alphaonex86/FPGA-CPU/timeline.jpg

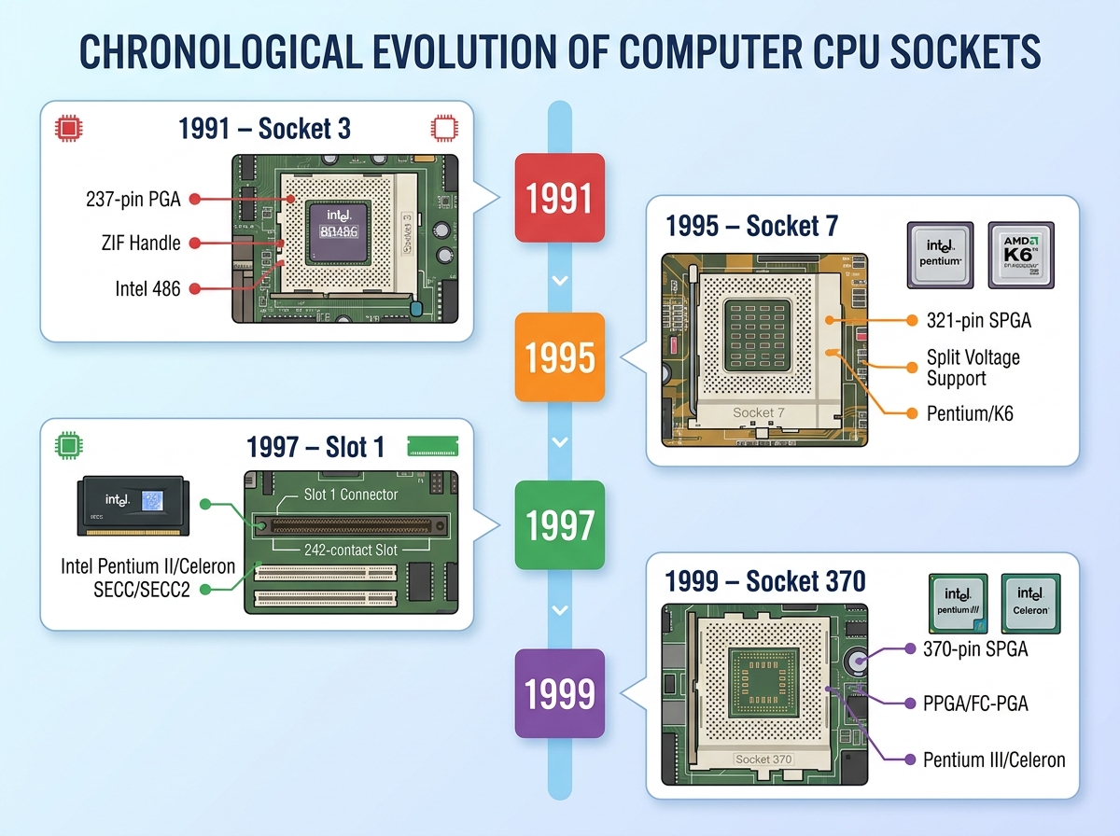
timeline.jpg
