alphaonex86/FPGA-CPU/sockets/socket370/board/board_photo.jpg

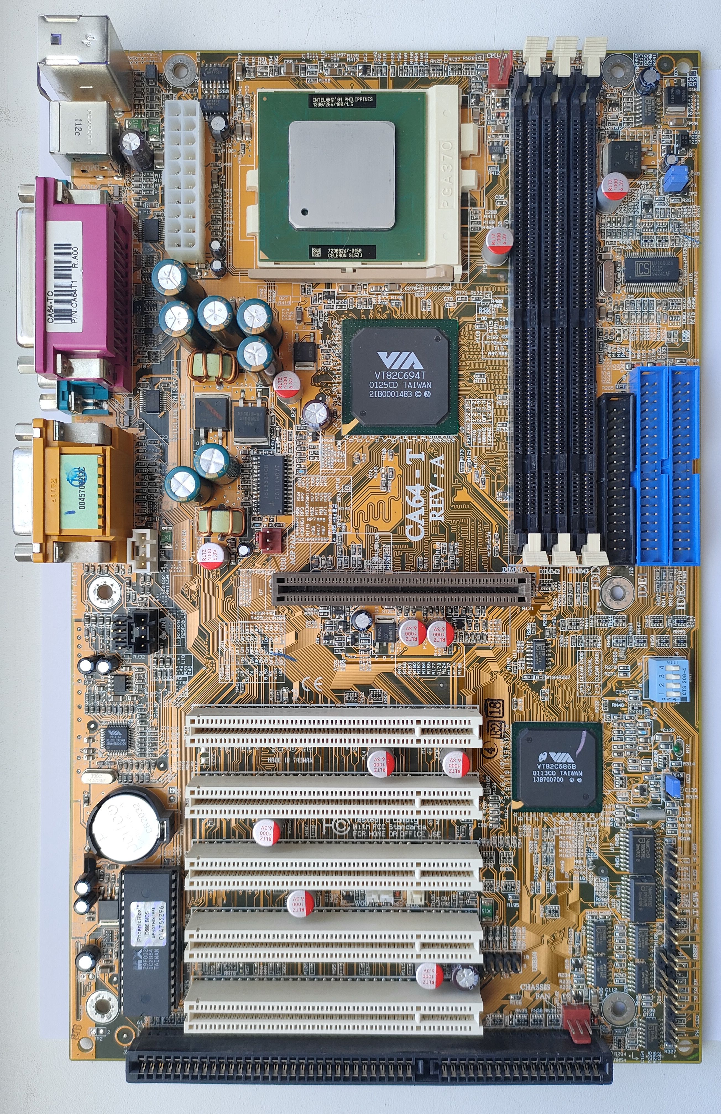
sockets/socket370/board/board_photo.jpg
