alphaonex86/FPGA-CPU/plan/cpu_core.md

# CPU core: base project evaluation (2026-10-31)

Idea (operator, 2026-10-31): do not write an x86 core from scratch; take an
open RISC-V core as the back end and make x86 (and RISC-V) "just a front
end" that cracks opcodes into the back end's micro-ops.

Requirements it must meet (`AGENTS.md`): >= 2 instructions per cycle,
i686 + x87 + MMX + SSE + SSE2, extensible to x86-64 then x86-64-v2, L2
>= 128 KB, per-socket bus behaviour, vendor-neutral RTL (ASIC option),
many configurations from one tree, fits Cyclone V E A9 (301k LE) (the
Ti180 is out: Efinix prohibited, `plan/interposers.md` D10) (`FPGAlist/README.md`).

## Candidates

All figures are the projects' own claims, not measured here.

| core | ISA / width | execution | perf claim | FPGA size claim | HDL, licence | fit |
|---|---|---|---|---|---|---|
| VexiiRiscv | RV32/64 IMAFDCSUB, MMU Sv32/Sv39 | in-order, single or dual issue (asymmetric lanes), BTB/GShare/RAS | 5.24 CoreMark/MHz, 2.50 DMIPS/MHz [vexii] | none published | SpinalHDL (Scala) -> Verilog, MIT [vexii] | best base, see below |
| NaxRiscv | RV32/64 IMAFDCSU, MMU | out-of-order, register renaming, e.g. 2 decode / 3 EU / 2 retire | 2.93 DMIPS/MHz, 5.02 CoreMark/MHz @ 155 MHz | 13.3 kLUT, Artix-7 -3 [nax] | SpinalHDL; licence not stated on the page | OoO upgrade path, same author and framework |
| SoomRV | RV32IMAC | 4-wide OoO | 5.42 CoreMark/MHz [soom] | none published | SystemVerilog, MIT | no RV64 datapath: blocks x86-64 |
| biRISC-V | RV32IM | in-order dual issue | 4.1 CoreMark/MHz, 1.9 DMIPS/MHz [biri] | "fits Artix-7, > 50 MHz" | Verilog | no FPU, no 64-bit: too small |
| ao486 | x86 486SX (no x87) | scalar, microcoded | Win95/Linux boot; fmax 39 MHz on Cyclone IV [ao486] | CPU 36,517 LE, SoC 91,256 LE (EP4CE115, `FPGAlist/README.md`) | Verilog | reference model for x86 semantics, not a base for 2 IPC |
| z386 | 80386 | rebuilt around Intel's recovered microcode | ~ao486 class [z386] | - | SystemVerilog | uses Intel's microcode: unusable for an ASIC / redistributed design |
| z486 (z386 successor, 2026-08) | 80486 + x87 (experimental, "sufficient to run DOS Quake"); no MMX/SSE | scalar pipelined: D1/D2 decode, hardwired common instructions, microsequencer for complex ones | Dhrystone CPI 2.8 -> 2.0 (IPC 0.36 -> 0.5); "roughly 486DX2-66-class"; Doom timedemo 29.1 FPS vs 21.0 ao486; 85 MHz on MiSTer [z486] | 16,329 ALMs, 21,906 with x87 (DE10-Nano Cyclone V) [z486] | SystemVerilog, Apache-2.0, except the "recovered microcode image" [z486 LICENSE-SCOPE.md] | best x86 reference; same microcode problem as z386 |
| BOOM, CVA6, XiangShan | RV64 | OoO / in-order | - | ASIC-oriented, no FPGA area claim found | Chisel / SV | too large or unmeasured for these parts |

Sources: [vexii] https://github.com/SpinalHDL/VexiiRiscv and
https://spinalhdl.github.io/VexiiRiscv-RTD/ ; [nax]
https://github.com/SpinalHDL/NaxRiscv ; [soom]
https://github.com/git-mathis/SoomRV ; [biri]
https://github.com/ultraembedded/biriscv ; [ao486]
https://github.com/alfikpl/ao486 , https://opencores.org/project/ao486 ;
[z486] https://github.com/nand2mario/z486 , https://github.com/nand2mario/z486_MiSTer
(read 2026-11-01) ;
[z386] https://linuxiac.com/open-source-z386-brings-intel-80386-microcode-back-to-life/ ,
https://misterfpga.org/viewtopic.php?p=107765 .
No published design does hardware x86 -> RISC-V micro-op cracking; the
nearest is an FPGA binary-translation research poster (HABITAT, St Andrews,
SICSA 2026), which is software-assisted translation, not a decoder.

## z486 vs the VexiiRiscv back end (operator question, 2026-11-01)

Other cores looked at and dropped: S80186 (80186, GPL-3.0, ~1,800 ALMs,
60 MHz on Cyclone V: 16-bit only) [https://github.com/jamieiles/80x86];
a 2-way out-of-order x86 soft processor at ~200 MHz (Stanford EE380 talk,
2019) [https://web.stanford.edu/class/ee380/Abstracts/190605-slides.pdf],
no public RTL found.

| | z486 | VexiiRiscv + own x86 front end (C1-C3) |
|---|---|---|
| runs x86 today | yes: DOS, Doom, Quake; real/protected mode, paging, segments | no: front end, flags, segments, x86 MMU, x87, system all to write |
| measured here, default recipe | 17,955 ALMs, 50.17 MHz; with x87 24,051 ALMs, 49.89 MHz | rv64imac dual: 12,932 ALMs, 60.7 MHz |
| measured here, perf recipe | 18,548 ALMs, 51.06 MHz | rv64imac dual: 14,976 ALMs, 61.19 MHz |
| work per second (fmax x IPC, perf) | 51 x 0.5 = ~26 M instr/s (x86) | 61 x 1.24 = ~76 M instr/s (RISC-V; x86 lower) |
| IPC | 0.5 (Dhrystone CPI 2.0) | 1.24 RISC-V; x86 IPC unknown until the cracker exists |
| >= 2 instructions/cycle | no: scalar, needs a U/V-pipe redesign of an x86-native pipeline | dual issue already there |
| x86-64 / SSE2 | none; 32-bit datapath | 64-bit datapath; SIMD lane still to add |
| licence / ASIC | RTL Apache-2.0 covers only *.sv/*.svh/*.py/*.md, so `ucode.hex` and the .hex/.mif decode ROMs are not covered [z486 LICENSE-SCOPE.md]; even the "hardwired" common instructions are Intel microcode recipes issued from ROM port B (`hardwired_control.sv`, after US5293592): blocks an ASIC and any redistributed board | MIT, all own code |
| x87 | experimental, incomplete | to write (80-bit unit) |

Reading: z486 is far ahead on x86 semantics and could boot the Socket 3
board soonest; it falls short on the hard requirements (>= 2 IPC, SSE2,
x86-64, an ASIC-clean licence) and its microcode would have to be
rewritten anyway, including the hardwired paths. Its test sets
(test386.py, single-step real/protected-mode datasets) and its .sv as a
behaviour reference are usable in either plan.

Measured 2026-11-01 on 5CEFA9F23C8 (C8, slowest grade), core alone, ports
virtual, slow 1100 mV 85 C model; `rtl/tools/synth_z486.sh <x87> <out>
[default|perf]`, `synth_cv.sh` for Vexii, z486 at 62ae68e. The z486_MiSTer
production recipe (`rtl/tools/quartus_perf.qsf`) adds only +1-2 % fmax on
both cores. The author's 85 MHz is on the DE10-Nano's 5CSEBA6U23I7
(grade 7); on our C8 part it gives 51 MHz, the speed grade being the likely
main cause (grade 7 not compiled here).

## Recommendation: VexiiRiscv as the back end (chosen, C0)

- Its pipeline is a set of plugins (fetch, decode, lanes, LSU, MMU, FPU),
  so an x86 decoder is "one more decode plugin" feeding the same lanes; a
  RISC-V decoder can stay as a second front end for bring-up (run the
  existing RISC-V tests and Linux first, then switch the front end).
- Dual issue in-order is the Pentium P5 model (U/V pipes), the simplest
  way to the operator's >= 2 instructions per cycle. NaxRiscv, same
  framework, is the OoO step if the FSB-bound workloads need it later.
- RV64 datapath already there: x86-64 long mode later is a decoder/MMU
  change, not a datapath rewrite.
- Generates plain Verilog: vendor-neutral, same tree for Cyclone V
  and an ASIC; every option is a Scala parameter, which matches "many
  configurations from one RTL tree".
- Cost: SpinalHDL/Scala knowledge and a JVM build (sbt or mill); the
  generated Verilog is not meant to be hand-edited.

## What the RISC-V back end does NOT give (x86 work list)

The "simple front end" is the decoder only for reg-reg ALU ops. The rest
is back-end work in Vexii plugins:

1. Decoder: 1-15 byte instructions with prefixes; 2 x86 instructions per
   cycle needs a predecoded length-marked I-cache line or a uop cache.
2. EFLAGS: RISC-V has no flags. Every ALU uop must produce CF/ZF/SF/OF/
   PF/AF (a flag lane or flags renamed with the result).
3. Partial registers and sizes: AL/AH/AX/EAX writes, 8/16/32(/64)-bit
   operand and address sizes, segment base added in the AGU, limits and
   checks in protected mode, real mode, V86, A20.
4. Load-op-store instructions cracked into 2-3 uops that commit or fault
   as one x86 instruction (precise exceptions at instruction boundaries),
   REP string ops, PUSH/POP/CALL/RET with ESP updates.
5. x87: 80-bit extended precision, register stack, tag word, exceptions.
   The RISC-V D unit is 64-bit: x87 needs its own unit (or a microcoded
   extended-precision path). MMX aliases the x87 registers.
6. SSE/SSE2: 128-bit XMM registers and 8x16/4x32/2x64 SIMD + scalar
   double; Vexii has no SIMD unit: new lane.
7. MMU: x86 two-level 32-bit paging (later PAE / 4-level), TLB with x86
   permission bits, accessed/dirty updates by the walker; Sv32/Sv39 walker
   is a template only.
8. Memory model: x86 TSO vs RISC-V RVWMO; self-modifying code needs a
   coherent I-cache (snoop on stores), no fence.i.
9. System: IDT, exceptions, task gates, SMM, I/O ports, CPUID, MSRs, TSC,
   reset signature, cache-control pins; micro-code sequencer for the
   complex instructions.
10. Bus: Vexii talks AXI4/TileLink/Wishbone; each socket needs its own
    bus unit (486, P5, P6 AGTL+) behind the L2.

ao486 (Bochs-modelled) is the reference for items 3, 4, 9 and for the
test approach (lock-step against an emulator, the way Vexii already
lock-steps against Spike).

## FPGAmotherboard compatibility (operator, 2026-11-01)

The core must run on the original boards and on the FPGAmotherboard boards
(FPGA chipset, other session; its rule 9: any fast mode is negotiated, off
by default). Contract received for Socket 3 (FPGAmotherboard
socket3/docs/notes/design-decisions.md):
- the board targets the Am5x86-P75 only [am5x86 19751C]: B13 = WB/WT#,
  CLKMUL (R17) tied low; the CPUID/reset-signature profile must offer it;
- bus CLK 8-33 MHz, changed only during Stop Grant (STPCLK#) for DVFS:
  the bus PLL must relock inside Stop Grant and the core must not assume
  a fixed bus clock;
- direct LVCMOS33, VIH 2.0 V / VOH 2.4 V min;
- VCORE starts at 0 V and comes up after the interposer FPGA: the bus
  interface ignores every socket pin and keeps the CPU parked until the
  board input VCORE_OK is high, and parks again when it falls
  (plan/interposers.md FPGAmotherboard compatibility).

## Selection criterion (operator, 2026-11-01, permanent)

Maximum performance inside the selected Cyclone V E A9 (113,560 ALMs); code
volume, rewrites and licences do not count (`AGENTS.md` Rules). Decisions
taken partly on the dropped criteria, to re-check on performance alone:
- C0: z486 was rejected also for its licence; its performance gaps (scalar,
  IPC 0.5, 51 MHz on C8, 32-bit, no SSE) still stand.
- C1 amendment (hybrid uop): chosen to reuse Vexii plugins, i.e. less code.
- Vexii itself: in-order dual issue, ~60 MHz on C8 is its pipeline depth
  (step 1 sweep); a core designed for Cyclone V timing may go higher.
- C5: the DE25-Nano's Agilex 5 has 46,800 ALMs, under the A9's 113,560:
  it hosts development of what fits, the full core is sized for the A9.

## Decisions (core)

- **C7** (decided 2026-11-01 by the operator) The x86 core is written in
  SystemVerilog (Quartus Lite/Pro and Verilator read it directly, no JVM,
  ASIC-neutral; configurations as parameters / generate).
- **C8** (decided 2026-11-01 by the operator) Microarchitecture class:
  out-of-order, 2-3 uops per cycle (P6/K7 style: x86 decoders to uops,
  uop cache, renaming including EFLAGS, ROB, load/store queues). Spec in
  `plan/x86_core.md`.
- **C6** (decided 2026-11-01 by the operator, under the performance
  criterion) The x86 core is a new x86-native superscalar design built for
  Cyclone V timing (more stages, uop cache, out-of-order as the design
  decides), from scratch. VexiiRiscv stays only as the separate RISC-V core
  (C4). Supersedes for x86: C0's base, the C1 hybrid uop and the
  Vexii-specific parts of C2 (EFLAGS stays in hardware) and X1. Kept from
  X1: Unicorn lock-step (`x86_trace_check`, `x86_test.sh`, tests).
- **C0** (decided 2026-11-01 by the operator, after the measured z486
  comparison above) Base: VexiiRiscv back end + own x86 front end (C1-C3).
  z486 is used only as a behaviour reference and test source (test386,
  single-step datasets), never as RTL in the tree.
- **C1** (decided 2026-11-01 by the operator) x86 instructions crack into
  an own micro-op format, not into RISC-V instruction words: the x86 front
  end bypasses the Vexii RISC-V decoder (wide uops, 32/64-bit immediates)
  and feeds the execute lanes directly.
  **Amended 2026-11-01 by the operator (hybrid):** Vexii's execute
  plugins decode their controls by mask-matching the UOP bits
  (`ExecuteLanePlugin.scala` 267-290, `DecoderPlugin.scala` 274-278), so
  the uop keeps a 32-bit RISC-V-shaped operation key (every Vexii execute
  plugin reused unchanged; the RISC-V front end of C4 comes for free) and
  the x86 fields ride beside it through `DispatchPlugin.addDispatchCtx`:
  64-bit immediate, operand size 8/16/32/64, flag-write mask, segment.
- **C2** (decided 2026-11-01 by the operator) EFLAGS in hardware: every
  flag-setting uop writes a flags register beside its result (new execute
  plugin, bypass between the two lanes); Jcc / ADC / SETcc read it in one
  cycle.
  **Confirmed 2026-11-01 by the operator (directly, no interim x31 uop):**
  Vexii uops have one RD and the dispatcher tracks hazards only on
  RS1-3/RD, so the unit brings its own FLAGS register, forwarding from
  every in-flight stage, and a dispatcher patch so a flag consumer never
  issues in the same cycle as an older flag producer.
- **C3** (decided 2026-11-01 by the operator) Lock-step reference: Unicorn
  (QEMU CPU core as a C library, one hook per instruction), testbench only
  (GPLv2, never in the RTL).
- **C4** (decided 2026-11-01 by the operator) x86 first, but the RISC-V
  front end stays selectable at generation time (a config option, its code
  never deleted) for later experiments: e.g. RISC-V Linux with own firmware
  in the interposer (board BIOS never run; Debian riscv64 is RV64GC; device
  tree + i8259, 8250, i8042, IDE, CF8/CFC PCI drivers, x86 option ROMs via
  an emulator like U-Boot bios_emulator). Not a milestone now.

- **C5** (decided 2026-11-01 by the operator) x86 front-end development
  runs on the DE25-Nano first (Agilex 5, 163 MHz vs 61 MHz, no PCB
  needed); the RTL stays vendor-neutral so it still builds for the
  Cyclone V interposers.

## Exploration E1: x86 on a real ARM64 core, FPGA as the socket bridge (operator, 2026-11-01)

Idea (operator): a multiplexer <-> FPGA converting x86 <-> real ARM64 on a
Terasic DE25-Nano, for good x86 performance: the x86 side runs single
threaded, natively on one ARM core. Not a decision, to explore.

Board facts (Terasic / distributors): Agilex 5 SoC A5EB013BB23BE4SCS
(DE25-Nano revB `Demonstration/FPGA/Golden_top/golden_top.qsf`), 138K LE; HPS 2x Cortex-A76 + 2x Cortex-A55; 1 GB
LPDDR4 for the FPGA + 1 GB LPDDR4 for the HPS (shared with the FPGA),
128 MB SDRAM; BSP on Quartus 25.1.1 Pro; the kit includes a free Quartus
Pro licence tied to the kit [terasic.com.tw DE25-Nano page; DE25-Nano
user manual 2025-09-05, mm.digikey.com/.../P0804.pdf;
linuxgizmos.com DE25-Nano article].

Shape: the FPGA fabric is the socket bus unit (486 / P5 / P6 cycles, as in
the soft-core plan); one A76 runs the x86 machine. A hard ARM core has no
port to inject instructions, so x86 -> ARM64 has to be software dynamic
binary translation on the A76 (full system: BIOS, real/protected mode,
paging, interrupts, I/O), the FPGA at most assisting (e.g. bus cycles,
predecode). Box64 / FEX translate Linux user space only; a full-system
translator is QEMU-TCG class.

Questions before any work:
1. Toolchain rule: Agilex 5 needs Quartus Prime Pro.
   **Answered 2026-11-01:** Quartus Prime Pro 26.1.1 Build 130 installed at
   `~/altera_pro/26.1.1` (installers, Agilex 3/5/7 device .qdz, DE25-Nano
   revA/revB resource packages, user manual and SD card image in
   `/mnt/data/perso/FPGA/DE25-Nano/`). A counter on A5EB013BB23BE4SCS with
   the golden_top pins (clk BF23, LEDs) ran synthesis, fit, timing and
   assembler and wrote the .sof (without pin assignments the assembler
   skips it, Critical Warning 25196/25207). Licence: `LICENSE_FREE_MODE = on`
   (`~/.altera.quartus/quartus2.ini`); Quartus fetches a free node-locked
   licence online into `~/.altera.quartus/quartus2_lic.dat` (issued
   2026-10-31): `quartus_agilex5e` 2027.10 and `quartus_agilex3` 2027.11,
   both "permanent uncounted". The Agilex 3 feature was added during an
   A3CW135BM16AE6S test compile (2026-11-01), so the fetch works from
   Bolivia; once fetched it is permanent, the version date only caps the
   Quartus release. The kit licence is not needed. This weakens the Agilex 3
   rejection in `FPGAlist/README.md` ("licence fetched online").
2. Speed: x86 full-system DBT on one A76 (clock to check) vs the 50-60 MHz
   soft cores measured above; measure QEMU-TCG i386 on an A76 first.
3. Memory: guest RAM in the HPS LPDDR4 (fast) with the board RAM only for
   DMA-visible ranges, or all accesses over HPS -> FPGA -> socket (bridge
   latency per access); board DMA (IDE busmaster, ISA DMA) coherence.
4. Form factor and power: DE25-Nano by a cable/adapter to the socket
   (bus timing at 33-66 MHz over a cable) or the Agilex 5 chip on our own
   interposer; power vs the socket budgets in `AGENTS.md`.

Fabric speed (2026-11-01): the rv64imac_dual netlist of step 1, same
virtual-pin setup, Quartus Pro 26.1.1 on A5EB013BB23BE4SCS, 5 ns target
(`DEVICE=A5EB013BB23BE4SCS rtl/tools/synth_cv.sh <v> <out> 5.0`):
13,568 / 46,800 ALMs (29 %), 94 / 358 M20K, 8 DSP, fmax 162.87 MHz (worst
multicorner, slow fix4 0C model), vs 61 MHz / 11 % on 5CEFA9F23C8: 2.7x
the clock, but 2.6x less room for x86 + x87 + SSE + L2 (7.3 Mbit RAM: a
128 KB L2 still fits).

### E1 connection: DE25-Nano + multiplexer adapter (operator, 2026-11-01)

The DE25-Nano exposes 72 user I/O at 3.3 V on two 2x20 headers (36 + 5 V,
3.3 V, 2 GND each; 3.3 V max 1.5 A) [DE25-Nano user manual 2025-09-05
p.22 sec. 3.7.2, Tables 3-11/3-12]; the sockets need 114 (S3), 166 (S7),
167 (S370) FPGA signals (`hw/*/pins.csv`). Pin count, not speed, is the
limit, so the adapter multiplexes. Line rate = mux ratio x bus clock:

| socket | bus | wide signals per clock | ratio on ~24-40 lines | rate per line | verdict |
|---|---|---|---|---|---|
| S3 | 33 MHz | A30 + BE4 + D32 + DP4 = 70 | 3:1 | 100 MHz | feasible |
| S7 | 66 MHz | ~110 | 3:1 | 200 MHz | doubtful on 0.1" headers with 2 GND / 40 pins |
| S370 | 133 MHz | ~110 | >= 2:1 (8:1 = 1064 MHz) | >= 266 MHz | no; AGTL+ also needs GTL parts |

Shape (S3): wide outputs go through two register stages: the FPGA fills
stage 1 group by group during cycle N-1, stage 2 is clocked by the board
CLK, so outputs switch with one flop delay, inside t6 3-14 ns at 33 MHz
[intel486dx2_datasheet_1992.pdf Table 14.4.2]. Wide inputs are captured
by registers on the board CLK (meets the t22 5 ns setup / t23 3 ns hold
like the CPU does) and read out over the next cycle. Cost: inputs reach
the core one clock late, so signals that need a next-clock reaction
(AHOLD/BOFF#/HOLD float, RDY/BRDY, KEN#, EADS#) stay direct; slow ones
(straps, A20M#, FLUSH#, IGNNE#, INTR, NMI, SMI#, STPCLK#) go through the
mux. Budget: ~24 direct + 24 mux lines + ~8 group strobes + ~16 slow
control = ~72: tight, a 4:1 ratio (133 MHz) frees pins. Parts: 5 V
tolerant 74LVC 16-bit registers / buffers, no FPGA, 3.3 V from the
header; the 3.3 V output level matches the S3 interposer's (CB3T) level.

DE25-Standard (operator question, 2026-11-01; user manual 2025-10-07,
mm.digikey.com/Volume0/opasdata/d220001/medias/docus/7704/P0781.pdf):
same class FPGA (A5ED013BB32AE4SR1, 130K LE [p.7]), $586, 12 V input.
I/O: HSMC with 80 user I/O (HSMC_D[0..74], 2 x B5B_D, 3 CLKIN) at
1.8/2.5/3.3 V by jumper JP3, default 3.3 V [p.19 Table 3-5, Table 3-18],
on a connector built for high-speed signals, plus one 2x20 GPIO header,
36 I/O at 3.3 V behind two diodes + a resistor each [p.30]: 116 in all.
- S3 (114): nearly direct, no mux; DE25-Nano + mux (D11) is enough.
- S7 (166): only the 64+8 data/parity lines 2:1 on 36 HSMC lines
  (133 MHz per line, on HSMC), the rest direct or slow-muxed: plausible,
  tight; the one socket the Standard makes possible.
- S370 (167, AGTL+ 133 MHz): even 2:1 is 266 MHz per single-ended line;
  only the 17 LVDS pairs per direction could carry it, which needs a
  SERDES (an FPGA) on the adapter: no DE25 for S370, the interposer only.

## Next steps (each answers a concrete question)

1. Generate VexiiRiscv dual-issue RV64 (no FPU, then with D) and run
   Quartus Lite 25.1 (installed, `~/altera_lite/25.1std`) on 5CEFA9F23C8:
   ALMs, fmax. Does the back end leave room for x86 decode + x87 + SSE +
   L2 >= 128 KB inside 301k LE, and at what clock?
   **Done 2026-11-01** (`rtl/tools/setup.sh`, `gen_vexii.sh <config>`,
   `synth_cv.sh`; VexiiRiscv 9f70315, core alone, ports virtual, 10 ns
   target, slow 1100 mV 85 C model):

   | config | ALMs | registers | M10K | DSP | fmax |
   |---|---|---|---|---|---|
   | rv64imac_dual (S/U + MMU, max-ipc, 16 KB L1 I/D) | 12,932 (11 %) | 16,360 | 105 | 17 | 60.7 MHz |
   | rv64imafdc_dual (same + F/D) | 16,879 (15 %) | 19,848 | 115 | 17 | 52.0 MHz |

   Room: yes, ~85 % of the ALMs and > 90 % of the M10K are left; a 128 KB
   L2 is 1 Mbit of the 12.5 Mbit. Clock: 50-60 MHz as generated, already
   above every Socket 3 bus clock (<= 40 MHz) but below Socket 7/370.
   Critical paths: the max-ipc lane1 -> lane0 early-ALU bypass (rv64imac)
   and the execute -> fetch TLB write (rv64imafdc), both inside the back
   end.

   fmax vs IPC sweep (2026-11-01, `rtl/tools/vexii_configs.sh`,
   `bench_vexii.sh`: prebuilt NaxSoftware Dhrystone / CoreMark in the
   VexiiRiscv Verilator testbench, default testbench memory; both fit the
   16 KB L1, so this is core IPC, not system IPC). CoreMark = CoreMark/MHz
   x fmax:

   | config | ALMs | fmax | DMIPS/MHz | CoreMark/MHz | IPC (CoreMark) | CoreMark |
   |---|---|---|---|---|---|---|
   | rv64imac_dual (max-ipc) | 12,932 | 60.7 | 2.61 | 4.84 | 1.24 | 294 |
   | rv64imac_dual_rbra (+ relaxed branch) | 12,839 | 60.6 | 2.59 | 4.72 | 1.21 | 286 |
   | rv64imac_dual_nolate (- late ALU) | 11,249 | 59.4 | 2.35 | 4.41 | 1.13 | 262 |
   | rv64imafdc_dual (+ F/D) | 16,879 | 52.0 | 2.60 | 4.84 | 1.24 | 252 |
   | rv64imac_single (max-ipc, 1 lane) | 9,524 | 65.0 | 1.78 | 3.33 | 0.85 | 216 |
   | rv64imac_dual_nolate_bp1 (- late ALU, bypass from 1) | 11,035 | 59.1 | 1.49 | 2.81 | 0.72 | 166 |

   Answer: the full max-ipc dual-issue core is the best; the lighter
   bypass, no late ALU and the relaxed branch cost IPC and buy no fmax.
   Each removal only moves the worst path (execute branch -> fetch L1 /
   TLB RAM address, then late-ALU 64-bit bypass, register file, dispatch):
   about 60 MHz is the depth of this pipeline at 64 bits on C8, not one
   path. More clock needs more stages (decoder/dispatcher/fetch fork
   placement), a later question. The F/D unit costs 14 % clock: keep the
   FPU off the integer critical loop when x87/SSE are added.
2. ~~Same netlist in Efinity for the Ti180~~: dropped, Efinix is
   prohibited (`plan/interposers.md` D10).
3. Only then: an x86 decode plugin for the integer reg-reg / load-op
   subset, lock-stepped against an emulator, on the RISC-V back end.
   Increment X1 (superseded by C6, kept for the record; C0, C1 hybrid, C2, C3, C5): does the hybrid
   uop run x86 code on the Vexii lanes, and at what IPC? 32-bit flat
   mode only (segment bases 0, no paging, no faults), in Verilator:
   - `X86AlignerPlugin` (replaces AlignerPlugin): byte-granular length
     decode over the fetch window, 1 x86 instruction per cycle first.
   - `X86DecoderPlugin`: cracks into hybrid uops; EAX..EDI on x1..x8,
     temporaries above; side payloads X86_IMM, X86_SIZE, X86_FLAGS.
   - `X86FlagsPlugin` (C2): CF/PF/AF/ZF/SF/OF beside each ALU result,
     read by Jcc.
   - Subset: MOV (r/r, r/imm, r/[base+index*scale+disp] both ways), ADD,
     SUB, AND, OR, XOR, CMP, TEST (r/r, r/imm8/imm32), INC, DEC, LEA,
     Jcc / JMP rel8/rel32, NOP, HLT (ends the test).
   - Testbench: Unicorn 2.1.4 (`rtl/tools/setup.sh`) steps the same
     image; GPRs, EFLAGS and EIP compared at every retired x86
     instruction; first mismatch stops the run.
   Answers: correctness on the subset, IPC on a Dhrystone-like loop, and
   the ALM / fmax cost on A5EB013BB23BE4SCS vs rv64imac_dual.
