alphaonex86/FPGA-CPU/hw/socket7-cyclonev/power.md

# Socket 7 + Cyclone V E A9 (5CEBA9/5CEFA9F23C8N) interposer power (plan/interposers.md task T3)

Source per D1 (decided 2026-10-21 for socket 7, `plan/interposers.md`):
the interposer takes its power from the socket's own rails through the
Mill-Max header - VCC2 (core, 2.8 V on this board [spec p.5]) and VCC3
(I/O, 3.4 V on this board [spec p.5]). No external supply, no barrel jack.
No module RAM (D4). Page numbers are the printed pages of the cited PDFs.

Socket-side envelope ([notes] R2): VCC2 2.7/2.8/2.9 V +/-3.57 % on 25 pins,
VCC3 3.135-3.6 V on 28 pins, ICC2 max 6.5 A, ICC3 max 750 mA, active max
17.0 W [mmx p.31-32 Tables 10/12/13]. No VCC2/VCC3 sequencing: "no specific
power sequence required", both ON or both OFF within one second
recommended [mmx p.28 sec. 3.1.1.1]. Our loads are attached to rails the
board VRM raises together, so this holds by construction. All converter
outputs are strictly monotonic ramps (see Sequencing).

Sources:

| tag | file |
|---|---|
| cvds | FPGAlist/CycloneV_A9/docs/cv_51002_device_datasheet.pdf |
| cvhb | FPGAlist/CycloneV_A9/docs/cv_5v2_device_handbook_vol1.pdf |
| mmx | sockets/socket7/pentium_mmx_datasheet_243185-004.pdf |
| fmb | sockets/socket7/intel_430hx_pcsiset_design_guide_297467-002.pdf |
| spec | sockets/socket7/board/biostar_mb-8500ttd_spec.pdf |
| jumpers | sockets/socket7/board/biostar_mb-8500ttd_undocumented_jumpers.pdf |
| mmpins | sockets/parts/mill-max_catalog_metric.pdf |
| notes | hw/common/socket7_notes.md |
| tlv62585 | sockets/parts/ti_tlv62585.pdf |
| tps22918 | sockets/parts/ti_tps22918.pdf |
| tlv757p | sockets/parts/ti_tlv757p.pdf |
| plan | plan/interposers.md |
| agents | AGENTS.md |

## Rails (Cyclone V E A9, 5CEBA9/5CEFA9F23C8N)

| rail | where | required band | source |
|---|---|---|---|
| VCC | FPGA core, periphery | 1.07-1.13 V (typ 1.1 V) | cvds p.8 Table 4 |
| VCC_AUX (VCCAUX) | auxiliary supply | 2.375-2.625 V (typ 2.5 V) | cvds p.8 Table 4 |
| VCCPD | I/O pre-driver | 3.3 V: every used bank is a 3.3 V VCCIO bank ([notes] R1, no 2.5 V net on this socket) | cvds p.8 Table 4 note 4 |
| VCCIO | per bank | 3.3 V (3.135-3.465 V), all banks: host bus and straps are 3.3 V TTL [notes R1] | cvds p.8-9 Table 4 |
| VCCPGM | configuration pins | 3.3 V class | cvds p.9 Table 4 |
| VCCA_FPLL | PLL analog regulator supply | 2.375-2.625 V | cvds p.9 Table 4 |
| VCCBAT | battery back-up (volatile security key) | 1.2-3.0 V | cvds p.9 Table 4 |
| tRAMP | all supplies strictly monotonic, no plateaus | 200 us-100 ms (standard POR) | cvds p.9 Table 4 / p.69 Table 55 |

## Topology

```
VCC2 2.8 V (25 header pins) --[bulk+bulk]--> SYNC BUCK --> VCC 1.1 V
VCC3 3.4 V board (28 header pins) --+--> LOAD SWITCH (EN = core PGOOD)
                                    |      --> VCCIO33: VCCIO / VCCPD / VCCPGM
                                    +--> 2.5 V aux (VCCAUX; ferrite
                                             branch to VCCA_FPLL;
                                             VCCBAT tied here)
```

Rail plan (drawn by `hw/tools/socket7_pdn.py`, values printed and checked
there; all JLCPCB/LCSC stocked 2026-11-05):
- VCC2 -> PS1 TLV62585PDRL (C485118) core buck, 1.1 V 3 A: VIN 2.5-5.5 V
  covers the 2.70-2.90 V window [tlv62585 p.1] (a 3 V-min part such as
  the TPS62130 does not qualify); R1 82.5k / R2 100k -> 1.095 V (1.084-
  1.106 V over the FB tolerance, p.6); 1 uH XFL4020-102MEC (C5355380) +
  22 uF; the whole VCC_1V1 rail stays <= 47 uF nominal [p.10 Table 4].
  EN tied to S_VCC2.
- VCC3 -> PS2 TLV75725PDBVR (C2872563) 2.5 V aux LDO, 1 A: dropout 0.6 V
  max at 1 A [tlv757p p.6] < 3.135 - 2.5 V; EN = PG_1V1.
- VCC3 -> U3 TPS22918DBVR (C131941) load switch -> VCCIO33 (VCCIO/VCCPD/
  VCCPGM): 53 mOhm at 3.3 V, 2 A [tps22918 p.1]; the board's 3.4 V is
  inside the 3.465 V band max [cvds p.8-9 Table 4]. CT 1 nF -> rise
  1.68 ms [p.6], inside 200 us-100 ms [cvds p.9 Table 4]; QOD tied to
  VOUT (discharge when off); ON = PG_1V1.
- PG_1V1 (TLV62585 PG, open drain) pulled up to VCC_1V1, not S_VCC3: the
  board raises VCC3 before VCC2 and PG is undriven below 1.4 V VIN
  [tlv62585 p.8 Table 1]; it releases at 95 % (1.045 V) above the 1 V
  VIH of the switch ON and the LDO EN [tps22918 p.4, tlv757p p.6].
- VCCBAT: tied to the 2.5 V aux rail (1.2-3.0 V band) [cvds p.9 Table 4].

## Sequencing

- All supplies strictly monotonic 200 us-100 ms [cvds p.9 Table 4].
  Recommended order [cvhb p.10-4 Fig 10-3]: group 1 (VCC 1.1 V) to
  >= 80 % before group 2 (VCCPGM, VCCIO, VCCPD, VCCA_FPLL, VCC_AUX),
  VCCIO together with VCCPD. The core buck's PG enables the 2.5 V
  aux LDO (VCC_AUX, VCCA_FPLL) and the VCCIO33 switch together.
- The board's VCC3 rises together with VCC2 [mmx p.28], i.e. before the
  core buck fed from VCC2 is up; a direct VCCIO/VCCPD/VCCPGM feed would
  break the order and cost a VCCPD current transient up to 1000 mA, ~50 us
  typical [cvhb p.10-4/10-5 Table 10-1 note 33] on a VCC3 rated ICC3
  750 mA [mmx p.31 Table 12]. Hence the load switch (operator,
  2026-11-01): the same core PGOOD enables it and the aux LDO, so all of
  group 2 starts together; VCCIO and VCCPD share VCCIO33, so they ramp
  together [cvhb Table 10-1 note 35].
- Until the switch closes, the board drives the 3.3 V bus into unpowered
  banks (direct bus, no translators): allowed, the I/O, dedicated input
  and clock pins take signals before or during power up without damage or
  back-powering [cvhb p.10-2], at most 300 uA DC / 8 mA AC per pin
  [cvds p.17 Table 13]. CONF_DONE and nSTATUS have no hot-socket circuit
  and may drive during power up [cvhb p.10-3]: they only reach our
  pull-ups and the config header.
- POR after all supplies are valid: 100-300 ms (standard POR) before
  configuration is accepted [cvds p.69 Table 55]; nSTATUS/CONF_DONE and
  the board-reset stretch handle the handshake with CPURST ([notes] R6).

## Budget check (D1: total within the socket budget)

Numbers below are an **estimate** until the vendor power estimator runs on
real RTL (replaces this section then); this design uses no DDR PHY, no
transceivers and no HSIO/MIPI, so the class is "fabric + light I/O".

- Total interposer draw (estimate): core rail 2.5 W + I/O and aux
  2.0 W + converters at ~90 % efficiency => <= 6 W against the
  17.0 W the board VRM was built for [mmx p.32 Table 13; agents]. PASS.
- VCC2 branch (feeds only the 1.1 core buck): 1.0 A at
  2.8 V against ICC2 6.5 A [mmx p.31 Table 12]; 0.04 A average per
  VCC2 pin against the 1 A Mill-Max 550 rating [mmpins p.188-189]. PASS.
- VCC3 branch: VCCIO/VCCPD/VCCPGM through the load switch + the aux LDO:
  0.6 A estimate against ICC3 750 mA [mmx p.31 Table 12] - the
  binding limit of the three. PASS if the estimator confirms; if it comes
  back over, the VCCIO dynamic estimate must be refined per-bank before
  any rail re-planning.
- Board VCC3 sits at 3.4 V [spec p.5]: inside the 3.3 V band max 3.465 V
  of both FPGAs (cvds p.8-9 Table 4) and inside VCC3 max 3.6 V [mmx p.31
  Table 10]. PASS.
- FMB rule "HCLK begins toggling within 150 ms after VCC reaches its
  operating level" [fmb p.2-2] is about the CPU seeing the clock: the
  board clock runs from power-on independent of our rails, and our
  converters start as soon as VCC2/VCC3 come up, so the FPGA is powered
  long before the board releases CPURST; the config-vs-reset timing is
  closed in [notes] R6.
