alphaonex86/FPGA-CPU/sockets/socket7/board/cpuinfo_pentium_mmx_233.txt

p1mmx ~ # cat /proc/cpuinfo 
processor       : 0
vendor_id       : GenuineIntel
cpu family      : 5
model           : 4
model name      : Pentium MMX
stepping        : 3
cpu MHz         : 233.034
fdiv_bug        : no
f00f_bug        : yes
coma_bug        : no
fpu             : yes
fpu_exception   : yes
cpuid level     : 1
wp              : yes
flags           : fpu vme de pse tsc msr mce cx8 mmx cpuid
bugs            : f00f itlb_multihit
bogomips        : 466.06
clflush size    : 32
cache_alignment : 32
address sizes   : 32 bits physical, 32 bits virtual
power management:
