alphaonex86/FPGA-CPU/sockets/socket3/board/mb-8433uud-a_rev3.1_front.jpg

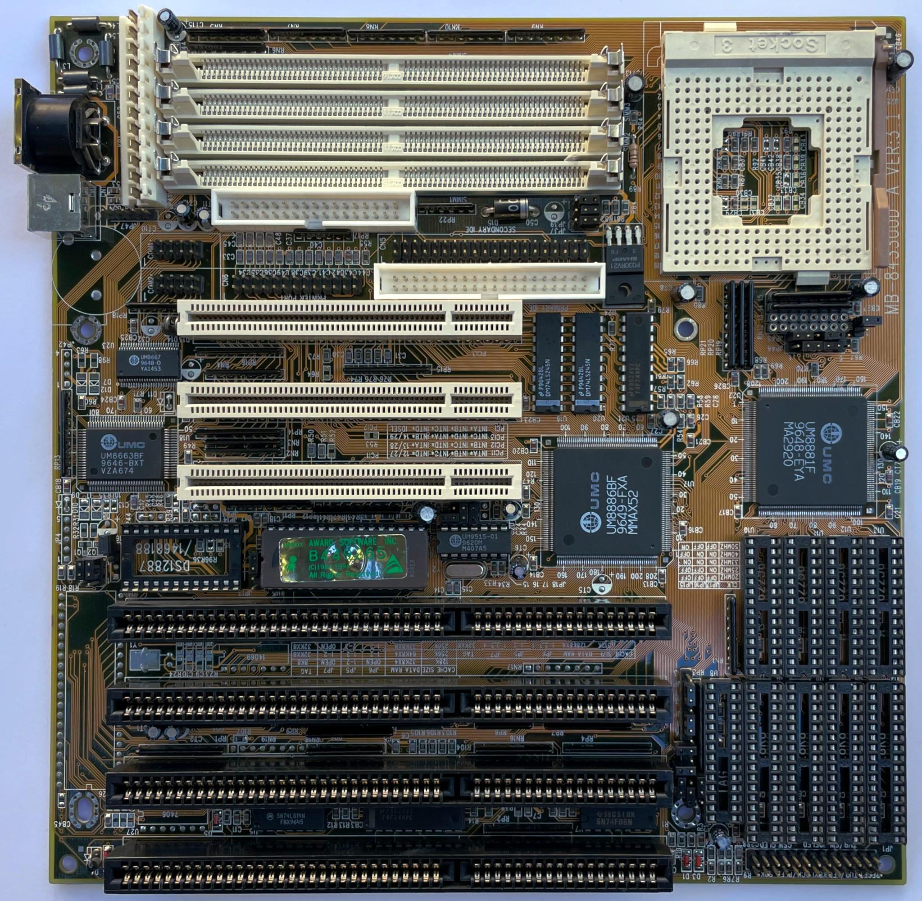
sockets/socket3/board/mb-8433uud-a_rev3.1_front.jpg
