alphaonex86/FPGA-CPU/sockets/socket3/socket3_pinout_bottom.jpg

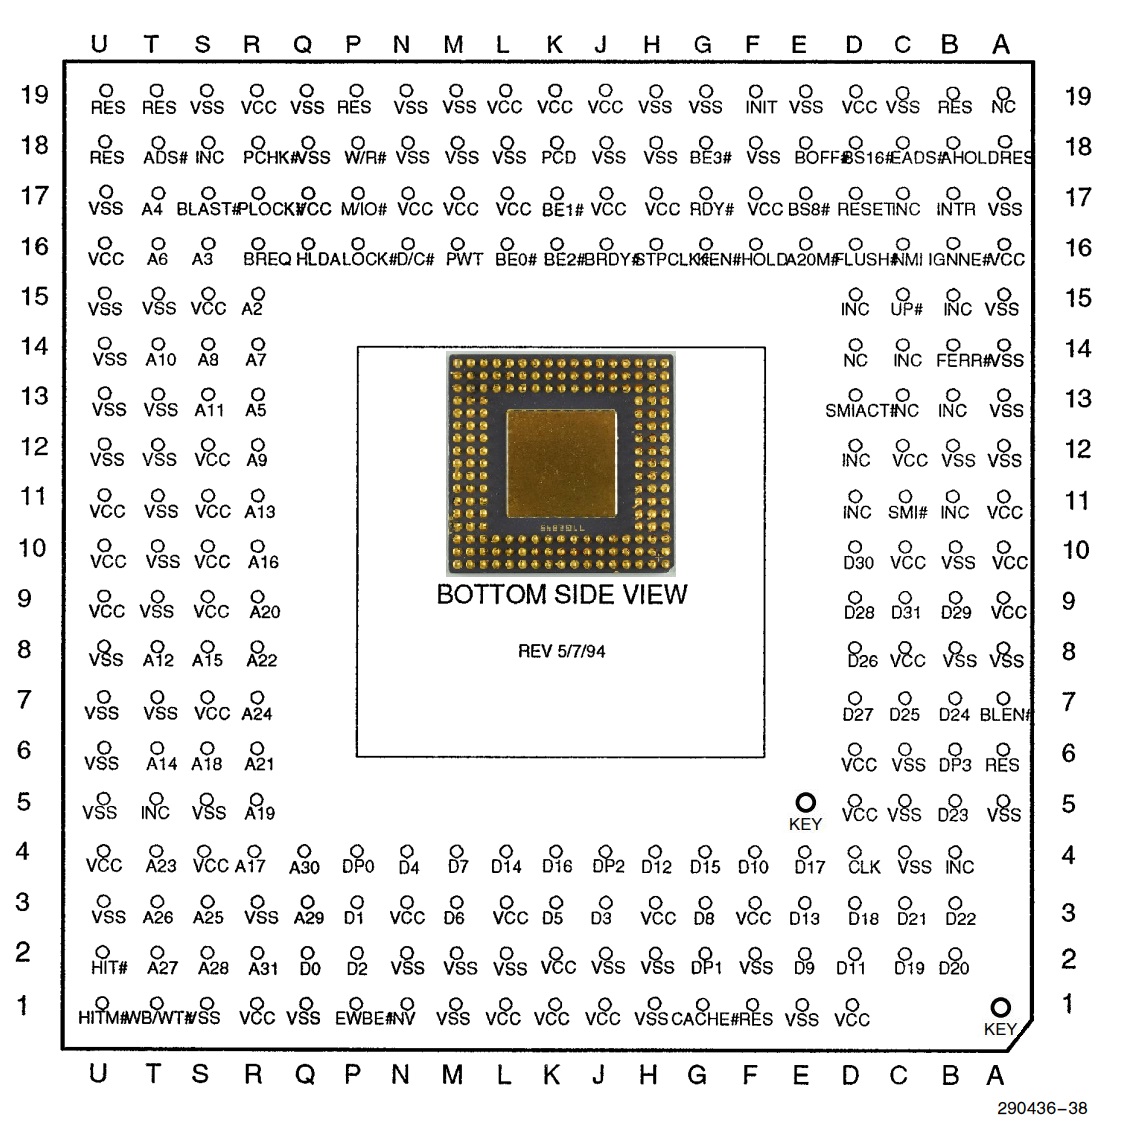
sockets/socket3/socket3_pinout_bottom.jpg
