alphaonex86/FPGA-CPU/sockets/socket7/board/mb-8500ttd_photo.jpg

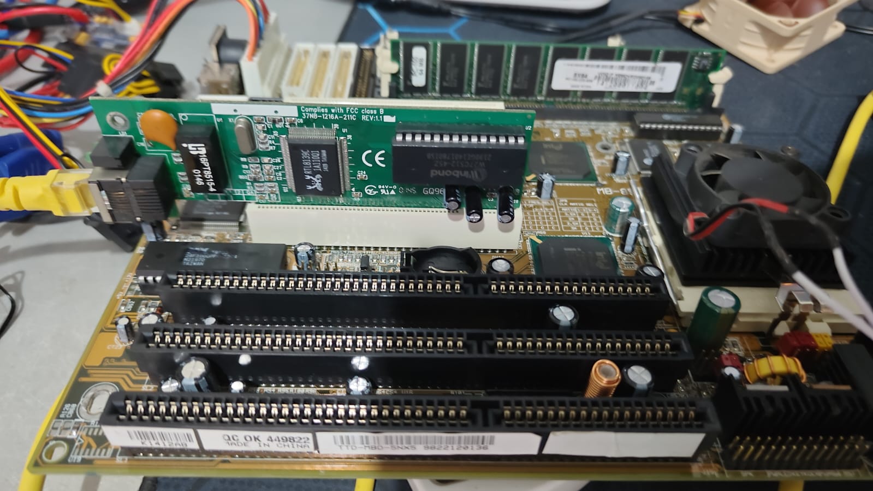
sockets/socket7/board/mb-8500ttd_photo.jpg
