alphaonex86/FPGA-CPU/hw/slot1-cyclonev/slot1-cyclonev.bom.csv

Refs | Value | Footprint | Qty | DNP
C1 | 10uF/25V | Capacitor_SMD:C_1210_3225Metric | 1
C2 | 4.7uF/25V | Capacitor_SMD:C_0805_2012Metric | 1
C3 | 22uF/10V | Capacitor_SMD:C_1206_3216Metric | 1
C4 | 22uF/10V | Capacitor_SMD:C_1206_3216Metric | 1
C5 | 100nF | Capacitor_SMD:C_0402_1005Metric | 1
C6 | 10nF | Capacitor_SMD:C_0402_1005Metric | 1
C7 | 27nF | Capacitor_SMD:C_0402_1005Metric | 1
C8 | 10uF/25V | Capacitor_SMD:C_1210_3225Metric | 1
C9 | 4.7uF/25V | Capacitor_SMD:C_0805_2012Metric | 1
C10 | 47uF/6.3V | Capacitor_SMD:C_1206_3216Metric | 1
C11 | 47uF/6.3V | Capacitor_SMD:C_1206_3216Metric | 1
C12 | 47uF/6.3V | Capacitor_SMD:C_1206_3216Metric | 1
C13 | 47uF/6.3V | Capacitor_SMD:C_1206_3216Metric | 1
C14 | 100nF | Capacitor_SMD:C_0402_1005Metric | 1
C15 | 10nF | Capacitor_SMD:C_0402_1005Metric | 1
C16 | 22nF | Capacitor_SMD:C_0402_1005Metric | 1
C17 | 10uF/25V | Capacitor_SMD:C_1210_3225Metric | 1
C18 | 22uF/6.3V | Capacitor_SMD:C_0805_2012Metric | 1
C19 | 100nF | Capacitor_SMD:C_0402_1005Metric | 1
C20 | 3.3nF | Capacitor_SMD:C_0402_1005Metric | 1
C21 | 10uF/25V | Capacitor_SMD:C_1210_3225Metric | 1
C22 | 22uF/6.3V | Capacitor_SMD:C_0805_2012Metric | 1
C23 | 100nF | Capacitor_SMD:C_0402_1005Metric | 1
C24 | 3.3nF | Capacitor_SMD:C_0402_1005Metric | 1
C25 | 10uF/25V | Capacitor_SMD:C_1210_3225Metric | 1
C26 | 22uF/6.3V | Capacitor_SMD:C_0805_2012Metric | 1
C27 | 100nF | Capacitor_SMD:C_0402_1005Metric | 1
C28 | 3.3nF | Capacitor_SMD:C_0402_1005Metric | 1
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
TR18 | Translator_8ch |  | 1
TR19 | Translator_8ch |  | 1
TR20 | Translator_8ch |  | 1
U1 | FPGA_CycloneV_5CEFA9_F484 |  | 1
U2 | Intel_SC242_CardEdge |  | 1
U3 | DDR3L_x16_die |  | 1
U4 | DDR3L_x16_die |  | 1
U5 | DDR3L_x16_die |  | 1
U6 | DDR3L_x16_die |  | 1
U7 | DDR_VTT_tracker |  | 1
