alphaonex86/FPGA-CPU/hw/socket7-cyclonev/pins.csv

signal | ball | bank | vccio | io_standard | translator | distance_mm | socket_pin | source
D41 | AA20 | 4A | 3.3 V | 3.3-V LVTTL |  | 16.3 | A05 | sockets/socket7/pentium_mmx_datasheet_243185-004.pdf Table 6 p.26 (I/O)
D22 | AB10 | 3B | 3.3 V | 3.3-V LVTTL |  | 18.5 | A31 | sockets/socket7/pentium_mmx_datasheet_243185-004.pdf Table 6 p.26 (I/O)
D18 | T15 | 5A | 3.3 V | 3.3-V LVTTL |  | 28.1 | A33 | sockets/socket7/pentium_mmx_datasheet_243185-004.pdf Table 6 p.26 (I/O)
D15 | AB7 | 3B | 3.3 V | 3.3-V LVTTL |  | 20.1 | A35 | sockets/socket7/pentium_mmx_datasheet_243185-004.pdf Table 6 p.26 (I/O)
D43 | Y20 | 4A | 3.3 V | 3.3-V LVTTL |  | 16.8 | B04 | sockets/socket7/pentium_mmx_datasheet_243185-004.pdf Table 6 p.26 (I/O)
D20 | AA10 | 3B | 3.3 V | 3.3-V LVTTL |  | 17.4 | B30 | sockets/socket7/pentium_mmx_datasheet_243185-004.pdf Table 6 p.26 (I/O)
D16 | AB8 | 3B | 3.3 V | 3.3-V LVTTL |  | 17.1 | B32 | sockets/socket7/pentium_mmx_datasheet_243185-004.pdf Table 6 p.26 (I/O)
D13 | AA8 | 3B | 3.3 V | 3.3-V LVTTL |  | 19.7 | B34 | sockets/socket7/pentium_mmx_datasheet_243185-004.pdf Table 6 p.26 (I/O)
D11 | AB6 | 3B | 3.3 V | 3.3-V LVTTL |  | 19.5 | B36 | sockets/socket7/pentium_mmx_datasheet_243185-004.pdf Table 6 p.26 (I/O)
D47 | AA22 | 4A | 3.3 V | 3.3-V LVTTL |  | 14.6 | C03 | sockets/socket7/pentium_mmx_datasheet_243185-004.pdf Table 6 p.26 (I/O)
D45 | W19 | 4A | 3.3 V | 3.3-V LVTTL |  | 16.4 | C05 | sockets/socket7/pentium_mmx_datasheet_243185-004.pdf Table 6 p.26 (I/O)
DP4 | Y19 | 4A | 3.3 V | 3.3-V LVTTL |  | 14.1 | C07 | sockets/socket7/pentium_mmx_datasheet_243185-004.pdf Table 6 p.26 (I/O)
D38 | AA19 | 4A | 3.3 V | 3.3-V LVTTL |  | 12.0 | C09 | sockets/socket7/pentium_mmx_datasheet_243185-004.pdf Table 6 p.26 (I/O)
D36 | AB18 | 4A | 3.3 V | 3.3-V LVTTL |  | 10.5 | C11 | sockets/socket7/pentium_mmx_datasheet_243185-004.pdf Table 6 p.26 (I/O)
D34 | AA17 | 4A | 3.3 V | 3.3-V LVTTL |  | 11.0 | C13 | sockets/socket7/pentium_mmx_datasheet_243185-004.pdf Table 6 p.26 (I/O)
D32 | Y16 | 4A | 3.3 V | 3.3-V LVTTL |  | 11.8 | C15 | sockets/socket7/pentium_mmx_datasheet_243185-004.pdf Table 6 p.26 (I/O)
D31 | AB15 | 4A | 3.3 V | 3.3-V LVTTL |  | 9.9 | C17 | sockets/socket7/pentium_mmx_datasheet_243185-004.pdf Table 6 p.26 (I/O)
D29 | Y15 | 4A | 3.3 V | 3.3-V LVTTL |  | 12.3 | C19 | sockets/socket7/pentium_mmx_datasheet_243185-004.pdf Table 6 p.26 (I/O)
D27 | AB13 | 4A | 3.3 V | 3.3-V LVTTL |  | 10.6 | C21 | sockets/socket7/pentium_mmx_datasheet_243185-004.pdf Table 6 p.26 (I/O)
D25 | AA13 | 4A | 3.3 V | 3.3-V LVTTL |  | 12.7 | C23 | sockets/socket7/pentium_mmx_datasheet_243185-004.pdf Table 6 p.26 (I/O)
DP2 | AA12 | 3B | 3.3 V | 3.3-V LVTTL |  | 13.5 | C25 | sockets/socket7/pentium_mmx_datasheet_243185-004.pdf Table 6 p.26 (I/O)
D24 | U15 | 4A | 3.3 V | 3.3-V LVTTL |  | 20.2 | C27 | sockets/socket7/pentium_mmx_datasheet_243185-004.pdf Table 6 p.26 (I/O)
D21 | Y11 | 3B | 3.3 V | 3.3-V LVTTL |  | 17.0 | C29 | sockets/socket7/pentium_mmx_datasheet_243185-004.pdf Table 6 p.26 (I/O)
D17 | AA9 | 3B | 3.3 V | 3.3-V LVTTL |  | 16.7 | C31 | sockets/socket7/pentium_mmx_datasheet_243185-004.pdf Table 6 p.26 (I/O)
D14 | U13 | 4A | 3.3 V | 3.3-V LVTTL |  | 24.3 | C33 | sockets/socket7/pentium_mmx_datasheet_243185-004.pdf Table 6 p.26 (I/O)
D10 | AA7 | 3B | 3.3 V | 3.3-V LVTTL |  | 19.2 | C35 | sockets/socket7/pentium_mmx_datasheet_243185-004.pdf Table 6 p.26 (I/O)
D9 | U12 | 3B | 3.3 V | 3.3-V LVTTL |  | 27.7 | C37 | sockets/socket7/pentium_mmx_datasheet_243185-004.pdf Table 6 p.26 (I/O)
D50 | R16 | 5A | 3.3 V | 3.3-V LVTTL |  | 23.1 | D02 | sockets/socket7/pentium_mmx_datasheet_243185-004.pdf Table 6 p.26 (I/O)
D48 | Y21 | 4A | 3.3 V | 3.3-V LVTTL |  | 14.2 | D04 | sockets/socket7/pentium_mmx_datasheet_243185-004.pdf Table 6 p.26 (I/O)
D44 | V18 | 4A | 3.3 V | 3.3-V LVTTL |  | 16.1 | D06 | sockets/socket7/pentium_mmx_datasheet_243185-004.pdf Table 6 p.26 (I/O)
D40 | U17 | 4A | 3.3 V | 3.3-V LVTTL |  | 16.0 | D08 | sockets/socket7/pentium_mmx_datasheet_243185-004.pdf Table 6 p.26 (I/O)
D39 | AA18 | 4A | 3.3 V | 3.3-V LVTTL |  | 10.7 | D10 | sockets/socket7/pentium_mmx_datasheet_243185-004.pdf Table 6 p.26 (I/O)
D37 | Y17 | 4A | 3.3 V | 3.3-V LVTTL |  | 11.1 | D12 | sockets/socket7/pentium_mmx_datasheet_243185-004.pdf Table 6 p.26 (I/O)
D35 | AB17 | 4A | 3.3 V | 3.3-V LVTTL |  | 8.6 | D14 | sockets/socket7/pentium_mmx_datasheet_243185-004.pdf Table 6 p.26 (I/O)
D33 | U16 | 4A | 3.3 V | 3.3-V LVTTL |  | 13.6 | D16 | sockets/socket7/pentium_mmx_datasheet_243185-004.pdf Table 6 p.26 (I/O)
DP3 | AA15 | 4A | 3.3 V | 3.3-V LVTTL |  | 9.8 | D18 | sockets/socket7/pentium_mmx_datasheet_243185-004.pdf Table 6 p.26 (I/O)
D30 | AA14 | 4A | 3.3 V | 3.3-V LVTTL |  | 10.3 | D20 | sockets/socket7/pentium_mmx_datasheet_243185-004.pdf Table 6 p.26 (I/O)
D28 | Y14 | 4A | 3.3 V | 3.3-V LVTTL |  | 12.3 | D22 | sockets/socket7/pentium_mmx_datasheet_243185-004.pdf Table 6 p.26 (I/O)
D26 | AB12 | 4A | 3.3 V | 3.3-V LVTTL |  | 11.0 | D24 | sockets/socket7/pentium_mmx_datasheet_243185-004.pdf Table 6 p.26 (I/O)
D23 | AB11 | 3B | 3.3 V | 3.3-V LVTTL |  | 12.0 | D26 | sockets/socket7/pentium_mmx_datasheet_243185-004.pdf Table 6 p.26 (I/O)
D19 | V13 | 4A | 3.3 V | 3.3-V LVTTL |  | 18.0 | D28 | sockets/socket7/pentium_mmx_datasheet_243185-004.pdf Table 6 p.26 (I/O)
DP1 | Y10 | 3B | 3.3 V | 3.3-V LVTTL |  | 16.3 | D30 | sockets/socket7/pentium_mmx_datasheet_243185-004.pdf Table 6 p.26 (I/O)
D12 | Y9 | 3B | 3.3 V | 3.3-V LVTTL |  | 17.5 | D32 | sockets/socket7/pentium_mmx_datasheet_243185-004.pdf Table 6 p.26 (I/O)
D8 | AB5 | 3B | 3.3 V | 3.3-V LVTTL |  | 15.2 | D34 | sockets/socket7/pentium_mmx_datasheet_243185-004.pdf Table 6 p.26 (I/O)
DP0 | V10 | 3B | 3.3 V | 3.3-V LVTTL |  | 23.7 | D36 | sockets/socket7/pentium_mmx_datasheet_243185-004.pdf Table 6 p.26 (I/O)
D54 | R17 | 5A | 3.3 V | 3.3-V LVTTL |  | 22.5 | E01 | sockets/socket7/pentium_mmx_datasheet_243185-004.pdf Table 6 p.26 (I/O)
D52 | Y22 | 4A | 3.3 V | 3.3-V LVTTL |  | 13.5 | E03 | sockets/socket7/pentium_mmx_datasheet_243185-004.pdf Table 6 p.26 (I/O)
D49 | V19 | 4A | 3.3 V | 3.3-V LVTTL |  | 15.3 | E05 | sockets/socket7/pentium_mmx_datasheet_243185-004.pdf Table 6 p.26 (I/O)
D46 | AB21 | 4A | 3.3 V | 3.3-V LVTTL |  | 9.3 | E07 | sockets/socket7/pentium_mmx_datasheet_243185-004.pdf Table 6 p.26 (I/O)
D42 | AB20 | 4A | 3.3 V | 3.3-V LVTTL |  | 8.4 | E09 | sockets/socket7/pentium_mmx_datasheet_243185-004.pdf Table 6 p.26 (I/O)
D7 | T14 | 4A | 3.3 V | 3.3-V LVTTL |  | 24.2 | E33 | sockets/socket7/pentium_mmx_datasheet_243185-004.pdf Table 6 p.26 (I/O)
D6 | T13 | 4A | 3.3 V | 3.3-V LVTTL |  | 25.5 | E35 | sockets/socket7/pentium_mmx_datasheet_243185-004.pdf Table 6 p.26 (I/O)
DP6 | W22 | 4A | 3.3 V | 3.3-V LVTTL |  | 14.3 | F02 | sockets/socket7/pentium_mmx_datasheet_243185-004.pdf Table 6 p.26 (I/O)
D51 | W21 | 4A | 3.3 V | 3.3-V LVTTL |  | 13.1 | F04 | sockets/socket7/pentium_mmx_datasheet_243185-004.pdf Table 6 p.26 (I/O)
DP5 | AB22 | 4A | 3.3 V | 3.3-V LVTTL |  | 8.5 | F06 | sockets/socket7/pentium_mmx_datasheet_243185-004.pdf Table 6 p.26 (I/O)
D5 | U11 | 3B | 3.3 V | 3.3-V LVTTL |  | 21.6 | F34 | sockets/socket7/pentium_mmx_datasheet_243185-004.pdf Table 6 p.26 (I/O)
D4 | T12 | 4A | 3.3 V | 3.3-V LVTTL |  | 25.1 | F36 | sockets/socket7/pentium_mmx_datasheet_243185-004.pdf Table 6 p.26 (I/O)
D55 | V21 | 4A | 3.3 V | 3.3-V LVTTL |  | 13.9 | G03 | sockets/socket7/pentium_mmx_datasheet_243185-004.pdf Table 6 p.26 (I/O)
D53 | V20 | 4A | 3.3 V | 3.3-V LVTTL |  | 12.7 | G05 | sockets/socket7/pentium_mmx_datasheet_243185-004.pdf Table 6 p.26 (I/O)
D3 | V9 | 3B | 3.3 V | 3.3-V LVTTL |  | 17.6 | G33 | sockets/socket7/pentium_mmx_datasheet_243185-004.pdf Table 6 p.26 (I/O)
D1 | U10 | 3B | 3.3 V | 3.3-V LVTTL |  | 21.2 | G35 | sockets/socket7/pentium_mmx_datasheet_243185-004.pdf Table 6 p.26 (I/O)
D56 | U20 | 4A | 3.3 V | 3.3-V LVTTL |  | 13.5 | H04 | sockets/socket7/pentium_mmx_datasheet_243185-004.pdf Table 6 p.26 (I/O)
D57 | U21 | 4A | 3.3 V | 3.3-V LVTTL |  | 13.0 | J03 | sockets/socket7/pentium_mmx_datasheet_243185-004.pdf Table 6 p.26 (I/O)
D58 | T19 | 5A | 3.3 V | 3.3-V LVTTL |  | 13.1 | J05 | sockets/socket7/pentium_mmx_datasheet_243185-004.pdf Table 6 p.26 (I/O)
D2 | T10 | 3B | 3.3 V | 3.3-V LVTTL |  | 20.5 | J35 | sockets/socket7/pentium_mmx_datasheet_243185-004.pdf Table 6 p.26 (I/O)
D59 | P17 | 5A | 3.3 V | 3.3-V LVTTL |  | 16.2 | K04 | sockets/socket7/pentium_mmx_datasheet_243185-004.pdf Table 6 p.26 (I/O)
D0 | T9 | 3B | 3.3 V | 3.3-V LVTTL |  | 17.9 | K34 | sockets/socket7/pentium_mmx_datasheet_243185-004.pdf Table 6 p.26 (I/O)
D61 | P18 | 5A | 3.3 V | 3.3-V LVTTL |  | 15.8 | L03 | sockets/socket7/pentium_mmx_datasheet_243185-004.pdf Table 6 p.26 (I/O)
D60 | U22 | 4A | 3.3 V | 3.3-V LVTTL |  | 8.6 | L05 | sockets/socket7/pentium_mmx_datasheet_243185-004.pdf Table 6 p.26 (I/O)
D62 | P19 | 5A | 3.3 V | 3.3-V LVTTL |  | 13.2 | M04 | sockets/socket7/pentium_mmx_datasheet_243185-004.pdf Table 6 p.26 (I/O)
TCK | R9 | 3B | 3.3 V | 3.3-V LVTTL |  | 17.4 | M34 | sockets/socket7/pentium_mmx_datasheet_243185-004.pdf Table 5 pp.24-25 (inputs)
D63 | N20 | 5B | 3.3 V | 3.3-V LVTTL |  | 13.3 | N03 | sockets/socket7/pentium_mmx_datasheet_243185-004.pdf Table 6 p.26 (I/O)
DP7 | N19 | 5B | 3.3 V | 3.3-V LVTTL |  | 12.0 | N05 | sockets/socket7/pentium_mmx_datasheet_243185-004.pdf Table 6 p.26 (I/O)
TDO | P8 | 3B | 3.3 V | 3.3-V LVTTL |  | 15.2 | N33 | sockets/socket7/pentium_mmx_datasheet_243185-004.pdf Table 4 p.24 (outputs)
TDI | P7 | 3A | 3.3 V | 3.3-V LVTTL |  | 16.6 | N35 | sockets/socket7/pentium_mmx_datasheet_243185-004.pdf Table 5 pp.24-25 (inputs)
IERR# | M18 | 5B | 3.3 V | 3.3-V LVTTL |  | 13.8 | P04 | sockets/socket7/pentium_mmx_datasheet_243185-004.pdf Table 4 p.24 (outputs)
TMS | N8 | 3B | 3.3 V | 3.3-V LVTTL |  | 16.3 | P34 | sockets/socket7/pentium_mmx_datasheet_243185-004.pdf Table 5 pp.24-25 (inputs)
PM0/BP0 | L17 | 5B | 3.3 V | 3.3-V LVTTL |  | 15.8 | Q03 | sockets/socket7/pentium_mmx_datasheet_243185-004.pdf Table 4 p.24 (outputs)
FERR# | N21 | 5B | 3.3 V | 3.3-V LVTTL |  | 9.0 | Q05 | sockets/socket7/pentium_mmx_datasheet_243185-004.pdf Table 4 p.24 (outputs)
TRST# | L8 | 7A | 3.3 V | 3.3-V LVTTL |  | 15.3 | Q33 | sockets/socket7/pentium_mmx_datasheet_243185-004.pdf Table 5 pp.24-25 (inputs)
CPUTYP | L7 | 8A | 3.3 V | 3.3-V LVTTL |  | 16.8 | Q35 | sockets/socket7/pentium_mmx_datasheet_243185-004.pdf Table 5 pp.24-25 (inputs)
PM1/BP1 | M20 | 5B | 3.3 V | 3.3-V LVTTL |  | 11.1 | R04 | sockets/socket7/pentium_mmx_datasheet_243185-004.pdf Table 4 p.24 (outputs)
BP2 | M22 | 5B | 3.3 V | 3.3-V LVTTL |  | 10.0 | S03 | sockets/socket7/pentium_mmx_datasheet_243185-004.pdf Table 4 p.24 (outputs)
BP3 | M21 | 5B | 3.3 V | 3.3-V LVTTL |  | 8.5 | S05 | sockets/socket7/pentium_mmx_datasheet_243185-004.pdf Table 4 p.24 (outputs)
M/IO# | L18 | 5B | 3.3 V | 3.3-V LVTTL |  | 12.7 | T04 | sockets/socket7/pentium_mmx_datasheet_243185-004.pdf Table 4 p.24 (outputs)
CACHE# | L22 | 5B | 3.3 V | 3.3-V LVTTL |  | 9.8 | U03 | sockets/socket7/pentium_mmx_datasheet_243185-004.pdf Table 4 p.24 (outputs)
INV | L19 | 5B | 3.3 V | 3.3-V LVTTL |  | 10.3 | U05 | sockets/socket7/pentium_mmx_datasheet_243185-004.pdf Table 5 pp.24-25 (inputs)
AHOLD | K22 | 5B | 3.3 V | 3.3-V LVTTL |  | 8.6 | V04 | sockets/socket7/pentium_mmx_datasheet_243185-004.pdf Table 5 pp.24-25 (inputs)
STPCLK# | K7 | 8A | 3.3 V | 3.3-V LVTTL |  | 14.6 | V34 | sockets/socket7/pentium_mmx_datasheet_243185-004.pdf Table 5 pp.24-25 (inputs)
EWBE# | K21 | 5B | 3.3 V | 3.3-V LVTTL |  | 10.9 | W03 | sockets/socket7/pentium_mmx_datasheet_243185-004.pdf Table 5 pp.24-25 (inputs)
KEN# | K20 | 7A | 3.3 V | 3.3-V LVTTL |  | 9.3 | W05 | sockets/socket7/pentium_mmx_datasheet_243185-004.pdf Table 5 pp.24-25 (inputs)
BRDY# | K19 | 7A | 3.3 V | 3.3-V LVTTL |  | 11.8 | X04 | sockets/socket7/pentium_mmx_datasheet_243185-004.pdf Table 5 pp.24-25 (inputs)
[BF1] | J7 | 8A | 3.3 V | 3.3-V LVTTL |  | 14.6 | X34 | sockets/socket7/pentium_mmx_datasheet_243185-004.pdf Table 5 pp.24-25 (inputs)
BRDYC# | J22 | 7A | 3.3 V | 3.3-V LVTTL |  | 10.2 | Y03 | sockets/socket7/pentium_mmx_datasheet_243185-004.pdf Table 5 pp.24-25 (inputs)
NA# | J21 | 7A | 3.3 V | 3.3-V LVTTL |  | 8.7 | Y05 | sockets/socket7/pentium_mmx_datasheet_243185-004.pdf Table 5 pp.24-25 (inputs)
[BF0] | H6 | 8A | 3.3 V | 3.3-V LVTTL |  | 12.4 | Y33 | sockets/socket7/pentium_mmx_datasheet_243185-004.pdf Table 5 pp.24-25 (inputs)
BOFF# | J19 | 7A | 3.3 V | 3.3-V LVTTL |  | 12.2 | Z04 | sockets/socket7/pentium_mmx_datasheet_243185-004.pdf Table 5 pp.24-25 (inputs)
PEN# | G6 | 8A | 3.3 V | 3.3-V LVTTL |  | 13.7 | Z34 | sockets/socket7/pentium_mmx_datasheet_243185-004.pdf Table 5 pp.24-25 (inputs)
WB/WT# | H21 | 7A | 3.3 V | 3.3-V LVTTL |  | 9.2 | AA05 | sockets/socket7/pentium_mmx_datasheet_243185-004.pdf Table 5 pp.24-25 (inputs)
INIT | G11 | 7A | 3.3 V | 3.3-V LVTTL |  | 17.6 | AA33 | sockets/socket7/pentium_mmx_datasheet_243185-004.pdf Table 5 pp.24-25 (inputs)
IGNNE# | G8 | 8A | 3.3 V | 3.3-V LVTTL |  | 17.1 | AA35 | sockets/socket7/pentium_mmx_datasheet_243185-004.pdf Table 5 pp.24-25 (inputs)
HOLD | G22 | 7A | 3.3 V | 3.3-V LVTTL |  | 9.6 | AB04 | sockets/socket7/pentium_mmx_datasheet_243185-004.pdf Table 5 pp.24-25 (inputs)
SMI# | F7 | 8A | 3.3 V | 3.3-V LVTTL |  | 14.9 | AB34 | sockets/socket7/pentium_mmx_datasheet_243185-004.pdf Table 5 pp.24-25 (inputs)
PRDY | G21 | 7A | 3.3 V | 3.3-V LVTTL |  | 10.0 | AC05 | sockets/socket7/pentium_mmx_datasheet_243185-004.pdf Table 4 p.24 (outputs)
NMI/LINT1 | G12 | 7A | 3.3 V | 3.3-V LVTTL |  | 19.1 | AC33 | sockets/socket7/pentium_mmx_datasheet_243185-004.pdf Table 5 pp.24-25 (inputs)
INTR/LINT0 | E7 | 8A | 3.3 V | 3.3-V LVTTL |  | 15.4 | AD34 | sockets/socket7/pentium_mmx_datasheet_243185-004.pdf Table 5 pp.24-25 (inputs)
APCHK# | F22 | 7A | 3.3 V | 3.3-V LVTTL |  | 10.2 | AE05 | sockets/socket7/pentium_mmx_datasheet_243185-004.pdf Table 4 p.24 (outputs)
A23 | D6 | 8A | 3.3 V | 3.3-V LVTTL |  | 13.3 | AE33 | sockets/socket7/pentium_mmx_datasheet_243185-004.pdf Table 6 p.26 (I/O)
PCHK# | K17 | 5B | 3.3 V | 3.3-V LVTTL |  | 18.4 | AF04 | sockets/socket7/pentium_mmx_datasheet_243185-004.pdf Table 4 p.24 (outputs)
A21 | E9 | 8A | 3.3 V | 3.3-V LVTTL |  | 18.2 | AF34 | sockets/socket7/pentium_mmx_datasheet_243185-004.pdf Table 6 p.26 (I/O)
SMIACT# | J18 | 7A | 3.3 V | 3.3-V LVTTL |  | 18.8 | AG03 | sockets/socket7/pentium_mmx_datasheet_243185-004.pdf Table 4 p.24 (outputs)
PCD | H18 | 7A | 3.3 V | 3.3-V LVTTL |  | 16.3 | AG05 | sockets/socket7/pentium_mmx_datasheet_243185-004.pdf Table 4 p.24 (outputs)
A27 | F12 | 7A | 3.3 V | 3.3-V LVTTL |  | 20.7 | AG33 | sockets/socket7/pentium_mmx_datasheet_243185-004.pdf Table 6 p.26 (I/O)
A24 | D7 | 8A | 3.3 V | 3.3-V LVTTL |  | 17.6 | AG35 | sockets/socket7/pentium_mmx_datasheet_243185-004.pdf Table 6 p.26 (I/O)
LOCK# | G18 | 7A | 3.3 V | 3.3-V LVTTL |  | 17.4 | AH04 | sockets/socket7/pentium_mmx_datasheet_243185-004.pdf Table 4 p.24 (outputs)
A26 | B5 | 8A | 3.3 V | 3.3-V LVTTL |  | 14.4 | AH34 | sockets/socket7/pentium_mmx_datasheet_243185-004.pdf Table 6 p.26 (I/O)
A22 | C6 | 8A | 3.3 V | 3.3-V LVTTL |  | 18.0 | AH36 | sockets/socket7/pentium_mmx_datasheet_243185-004.pdf Table 6 p.26 (I/O)
BREQ | J17 | 7A | 3.3 V | 3.3-V LVTTL |  | 23.1 | AJ01 | sockets/socket7/pentium_mmx_datasheet_243185-004.pdf Table 4 p.24 (outputs)
HLDA | E21 | 7A | 3.3 V | 3.3-V LVTTL |  | 15.6 | AJ03 | sockets/socket7/pentium_mmx_datasheet_243185-004.pdf Table 4 p.24 (outputs)
ADS# | C20 | 7A | 3.3 V | 3.3-V LVTTL |  | 13.1 | AJ05 | sockets/socket7/pentium_mmx_datasheet_243185-004.pdf Table 4 p.24 (outputs)
A31 | C8 | 8A | 3.3 V | 3.3-V LVTTL |  | 17.0 | AJ33 | sockets/socket7/pentium_mmx_datasheet_243185-004.pdf Table 6 p.26 (I/O)
A25 | D9 | 8A | 3.3 V | 3.3-V LVTTL |  | 20.6 | AJ35 | sockets/socket7/pentium_mmx_datasheet_243185-004.pdf Table 6 p.26 (I/O)
AP | D21 | 7A | 3.3 V | 3.3-V LVTTL |  | 16.7 | AK02 | sockets/socket7/pentium_mmx_datasheet_243185-004.pdf Table 6 p.26 (I/O)
D/C# | B21 | 7A | 3.3 V | 3.3-V LVTTL |  | 13.5 | AK04 | sockets/socket7/pentium_mmx_datasheet_243185-004.pdf Table 4 p.24 (outputs)
HIT# | B20 | 7A | 3.3 V | 3.3-V LVTTL |  | 12.5 | AK06 | sockets/socket7/pentium_mmx_datasheet_243185-004.pdf Table 4 p.24 (outputs)
A20M# | E16 | 7A | 3.3 V | 3.3-V LVTTL |  | 15.7 | AK08 | sockets/socket7/pentium_mmx_datasheet_243185-004.pdf Table 5 pp.24-25 (inputs)
BE1# | B17 | 7A | 3.3 V | 3.3-V LVTTL |  | 11.2 | AK10 | sockets/socket7/pentium_mmx_datasheet_243185-004.pdf Table 6 p.26 (I/O)
BE3# | E15 | 7A | 3.3 V | 3.3-V LVTTL |  | 13.7 | AK12 | sockets/socket7/pentium_mmx_datasheet_243185-004.pdf Table 6 p.26 (I/O)
BE5# | C15 | 7A | 3.3 V | 3.3-V LVTTL |  | 10.9 | AK14 | sockets/socket7/pentium_mmx_datasheet_243185-004.pdf Table 4 p.24 (outputs)
BE7# | A15 | 7A | 3.3 V | 3.3-V LVTTL |  | 8.6 | AK16 | sockets/socket7/pentium_mmx_datasheet_243185-004.pdf Table 4 p.24 (outputs)
CLK | W16 | 4A | 3.3 V | 3.3-V LVTTL |  | 26.7 | AK18 | sockets/socket7/pentium_mmx_datasheet_243185-004.pdf Table 5 pp.24-25 (inputs)
RESET | A13 | 7A | 3.3 V | 3.3-V LVTTL |  | 9.0 | AK20 | sockets/socket7/pentium_mmx_datasheet_243185-004.pdf Table 5 pp.24-25 (inputs)
A19 | A12 | 7A | 3.3 V | 3.3-V LVTTL |  | 9.6 | AK22 | sockets/socket7/pentium_mmx_datasheet_243185-004.pdf Table 6 p.26 (I/O)
A17 | B12 | 7A | 3.3 V | 3.3-V LVTTL |  | 11.8 | AK24 | sockets/socket7/pentium_mmx_datasheet_243185-004.pdf Table 6 p.26 (I/O)
A15 | D13 | 7A | 3.3 V | 3.3-V LVTTL |  | 15.5 | AK26 | sockets/socket7/pentium_mmx_datasheet_243185-004.pdf Table 6 p.26 (I/O)
A13 | B10 | 8A | 3.3 V | 3.3-V LVTTL |  | 13.8 | AK28 | sockets/socket7/pentium_mmx_datasheet_243185-004.pdf Table 6 p.26 (I/O)
A9 | F14 | 7A | 3.3 V | 3.3-V LVTTL |  | 21.3 | AK30 | sockets/socket7/pentium_mmx_datasheet_243185-004.pdf Table 6 p.26 (I/O)
A5 | C9 | 8A | 3.3 V | 3.3-V LVTTL |  | 17.5 | AK32 | sockets/socket7/pentium_mmx_datasheet_243185-004.pdf Table 6 p.26 (I/O)
A29 | A5 | 8A | 3.3 V | 3.3-V LVTTL |  | 15.2 | AK34 | sockets/socket7/pentium_mmx_datasheet_243185-004.pdf Table 6 p.26 (I/O)
A28 | B6 | 8A | 3.3 V | 3.3-V LVTTL |  | 18.7 | AK36 | sockets/socket7/pentium_mmx_datasheet_243185-004.pdf Table 6 p.26 (I/O)
VCC2DET# | G17 | 7A | 3.3 V | 3.3-V LVTTL |  | 23.5 | AL01 | sockets/socket7/pentium_mmx_datasheet_243185-004.pdf Table 4 p.24 (outputs)
PWT | E19 | 7A | 3.3 V | 3.3-V LVTTL |  | 18.9 | AL03 | sockets/socket7/pentium_mmx_datasheet_243185-004.pdf Table 4 p.24 (outputs)
HITM# | G16 | 7A | 3.3 V | 3.3-V LVTTL |  | 20.7 | AL05 | sockets/socket7/pentium_mmx_datasheet_243185-004.pdf Table 4 p.24 (outputs)
BUSCHK# | D17 | 7A | 3.3 V | 3.3-V LVTTL |  | 16.1 | AL07 | sockets/socket7/pentium_mmx_datasheet_243185-004.pdf Table 5 pp.24-25 (inputs)
BE0# | F15 | 7A | 3.3 V | 3.3-V LVTTL |  | 17.4 | AL09 | sockets/socket7/pentium_mmx_datasheet_243185-004.pdf Table 6 p.26 (I/O)
BE2# | C16 | 7A | 3.3 V | 3.3-V LVTTL |  | 13.1 | AL11 | sockets/socket7/pentium_mmx_datasheet_243185-004.pdf Table 6 p.26 (I/O)
BE4# | B16 | 7A | 3.3 V | 3.3-V LVTTL |  | 11.3 | AL13 | sockets/socket7/pentium_mmx_datasheet_243185-004.pdf Table 4 p.24 (outputs)
BE6# | B15 | 7A | 3.3 V | 3.3-V LVTTL |  | 10.9 | AL15 | sockets/socket7/pentium_mmx_datasheet_243185-004.pdf Table 4 p.24 (outputs)
SCYC | A14 | 7A | 3.3 V | 3.3-V LVTTL |  | 9.8 | AL17 | sockets/socket7/pentium_mmx_datasheet_243185-004.pdf Table 4 p.24 (outputs)
A20 | B13 | 7A | 3.3 V | 3.3-V LVTTL |  | 11.5 | AL21 | sockets/socket7/pentium_mmx_datasheet_243185-004.pdf Table 6 p.26 (I/O)
A18 | C13 | 7A | 3.3 V | 3.3-V LVTTL |  | 13.5 | AL23 | sockets/socket7/pentium_mmx_datasheet_243185-004.pdf Table 6 p.26 (I/O)
A16 | E14 | 7A | 3.3 V | 3.3-V LVTTL |  | 17.1 | AL25 | sockets/socket7/pentium_mmx_datasheet_243185-004.pdf Table 6 p.26 (I/O)
A14 | B11 | 7A | 3.3 V | 3.3-V LVTTL |  | 14.5 | AL27 | sockets/socket7/pentium_mmx_datasheet_243185-004.pdf Table 6 p.26 (I/O)
A12 | A9 | 8A | 3.3 V | 3.3-V LVTTL |  | 14.2 | AL29 | sockets/socket7/pentium_mmx_datasheet_243185-004.pdf Table 6 p.26 (I/O)
A11 | A8 | 8A | 3.3 V | 3.3-V LVTTL |  | 15.3 | AL31 | sockets/socket7/pentium_mmx_datasheet_243185-004.pdf Table 6 p.26 (I/O)
A7 | E12 | 7A | 3.3 V | 3.3-V LVTTL |  | 22.9 | AL33 | sockets/socket7/pentium_mmx_datasheet_243185-004.pdf Table 6 p.26 (I/O)
A3 | B7 | 8A | 3.3 V | 3.3-V LVTTL |  | 19.2 | AL35 | sockets/socket7/pentium_mmx_datasheet_243185-004.pdf Table 6 p.26 (I/O)
ADSC# | C21 | 7A | 3.3 V | 3.3-V LVTTL |  | 17.8 | AM02 | sockets/socket7/pentium_mmx_datasheet_243185-004.pdf Table 4 p.24 (outputs)
EADS# | D19 | 7A | 3.3 V | 3.3-V LVTTL |  | 18.2 | AM04 | sockets/socket7/pentium_mmx_datasheet_243185-004.pdf Table 5 pp.24-25 (inputs)
W/R# | G15 | 7A | 3.3 V | 3.3-V LVTTL |  | 21.5 | AM06 | sockets/socket7/pentium_mmx_datasheet_243185-004.pdf Table 4 p.24 (outputs)
A8 | D12 | 7A | 3.3 V | 3.3-V LVTTL |  | 22.1 | AM32 | sockets/socket7/pentium_mmx_datasheet_243185-004.pdf Table 6 p.26 (I/O)
A4 | A7 | 8A | 3.3 V | 3.3-V LVTTL |  | 18.3 | AM34 | sockets/socket7/pentium_mmx_datasheet_243185-004.pdf Table 6 p.26 (I/O)
A30 | F13 | 7A | 3.3 V | 3.3-V LVTTL |  | 28.1 | AM36 | sockets/socket7/pentium_mmx_datasheet_243185-004.pdf Table 6 p.26 (I/O)
FLUSH# | B18 | 7A | 3.3 V | 3.3-V LVTTL |  | 16.0 | AN07 | sockets/socket7/pentium_mmx_datasheet_243185-004.pdf Table 5 pp.24-25 (inputs)
A10 | A10 | 8A | 3.3 V | 3.3-V LVTTL |  | 18.5 | AN31 | sockets/socket7/pentium_mmx_datasheet_243185-004.pdf Table 6 p.26 (I/O)
A6 | C11 | 7A | 3.3 V | 3.3-V LVTTL |  | 22.5 | AN33 | sockets/socket7/pentium_mmx_datasheet_243185-004.pdf Table 6 p.26 (I/O)
