alphaonex86/FPGA-CPU/hw/slot1-c2cart/pdn.csv

ref | sym | value | footprint | nets | side | kind | a | b
F1 | Device:Fuse | 2A | Fuse:Fuse_1206_3216Metric | V12_IN|V12 | F | stage | F1
PS1 | Slot1Parts:TPS54620 | TPS54620RHL | Pwr:TI_RHL0014A | PS1_RT|GND|GND|V12|V12|V12|PS1_FB|PS1_COMP|PS1_SS|NC_PS1_10|PS1_SW|PS1_SW|PS1_BOOT|PG_5V|GND | F | stage | PS1
L1 | Device:L | 6.8uH MSS1048-682 | Inductor_SMD:L_Coilcraft_MSS1048-XXX | PS1_SW|V5 | F | stage | PS1
C1 | Device:C | 10uF/25V | Capacitor_SMD:C_1210_3225Metric | V12|GND | F | stage | PS1
C2 | Device:C | 4.7uF/25V | Capacitor_SMD:C_0805_2012Metric | V12|GND | F | stage | PS1
C3 | Device:C | 22uF/10V | Capacitor_SMD:C_1206_3216Metric | V5|GND | F | stage | PS1
C4 | Device:C | 22uF/10V | Capacitor_SMD:C_1206_3216Metric | V5|GND | F | stage | PS1
C5 | Device:C | 100nF | Capacitor_SMD:C_0402_1005Metric | PS1_BOOT|PS1_SW | F | stage | PS1
C6 | Device:C | 10nF | Capacitor_SMD:C_0402_1005Metric | PS1_SS|GND | F | stage | PS1
C7 | Device:C | 27nF | Capacitor_SMD:C_0402_1005Metric | PS1_CZ|GND | F | stage | PS1
R1 | Device:R | 1.33k | Resistor_SMD:R_0402_1005Metric | PS1_COMP|PS1_CZ | F | stage | PS1
R2 | Device:R | 100k | Resistor_SMD:R_0402_1005Metric | PS1_RT|GND | F | stage | PS1
R3 | Device:R | 52.3k | Resistor_SMD:R_0402_1005Metric | V5|PS1_FB | F | stage | PS1
R4 | Device:R | 10k | Resistor_SMD:R_0402_1005Metric | PS1_FB|GND | F | stage | PS1
R5 | Device:R | 100k | Resistor_SMD:R_0402_1005Metric | PG_5V|V5 | F | stage | PS1
PS2 | Slot1Parts:TPS54620 | TPS54620RHL | Pwr:TI_RHL0014A | PS2_RT|GND|GND|V5|V5|V5|PS2_FB|PS2_COMP|PS2_SS|PG_5V|PS2_SW|PS2_SW|PS2_BOOT|PG_1V1|GND | F | stage | PS2
L2 | Device:L | 1.5uH MSS1048-152 | Inductor_SMD:L_Coilcraft_MSS1048-XXX | PS2_SW|VCC_1V1 | F | stage | PS2
C8 | Device:C | 10uF/25V | Capacitor_SMD:C_1210_3225Metric | V5|GND | F | stage | PS2
C9 | Device:C | 4.7uF/25V | Capacitor_SMD:C_0805_2012Metric | V5|GND | F | stage | PS2
C10 | Device:C | 47uF/6.3V | Capacitor_SMD:C_1206_3216Metric | VCC_1V1|GND | F | stage | PS2
C11 | Device:C | 47uF/6.3V | Capacitor_SMD:C_1206_3216Metric | VCC_1V1|GND | F | stage | PS2
C12 | Device:C | 47uF/6.3V | Capacitor_SMD:C_1206_3216Metric | VCC_1V1|GND | F | stage | PS2
C13 | Device:C | 47uF/6.3V | Capacitor_SMD:C_1206_3216Metric | VCC_1V1|GND | F | stage | PS2
C14 | Device:C | 100nF | Capacitor_SMD:C_0402_1005Metric | PS2_BOOT|PS2_SW | F | stage | PS2
C15 | Device:C | 10nF | Capacitor_SMD:C_0402_1005Metric | PS2_SS|GND | F | stage | PS2
C16 | Device:C | 22nF | Capacitor_SMD:C_0402_1005Metric | PS2_CZ|GND | F | stage | PS2
R6 | Device:R | 1.91k | Resistor_SMD:R_0402_1005Metric | PS2_COMP|PS2_CZ | F | stage | PS2
R7 | Device:R | 100k | Resistor_SMD:R_0402_1005Metric | PS2_RT|GND | F | stage | PS2
R8 | Device:R | 3.74k | Resistor_SMD:R_0402_1005Metric | VCC_1V1|PS2_FB | F | stage | PS2
R9 | Device:R | 10k | Resistor_SMD:R_0402_1005Metric | PS2_FB|GND | F | stage | PS2
R10 | Device:R | 100k | Resistor_SMD:R_0402_1005Metric | PG_1V1|V5 | F | stage | PS2
PS3 | Slot1Parts:TPS62130 | TPS62130RGT | Package_DFN_QFN:VQFN-16-1EP_3x3mm_P0.5mm_EP1.68x1.68mm | PS3_SW|PS3_SW|PS3_SW|NC_PS3_4|PS3_FB|GND|GND|GND|PS3_SS|V5|V5|V5|PG_1V1|VCC_AUX25|GND|GND|GND | F | stage | PS3
L3 | Device:L | 2.2uH XFL4020-222 | Inductor_SMD:L_Coilcraft_XxL4020 | PS3_SW|VCC_AUX25 | F | stage | PS3
C17 | Device:C | 10uF/25V | Capacitor_SMD:C_1210_3225Metric | V5|GND | F | stage | PS3
C18 | Device:C | 22uF/6.3V | Capacitor_SMD:C_0805_2012Metric | VCC_AUX25|GND | F | stage | PS3
C19 | Device:C | 100nF | Capacitor_SMD:C_0402_1005Metric | V5|GND | F | stage | PS3
C20 | Device:C | 3.3nF | Capacitor_SMD:C_0402_1005Metric | PS3_SS|GND | F | stage | PS3
R11 | Device:R | 215k | Resistor_SMD:R_0402_1005Metric | VCC_AUX25|PS3_FB | F | stage | PS3
R12 | Device:R | 100k | Resistor_SMD:R_0402_1005Metric | PS3_FB|GND | F | stage | PS3
FB1 | Device:FerriteBead | BLM18AG601SN1D | Inductor_SMD:L_0603_1608Metric | VCC_AUX25|VCCA_FPLL25 | F | stage | PS3
PS4 | Slot1Parts:TPS62130 | TPS62130RGT | Package_DFN_QFN:VQFN-16-1EP_3x3mm_P0.5mm_EP1.68x1.68mm | PS4_SW|PS4_SW|PS4_SW|NC_PS4_4|PS4_FB|GND|GND|GND|PS4_SS|V5|V5|V5|PG_1V1|VCCIO33|GND|GND|GND | F | stage | PS4
L4 | Device:L | 2.2uH XFL4020-222 | Inductor_SMD:L_Coilcraft_XxL4020 | PS4_SW|VCCIO33 | F | stage | PS4
C21 | Device:C | 10uF/25V | Capacitor_SMD:C_1210_3225Metric | V5|GND | F | stage | PS4
C22 | Device:C | 22uF/6.3V | Capacitor_SMD:C_0805_2012Metric | VCCIO33|GND | F | stage | PS4
C23 | Device:C | 100nF | Capacitor_SMD:C_0402_1005Metric | V5|GND | F | stage | PS4
C24 | Device:C | 3.3nF | Capacitor_SMD:C_0402_1005Metric | PS4_SS|GND | F | stage | PS4
R13 | Device:R | 316k | Resistor_SMD:R_0402_1005Metric | VCCIO33|PS4_FB | F | stage | PS4
R14 | Device:R | 100k | Resistor_SMD:R_0402_1005Metric | PS4_FB|GND | F | stage | PS4
PS5 | Slot1Parts:TPS62130 | TPS62130RGT | Package_DFN_QFN:VQFN-16-1EP_3x3mm_P0.5mm_EP1.68x1.68mm | PS5_SW|PS5_SW|PS5_SW|NC_PS5_4|PS5_FB|GND|GND|GND|PS5_SS|V5|V5|V5|PG_1V1|VCCIO18|GND|GND|GND | F | stage | PS5
L5 | Device:L | 2.2uH XFL4020-222 | Inductor_SMD:L_Coilcraft_XxL4020 | PS5_SW|VCCIO18 | F | stage | PS5
C25 | Device:C | 10uF/25V | Capacitor_SMD:C_1210_3225Metric | V5|GND | F | stage | PS5
C26 | Device:C | 22uF/6.3V | Capacitor_SMD:C_0805_2012Metric | VCCIO18|GND | F | stage | PS5
C27 | Device:C | 100nF | Capacitor_SMD:C_0402_1005Metric | V5|GND | F | stage | PS5
C28 | Device:C | 3.3nF | Capacitor_SMD:C_0402_1005Metric | PS5_SS|GND | F | stage | PS5
R15 | Device:R | 124k | Resistor_SMD:R_0402_1005Metric | VCCIO18|PS5_FB | F | stage | PS5
R16 | Device:R | 100k | Resistor_SMD:R_0402_1005Metric | PS5_FB|GND | F | stage | PS5
C29 | Device:C | 4.7nF | Pwr:C_0402_P1.00 | VCC_1V1|GND | B | u1pair | J10 | K10
C30 | Device:C | 4.7nF | Pwr:C_0402_P1.00 | VCC_1V1|GND | B | u1pair | J12 | H12
C31 | Device:C | 4.7nF | Pwr:C_0402_P1.00 | VCC_1V1|GND | B | u1pair | J14 | K14
C32 | Device:C | 4.7nF | Pwr:C_0402_P1.00 | VCC_1V1|GND | B | u1pair | J16 | J15
C33 | Device:C | 4.7nF | Pwr:C_0402_P1.00 | VCC_1V1|GND | B | u1pair | J4 | K4
C34 | Device:C | 4.7nF | Pwr:C_0402_P1.00 | VCC_1V1|GND | B | u1pair | K11 | L11
C35 | Device:C | 4.7nF | Pwr:C_0402_P1.00 | VCC_1V1|GND | B | u1pair | K13 | L13
C36 | Device:C | 4.7nF | Pwr:C_0402_P1.00 | VCC_1V1|GND | B | u1pair | K15 | L15
C37 | Device:C | 4.7nF | Pwr:C_0402_P1.00 | VCC_1V1|GND | B | u1pair | K3 | L3
C38 | Device:C | 4.7nF | Pwr:C_0402_P1.00 | VCC_1V1|GND | B | u1pair | K5 | L5
C39 | Device:C | 4.7nF | Pwr:C_0402_P1.00 | VCC_1V1|GND | B | u1pair | L10 | M10
C40 | Device:C | 4.7nF | Pwr:C_0402_P1.00 | VCC_1V1|GND | B | u1pair | L12 | K12
C41 | Device:C | 4.7nF | Pwr:C_0402_P1.00 | VCC_1V1|GND | B | u1pair | L14 | M14
C42 | Device:C | 10nF | Pwr:C_0402_P1.00 | VCC_1V1|GND | B | u1pair | L4 | M4
C43 | Device:C | 10nF | Pwr:C_0402_P1.00 | VCC_1V1|GND | B | u1pair | M11 | N11
C44 | Device:C | 10nF | Pwr:C_0402_P1.00 | VCC_1V1|GND | B | u1pair | M13 | N13
C45 | Device:C | 10nF | Pwr:C_0402_P1.00 | VCC_1V1|GND | B | u1pair | M15 | N15
C46 | Device:C | 10nF | Pwr:C_0402_P1.00 | VCC_1V1|GND | B | u1pair | N10 | P10
C47 | Device:C | 10nF | Pwr:C_0402_P1.00 | VCC_1V1|GND | B | u1pair | N12 | M12
C48 | Device:C | 10nF | Pwr:C_0402_P1.00 | VCC_1V1|GND | B | u1pair | N4 | P4
C49 | Device:C | 10nF | Pwr:C_0402_P1.00 | VCC_1V1|GND | B | u1pair | P13 | R13
C50 | Device:C | 10nF | Pwr:C_0402_P1.00 | VCC_1V1|GND | B | u1pair | P3 | R3
C51 | Device:C | 10nF | Capacitor_SMD:C_0402_1005Metric | VCC_1V1|GND | F | u1bulk
C52 | Device:C | 10nF | Capacitor_SMD:C_0402_1005Metric | VCC_1V1|GND | F | u1bulk
C53 | Device:C | 10nF | Capacitor_SMD:C_0402_1005Metric | VCC_1V1|GND | F | u1bulk
C54 | Device:C | 10nF | Capacitor_SMD:C_0402_1005Metric | VCC_1V1|GND | F | u1bulk
C55 | Device:C | 10nF | Capacitor_SMD:C_0402_1005Metric | VCC_1V1|GND | F | u1bulk
C56 | Device:C | 10nF | Capacitor_SMD:C_0402_1005Metric | VCC_1V1|GND | F | u1bulk
C57 | Device:C | 10nF | Capacitor_SMD:C_0402_1005Metric | VCC_1V1|GND | F | u1bulk
C58 | Device:C | 10nF | Capacitor_SMD:C_0402_1005Metric | VCC_1V1|GND | F | u1bulk
C59 | Device:C | 22nF | Capacitor_SMD:C_0402_1005Metric | VCC_1V1|GND | F | u1bulk
C60 | Device:C | 22nF | Capacitor_SMD:C_0402_1005Metric | VCC_1V1|GND | F | u1bulk
C61 | Device:C | 22nF | Capacitor_SMD:C_0402_1005Metric | VCC_1V1|GND | F | u1bulk
C62 | Device:C | 22nF | Capacitor_SMD:C_0402_1005Metric | VCC_1V1|GND | F | u1bulk
C63 | Device:C | 22nF | Capacitor_SMD:C_0402_1005Metric | VCC_1V1|GND | F | u1bulk
C64 | Device:C | 22nF | Capacitor_SMD:C_0402_1005Metric | VCC_1V1|GND | F | u1bulk
C65 | Device:C | 22nF | Capacitor_SMD:C_0402_1005Metric | VCC_1V1|GND | F | u1bulk
C66 | Device:C | 22nF | Capacitor_SMD:C_0402_1005Metric | VCC_1V1|GND | F | u1bulk
C67 | Device:C | 22nF | Capacitor_SMD:C_0402_1005Metric | VCC_1V1|GND | F | u1bulk
C68 | Device:C | 22nF | Capacitor_SMD:C_0402_1005Metric | VCC_1V1|GND | F | u1bulk
C69 | Device:C | 22nF | Capacitor_SMD:C_0402_1005Metric | VCC_1V1|GND | F | u1bulk
C70 | Device:C | 22nF | Capacitor_SMD:C_0402_1005Metric | VCC_1V1|GND | F | u1bulk
C71 | Device:C | 47nF | Capacitor_SMD:C_0402_1005Metric | VCC_1V1|GND | F | u1bulk
C72 | Device:C | 47nF | Capacitor_SMD:C_0402_1005Metric | VCC_1V1|GND | F | u1bulk
C73 | Device:C | 47nF | Capacitor_SMD:C_0402_1005Metric | VCC_1V1|GND | F | u1bulk
C74 | Device:C | 47nF | Capacitor_SMD:C_0402_1005Metric | VCC_1V1|GND | F | u1bulk
C75 | Device:C | 100nF | Capacitor_SMD:C_0402_1005Metric | VCC_1V1|GND | F | u1bulk
C76 | Device:C | 100nF | Capacitor_SMD:C_0402_1005Metric | VCC_1V1|GND | F | u1bulk
C77 | Device:C | 100nF | Capacitor_SMD:C_0402_1005Metric | VCC_1V1|GND | F | u1bulk
C78 | Device:C | 220nF | Capacitor_SMD:C_0402_1005Metric | VCC_1V1|GND | F | u1bulk
C79 | Device:C | 220nF | Capacitor_SMD:C_0402_1005Metric | VCC_1V1|GND | F | u1bulk
C80 | Device:C | 470nF | Capacitor_SMD:C_0402_1005Metric | VCC_1V1|GND | F | u1bulk
C81 | Device:C | 1uF | Capacitor_SMD:C_0402_1005Metric | VCC_1V1|GND | F | u1bulk
C82 | Device:C | 2.2nF | Pwr:C_0402_P1.00 | VCCIO33|GND | B | u1pair | AA16 | AB16
C83 | Device:C | 2.2nF | Pwr:C_0402_P1.00 | VCCIO33|GND | B | u1pair | C10 | D10
C84 | Device:C | 4.7nF | Pwr:C_0402_P1.00 | VCCIO33|GND | B | u1pair | D14 | C14
C85 | Device:C | 4.7nF | Pwr:C_0402_P1.00 | VCCIO33|GND | B | u1pair | D4 | E4
C86 | Device:C | 10nF | Pwr:C_0402_P1.00 | VCCIO33|GND | B | u1pair | E1 | F1
C87 | Device:C | 10nF | Pwr:C_0402_P1.00 | VCCIO33|GND | B | u1pair | F3 | G3
C88 | Device:C | 22nF | Pwr:C_0402_P1.00 | VCCIO33|GND | B | u1pair | G7 | H7
C89 | Device:C | 47nF | Pwr:C_0402_P1.00 | VCCIO33|GND | B | u1pair | J1 | K1
C90 | Device:C | 100nF | Pwr:C_0402_P1.00 | VCCIO33|GND | B | u1pair | J2 | K2
C91 | Device:C | 1uF | Pwr:C_0402_P1.00 | VCCIO33|GND | B | u1pair | J6 | J5
C92 | Device:C | 10nF | Capacitor_SMD:C_0402_1005Metric | VCCIO18|GND | F | u1bulk
C93 | Device:C | 100nF | Capacitor_SMD:C_0402_1005Metric | VCCIO18|GND | F | u1bulk
C94 | Device:C | 1uF | Capacitor_SMD:C_0402_1005Metric | VCCIO18|GND | F | u1bulk
C95 | Device:C | 10nF | Pwr:C_0402_P1.00 | VCC_AUX25|GND | B | u1pair | A3 | A2
C96 | Device:C | 100nF | Pwr:C_0402_P1.00 | VCC_AUX25|GND | B | u1pair | E6 | F6
C97 | Device:C | 1uF | Pwr:C_0402_P1.00 | VCC_AUX25|GND | B | u1pair | W18 | Y18
C98 | Device:C | 100nF | Pwr:C_0402_P1.00 | VCCA_FPLL25|GND | B | u1pair | F4 | G4
C99 | Device:C | 100uF/6.3V | Capacitor_SMD:C_1210_3225Metric | VCC_1V1|GND | F | u1bulk
C100 | Device:C | 100uF/6.3V | Capacitor_SMD:C_1210_3225Metric | VCC_1V1|GND | F | u1bulk
C101 | Device:C | 100uF/6.3V | Capacitor_SMD:C_1210_3225Metric | VCC_1V1|GND | F | u1bulk
C102 | Device:C | 4.7uF | Capacitor_SMD:C_0603_1608Metric | VCC_1V1|GND | F | u1bulk
C103 | Device:C | 10uF | Capacitor_SMD:C_0805_2012Metric | VCCIO33|GND | F | u1bulk
C104 | Device:C | 10uF | Capacitor_SMD:C_0805_2012Metric | VCCIO18|GND | F | u1bulk
C105 | Device:C | 100nF | Capacitor_SMD:C_0402_1005Metric | VCCIO33|GND | F | pin | U3 | 7
C106 | Device:C | 100nF | Capacitor_SMD:C_0402_1005Metric | VCCIO33|GND | F | pin | U3 | 22
C107 | Device:C | 100nF | Capacitor_SMD:C_0402_1005Metric | V5|GND | F | pin | U3 | 50
C108 | Device:C | 100nF | Capacitor_SMD:C_0402_1005Metric | VREF_GTL|GND | F | pin | U3 | 35
C109 | Device:C | 100nF | Capacitor_SMD:C_0402_1005Metric | VCCIO33|GND | F | pin | U4 | 7
C110 | Device:C | 100nF | Capacitor_SMD:C_0402_1005Metric | VCCIO33|GND | F | pin | U4 | 22
C111 | Device:C | 100nF | Capacitor_SMD:C_0402_1005Metric | V5|GND | F | pin | U4 | 50
C112 | Device:C | 100nF | Capacitor_SMD:C_0402_1005Metric | VREF_GTL|GND | F | pin | U4 | 35
C113 | Device:C | 100nF | Capacitor_SMD:C_0402_1005Metric | VCCIO33|GND | F | pin | U5 | 7
C114 | Device:C | 100nF | Capacitor_SMD:C_0402_1005Metric | VCCIO33|GND | F | pin | U5 | 22
C115 | Device:C | 100nF | Capacitor_SMD:C_0402_1005Metric | V5|GND | F | pin | U5 | 50
C116 | Device:C | 100nF | Capacitor_SMD:C_0402_1005Metric | VREF_GTL|GND | F | pin | U5 | 35
C117 | Device:C | 100nF | Capacitor_SMD:C_0402_1005Metric | VCCIO33|GND | F | pin | U6 | 7
C118 | Device:C | 100nF | Capacitor_SMD:C_0402_1005Metric | VCCIO33|GND | F | pin | U6 | 22
C119 | Device:C | 100nF | Capacitor_SMD:C_0402_1005Metric | V5|GND | F | pin | U6 | 50
C120 | Device:C | 100nF | Capacitor_SMD:C_0402_1005Metric | VREF_GTL|GND | F | pin | U6 | 35
C121 | Device:C | 100nF | Capacitor_SMD:C_0402_1005Metric | VCCIO33|GND | F | pin | U7 | 7
C122 | Device:C | 100nF | Capacitor_SMD:C_0402_1005Metric | VCCIO33|GND | F | pin | U7 | 22
C123 | Device:C | 100nF | Capacitor_SMD:C_0402_1005Metric | V5|GND | F | pin | U7 | 50
C124 | Device:C | 100nF | Capacitor_SMD:C_0402_1005Metric | VREF_GTL|GND | F | pin | U7 | 35
C125 | Device:C | 100nF | Capacitor_SMD:C_0402_1005Metric | VCCIO33|GND | F | pin | U8 | 7
C126 | Device:C | 100nF | Capacitor_SMD:C_0402_1005Metric | VCCIO33|GND | F | pin | U8 | 22
C127 | Device:C | 100nF | Capacitor_SMD:C_0402_1005Metric | V5|GND | F | pin | U8 | 50
C128 | Device:C | 100nF | Capacitor_SMD:C_0402_1005Metric | VREF_GTL|GND | F | pin | U8 | 35
C129 | Device:C | 100nF | Capacitor_SMD:C_0402_1005Metric | VCCIO33|GND | F | pin | U9 | 7
C130 | Device:C | 100nF | Capacitor_SMD:C_0402_1005Metric | VCCIO33|GND | F | pin | U9 | 22
C131 | Device:C | 100nF | Capacitor_SMD:C_0402_1005Metric | V5|GND | F | pin | U9 | 50
C132 | Device:C | 100nF | Capacitor_SMD:C_0402_1005Metric | VREF_GTL|GND | F | pin | U9 | 35
C133 | Device:C | 100nF | Capacitor_SMD:C_0402_1005Metric | VCC_AUX25|GND | F | pin | U10 | 20
C134 | Device:C | 100nF | Capacitor_SMD:C_0402_1005Metric | VCC_AUX25|GND | F | pin | U11 | 20
C135 | Device:C | 100nF | Capacitor_SMD:C_0402_1005Metric | VCCIO33|GND | F | pin | U12 | 4
C136 | Device:C | 100nF | Capacitor_SMD:C_0402_1005Metric | VCCIO33|GND | F | pin | U12 | 13
C137 | Device:C | 100nF | Capacitor_SMD:C_0402_1005Metric | VCCIO33|GND | F | pin | U13 | 1
R17 | Device:R | 1.00k | Resistor_SMD:R_0402_1005Metric | VTT15|VREF_GTL | F | vref
R18 | Device:R | 2.00k | Resistor_SMD:R_0402_1005Metric | VREF_GTL|GND | F | vref
R19 | Device:R | 1.00k | Resistor_SMD:R_0402_1005Metric | VTT15|VREF_3A | F | vref | U1
R20 | Device:R | 1.78k | Resistor_SMD:R_0402_1005Metric | VREF_3A|GND | F | vref | U1
C138 | Device:C | 100nF | Capacitor_SMD:C_0402_1005Metric | VREF_3A|GND | F | vref | U1
RN1 | Device:R_Pack04 | 56R | Resistor_SMD:R_Array_Convex_4x0402 | S_BP[2]#|S_BP[3]#|S_BPM[0]#|S_PRDY#|VTT15|VTT15|VTT15|VTT15 | F | term
RN2 | Device:R_Pack04 | 56R | Resistor_SMD:R_Array_Convex_4x0402 | S_BINIT#|S_BPM[1]#|S_DEP[0]#|S_DEP[2]#|VTT15|VTT15|VTT15|VTT15 | F | term
RN3 | Device:R_Pack04 | 56R | Resistor_SMD:R_Array_Convex_4x0402 | S_DEP[1]#|S_DEP[4]#|S_DEP[3]#|S_DEP[7]#|VTT15|VTT15|VTT15|VTT15 | F | term
RN4 | Device:R_Pack04 | 56R | Resistor_SMD:R_Array_Convex_4x0402 | S_DEP[5]#|S_D[62]#|S_DEP[6]#|S_D[58]#|VTT15|VTT15|VTT15|VTT15 | F | term
RN5 | Device:R_Pack04 | 56R | Resistor_SMD:R_Array_Convex_4x0402 | S_D[61]#|S_D[63]#|S_D[55]#|S_D[56]#|VTT15|VTT15|VTT15|VTT15 | F | term
RN6 | Device:R_Pack04 | 56R | Resistor_SMD:R_Array_Convex_4x0402 | S_D[60]#|S_D[50]#|S_D[53]#|S_D[54]#|VTT15|VTT15|VTT15|VTT15 | F | term
RN7 | Device:R_Pack04 | 56R | Resistor_SMD:R_Array_Convex_4x0402 | S_D[57]#|S_D[59]#|S_D[46]#|S_D[48]#|VTT15|VTT15|VTT15|VTT15 | F | term
RN8 | Device:R_Pack04 | 56R | Resistor_SMD:R_Array_Convex_4x0402 | S_D[49]#|S_D[52]#|S_D[51]#|S_D[41]#|VTT15|VTT15|VTT15|VTT15 | F | term
RN9 | Device:R_Pack04 | 56R | Resistor_SMD:R_Array_Convex_4x0402 | S_D[42]#|S_D[47]#|S_D[45]#|S_D[44]#|VTT15|VTT15|VTT15|VTT15 | F | term
RN10 | Device:R_Pack04 | 56R | Resistor_SMD:R_Array_Convex_4x0402 | S_D[39]#|S_D[36]#|S_D[40]#|S_D[43]#|VTT15|VTT15|VTT15|VTT15 | F | term
RN11 | Device:R_Pack04 | 56R | Resistor_SMD:R_Array_Convex_4x0402 | S_D[34]#|S_D[37]#|S_D[38]#|S_D[33]#|VTT15|VTT15|VTT15|VTT15 | F | term
RN12 | Device:R_Pack04 | 56R | Resistor_SMD:R_Array_Convex_4x0402 | S_D[32]#|S_D[35]#|S_D[28]#|S_D[31]#|VTT15|VTT15|VTT15|VTT15 | F | term
RN13 | Device:R_Pack04 | 56R | Resistor_SMD:R_Array_Convex_4x0402 | S_D[29]#|S_D[30]#|S_D[26]#|S_D[27]#|VTT15|VTT15|VTT15|VTT15 | F | term
RN14 | Device:R_Pack04 | 56R | Resistor_SMD:R_Array_Convex_4x0402 | S_D[25]#|S_D[24]#|S_D[22]#|S_D[23]#|VTT15|VTT15|VTT15|VTT15 | F | term
RN15 | Device:R_Pack04 | 56R | Resistor_SMD:R_Array_Convex_4x0402 | S_D[19]#|S_D[21]#|S_D[18]#|S_D[16]#|VTT15|VTT15|VTT15|VTT15 | F | term
RN16 | Device:R_Pack04 | 56R | Resistor_SMD:R_Array_Convex_4x0402 | S_D[20]#|S_D[13]#|S_D[17]#|S_D[11]#|VTT15|VTT15|VTT15|VTT15 | F | term
RN17 | Device:R_Pack04 | 56R | Resistor_SMD:R_Array_Convex_4x0402 | S_D[15]#|S_D[10]#|S_D[12]#|S_D[14]#|VTT15|VTT15|VTT15|VTT15 | F | term
RN18 | Device:R_Pack04 | 56R | Resistor_SMD:R_Array_Convex_4x0402 | S_D[7]#|S_D[9]#|S_D[6]#|S_D[8]#|VTT15|VTT15|VTT15|VTT15 | F | term
RN19 | Device:R_Pack04 | 56R | Resistor_SMD:R_Array_Convex_4x0402 | S_D[4]#|S_D[5]#|S_D[2]#|S_D[3]#|VTT15|VTT15|VTT15|VTT15 | F | term
RN20 | Device:R_Pack04 | 56R | Resistor_SMD:R_Array_Convex_4x0402 | S_D[0]#|S_D[1]#|S_BR1#|S_BR0#|VTT15|VTT15|VTT15|VTT15 | F | term
RN21 | Device:R_Pack04 | 56R | Resistor_SMD:R_Array_Convex_4x0402 | S_BERR#|S_A[35]#|S_A[33]#|S_A[32]#|VTT15|VTT15|VTT15|VTT15 | F | term
RN22 | Device:R_Pack04 | 56R | Resistor_SMD:R_Array_Convex_4x0402 | S_A[34]#|S_A[29]#|S_A[30]#|S_A[26]#|VTT15|VTT15|VTT15|VTT15 | F | term
RN23 | Device:R_Pack04 | 56R | Resistor_SMD:R_Array_Convex_4x0402 | S_A[31]#|S_A[24]#|S_A[27]#|S_A[28]#|VTT15|VTT15|VTT15|VTT15 | F | term
RN24 | Device:R_Pack04 | 56R | Resistor_SMD:R_Array_Convex_4x0402 | S_A[22]#|S_A[20]#|S_A[23]#|S_A[21]#|VTT15|VTT15|VTT15|VTT15 | F | term
RN25 | Device:R_Pack04 | 56R | Resistor_SMD:R_Array_Convex_4x0402 | S_A[25]#|S_A[19]#|S_A[15]#|S_A[18]#|VTT15|VTT15|VTT15|VTT15 | F | term
RN26 | Device:R_Pack04 | 56R | Resistor_SMD:R_Array_Convex_4x0402 | S_A[17]#|S_A[16]#|S_A[11]#|S_A[13]#|VTT15|VTT15|VTT15|VTT15 | F | term
RN27 | Device:R_Pack04 | 56R | Resistor_SMD:R_Array_Convex_4x0402 | S_A[12]#|S_A[14]#|S_A[8]#|S_A[10]#|VTT15|VTT15|VTT15|VTT15 | F | term
RN28 | Device:R_Pack04 | 56R | Resistor_SMD:R_Array_Convex_4x0402 | S_A[7]#|S_A[5]#|S_A[3]#|S_A[9]#|VTT15|VTT15|VTT15|VTT15 | F | term
RN29 | Device:R_Pack04 | 56R | Resistor_SMD:R_Array_Convex_4x0402 | S_A[6]#|S_A[4]#|S_BNR#|S_REQ[0]#|VTT15|VTT15|VTT15|VTT15 | F | term
RN30 | Device:R_Pack04 | 56R | Resistor_SMD:R_Array_Convex_4x0402 | S_BPRI#|S_REQ[1]#|S_TRDY#|S_REQ[4]#|VTT15|VTT15|VTT15|VTT15 | F | term
RN31 | Device:R_Pack04 | 56R | Resistor_SMD:R_Array_Convex_4x0402 | S_DEFER#|S_LOCK#|S_REQ[2]#|S_DRDY#|VTT15|VTT15|VTT15|VTT15 | F | term
RN32 | Device:R_Pack04 | 56R | Resistor_SMD:R_Array_Convex_4x0402 | S_REQ[3]#|S_RS[0]#|S_HITM#|S_HIT#|VTT15|VTT15|VTT15|VTT15 | F | term
RN33 | Device:R_Pack04 | 56R | Resistor_SMD:R_Array_Convex_4x0402 | S_DBSY#|S_RS[2]#|S_RS[1]#|S_RP#|VTT15|VTT15|VTT15|VTT15 | F | term
RN34 | Device:R_Pack04 | 56R | Resistor_SMD:R_Array_Convex_4x0402 | S_ADS#|S_RSP#|S_AP[1]#|S_AP[0]#|VTT15|VTT15|VTT15|VTT15 | F | term
RN35 | Device:R_Pack04 | 56R | Resistor_SMD:R_Array_Convex_4x0402 | S_AERR#|NC_RN35_2|NC_RN35_3|NC_RN35_4|VTT15|VTT15|VTT15|VTT15 | F | term
C139 | Device:C | 22uF | Capacitor_SMD:C_0805_2012Metric | VTT15|GND | F | term
C140 | Device:C | 22uF | Capacitor_SMD:C_0805_2012Metric | VTT15|GND | F | term
C141 | Device:C | 100nF | Capacitor_SMD:C_0402_1005Metric | VTT15|GND | F | term
C142 | Device:C | 100nF | Capacitor_SMD:C_0402_1005Metric | VTT15|GND | F | term
C143 | Device:C | 100nF | Capacitor_SMD:C_0402_1005Metric | VTT15|GND | F | term
C144 | Device:C | 100nF | Capacitor_SMD:C_0402_1005Metric | VTT15|GND | F | term
C145 | Device:C | 100nF | Capacitor_SMD:C_0402_1005Metric | VTT15|GND | F | term
C146 | Device:C | 100nF | Capacitor_SMD:C_0402_1005Metric | VTT15|GND | F | term
R21 | Device:R | 0R | Resistor_SMD:R_0402_1005Metric | S_VID1|GND | F | strap | U2
R22 | Device:R | 0R | Resistor_SMD:R_0402_1005Metric | S_VID2|GND | F | strap | U2
R23 | Device:R | 0R | Resistor_SMD:R_0402_1005Metric | S_VID3|GND | F | strap | U2
R24 | Device:R | 0R | Resistor_SMD:R_0402_1005Metric | S_VID4|GND | F | strap | U2
R25 | Device:R | 10k | Resistor_SMD:R_0402_1005Metric | ADDR_OEAB#|VCCIO33 | F | pullup
R26 | Device:R | 10k | Resistor_SMD:R_0402_1005Metric | ADDR_OEBA#|VCCIO33 | F | pullup
R27 | Device:R | 10k | Resistor_SMD:R_0402_1005Metric | DATA_OEAB#|VCCIO33 | F | pullup
R28 | Device:R | 10k | Resistor_SMD:R_0402_1005Metric | DATA_OEBA#|VCCIO33 | F | pullup
R29 | Device:R | 10k | Resistor_SMD:R_0402_1005Metric | TX_OEAB#|VCCIO33 | F | pullup
R30 | Device:R | 10k | Resistor_SMD:R_0402_1005Metric | CFG_nCONFIG|VCCIO33 | F | pullup | U1
R31 | Device:R | 10k | Resistor_SMD:R_0402_1005Metric | CFG_nSTATUS|VCCIO33 | F | pullup | U1
R32 | Device:R | 10k | Resistor_SMD:R_0402_1005Metric | CFG_CONF_DONE|VCCIO33 | F | pullup | U1
R33 | Device:R | 1k | Resistor_SMD:R_0402_1005Metric | F_TCK|GND | F | pullup | U1
R34 | Device:R | 10k | Resistor_SMD:R_0402_1005Metric | F_TMS|VCC_AUX25 | F | pullup | U1
R35 | Device:R | 10k | Resistor_SMD:R_0402_1005Metric | F_TDI|VCC_AUX25 | F | pullup | U1
R36 | Device:R | 2.00k 1% | Resistor_SMD:R_0402_1005Metric | RREF_TL|GND | F | pullup | U1
R37 | Device:R | 22R | Resistor_SMD:R_0402_1005Metric | ZCLK_ADDR0|CLK_ADDR0 | F | clk | U12
R38 | Device:R | 22R | Resistor_SMD:R_0402_1005Metric | ZCLK_ADDR1|CLK_ADDR1 | F | clk | U12
R39 | Device:R | 22R | Resistor_SMD:R_0402_1005Metric | ZCLK_DATA0|CLK_DATA0 | F | clk | U12
R40 | Device:R | 22R | Resistor_SMD:R_0402_1005Metric | ZCLK_DATA1|CLK_DATA1 | F | clk | U12
R41 | Device:R | 22R | Resistor_SMD:R_0402_1005Metric | ZCLK_DATA2|CLK_DATA2 | F | clk | U12
R42 | Device:R | 22R | Resistor_SMD:R_0402_1005Metric | ZCLK_DATA3|CLK_DATA3 | F | clk | U12
R43 | Device:R | 22R | Resistor_SMD:R_0402_1005Metric | ZCLK_TX|CLK_TX | F | clk | U12
R44 | Device:R | 22R | Resistor_SMD:R_0402_1005Metric | ZCLK_FB|CLK_FB | F | clk | U12
C147 | Device:C | 10pF | Capacitor_SMD:C_0402_1005Metric | CLK_FB|GND | F | clk | U12
