alphaonex86/FPGA-CPU/hw/socket370-ti180/assignment_efinity.csv

io_name | pin | mode | io_standard
D29# | M15 | bidir | 1.8 V LVCMOS
D28# | N15 | bidir | 1.8 V LVCMOS
D43# | A16 | bidir | 1.8 V LVCMOS
D37# | A17 | bidir | 1.8 V LVCMOS
D44# | A18 | bidir | 1.8 V LVCMOS
D51# | A2 | bidir | 1.8 V LVCMOS
D47# | A19 | bidir | 1.8 V LVCMOS
D48# | A3 | bidir | 1.8 V LVCMOS
D57# | A4 | bidir | 1.8 V LVCMOS
D46# | B16 | bidir | 1.8 V LVCMOS
D53# | B2 | bidir | 1.8 V LVCMOS
D60# | B4 | bidir | 1.8 V LVCMOS
D61# | B5 | bidir | 1.8 V LVCMOS
DEP7# | K18 | bidir | 1.8 V LVCMOS
DEP3# | K19 | bidir | 1.8 V LVCMOS
DEP2# | K20 | bidir | 1.8 V LVCMOS
PRDY# | E3 | output | 3.3 V LVCMOS
D35# | B17 | bidir | 1.8 V LVCMOS
BINIT# | M5 | bidir | 1.8 V LVCMOS
D33# | B19 | bidir | 1.8 V LVCMOS
D31# | P15 | bidir | 1.8 V LVCMOS
D34# | B20 | bidir | 1.8 V LVCMOS
D36# | C15 | bidir | 1.8 V LVCMOS
D45# | C17 | bidir | 1.8 V LVCMOS
D49# | C3 | bidir | 1.8 V LVCMOS
D40# | C18 | bidir | 1.8 V LVCMOS
D59# | C4 | bidir | 1.8 V LVCMOS
D55# | C5 | bidir | 1.8 V LVCMOS
D54# | D5 | bidir | 1.8 V LVCMOS
D58# | D6 | bidir | 1.8 V LVCMOS
D50# | D7 | bidir | 1.8 V LVCMOS
D56# | D8 | bidir | 1.8 V LVCMOS
DEP5# | L16 | bidir | 1.8 V LVCMOS
DEP1# | L18 | bidir | 1.8 V LVCMOS
DEP0# | T19 | bidir | 1.8 V LVCMOS
BPM0# | E16 | bidir | 3.3 V LVCMOS
CPUPRES# | P14 | output | 2.5 V LVCMOS
D38# | C19 | bidir | 1.8 V LVCMOS
D39# | D15 | bidir | 1.8 V LVCMOS
D42# | D16 | bidir | 1.8 V LVCMOS
D41# | E13 | bidir | 1.8 V LVCMOS
D52# | E6 | bidir | 1.8 V LVCMOS
D26# | P16 | bidir | 1.8 V LVCMOS
D25# | P17 | bidir | 1.8 V LVCMOS
D62# | E8 | bidir | 1.8 V LVCMOS
SLEWCTRL | T11 | input | 2.5 V LVCMOS
DEP6# | U20 | bidir | 1.8 V LVCMOS
DEP4# | E9 | bidir | 1.8 V LVCMOS
BPM1# | F14 | bidir | 3.3 V LVCMOS
BP3# | F16 | bidir | 3.3 V LVCMOS
D32# | E14 | bidir | 1.8 V LVCMOS
D22# | R16 | bidir | 1.8 V LVCMOS
D27# | T16 | bidir | 1.8 V LVCMOS
D63# | F7 | bidir | 1.8 V LVCMOS
D21# | T17 | bidir | 1.8 V LVCMOS
D23# | T18 | bidir | 1.8 V LVCMOS
BP2# | F17 | bidir | 3.3 V LVCMOS
D16# | U17 | bidir | 1.8 V LVCMOS
D19# | U19 | bidir | 1.8 V LVCMOS
D7# | C20 | bidir | 1.8 V LVCMOS
D30# | V18 | bidir | 1.8 V LVCMOS
PICCLK | T12 | input | 2.5 V LVCMOS
PICD0 | T13 | bidir | 2.5 V LVCMOS
PREQ# | E4 | input | 3.3 V LVCMOS
D24# | V19 | bidir | 1.8 V LVCMOS
D13# | D18 | bidir | 1.8 V LVCMOS
D20# | V20 | bidir | 1.8 V LVCMOS
PICD1 | T14 | bidir | 2.5 V LVCMOS
LINT1 | D20 | input | 1.8 V LVCMOS
D11# | E18 | bidir | 1.8 V LVCMOS
D3# | E19 | bidir | 1.8 V LVCMOS
LINT0 | E20 | input | 1.8 V LVCMOS
D2# | F18 | bidir | 1.8 V LVCMOS
D14# | F19 | bidir | 1.8 V LVCMOS
D18# | W17 | bidir | 1.8 V LVCMOS
D9# | G17 | bidir | 1.8 V LVCMOS
D12# | G19 | bidir | 1.8 V LVCMOS
D10# | G20 | bidir | 1.8 V LVCMOS
D17# | W18 | bidir | 1.8 V LVCMOS
D8# | H17 | bidir | 1.8 V LVCMOS
D5# | H18 | bidir | 1.8 V LVCMOS
RTTCTRL | U11 | input | 2.5 V LVCMOS
D1# | H19 | bidir | 1.8 V LVCMOS
D6# | H20 | bidir | 1.8 V LVCMOS
D4# | J16 | bidir | 1.8 V LVCMOS
D15# | J17 | bidir | 1.8 V LVCMOS
BERR# | B1 | bidir | 1.8 V LVCMOS
D0# | J18 | bidir | 1.8 V LVCMOS
A34# | P9 | bidir | 3.3 V LVCMOS
BCLK | P11 | input | 2.5 V LVCMOS
BR1# | R3 | input | 1.8 V LVCMOS
A32# | R8 | bidir | 3.3 V LVCMOS
A26# | R10 | bidir | 3.3 V LVCMOS
A29# | T8 | bidir | 3.3 V LVCMOS
A18# | U6 | bidir | 3.3 V LVCMOS
A27# | U8 | bidir | 3.3 V LVCMOS
A30# | U9 | bidir | 3.3 V LVCMOS
A24# | V6 | bidir | 3.3 V LVCMOS
A23# | V7 | bidir | 3.3 V LVCMOS
A33# | V9 | bidir | 3.3 V LVCMOS
A20# | V10 | bidir | 3.3 V LVCMOS
RSP# | N5 | input | 1.8 V LVCMOS
A31# | V11 | bidir | 3.3 V LVCMOS
A17# | W6 | bidir | 3.3 V LVCMOS
A22# | W7 | bidir | 3.3 V LVCMOS
A20M# | J20 | input | 1.8 V LVCMOS
FLUSH# | W20 | input | 1.8 V LVCMOS
A35# | U12 | bidir | 2.5 V LVCMOS
A25# | W8 | bidir | 3.3 V LVCMOS
A19# | W10 | bidir | 3.3 V LVCMOS
INIT# | Y18 | input | 1.8 V LVCMOS
STPCLK# | Y19 | input | 1.8 V LVCMOS
IGNNE# | E15 | input | 1.8 V LVCMOS
RESET# | C2 | input | 1.8 V LVCMOS
A10# | A6 | bidir | 1.8 V LVCMOS
A5# | A7 | bidir | 1.8 V LVCMOS
A8# | A14 | bidir | 1.8 V LVCMOS
A4# | B7 | bidir | 1.8 V LVCMOS
BNR# | K3 | bidir | 1.8 V LVCMOS
REQ1# | U13 | bidir | 2.5 V LVCMOS
REQ2# | U15 | bidir | 2.5 V LVCMOS
RS1# | R4 | input | 1.8 V LVCMOS
RS0# | R5 | input | 1.8 V LVCMOS
SLP# | G14 | input | 3.3 V LVCMOS
A21# | Y8 | bidir | 3.3 V LVCMOS
BSEL1 | U16 | output | 2.5 V LVCMOS
BSEL0 | V13 | output | 2.5 V LVCMOS
SMI# | F12 | input | 1.8 V LVCMOS
VID3 | V14 | output | 2.5 V LVCMOS
A28# | Y9 | bidir | 3.3 V LVCMOS
A3# | B9 | bidir | 1.8 V LVCMOS
A11# | B14 | bidir | 1.8 V LVCMOS
A14# | B15 | bidir | 1.8 V LVCMOS
REQ0# | V15 | bidir | 2.5 V LVCMOS
LOCK# | V16 | bidir | 2.5 V LVCMOS
AERR# | E5 | bidir | 3.3 V LVCMOS
PWRGOOD | F13 | input | 1.8 V LVCMOS
RS2# | U5 | input | 1.8 V LVCMOS
TMS | F4 | input | 3.3 V LVCMOS
A15# | C7 | bidir | 1.8 V LVCMOS
A13# | C8 | bidir | 1.8 V LVCMOS
A9# | C9 | bidir | 1.8 V LVCMOS
AP0# | G15 | bidir | 3.3 V LVCMOS
A7# | C13 | bidir | 1.8 V LVCMOS
REQ4# | W11 | bidir | 2.5 V LVCMOS
REQ3# | W12 | bidir | 2.5 V LVCMOS
HITM# | W13 | bidir | 2.5 V LVCMOS
HIT# | W14 | bidir | 2.5 V LVCMOS
DBSY# | V3 | bidir | 1.8 V LVCMOS
TCK | F6 | input | 3.3 V LVCMOS
VID0 | W16 | output | 2.5 V LVCMOS
VID2 | Y11 | output | 2.5 V LVCMOS
VID1 | Y13 | output | 2.5 V LVCMOS
A12# | C14 | bidir | 1.8 V LVCMOS
A16# | Y10 | bidir | 3.3 V LVCMOS
A6# | F8 | bidir | 1.8 V LVCMOS
AP1# | G16 | bidir | 3.3 V LVCMOS
BPRI# | V4 | input | 1.8 V LVCMOS
DEFER# | W3 | input | 1.8 V LVCMOS
RP# | H14 | bidir | 3.3 V LVCMOS
TRDY# | Y2 | input | 1.8 V LVCMOS
DRDY# | Y5 | bidir | 1.8 V LVCMOS
BR0# | G5 | bidir | 3.3 V LVCMOS
ADS# | F9 | bidir | 1.8 V LVCMOS
TRST# | G6 | input | 3.3 V LVCMOS
TDI | G7 | input | 3.3 V LVCMOS
TDO | H7 | output | 3.3 V LVCMOS
