alphaonex86/FPGA-CPU/FPGAlist/c2_cards/xilinx/xc7a100t_fgg484.csv

ball | bank | function | config | vref | clock | pair | user_io
A1 | 35 | IO_L1N_T0_AD4N_35 |  |  |  | L1N | 1
A2 |  | GND |  |  |  |  | 0
A3 |  | GND |  |  |  |  | 0
A4 | 216 | MGTPTXN0_216 |  |  |  |  | 0
A5 |  | GND |  |  |  |  | 0
A6 | 216 | MGTPTXN2_216 |  |  |  |  | 0
A7 |  | GND |  |  |  |  | 0
A8 | 216 | MGTPRXN0_216 |  |  |  |  | 0
A9 |  | GND |  |  |  |  | 0
A10 | 216 | MGTPRXN2_216 |  |  |  |  | 0
A11 |  | GND |  |  |  |  | 0
A12 |  | GND |  |  |  |  | 0
A13 | 16 | IO_L10P_T1_16 |  |  |  | L10P | 1
A14 | 16 | IO_L10N_T1_16 |  |  |  | L10N | 1
A15 | 16 | IO_L9P_T1_DQS_16 |  |  |  | L9P | 1
A16 | 16 | IO_L9N_T1_DQS_16 |  |  |  | L9N | 1
A17 | 16 | VCCO_16 |  |  |  |  | 0
A18 | 16 | IO_L17P_T2_16 |  |  |  | L17P | 1
A19 | 16 | IO_L17N_T2_16 |  |  |  | L17N | 1
A20 | 16 | IO_L16N_T2_16 |  |  |  | L16N | 1
A21 | 16 | IO_L21N_T3_DQS_16 |  |  |  | L21N | 1
A22 |  | GND |  |  |  |  | 0
B1 | 35 | IO_L1P_T0_AD4P_35 |  |  |  | L1P | 1
B2 | 35 | IO_L2N_T0_AD12N_35 |  |  |  | L2N | 1
B3 |  | GND |  |  |  |  | 0
B4 | 216 | MGTPTXP0_216 |  |  |  |  | 0
B5 |  | MGTAVTT |  |  |  |  | 0
B6 | 216 | MGTPTXP2_216 |  |  |  |  | 0
B7 |  | MGTAVTT |  |  |  |  | 0
B8 | 216 | MGTPRXP0_216 |  |  |  |  | 0
B9 |  | MGTAVTT |  |  |  |  | 0
B10 | 216 | MGTPRXP2_216 |  |  |  |  | 0
B11 |  | MGTAVTT |  |  |  |  | 0
B12 |  | GND |  |  |  |  | 0
B13 | 16 | IO_L8N_T1_16 |  |  |  | L8N | 1
B14 | 16 | VCCO_16 |  |  |  |  | 0
B15 | 16 | IO_L7P_T1_16 |  |  |  | L7P | 1
B16 | 16 | IO_L7N_T1_16 |  |  |  | L7N | 1
B17 | 16 | IO_L11P_T1_SRCC_16 |  |  | SRCC | L11P | 1
B18 | 16 | IO_L11N_T1_SRCC_16 |  |  | SRCC | L11N | 1
B19 |  | GND |  |  |  |  | 0
B20 | 16 | IO_L16P_T2_16 |  |  |  | L16P | 1
B21 | 16 | IO_L21P_T3_DQS_16 |  |  |  | L21P | 1
B22 | 16 | IO_L20N_T3_16 |  |  |  | L20N | 1
C1 | 35 | VCCO_35 |  |  |  |  | 0
C2 | 35 | IO_L2P_T0_AD12P_35 |  |  |  | L2P | 1
C3 |  | GND |  |  |  |  | 0
C4 |  | MGTAVTT |  |  |  |  | 0
C5 | 216 | MGTPTXN1_216 |  |  |  |  | 0
C6 |  | GND |  |  |  |  | 0
C7 | 216 | MGTPTXN3_216 |  |  |  |  | 0
C8 |  | MGTAVTT |  |  |  |  | 0
C9 | 216 | MGTPRXN3_216 |  |  |  |  | 0
C10 |  | GND |  |  |  |  | 0
C11 | 216 | MGTPRXN1_216 |  |  |  |  | 0
C12 |  | GND |  |  |  |  | 0
C13 | 16 | IO_L8P_T1_16 |  |  |  | L8P | 1
C14 | 16 | IO_L3P_T0_DQS_16 |  |  |  | L3P | 1
C15 | 16 | IO_L3N_T0_DQS_16 |  |  |  | L3N | 1
C16 |  | GND |  |  |  |  | 0
C17 | 16 | IO_L12N_T1_MRCC_16 |  |  | MRCC | L12N | 1
C18 | 16 | IO_L13P_T2_MRCC_16 |  |  | MRCC | L13P | 1
C19 | 16 | IO_L13N_T2_MRCC_16 |  |  | MRCC | L13N | 1
C20 | 16 | IO_L19N_T3_VREF_16 |  | VREF |  | L19N | 1
C21 | 16 | VCCO_16 |  |  |  |  | 0
C22 | 16 | IO_L20P_T3_16 |  |  |  | L20P | 1
D1 | 35 | IO_L3N_T0_DQS_AD5N_35 |  |  |  | L3N | 1
D2 | 35 | IO_L4N_T0_35 |  |  |  | L4N | 1
D3 |  | GND |  |  |  |  | 0
D4 |  | GND |  |  |  |  | 0
D5 | 216 | MGTPTXP1_216 |  |  |  |  | 0
D6 |  | MGTAVCC |  |  |  |  | 0
D7 | 216 | MGTPTXP3_216 |  |  |  |  | 0
D8 |  | GND |  |  |  |  | 0
D9 | 216 | MGTPRXP3_216 |  |  |  |  | 0
D10 |  | MGTAVCC |  |  |  |  | 0
D11 | 216 | MGTPRXP1_216 |  |  |  |  | 0
D12 |  | GND |  |  |  |  | 0
D13 |  | GND |  |  |  |  | 0
D14 | 16 | IO_L6P_T0_16 |  |  |  | L6P | 1
D15 | 16 | IO_L6N_T0_VREF_16 |  | VREF |  | L6N | 1
D16 | 16 | IO_L5N_T0_16 |  |  |  | L5N | 1
D17 | 16 | IO_L12P_T1_MRCC_16 |  |  | MRCC | L12P | 1
D18 | 16 | VCCO_16 |  |  |  |  | 0
D19 | 16 | IO_L14N_T2_SRCC_16 |  |  | SRCC | L14N | 1
D20 | 16 | IO_L19P_T3_16 |  |  |  | L19P | 1
D21 | 16 | IO_L23N_T3_16 |  |  |  | L23N | 1
D22 | 16 | IO_L22N_T3_16 |  |  |  | L22N | 1
E1 | 35 | IO_L3P_T0_DQS_AD5P_35 |  |  |  | L3P | 1
E2 | 35 | IO_L4P_T0_35 |  |  |  | L4P | 1
E3 | 35 | IO_L6N_T0_VREF_35 |  | VREF |  | L6N | 1
E4 |  | GND |  |  |  |  | 0
E5 |  | GND |  |  |  |  | 0
E6 | 216 | MGTREFCLK0N_216 |  |  |  |  | 0
E7 |  | GND |  |  |  |  | 0
E8 |  | MGTAVCC |  |  |  |  | 0
E9 |  | GND |  |  |  |  | 0
E10 | 216 | MGTREFCLK1N_216 |  |  |  |  | 0
E11 |  | GND |  |  |  |  | 0
E12 | 0 | VCCBATT_0 | VCCBATT_0 |  |  |  | 0
E13 | 16 | IO_L4P_T0_16 |  |  |  | L4P | 1
E14 | 16 | IO_L4N_T0_16 |  |  |  | L4N | 1
E15 | 16 | VCCO_16 |  |  |  |  | 0
E16 | 16 | IO_L5P_T0_16 |  |  |  | L5P | 1
E17 | 16 | IO_L2N_T0_16 |  |  |  | L2N | 1
E18 | 16 | IO_L15N_T2_DQS_16 |  |  |  | L15N | 1
E19 | 16 | IO_L14P_T2_SRCC_16 |  |  | SRCC | L14P | 1
E20 |  | GND |  |  |  |  | 0
E21 | 16 | IO_L23P_T3_16 |  |  |  | L23P | 1
E22 | 16 | IO_L22P_T3_16 |  |  |  | L22P | 1
F1 | 35 | IO_L5N_T0_AD13N_35 |  |  |  | L5N | 1
F2 | 35 | VCCO_35 |  |  |  |  | 0
F3 | 35 | IO_L6P_T0_35 |  |  |  | L6P | 1
F4 | 35 | IO_0_35 |  |  |  |  | 1
F5 |  | GND |  |  |  |  | 0
F6 | 216 | MGTREFCLK0P_216 |  |  |  |  | 0
F7 |  | MGTAVCC |  |  |  |  | 0
F8 | 216 | MGTRREF_216 |  |  |  |  | 0
F9 |  | MGTAVCC |  |  |  |  | 0
F10 | 216 | MGTREFCLK1P_216 |  |  |  |  | 0
F11 |  | GND |  |  |  |  | 0
F12 | 0 | VCCO_0 |  |  |  |  | 0
F13 | 16 | IO_L1P_T0_16 |  |  |  | L1P | 1
F14 | 16 | IO_L1N_T0_16 |  |  |  | L1N | 1
F15 | 16 | IO_0_16 |  |  |  |  | 1
F16 | 16 | IO_L2P_T0_16 |  |  |  | L2P | 1
F17 |  | GND |  |  |  |  | 0
F18 | 16 | IO_L15P_T2_DQS_16 |  |  |  | L15P | 1
F19 | 16 | IO_L18P_T2_16 |  |  |  | L18P | 1
F20 | 16 | IO_L18N_T2_16 |  |  |  | L18N | 1
F21 | 16 | IO_25_16 |  |  |  |  | 1
F22 | 16 | VCCO_16 |  |  |  |  | 0
G1 | 35 | IO_L5P_T0_AD13P_35 |  |  |  | L5P | 1
G2 | 35 | IO_L8N_T1_AD14N_35 |  |  |  | L8N | 1
G3 | 35 | IO_L11N_T1_SRCC_35 |  |  | SRCC | L11N | 1
G4 | 35 | IO_L12N_T1_MRCC_35 |  |  | MRCC | L12N | 1
G5 |  | GND |  |  |  |  | 0
G6 |  | GND |  |  |  |  | 0
G7 |  | GND |  |  |  |  | 0
G8 |  | GND |  |  |  |  | 0
G9 |  | GND |  |  |  |  | 0
G10 |  | GND |  |  |  |  | 0
G11 | 0 | DONE_0 | DONE_0 |  |  |  | 0
G12 |  | GND |  |  |  |  | 0
G13 | 15 | IO_L1N_T0_AD0N_15 |  |  |  | L1N | 1
G14 |  | GND |  |  |  |  | 0
G15 | 15 | IO_L2P_T0_AD8P_15 |  |  |  | L2P | 1
G16 | 15 | IO_L2N_T0_AD8N_15 |  |  |  | L2N | 1
G17 | 15 | IO_L4P_T0_15 |  |  |  | L4P | 1
G18 | 15 | IO_L4N_T0_15 |  |  |  | L4N | 1
G19 | 15 | VCCO_15 |  |  |  |  | 0
G20 | 15 | IO_L8N_T1_AD10N_15 |  |  |  | L8N | 1
G21 | 16 | IO_L24P_T3_16 |  |  |  | L24P | 1
G22 | 16 | IO_L24N_T3_16 |  |  |  | L24N | 1
H1 |  | GND |  |  |  |  | 0
H2 | 35 | IO_L8P_T1_AD14P_35 |  |  |  | L8P | 1
H3 | 35 | IO_L11P_T1_SRCC_35 |  |  | SRCC | L11P | 1
H4 | 35 | IO_L12P_T1_MRCC_35 |  |  | MRCC | L12P | 1
H5 | 35 | IO_L10N_T1_AD15N_35 |  |  |  | L10N | 1
H6 | 35 | VCCO_35 |  |  |  |  | 0
H7 |  | GND |  |  |  |  | 0
H8 |  | VCCINT |  |  |  |  | 0
H9 |  | GND |  |  |  |  | 0
H10 |  | VCCINT |  |  |  |  | 0
H11 |  | GND |  |  |  |  | 0
H12 |  | VCCAUX |  |  |  |  | 0
H13 | 15 | IO_L1P_T0_AD0P_15 |  |  |  | L1P | 1
H14 | 15 | IO_L3N_T0_DQS_AD1N_15 |  |  |  | L3N | 1
H15 | 15 | IO_L5N_T0_AD9N_15 |  |  |  | L5N | 1
H16 | 15 | VCCO_15 |  |  |  |  | 0
H17 | 15 | IO_L6P_T0_15 |  |  |  | L6P | 1
H18 | 15 | IO_L6N_T0_VREF_15 |  | VREF |  | L6N | 1
H19 | 15 | IO_L12N_T1_MRCC_15 |  |  | MRCC | L12N | 1
H20 | 15 | IO_L8P_T1_AD10P_15 |  |  |  | L8P | 1
H21 |  | GND |  |  |  |  | 0
H22 | 15 | IO_L7N_T1_AD2N_15 |  |  |  | L7N | 1
J1 | 35 | IO_L7N_T1_AD6N_35 |  |  |  | L7N | 1
J2 | 35 | IO_L9N_T1_DQS_AD7N_35 |  |  |  | L9N | 1
J3 | 35 | VCCO_35 |  |  |  |  | 0
J4 | 35 | IO_L13N_T2_MRCC_35 |  |  | MRCC | L13N | 1
J5 | 35 | IO_L10P_T1_AD15P_35 |  |  |  | L10P | 1
J6 | 35 | IO_L17N_T2_35 |  |  |  | L17N | 1
J7 |  | VCCINT |  |  |  |  | 0
J8 |  | GND |  |  |  |  | 0
J9 |  | VCCINT |  |  |  |  | 0
J10 |  | GND |  |  |  |  | 0
J11 |  | VCCBRAM |  |  |  |  | 0
J12 |  | GND |  |  |  |  | 0
J13 | 15 | VCCO_15 |  |  |  |  | 0
J14 | 15 | IO_L3P_T0_DQS_AD1P_15 |  |  |  | L3P | 1
J15 | 15 | IO_L5P_T0_AD9P_15 |  |  |  | L5P | 1
J16 | 15 | IO_0_15 |  |  |  |  | 1
J17 | 15 | IO_L21N_T3_DQS_A18_15 |  |  |  | L21N | 1
J18 |  | GND |  |  |  |  | 0
J19 | 15 | IO_L12P_T1_MRCC_15 |  |  | MRCC | L12P | 1
J20 | 15 | IO_L11P_T1_SRCC_15 |  |  | SRCC | L11P | 1
J21 | 15 | IO_L11N_T1_SRCC_15 |  |  | SRCC | L11N | 1
J22 | 15 | IO_L7P_T1_AD2P_15 |  |  |  | L7P | 1
K1 | 35 | IO_L7P_T1_AD6P_35 |  |  |  | L7P | 1
K2 | 35 | IO_L9P_T1_DQS_AD7P_35 |  |  |  | L9P | 1
K3 | 35 | IO_L14N_T2_SRCC_35 |  |  | SRCC | L14N | 1
K4 | 35 | IO_L13P_T2_MRCC_35 |  |  | MRCC | L13P | 1
K5 |  | GND |  |  |  |  | 0
K6 | 35 | IO_L17P_T2_35 |  |  |  | L17P | 1
K7 |  | GND |  |  |  |  | 0
K8 |  | VCCINT |  |  |  |  | 0
K9 | 0 | GNDADC_0 | GNDADC_0 |  |  |  | 0
K10 | 0 | VCCADC_0 | VCCADC_0 |  |  |  | 0
K11 |  | GND |  |  |  |  | 0
K12 |  | VCCAUX |  |  |  |  | 0
K13 | 15 | IO_L19P_T3_A22_15 |  |  |  | L19P | 1
K14 | 15 | IO_L19N_T3_A21_VREF_15 |  | VREF |  | L19N | 1
K15 |  | GND |  |  |  |  | 0
K16 | 15 | IO_L23N_T3_FWE_B_15 |  |  |  | L23N | 1
K17 | 15 | IO_L21P_T3_DQS_15 |  |  |  | L21P | 1
K18 | 15 | IO_L13P_T2_MRCC_15 |  |  | MRCC | L13P | 1
K19 | 15 | IO_L13N_T2_MRCC_15 |  |  | MRCC | L13N | 1
K20 | 15 | VCCO_15 |  |  |  |  | 0
K21 | 15 | IO_L9P_T1_DQS_AD3P_15 |  |  |  | L9P | 1
K22 | 15 | IO_L9N_T1_DQS_AD3N_15 |  |  |  | L9N | 1
L1 | 35 | IO_L15N_T2_DQS_35 |  |  |  | L15N | 1
L2 |  | GND |  |  |  |  | 0
L3 | 35 | IO_L14P_T2_SRCC_35 |  |  | SRCC | L14P | 1
L4 | 35 | IO_L18N_T2_35 |  |  |  | L18N | 1
L5 | 35 | IO_L18P_T2_35 |  |  |  | L18P | 1
L6 | 35 | IO_25_35 |  |  |  |  | 1
L7 |  | VCCINT |  |  |  |  | 0
L8 |  | GND |  |  |  |  | 0
L9 | 0 | VREFN_0 | VREFN_0 |  |  |  | 0
L10 | 0 | VP_0 | VP_0 |  |  |  | 0
L11 |  | VCCBRAM |  |  |  |  | 0
L12 | 0 | CCLK_0 | CCLK_0 |  |  |  | 0
L13 | 15 | IO_L20N_T3_A19_15 |  |  |  | L20N | 1
L14 | 15 | IO_L22P_T3_A17_15 |  |  |  | L22P | 1
L15 | 15 | IO_L22N_T3_A16_15 |  |  |  | L22N | 1
L16 | 15 | IO_L23P_T3_FOE_B_15 |  |  |  | L23P | 1
L17 | 15 | VCCO_15 |  |  |  |  | 0
L18 | 15 | IO_L16N_T2_A27_15 |  |  |  | L16N | 1
L19 | 15 | IO_L14P_T2_SRCC_15 |  |  | SRCC | L14P | 1
L20 | 15 | IO_L14N_T2_SRCC_15 |  |  | SRCC | L14N | 1
L21 | 15 | IO_L10N_T1_AD11N_15 |  |  |  | L10N | 1
L22 |  | GND |  |  |  |  | 0
M1 | 35 | IO_L15P_T2_DQS_35 |  |  |  | L15P | 1
M2 | 35 | IO_L16N_T2_35 |  |  |  | L16N | 1
M3 | 35 | IO_L16P_T2_35 |  |  |  | L16P | 1
M4 | 35 | VCCO_35 |  |  |  |  | 0
M5 | 35 | IO_L23N_T3_35 |  |  |  | L23N | 1
M6 | 35 | IO_L23P_T3_35 |  |  |  | L23P | 1
M7 |  | GND |  |  |  |  | 0
M8 |  | VCCINT |  |  |  |  | 0
M9 | 0 | VN_0 | VN_0 |  |  |  | 0
M10 | 0 | VREFP_0 | VREFP_0 |  |  |  | 0
M11 |  | GND |  |  |  |  | 0
M12 |  | VCCAUX |  |  |  |  | 0
M13 | 15 | IO_L20P_T3_A20_15 |  |  |  | L20P | 1
M14 | 14 | VCCO_14 |  |  |  |  | 0
M15 | 15 | IO_L24P_T3_RS1_15 |  |  |  | L24P | 1
M16 | 15 | IO_L24N_T3_RS0_15 |  |  |  | L24N | 1
M17 | 15 | IO_25_15 |  |  |  |  | 1
M18 | 15 | IO_L16P_T2_A28_15 |  |  |  | L16P | 1
M19 |  | GND |  |  |  |  | 0
M20 | 15 | IO_L18N_T2_A23_15 |  |  |  | L18N | 1
M21 | 15 | IO_L10P_T1_AD11P_15 |  |  |  | L10P | 1
M22 | 15 | IO_L15N_T2_DQS_ADV_B_15 |  |  |  | L15N | 1
N1 | 35 | VCCO_35 |  |  |  |  | 0
N2 | 35 | IO_L22N_T3_35 |  |  |  | L22N | 1
N3 | 35 | IO_L19N_T3_VREF_35 |  | VREF |  | L19N | 1
N4 | 35 | IO_L19P_T3_35 |  |  |  | L19P | 1
N5 | 35 | IO_L24N_T3_35 |  |  |  | L24N | 1
N6 |  | GND |  |  |  |  | 0
N7 |  | VCCINT |  |  |  |  | 0
N8 |  | GND |  |  |  |  | 0
N9 | 0 | DXN_0 | DXN_0 |  |  |  | 0
N10 | 0 | DXP_0 | DXP_0 |  |  |  | 0
N11 |  | VCCBRAM |  |  |  |  | 0
N12 | 0 | PROGRAM_B_0 | PROGRAM_B_0 |  |  |  | 0
N13 | 14 | IO_L23P_T3_A03_D19_14 |  |  |  | L23P | 1
N14 | 14 | IO_L23N_T3_A02_D18_14 |  |  |  | L23N | 1
N15 | 14 | IO_25_14 |  |  |  |  | 1
N16 |  | GND |  |  |  |  | 0
N17 | 14 | IO_L21P_T3_DQS_14 |  |  |  | L21P | 1
N18 | 15 | IO_L17P_T2_A26_15 |  |  |  | L17P | 1
N19 | 15 | IO_L17N_T2_A25_15 |  |  |  | L17N | 1
N20 | 15 | IO_L18P_T2_A24_15 |  |  |  | L18P | 1
N21 | 15 | VCCO_15 |  |  |  |  | 0
N22 | 15 | IO_L15P_T2_DQS_15 |  |  |  | L15P | 1
P1 | 35 | IO_L20N_T3_35 |  |  |  | L20N | 1
P2 | 35 | IO_L22P_T3_35 |  |  |  | L22P | 1
P3 |  | GND |  |  |  |  | 0
P4 | 35 | IO_L21N_T3_DQS_35 |  |  |  | L21N | 1
P5 | 35 | IO_L21P_T3_DQS_35 |  |  |  | L21P | 1
P6 | 35 | IO_L24P_T3_35 |  |  |  | L24P | 1
P7 |  | GND |  |  |  |  | 0
P8 |  | VCCINT |  |  |  |  | 0
P9 |  | GND |  |  |  |  | 0
P10 |  | VCCINT |  |  |  |  | 0
P11 |  | GND |  |  |  |  | 0
P12 |  | VCCAUX |  |  |  |  | 0
P13 |  | GND |  |  |  |  | 0
P14 | 14 | IO_L19P_T3_A10_D26_14 |  |  |  | L19P | 1
P15 | 14 | IO_L22P_T3_A05_D21_14 |  |  |  | L22P | 1
P16 | 14 | IO_L24P_T3_A01_D17_14 |  |  |  | L24P | 1
P17 | 14 | IO_L21N_T3_DQS_A06_D22_14 |  |  |  | L21N | 1
P18 | 14 | VCCO_14 |  |  |  |  | 0
P19 | 14 | IO_L5P_T0_D06_14 |  |  |  | L5P | 1
P20 | 14 | IO_0_14 |  |  |  |  | 1
P21 | 14 | IO_L2P_T0_D02_14 |  |  |  | L2P | 1
P22 | 14 | IO_L1P_T0_D00_MOSI_14 |  |  |  | L1P | 1
R1 | 35 | IO_L20P_T3_35 |  |  |  | L20P | 1
R2 | 34 | IO_L3N_T0_DQS_34 |  |  |  | L3N | 1
R3 | 34 | IO_L3P_T0_DQS_34 |  |  |  | L3P | 1
R4 | 34 | IO_L13P_T2_MRCC_34 |  |  | MRCC | L13P | 1
R5 | 34 | VCCO_34 |  |  |  |  | 0
R6 | 34 | IO_L17P_T2_34 |  |  |  | L17P | 1
R7 |  | VCCINT |  |  |  |  | 0
R8 |  | GND |  |  |  |  | 0
R9 |  | VCCINT |  |  |  |  | 0
R10 |  | GND |  |  |  |  | 0
R11 |  | VCCAUX |  |  |  |  | 0
R12 |  | GND |  |  |  |  | 0
R13 | 0 | TDI_0 | TDI_0 |  |  |  | 0
R14 | 14 | IO_L19N_T3_A09_D25_VREF_14 |  | VREF |  | L19N | 1
R15 | 14 | VCCO_14 |  |  |  |  | 0
R16 | 14 | IO_L22N_T3_A04_D20_14 |  |  |  | L22N | 1
R17 | 14 | IO_L24N_T3_A00_D16_14 |  |  |  | L24N | 1
R18 | 14 | IO_L20P_T3_A08_D24_14 |  |  |  | L20P | 1
R19 | 14 | IO_L5N_T0_D07_14 |  |  |  | L5N | 1
R20 |  | GND |  |  |  |  | 0
R21 | 14 | IO_L2N_T0_D03_14 |  |  |  | L2N | 1
R22 | 14 | IO_L1N_T0_D01_DIN_14 |  |  |  | L1N | 1
T1 | 34 | IO_L1P_T0_34 |  |  |  | L1P | 1
T2 | 34 | VCCO_34 |  |  |  |  | 0
T3 | 34 | IO_0_34 |  |  |  |  | 1
T4 | 34 | IO_L13N_T2_MRCC_34 |  |  | MRCC | L13N | 1
T5 | 34 | IO_L14P_T2_SRCC_34 |  |  | SRCC | L14P | 1
T6 | 34 | IO_L17N_T2_34 |  |  |  | L17N | 1
T7 |  | GND |  |  |  |  | 0
T8 |  | VCCINT |  |  |  |  | 0
T9 |  | GND |  |  |  |  | 0
T10 |  | VCCINT |  |  |  |  | 0
T11 |  | GND |  |  |  |  | 0
T12 | 0 | VCCO_0 |  |  |  |  | 0
T13 | 0 | TMS_0 | TMS_0 |  |  |  | 0
T14 | 13 | IO_L15P_T2_DQS_13 |  |  |  | L15P | 1
T15 | 13 | IO_L15N_T2_DQS_13 |  |  |  | L15N | 1
T16 | 13 | IO_L17P_T2_13 |  |  |  | L17P | 1
T17 |  | GND |  |  |  |  | 0
T18 | 14 | IO_L20N_T3_A07_D23_14 |  |  |  | L20N | 1
T19 | 14 | IO_L6P_T0_FCS_B_14 |  |  |  | L6P | 1
T20 | 14 | IO_L6N_T0_D08_VREF_14 |  | VREF |  | L6N | 1
T21 | 14 | IO_L4P_T0_D04_14 |  |  |  | L4P | 1
T22 | 14 | VCCO_14 |  |  |  |  | 0
U1 | 34 | IO_L1N_T0_34 |  |  |  | L1N | 1
U2 | 34 | IO_L2P_T0_34 |  |  |  | L2P | 1
U3 | 34 | IO_L6P_T0_34 |  |  |  | L6P | 1
U4 |  | GND |  |  |  |  | 0
U5 | 34 | IO_L14N_T2_SRCC_34 |  |  | SRCC | L14N | 1
U6 | 34 | IO_L16P_T2_34 |  |  |  | L16P | 1
U7 | 34 | IO_25_34 |  |  |  |  | 1
U8 | 0 | CFGBVS_0 | CFGBVS_0 |  |  |  | 0
U9 | 0 | M2_0 | M2_0 |  |  |  | 0
U10 | 0 | M1_0 | M1_0 |  |  |  | 0
U11 | 0 | M0_0 | M0_0 |  |  |  | 0
U12 | 0 | INIT_B_0 | INIT_B_0 |  |  |  | 0
U13 | 0 | TDO_0 | TDO_0 |  |  |  | 0
U14 |  | GND |  |  |  |  | 0
U15 | 13 | IO_L14P_T2_SRCC_13 |  |  | SRCC | L14P | 1
U16 | 13 | IO_L17N_T2_13 |  |  |  | L17N | 1
U17 | 14 | IO_L18P_T2_A12_D28_14 |  |  |  | L18P | 1
U18 | 14 | IO_L18N_T2_A11_D27_14 |  |  |  | L18N | 1
U19 | 14 | VCCO_14 |  |  |  |  | 0
U20 | 14 | IO_L11P_T1_SRCC_14 |  |  | SRCC | L11P | 1
U21 | 14 | IO_L4N_T0_D05_14 |  |  |  | L4N | 1
U22 | 14 | IO_L3P_T0_DQS_PUDC_B_14 |  |  |  | L3P | 1
V1 |  | GND |  |  |  |  | 0
V2 | 34 | IO_L2N_T0_34 |  |  |  | L2N | 1
V3 | 34 | IO_L6N_T0_VREF_34 |  | VREF |  | L6N | 1
V4 | 34 | IO_L12P_T1_MRCC_34 |  |  | MRCC | L12P | 1
V5 | 34 | IO_L16N_T2_34 |  |  |  | L16N | 1
V6 | 34 | VCCO_34 |  |  |  |  | 0
V7 | 34 | IO_L19P_T3_34 |  |  |  | L19P | 1
V8 | 34 | IO_L21N_T3_DQS_34 |  |  |  | L21N | 1
V9 | 34 | IO_L21P_T3_DQS_34 |  |  |  | L21P | 1
V10 | 13 | IO_L10P_T1_13 |  |  |  | L10P | 1
V11 |  | GND |  |  |  |  | 0
V12 | 0 | TCK_0 | TCK_0 |  |  |  | 0
V13 | 13 | IO_L13P_T2_MRCC_13 |  |  | MRCC | L13P | 1
V14 | 13 | IO_L13N_T2_MRCC_13 |  |  | MRCC | L13N | 1
V15 | 13 | IO_L14N_T2_SRCC_13 |  |  | SRCC | L14N | 1
V16 | 13 | VCCO_13 |  |  |  |  | 0
V17 | 14 | IO_L16P_T2_CSI_B_14 |  |  |  | L16P | 1
V18 | 14 | IO_L14P_T2_SRCC_14 |  |  | SRCC | L14P | 1
V19 | 14 | IO_L14N_T2_SRCC_14 |  |  | SRCC | L14N | 1
V20 | 14 | IO_L11N_T1_SRCC_14 |  |  | SRCC | L11N | 1
V21 |  | GND |  |  |  |  | 0
V22 | 14 | IO_L3N_T0_DQS_EMCCLK_14 |  |  |  | L3N | 1
W1 | 34 | IO_L5P_T0_34 |  |  |  | L5P | 1
W2 | 34 | IO_L4P_T0_34 |  |  |  | L4P | 1
W3 | 34 | VCCO_34 |  |  |  |  | 0
W4 | 34 | IO_L12N_T1_MRCC_34 |  |  | MRCC | L12N | 1
W5 | 34 | IO_L15N_T2_DQS_34 |  |  |  | L15N | 1
W6 | 34 | IO_L15P_T2_DQS_34 |  |  |  | L15P | 1
W7 | 34 | IO_L19N_T3_VREF_34 |  | VREF |  | L19N | 1
W8 |  | GND |  |  |  |  | 0
W9 | 34 | IO_L24P_T3_34 |  |  |  | L24P | 1
W10 | 13 | IO_L10N_T1_13 |  |  |  | L10N | 1
W11 | 13 | IO_L12P_T1_MRCC_13 |  |  | MRCC | L12P | 1
W12 | 13 | IO_L12N_T1_MRCC_13 |  |  | MRCC | L12N | 1
W13 | 13 | VCCO_13 |  |  |  |  | 0
W14 | 13 | IO_L6P_T0_13 |  |  |  | L6P | 1
W15 | 13 | IO_L16P_T2_13 |  |  |  | L16P | 1
W16 | 13 | IO_L16N_T2_13 |  |  |  | L16N | 1
W17 | 14 | IO_L16N_T2_A15_D31_14 |  |  |  | L16N | 1
W18 |  | GND |  |  |  |  | 0
W19 | 14 | IO_L12P_T1_MRCC_14 |  |  | MRCC | L12P | 1
W20 | 14 | IO_L12N_T1_MRCC_14 |  |  | MRCC | L12N | 1
W21 | 14 | IO_L7P_T1_D09_14 |  |  |  | L7P | 1
W22 | 14 | IO_L7N_T1_D10_14 |  |  |  | L7N | 1
Y1 | 34 | IO_L5N_T0_34 |  |  |  | L5N | 1
Y2 | 34 | IO_L4N_T0_34 |  |  |  | L4N | 1
Y3 | 34 | IO_L9P_T1_DQS_34 |  |  |  | L9P | 1
Y4 | 34 | IO_L11P_T1_SRCC_34 |  |  | SRCC | L11P | 1
Y5 |  | GND |  |  |  |  | 0
Y6 | 34 | IO_L18P_T2_34 |  |  |  | L18P | 1
Y7 | 34 | IO_L23N_T3_34 |  |  |  | L23N | 1
Y8 | 34 | IO_L23P_T3_34 |  |  |  | L23P | 1
Y9 | 34 | IO_L24N_T3_34 |  |  |  | L24N | 1
Y10 | 13 | VCCO_13 |  |  |  |  | 0
Y11 | 13 | IO_L11P_T1_SRCC_13 |  |  | SRCC | L11P | 1
Y12 | 13 | IO_L11N_T1_SRCC_13 |  |  | SRCC | L11N | 1
Y13 | 13 | IO_L5P_T0_13 |  |  |  | L5P | 1
Y14 | 13 | IO_L6N_T0_VREF_13 |  | VREF |  | L6N | 1
Y15 |  | GND |  |  |  |  | 0
Y16 | 13 | IO_L1P_T0_13 |  |  |  | L1P | 1
Y17 | 13 | IO_0_13 |  |  |  |  | 1
Y18 | 14 | IO_L13P_T2_MRCC_14 |  |  | MRCC | L13P | 1
Y19 | 14 | IO_L13N_T2_MRCC_14 |  |  | MRCC | L13N | 1
Y20 | 14 | VCCO_14 |  |  |  |  | 0
Y21 | 14 | IO_L9P_T1_DQS_14 |  |  |  | L9P | 1
Y22 | 14 | IO_L9N_T1_DQS_D13_14 |  |  |  | L9N | 1
AA1 | 34 | IO_L7P_T1_34 |  |  |  | L7P | 1
AA2 |  | GND |  |  |  |  | 0
AA3 | 34 | IO_L9N_T1_DQS_34 |  |  |  | L9N | 1
AA4 | 34 | IO_L11N_T1_SRCC_34 |  |  | SRCC | L11N | 1
AA5 | 34 | IO_L10P_T1_34 |  |  |  | L10P | 1
AA6 | 34 | IO_L18N_T2_34 |  |  |  | L18N | 1
AA7 | 34 | VCCO_34 |  |  |  |  | 0
AA8 | 34 | IO_L22P_T3_34 |  |  |  | L22P | 1
AA9 | 13 | IO_L8P_T1_13 |  |  |  | L8P | 1
AA10 | 13 | IO_L9P_T1_DQS_13 |  |  |  | L9P | 1
AA11 | 13 | IO_L9N_T1_DQS_13 |  |  |  | L9N | 1
AA12 |  | GND |  |  |  |  | 0
AA13 | 13 | IO_L3P_T0_DQS_13 |  |  |  | L3P | 1
AA14 | 13 | IO_L5N_T0_13 |  |  |  | L5N | 1
AA15 | 13 | IO_L4P_T0_13 |  |  |  | L4P | 1
AA16 | 13 | IO_L1N_T0_13 |  |  |  | L1N | 1
AA17 | 13 | VCCO_13 |  |  |  |  | 0
AA18 | 14 | IO_L17P_T2_A14_D30_14 |  |  |  | L17P | 1
AA19 | 14 | IO_L15P_T2_DQS_RDWR_B_14 |  |  |  | L15P | 1
AA20 | 14 | IO_L8P_T1_D11_14 |  |  |  | L8P | 1
AA21 | 14 | IO_L8N_T1_D12_14 |  |  |  | L8N | 1
AA22 |  | GND |  |  |  |  | 0
AB1 | 34 | IO_L7N_T1_34 |  |  |  | L7N | 1
AB2 | 34 | IO_L8N_T1_34 |  |  |  | L8N | 1
AB3 | 34 | IO_L8P_T1_34 |  |  |  | L8P | 1
AB4 | 34 | VCCO_34 |  |  |  |  | 0
AB5 | 34 | IO_L10N_T1_34 |  |  |  | L10N | 1
AB6 | 34 | IO_L20N_T3_34 |  |  |  | L20N | 1
AB7 | 34 | IO_L20P_T3_34 |  |  |  | L20P | 1
AB8 | 34 | IO_L22N_T3_34 |  |  |  | L22N | 1
AB9 |  | GND |  |  |  |  | 0
AB10 | 13 | IO_L8N_T1_13 |  |  |  | L8N | 1
AB11 | 13 | IO_L7P_T1_13 |  |  |  | L7P | 1
AB12 | 13 | IO_L7N_T1_13 |  |  |  | L7N | 1
AB13 | 13 | IO_L3N_T0_DQS_13 |  |  |  | L3N | 1
AB14 | 13 | VCCO_13 |  |  |  |  | 0
AB15 | 13 | IO_L4N_T0_13 |  |  |  | L4N | 1
AB16 | 13 | IO_L2P_T0_13 |  |  |  | L2P | 1
AB17 | 13 | IO_L2N_T0_13 |  |  |  | L2N | 1
AB18 | 14 | IO_L17N_T2_A13_D29_14 |  |  |  | L17N | 1
AB19 |  | GND |  |  |  |  | 0
AB20 | 14 | IO_L15N_T2_DQS_DOUT_CSO_B_14 |  |  |  | L15N | 1
AB21 | 14 | IO_L10P_T1_D14_14 |  |  |  | L10P | 1
AB22 | 14 | IO_L10N_T1_D15_14 |  |  |  | L10N | 1
