alphaonex86/FPGA-CPU/sockets/kicad/pinmaps/am5x86_pga168.csv

pin | signal | type
A1 | D20 | Signal
A2 | D22 | Signal
A3 | TCK | Signal
A4 | D23 | Signal
A5 | DP3 | Signal
A6 | D24 | Signal
A7 | VSS | Power
A8 | D29 | Signal
A9 | VSS | Power
A10 | INV | Signal
A11 | VSS | Power
A12 | HITM | Signal
A13 | InternalNC | NoConnect
A14 | TDI | Signal
A15 | IGNNE | Signal
A16 | INTR | Signal
A17 | AHOLD | Signal
B1 | D19 | Signal
B2 | D21 | Signal
B3 | VSS | Power
B4 | VSS | Power
B5 | VSS | Power
B6 | D25 | Signal
B7 | VCC | Power
B8 | D31 | Signal
B9 | VCC | Power
B10 | SMI | Signal
B11 | VCC | Power
B12 | CACHE | Signal
B13 | WB_WT | Signal
B14 | TMS | Signal
B15 | NMI | Signal
B16 | TDO | Signal
B17 | EADS | Signal
C1 | D11 | Signal
C2 | D18 | Signal
C3 | CLK | Signal
C4 | VCC | Power
C5 | VCC | Power
C6 | D27 | Signal
C7 | D26 | Signal
C8 | D28 | Signal
C9 | D30 | Signal
C10 | SRESET | Signal
C11 | UP | Signal
C12 | SMIACT | Signal
C13 | InternalNC | NoConnect
C14 | FERR | Signal
C15 | FLUSH | Signal
C16 | RESET | Signal
C17 | BS16 | Signal
D1 | D9 | Signal
D2 | D13 | Signal
D3 | D17 | Signal
D15 | A20M | Signal
D16 | BS8 | Signal
D17 | BOFF | Signal
E1 | VSS | Power
E2 | VCC | Power
E3 | D10 | Signal
E15 | HOLD | Signal
E16 | VCC | Power
E17 | VSS | Power
F1 | DP1 | Signal
F2 | D8 | Signal
F3 | D15 | Signal
F15 | KEN | Signal
F16 | RDY | Signal
F17 | BE3 | Signal
G1 | VSS | Power
G2 | VCC | Power
G3 | D12 | Signal
G15 | STPCLK | Signal
G16 | VCC | Power
G17 | VSS | Power
H1 | VSS | Power
H2 | D3 | Signal
H3 | DP2 | Signal
H15 | BRDY | Signal
H16 | VCC | Power
H17 | VSS | Power
J1 | InternalNC | NoConnect
J2 | D5 | Signal
J3 | D16 | Signal
J15 | BE2 | Signal
J16 | BE1 | Signal
J17 | PCD | Signal
K1 | VSS | Power
K2 | VCC | Power
K3 | D14 | Signal
K15 | BE0 | Signal
K16 | VCC | Power
K17 | VSS | Power
L1 | VSS | Power
L2 | D6 | Signal
L3 | D7 | Signal
L15 | PWT | Signal
L16 | VCC | Power
L17 | VSS | Power
M1 | VSS | Power
M2 | VCC | Power
M3 | D4 | Signal
M15 | D_C | Signal
M16 | VCC | Power
M17 | VSS | Power
N1 | D2 | Signal
N2 | D1 | Signal
N3 | DP0 | Signal
N15 | LOCK | Signal
N16 | M_IO | Signal
N17 | W_R | Signal
P1 | D0 | Signal
P2 | A29 | Signal
P3 | A30 | Signal
P15 | HLDA | Signal
P16 | VCC | Power
P17 | VSS | Power
Q1 | A31 | Signal
Q2 | VSS | Power
Q3 | A17 | Signal
Q4 | A19 | Signal
Q5 | A21 | Signal
Q6 | A24 | Signal
Q7 | A22 | Signal
Q8 | A20 | Signal
Q9 | A16 | Signal
Q10 | A13 | Signal
Q11 | A9 | Signal
Q12 | A5 | Signal
Q13 | A7 | Signal
Q14 | A2 | Signal
Q15 | BREQ | Signal
Q16 | PLOCK | Signal
Q17 | PCHK | Signal
R1 | A28 | Signal
R2 | A25 | Signal
R3 | VCC | Power
R4 | VSS | Power
R5 | A18 | Signal
R6 | VCC | Power
R7 | A15 | Signal
R8 | VCC | Power
R9 | VCC | Power
R10 | VCC | Power
R11 | VCC | Power
R12 | A11 | Signal
R13 | A8 | Signal
R14 | VCC | Power
R15 | A3 | Signal
R16 | BLAST | Signal
R17 | CLKMUL | Signal
S1 | A27 | Signal
S2 | A26 | Signal
S3 | A23 | Signal
S4 | VOLDET | Signal
S5 | A14 | Signal
S6 | VSS | Power
S7 | A12 | Signal
S8 | VSS | Power
S9 | VSS | Power
S10 | VSS | Power
S11 | VSS | Power
S12 | VSS | Power
S13 | A10 | Signal
S14 | VSS | Power
S15 | A6 | Signal
S16 | A4 | Signal
S17 | ADS | Signal
