alphaonex86/FPGA-CPU/sockets/kicad/3dmodels/Socket3_Am5x86_237.step

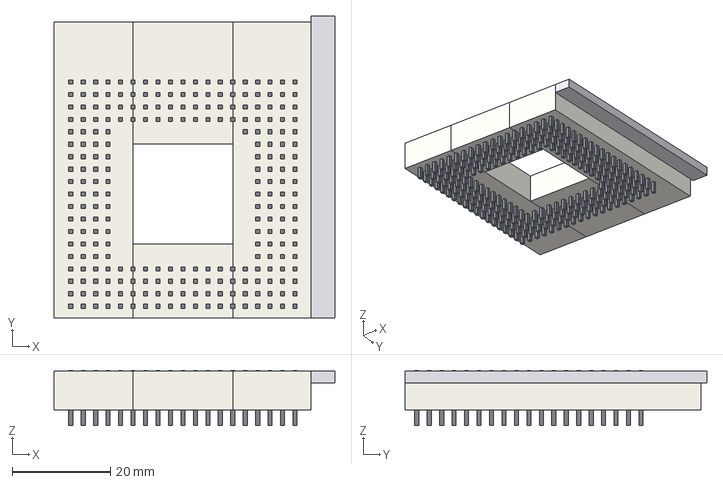
[picture p7: CAD file, 2026-10-31]
sockets/kicad/3dmodels/Socket3_Am5x86_237.step
57.3 x 61.5 x 11.3 mm
