alphaonex86/FPGA-CPU/sockets/kicad/3dmodels/PGA370_Socket_ZIF.step

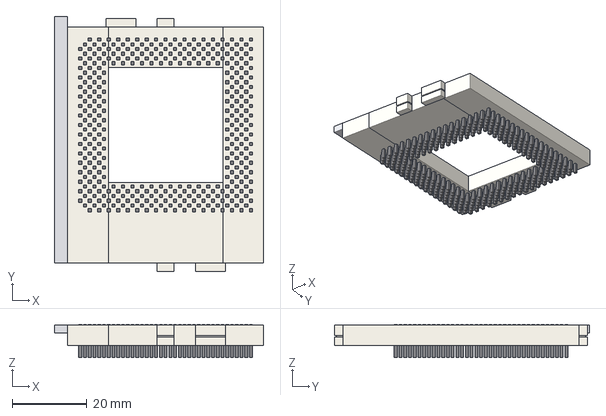
[picture p8: CAD file, 2026-10-31]
sockets/kicad/3dmodels/PGA370_Socket_ZIF.step
56.1 x 68.3 x 8.89 mm
