alphaonex86/FPGA-CPU/sockets/kicad/3dmodels/Socket7_P55C_296.step

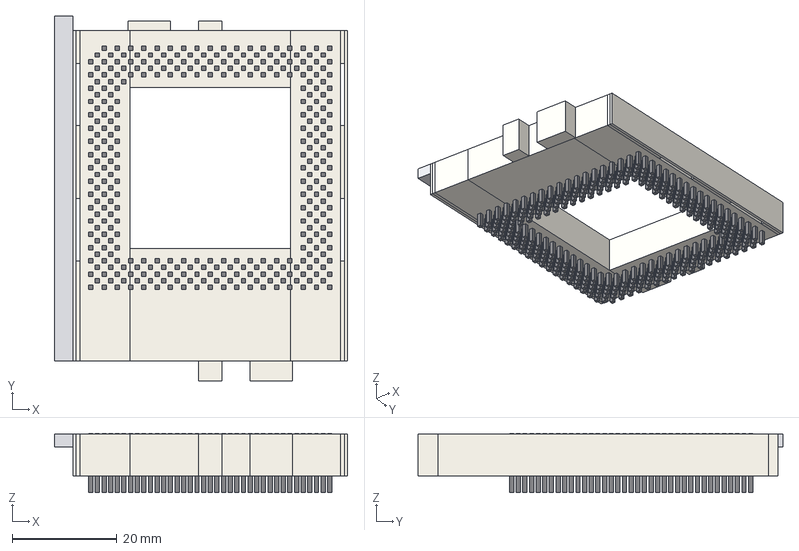
[picture p9: CAD file, 2026-10-31]
sockets/kicad/3dmodels/Socket7_P55C_296.step
56.1 x 69.8 x 11.3 mm
