alphaonex86/FPGA-CPU/plan/bench_results.csv

set | date | commit | config | change | program | group | ipc
79786ccb | 2026-11-12 | 4379a20-dirty | default | baseline of set 3 | lat_8k | lat | 1.278
79786ccb | 2026-11-12 | 4379a20-dirty | default | baseline of set 3 | lat_64k | lat | 0.486
79786ccb | 2026-11-12 | 4379a20-dirty | default | baseline of set 3 | lat_256k | lat | 0.456
79786ccb | 2026-11-12 | 4379a20-dirty | default | baseline of set 3 | lat_1m | lat | 0.228
79786ccb | 2026-11-12 | 4379a20-dirty | default | baseline of set 3 | bw_8k | bw | 2.464
79786ccb | 2026-11-12 | 4379a20-dirty | default | baseline of set 3 | bw_64k | bw | 1.613
79786ccb | 2026-11-12 | 4379a20-dirty | default | baseline of set 3 | bw_256k | bw | 1.555
79786ccb | 2026-11-12 | 4379a20-dirty | default | baseline of set 3 | bw_1m | bw | 1.519
79786ccb | 2026-11-12 | 4379a20-dirty | default | baseline of set 3 | copy_256k | bw | 1.125
79786ccb | 2026-11-12 | 4379a20-dirty | default | baseline of set 3 | code_11k | code | 1.094
79786ccb | 2026-11-12 | 4379a20-dirty | default | baseline of set 3 | code_87k | code | 0.875
79786ccb | 2026-11-12 | 4379a20-dirty | default | baseline of set 3 | codedata_27k | code | 1.142
79786ccb | 2026-11-12 | 4379a20-dirty | default | baseline of set 3 | phase | phase | 1.739
79786ccb | 2026-11-12 | 4379a20-dirty | default | baseline of set 3 | ilp | core | 2.777
79786ccb | 2026-11-12 | 4379a20-dirty | default | baseline of set 3 | chain | core | 1.133
79786ccb | 2026-11-12 | 4379a20-dirty | default | baseline of set 3 | branch | core | 0.719
79786ccb | 2026-11-12 | 4379a20-dirty | default | baseline of set 3 | call | core | 0.933
79786ccb | 2026-11-12 | 4379a20-dirty | default | baseline of set 3 | coremark-i386 | app_i386 | 1.556
79786ccb | 2026-11-12 | 4379a20-dirty | default | baseline of set 3 | coremark-full | app_full | 1.681
79786ccb | 2026-11-12 | 4379a20-dirty | default | baseline of set 3 | mix-i386 | app_i386 | 1.528
79786ccb | 2026-11-12 | 4379a20-dirty | default | baseline of set 3 | mix-full | app_full | 1.700
79786ccb | 2026-11-12 | 4379a20-dirty | default | baseline of set 3 | core-i386 | app_i386 | 1.503
79786ccb | 2026-11-12 | 4379a20-dirty | default | baseline of set 3 | core-full | app_full | 1.418
79786ccb | 2026-11-12 | 4379a20-dirty | default | baseline of set 3 | string-i386 | app_i386 | 1.162
79786ccb | 2026-11-12 | 4379a20-dirty | default | baseline of set 3 | string-full | app_full | 1.163
79786ccb | 2026-11-12 | 4379a20-dirty | default | baseline of set 3 | bits-i386 | app_i386 | 1.284
79786ccb | 2026-11-12 | 4379a20-dirty | default | baseline of set 3 | bits-full | app_full | 1.266
79786ccb | 2026-11-12 | 4379a20-dirty | default | baseline of set 3 | interp-i386 | app_i386 | 0.749
79786ccb | 2026-11-12 | 4379a20-dirty | default | baseline of set 3 | interp-full | app_full | 0.746
79786ccb | 2026-11-12 | 4379a20-dirty | default | baseline of set 3 | objects-i386 | app_i386 | 0.639
79786ccb | 2026-11-12 | 4379a20-dirty | default | baseline of set 3 | objects-full | app_full | 0.554
79786ccb | 2026-11-12 | 4379a20-dirty | default | baseline of set 3 | compress-i386 | app_i386 | 1.175
79786ccb | 2026-11-12 | 4379a20-dirty | default | baseline of set 3 | compress-full | app_full | 1.331
79786ccb | 2026-11-12 | 4379a20-dirty | default | baseline of set 3 | sort-i386 | app_i386 | 0.863
79786ccb | 2026-11-12 | 4379a20-dirty | default | baseline of set 3 | sort-full | app_full | 0.820
79786ccb | 2026-11-12 | 4379a20-dirty | default | baseline of set 3 | hash-i386 | app_i386 | 0.921
79786ccb | 2026-11-12 | 4379a20-dirty | default | baseline of set 3 | hash-full | app_full | 0.741
79786ccb | 2026-11-12 | 4379a20-dirty | default | baseline of set 3 | crypto-i386 | app_i386 | 2.128
79786ccb | 2026-11-12 | 4379a20-dirty | default | baseline of set 3 | crypto-full | app_full | 2.567
79786ccb | 2026-11-12 | 4379a20-dirty | default | baseline of set 3 | parse-i386 | app_i386 | 0.656
79786ccb | 2026-11-12 | 4379a20-dirty | default | baseline of set 3 | parse-full | app_full | 0.907
79786ccb | 2026-11-12 | 4379a20-dirty | default | baseline of set 3 | fpu | fp | n/a
