alphaonex86/FPGA-CPU/hw/socket3-cyclonev/socket3-cyclonev.kicad_pcb

## KiCad design hw/socket3-cyclonev/socket3-cyclonev.kicad_pcb (2026-11-11)

Schematic: socket3-cyclonev.kicad_sch, Socket 3 interposer: 5CEBA9 + 16x SN74CB3T3245

Parts:
C1, C8, C12, C16: 10uF/25V; C_1210_3225Metric
C2: 4.7uF/25V; C_0805_2012Metric
C3, C4: 22uF/10V; C_1206_3216Metric
C5, C10, C14, C18, C21, C68, C69, C70, C90, C91, C92, C105, C106, C107, C108, C109, C110, C111, C112, C113, C114, C115, C116, C117, C118, C119, C120, C121: 100nF; C_0402_1005Metric
C6, C20, C44, C45, C46, C47, C48, C49, C50, C51: 10nF; C_0402_1005Metric
C7: 27nF; C_0402_1005Metric
C9, C13, C17: 22uF/6.3V; C_0805_2012Metric
C11, C15, C19: 3.3nF; C_0402_1005Metric
C22, C23, C24, C25, C26, C27, C28, C29, C30, C31, C32, C33, C34, C78, C79, C80, C81: 4.7nF; C_0402_P1.00
C35, C36, C37, C38, C39, C40, C41, C42, C43, C82, C83, C84, C85, C95: 10nF; C_0402_P1.00
C52, C53, C54, C55, C56, C57, C58, C59, C60, C61, C62, C63: 22nF; C_0402_1005Metric
C64, C65, C66, C67, C89: 47nF; C_0402_1005Metric
C71, C72: 220nF; C_0402_1005Metric
C73: 470nF; C_0402_1005Metric
C74, C93, C94: 1uF; C_0402_1005Metric
C75, C76, C77: 2.2nF; C_0402_P1.00
C86, C87: 22nF; C_0402_P1.00
C88: 47nF; C_0402_P1.00
C96, C98: 100nF; C_0402_P1.00
C97: 1uF; C_0402_P1.00
C99, C100, C101: 100uF/6.3V; C_1210_3225Metric
C102: 4.7uF; C_0603_1608Metric
C103: 10uF; C_0805_2012Metric
C104: 22uF; C_0805_2012Metric
F1: 2A; Fuse_1206_3216Metric
FB1: BLM18AG601SN1D; L_0603_1608Metric
J1: Conn_02x03_Odd_Even; PinHeader_2x03_P2.54mm_Vertical
J3: Barrel_Jack; BarrelJack_CUI_PJ-063AH_Horizontal
L1: 6.8uH FXL1040-6R8; L_Changjiang_FXL1040
L2, L3, L4: 2.2uH XFL4020-222; L_Coilcraft_XxL4020
PS1: TPS54620RHL; TI_RHL0014A
PS2, PS3, PS4: TPS62130RGT; VQFN-16-1EP_3x3mm_P0.5mm_EP1.68x1.68mm
R1, R2, R4: 4k7; R_0402_1005Metric
R3, R23, R26, R28, R29, R31, R33: 100k; R_0402_1005Metric
R5, R6, R7, R8, R9, R10, R11, R12, R13, R14, R15, R16, R17, R19, R20, R25, R36, R37: 10k; R_0402_1005Metric
R18: 1k; R_0402_1005Metric
R21: 2k0 1%; R_0402_1005Metric
R22: 1.33k; R_0402_1005Metric
R24: 52.3k; R_0402_1005Metric
R27: 37.4k; R_0402_1005Metric
R30: 215k; R_0402_1005Metric
R32: 316k; R_0402_1005Metric
R34: 68.1k 1%; R_0402_1005Metric
R35: 10k 1%; R_0402_1005Metric
TR01, TR02, TR03, TR04, TR05, TR06, TR07, TR08, TR09, TR10, TR11, TR12, TR13, TR14, TR15, TR16: SN74CB3T3245; TSSOP-20_4.4x6.5mm_P0.65mm
U1: FPGA_CycloneV_5CEFA9_F484; FPGA_CycloneV_5CEFA9_F484_BGA
U2: Socket3_Am5x86_PGA168; Socket3_Base_PGA168
U3: TLV6700DDC; SOT-23-6
U4: MT25QL01GBBB8ESF-0SIT; SOIC-16W_7.5x10.3mm_P1.27mm

Connections:
/A2: TR14.9 (A8), U1.N20
/A3: TR13.7 (A6), U1.N21
/A4: TR13.4 (A3), U1.W21
/A5: TR14.7 (A6), U1.W19
/A6: TR05.5 (A4), U1.Y21
/A7: TR14.8 (A7), U1.Y19
/A8: TR05.2 (A1), U1.AA22
/A9: TR14.6 (A5), U1.AB15
/A10: TR13.3 (A2), U1.Y20
/A11: TR13.6 (A5), U1.W22
/A12: TR06.2 (A1), U1.AB17
/A13: TR06.3 (A2), U1.AA18
/A14: TR14.5 (A4), U1.Y17
/A15: TR05.3 (A2), U1.Y22
/A16: TR06.4 (A3), U1.AA17
/A17: TR15.8 (A7), U1.Y15
/A18: TR05.4 (A3), U1.AB21
/A19: TR15.9 (A8), U1.AB11
/A20: TR06.5 (A4), U1.V20
/A20M#: TR11.3 (A2), U1.D13
/A21: TR06.8 (A7), U1.AB13
/A22: TR14.4 (A3), U1.AA15
/A23: TR14.3 (A2), U1.Y16
/A24: TR14.2 (A1), U1.AA14
/A25: TR05.6 (A5), U1.AB20
/A26: TR06.7 (A6), U1.V19
/A27: TR06.9 (A8), U1.AB12
/A28: TR05.8 (A7), U1.V21
/A29: TR15.4 (A3), U1.AA9
/A30: TR15.5 (A4), U1.AB8
/A31: TR15.6 (A5), U1.T19
/ADS#: TR13.5 (A4), U1.U22
/AHOLD: R5.1, TR01.4 (A3), U1.H21
/AS_DATA0: U1.AB4, U4.15 (DQ0)
/AS_DATA1: U1.AB3, U4.8 (DQ1)
/AS_DATA2: U1.AA5, U4.9 (DQ2)
/AS_DATA3: R17.1, U1.T4, U4.1 (DQ3)
/AS_DCLK: R16.1, U1.V3, U4.16 (C)
/AS_nCS: U1.R4, U4.7 (S#)
/BE0#: TR07.6 (A5), U1.AA10
/BE1#: TR07.8 (A7), U1.AB7
/BE2#: TR07.9 (A8), U1.AB6
/BE3#: TR11.6 (A5), U1.A7
/BLAST#: TR13.8 (A7), U1.M22
/BOFF#: TR03.9 (A8), U1.A10
/BRDY#: TR04.8 (A7), U1.K20
/BREQ: TR05.9 (A8), U1.AA19
/BS8#: TR03.7 (A6), U1.B10
/BS16#: TR02.9 (A8), U1.B17
/BUS_OE#: R36.1, TR01.19 (OE#), TR02.19 (OE#), TR03.19 (OE#), TR04.19 (OE#), TR05.19 (OE#), TR06.19 (OE#), TR07.19 (OE#), TR08.19 (OE#), TR09.19 (OE#), TR10.19 (OE#), TR11.19 (OE#), TR12.19 (OE#), TR13.19 (OE#), TR14.19 (OE#), TR15.19 (OE#), TR16.19 (OE#), U3.6 (OUTB)
/CACHE#: TR01.6 (A5), U1.B20
/CFG_CLKUSR: U1.T8
/CFG_CONF_DONE: R14.1, U1.K6
/CFG_CRC_ERROR: U1.T17
/CFG_CvP_CONFDONE: U1.R22
/CFG_DATA5: U1.U7
/CFG_DATA6: U1.R6
/CFG_DATA7: U1.U8
/CFG_DATA8: U1.R5
/CFG_DATA9: U1.W8
/CFG_DATA10: U1.P6
/CFG_DATA11: U1.W9
/CFG_DATA12: U1.N6
/CFG_DATA13: U1.U6
/CFG_DATA14: U1.T7
/CFG_DATA15: U1.V6
/CFG_DEV_CLRn: U1.P22
/CFG_DEV_OE: U1.R21
/CFG_INIT_DONE: U1.T18
/CFG_PR_DONE: U1.M6
/CFG_PR_ERROR: U1.M7
/CFG_PR_READY: U1.R7
/CFG_PR_REQUEST: U1.T20
/CFG_nCEO: U1.T22
/CFG_nCONFIG: R15.1, U1.A4
/CFG_nSTATUS: R13.1, U1.H5
/CLK: TR11.4 (A3), U1.H16
/CLKMUL: TR13.9 (A8), U1.AB22
/D0: TR15.3 (A2), U1.Y10
/D1: TR16.9 (A8), U1.AA7
/D2: TR16.8 (A7), U1.V13
/D3: TR12.5 (A4), U1.D6
/D4: TR08.2 (A1), U1.AB5
/D5: TR08.4 (A3), U1.M21
/D6: TR16.6 (A5), U1.V9
/D7: TR16.7 (A6), U1.V10
/D8: TR12.3 (A2), U1.B5
/D9: TR04.9 (A8), U1.B6
/D10: TR12.2 (A1), U1.D9
/D11: TR11.5 (A4), U1.A8
/D12: TR04.5 (A4), U1.E7
/D13: TR11.8 (A7), U1.B7
/D14: TR08.3 (A2), U1.Y9
/D15: TR04.7 (A6), U1.C6
/D16: TR16.5 (A4), U1.M20
/D17: TR03.2 (A1), U1.C8
/D18: TR03.5 (A4), U1.D12
/D19: TR09.9 (A8), U1.E19
/D20: TR03.6 (A5), U1.C11
/D21: TR09.7 (A6), U1.G21
/D22: TR03.8 (A7), U1.A9
/D23: TR02.2 (A1), U1.E14
/D24: TR02.5 (A4), U1.A13
/D25: TR09.5 (A4), U1.E21
/D26: TR10.9 (A8), U1.B12
/D27: TR11.2 (A1), U1.B11
/D28: TR10.7 (A6), U1.J19
/D29: TR10.3 (A2), U1.D17
/D30: TR10.6 (A5), U1.C15
/D31: TR01.5 (A4), U1.C20
/DP0: R9.1, TR15.2 (A1), U1.AA8
/DP1: R10.1, TR04.6 (A5), U1.D7
/DP2: R11.1, TR12.4 (A3), U1.E9
/DP3: R12.1, TR02.3 (A2), U1.A12
/D/C#: TR07.4 (A3), U1.AA12
/EADS#: TR01.9 (A8), U1.F22
/FERR#: TR02.6 (A5), U1.A14
/FLUSH#: TR02.7 (A6), U1.C16
/F_TCK: J1.1, R18.1, U1.V5
/F_TDI: J1.5, R20.1, U1.W5
/F_TDO: J1.6, U1.M5
/F_TMS: J1.3, R19.1, U1.P5
/GND: C1.2, C2.2, C3.2, C4.2, C6.2, C7.2, C8.2, C9.2, C10.2, C11.2, C12.2, C13.2, C14.2, C15.2, C16.2, C17.2, C18.2, C19.2, C20.2, C21.2, C22.2, C23.2, C24.2, C25.2, C26.2, C27.2, C28.2, C29.2, C30.2, C31.2, C32.2, C33.2, C34.2, C35.2, C36.2, C37.2, C38.2, C39.2, C40.2, C41.2, C42.2, C43.2, C44.2, C45.2, C46.2, C47.2, C48.2, C49.2, C50.2, C51.2, C52.2, C53.2, C54.2, C55.2, C56.2, C57.2, C58.2, C59.2, C60.2, C61.2, C62.2, C63.2, C64.2, C65.2, C66.2, C67.2, C68.2, C69.2, C70.2, C71.2, C72.2, C73.2, C74.2, C75.2, C76.2, C77.2, C78.2, C79.2, C80.2, C81.2, C82.2, C83.2, C84.2, C85.2, C86.2, C87.2, C88.2, C89.2, C90.2, C91.2, C92.2, C93.2, C94.2, C95.2, C96.2, C97.2, C98.2, C99.2, C100.2, C101.2, C102.2, C103.2, C104.2, C105.2, C106.2, C107.2, C108.2, C109.2, C110.2, C111.2, C112.2, C113.2, C114.2, C115.2, C116.2, C117.2, C118.2, C119.2, C120.2, C121.2, J1.2, J1.4, J3.2, PS1.2 (GND), PS1.3 (GND), PS1.15 (PAD), PS2.6 (AGND), PS2.7 (FSW), PS2.8 (DEF), PS2.15 (PGND), PS2.16 (PGND), PS2.17 (PAD), PS3.6 (AGND), PS3.7 (FSW), PS3.8 (DEF), PS3.15 (PGND), PS3.16 (PGND), PS3.17 (PAD), PS4.6 (AGND), PS4.7 (FSW), PS4.8 (DEF), PS4.15 (PGND), PS4.16 (PGND), PS4.17 (PAD), R1.2, R2.2, R3.2, R4.2, R5.2, R6.2, R7.2, R16.2, R18.2, R21.2, R23.2, R25.2, R28.2, R31.2, R33.2, R35.2, TR01.10 (GND), TR02.10 (GND), TR03.10 (GND), TR04.10 (GND), TR05.10 (GND), TR06.10 (GND), TR07.10 (GND), TR08.10 (GND), TR09.10 (GND), TR10.10 (GND), TR11.10 (GND), TR12.10 (GND), TR13.10 (GND), TR14.10 (GND), TR15.10 (GND), TR16.10 (GND), U1.A2, U1.A11, U1.A21, U1.AA3, U1.AA4, U1.AA6, U1.AA11, U1.AB1, U1.AB2, U1.AB9, U1.AB14, U1.AB16, U1.AB19, U1.B1, U1.B2, U1.B8, U1.B9, U1.B14, U1.C3, U1.C4, U1.C5, U1.C14, U1.C17, U1.D1, U1.D2, U1.D5, U1.D10, U1.D20, U1.E3, U1.E4, U1.E5, U1.E13, U1.F1, U1.F2, U1.F5, U1.F6, U1.F16, U1.F17, U1.G3, U1.G4, U1.G5, U1.G9, U1.G19, U1.H1, U1.H2, U1.H3, U1.H4, U1.H7, U1.H12, U1.H22, U1.J3, U1.J5, U1.J15, U1.J20, U1.K1, U1.K2, U1.K4, U1.K8, U1.K10, U1.K12, U1.K14, U1.L3, U1.L5, U1.L11, U1.L13, U1.L15, U1.L20, U1.L21, U1.M1, U1.M2, U1.M4, U1.M10, U1.M12, U1.M14, U1.N3, U1.N5, U1.N7, U1.N11, U1.N13, U1.N15, U1.N17, U1.N22, U1.P1, U1.P2, U1.P4, U1.P10, U1.R3, U1.R13, U1.R20, U1.T1, U1.T2, U1.T16, U1.T21, U1.U3, U1.U4, U1.U5, U1.U9, U1.V1, U1.V2, U1.V4, U1.V7, U1.V12, U1.V17, U1.V22, U1.W3, U1.W4, U1.Y1, U1.Y2, U1.Y5, U1.Y7, U1.Y12, U1.Y18, U2.A7 (VSS), U2.A9 (VSS), U2.A11 (VSS), U2.B3 (VSS), U2.B4 (VSS), U2.B5 (VSS), U2.E1 (VSS), U2.E17 (VSS), U2.G1 (VSS), U2.G17 (VSS), U2.H1 (VSS), U2.H17 (VSS), U2.K1 (VSS), U2.K17 (VSS), U2.L1 (VSS), U2.L17 (VSS), U2.M1 (VSS), U2.M17 (VSS), U2.P17 (VSS), U2.Q2 (VSS), U2.R4 (VSS), U2.S4 (VOLDET), U2.S6 (VSS), U2.S8 (VSS), U2.S9 (VSS), U2.S10 (VSS), U2.S11 (VSS), U2.S12 (VSS), U2.S14 (VSS), U3.2 (GND), U4.10 (GND)
/HITM#: TR09.8 (A7), U1.D19
/HLDA: TR06.6 (A5), U1.U21
/HOLD: R4.1, TR03.4 (A3), U1.C9
/IGNNE#: TR01.3 (A2), U1.J21
/INTR: TR09.6 (A5), U1.K22
/INV: TR02.8 (A7), U1.A15
/KEN#: TR11.7 (A6), U1.E12
/LOCK#: TR07.3 (A2), U1.Y14
/M/IO#: TR15.7 (A6), U1.AB10
/NC_A17: U1.A17
/NC_A18: U1.A18
/NC_A19: U1.A19
/NC_A20: U1.A20
/NC_A22: U1.A22
/NC_AA1: U1.AA1
/NC_AA2: U1.AA2
/NC_B3: U1.B3
/NC_B4: U1.B4
/NC_B22: U1.B22
/NC_C1: U1.C1
/NC_C2: U1.C2
/NC_C18: U1.C18
/NC_C19: U1.C19
/NC_D3: U1.D3
/NC_D4: U1.D4
/NC_D22: U1.D22
/NC_E1: U1.E1
/NC_E2: U1.E2
/NC_E10: U1.E10
/NC_E15: U1.E15
/NC_E16: U1.E16
/NC_E17: U1.E17
/NC_E20: U1.E20
/NC_E22: U1.E22
/NC_F7: U1.F7
/NC_F9: U1.F9
/NC_F10: U1.F10
/NC_F12: U1.F12
/NC_F13: U1.F13
/NC_F14: U1.F14
/NC_F15: U1.F15
/NC_F18: U1.F18
/NC_F19: U1.F19
/NC_F20: U1.F20
/NC_G1: U1.G1
/NC_G2: U1.G2
/NC_G6: U1.G6
/NC_G8: U1.G8
/NC_G10: U1.G10
/NC_G11: U1.G11
/NC_G12: U1.G12
/NC_G13: U1.G13
/NC_G15: U1.G15
/NC_G16: U1.G16
/NC_G17: U1.G17
/NC_G18: U1.G18
/NC_G20: U1.G20
/NC_H6: U1.H6
/NC_H8: U1.H8
/NC_H9: U1.H9
/NC_H10: U1.H10
/NC_H11: U1.H11
/NC_H13: U1.H13
/NC_H14: U1.H14
/NC_H15: U1.H15
/NC_H18: U1.H18
/NC_H20: U1.H20
/NC_J1: U1.J1
/NC_J2: U1.J2
/NC_J7: U1.J7
/NC_J8: U1.J8
/NC_J9: U1.J9
/NC_J11: U1.J11
/NC_J13: U1.J13
/NC_J17: U1.J17
/NC_J18: U1.J18
/NC_K7: U1.K7
/NC_K9: U1.K9
/NC_K16: U1.K16
/NC_K17: U1.K17
/NC_K19: U1.K19
/NC_L1: U1.L1
/NC_L2: U1.L2
/NC_L7: U1.L7
/NC_L8: U1.L8
/NC_L9: U1.L9
/NC_L17: U1.L17
/NC_L18: U1.L18
/NC_M8: U1.M8
/NC_M9: U1.M9
/NC_M16: U1.M16
/NC_M18: U1.M18
/NC_N1: U1.N1
/NC_N2: U1.N2
/NC_N8: U1.N8
/NC_N9: U1.N9
/NC_N16: U1.N16
/NC_N19: U1.N19
/NC_P7: U1.P7
/NC_P8: U1.P8
/NC_P9: U1.P9
/NC_P12: U1.P12
/NC_P14: U1.P14
/NC_P16: U1.P16
/NC_P17: U1.P17
/NC_P18: U1.P18
/NC_P19: U1.P19
/NC_PS1_10: PS1.10 (EN)
/NC_PS3_4: PS3.4 (PG)
/NC_PS4_4: PS4.4 (PG)
/NC_R1: U1.R1
/NC_R2: U1.R2
/NC_R9: U1.R9
/NC_R10: U1.R10
/NC_R11: U1.R11
/NC_R12: U1.R12
/NC_R14: U1.R14
/NC_R15: U1.R15
/NC_R16: U1.R16
/NC_R17: U1.R17
/NC_T9: U1.T9
/NC_T10: U1.T10
/NC_T12: U1.T12
/NC_T13: U1.T13
/NC_T14: U1.T14
/NC_T15: U1.T15
/NC_TR04_A1: TR04.2 (A1)
/NC_TR04_A2: TR04.3 (A2)
/NC_TR04_A3: TR04.4 (A3)
/NC_TR04_B1: TR04.18 (B1)
/NC_TR04_B2: TR04.17 (B2)
/NC_TR04_B3: TR04.16 (B3)
/NC_TR08_A4: TR08.5 (A4)
/NC_TR08_A5: TR08.6 (A5)
/NC_TR08_A6: TR08.7 (A6)
/NC_TR08_A7: TR08.8 (A7)
/NC_TR08_A8: TR08.9 (A8)
/NC_TR08_B4: TR08.15 (B4)
/NC_TR08_B5: TR08.14 (B5)
/NC_TR08_B6: TR08.13 (B6)
/NC_TR08_B7: TR08.12 (B7)
/NC_TR08_B8: TR08.11 (B8)
/NC_TR12_A5: TR12.6 (A5)
/NC_TR12_A6: TR12.7 (A6)
/NC_TR12_A7: TR12.8 (A7)
/NC_TR12_A8: TR12.9 (A8)
/NC_TR12_B5: TR12.14 (B5)
/NC_TR12_B6: TR12.13 (B6)
/NC_TR12_B7: TR12.12 (B7)
/NC_TR12_B8: TR12.11 (B8)
/NC_TR16_A1: TR16.2 (A1)
/NC_TR16_A2: TR16.3 (A2)
/NC_TR16_A3: TR16.4 (A3)
/NC_TR16_B1: TR16.18 (B1)
/NC_TR16_B2: TR16.17 (B2)
/NC_TR16_B3: TR16.16 (B3)
/NC_U1: U1.U1
/NC_U2: U1.U2
/NC_U2_A13: U2.A13 (InternalNC)
/NC_U2_C13: U2.C13 (InternalNC)
/NC_U2_J1: U2.J1 (InternalNC)
/NC_U4_4: U4.4 (DNU)
/NC_U4_5: U4.5 (DNU)
/NC_U4_6: U4.6 (DNU)
/NC_U4_11: U4.11 (DNU)
/NC_U4_12: U4.12 (DNU)
/NC_U4_13: U4.13 (DNU)
/NC_U4_14: U4.14 (DNU)
/NC_U10: U1.U10
/NC_U11: U1.U11
/NC_U12: U1.U12
/NC_U13: U1.U13
/NC_U15: U1.U15
/NC_U16: U1.U16
/NC_U17: U1.U17
/NC_V11: U1.V11
/NC_V14: U1.V14
/NC_V15: U1.V15
/NC_V16: U1.V16
/NC_V18: U1.V18
/NC_W1: U1.W1
/NC_W2: U1.W2
/NC_W16: U1.W16
/NC_Y3: U1.Y3
/NC_Y4: U1.Y4
/NC_Y6: U1.Y6
/NMI: TR01.7 (A6), U1.C21
/PCD: TR07.7 (A6), U1.Y11
/PCHK#: TR13.2 (A1), U1.AB18
/PG_1V1: PS2.4 (PG), PS3.13 (EN), PS4.13 (EN), R29.1
/PG_5V: PS1.14 (PWRGD), PS2.13 (EN), R26.1
/PLOCK#: TR05.7 (A6), U1.AA20
/PS1_BOOT: C5.1, PS1.13 (BOOT)
/PS1_COMP: PS1.8 (COMP), R22.1
/PS1_CZ: C7.1, R22.2
/PS1_FB: PS1.7 (VSENSE), R24.2, R25.1
/PS1_RT: PS1.1 (RT/CLK), R23.1
/PS1_SS: C6.1, PS1.9 (SS/TR)
/PS1_SW: C5.2, L1.1, PS1.11 (PH), PS1.12 (PH)
/PS2_FB: PS2.5 (FB), R27.2, R28.1
/PS2_SS: C11.1, PS2.9 (SS/TR)
/PS2_SW: L2.1, PS2.1 (SW), PS2.2 (SW), PS2.3 (SW)
/PS3_FB: PS3.5 (FB), R30.2, R31.1
/PS3_SS: C15.1, PS3.9 (SS/TR)
/PS3_SW: L3.1, PS3.1 (SW), PS3.2 (SW), PS3.3 (SW)
/PS4_FB: PS4.5 (FB), R32.2, R33.1
/PS4_SS: C19.1, PS4.9 (SS/TR)
/PS4_SW: L4.1, PS4.1 (SW), PS4.2 (SW), PS4.3 (SW)
/PWT: TR07.5 (A4), U1.U20
/RDY#: TR03.3 (A2), U1.L22
/RESET: TR10.2 (A1), U1.B16
/RREF_TL: R21.1, U1.A1
/SMI#: TR09.4 (A3), U1.D21
/SMIACT#: TR10.4 (A3), U1.B15
/SRESET: R6.1, TR02.4 (A3), U1.B13
/STPCLK#: TR11.9 (A8), U1.A5
/S_A2: TR14.11 (B8), U2.Q14 (A2)
/S_A3: TR13.13 (B6), U2.R15 (A3)
/S_A4: TR13.16 (B3), U2.S16 (A4)
/S_A5: TR14.13 (B6), U2.Q12 (A5)
/S_A6: TR05.15 (B4), U2.S15 (A6)
/S_A7: TR14.12 (B7), U2.Q13 (A7)
/S_A8: TR05.18 (B1), U2.R13 (A8)
/S_A9: TR14.14 (B5), U2.Q11 (A9)
/S_A10: TR13.17 (B2), U2.S13 (A10)
/S_A11: TR13.14 (B5), U2.R12 (A11)
/S_A12: TR06.18 (B1), U2.S7 (A12)
/S_A13: TR06.17 (B2), U2.Q10 (A13)
/S_A14: TR14.15 (B4), U2.S5 (A14)
/S_A15: TR05.17 (B2), U2.R7 (A15)
/S_A16: TR06.16 (B3), U2.Q9 (A16)
/S_A17: TR15.12 (B7), U2.Q3 (A17)
/S_A18: TR05.16 (B3), U2.R5 (A18)
/S_A19: TR15.11 (B8), U2.Q4 (A19)
/S_A20: TR06.15 (B4), U2.Q8 (A20)
/S_A20M#: TR11.17 (B2), U2.D15 (A20M)
/S_A21: TR06.12 (B7), U2.Q5 (A21)
/S_A22: TR14.16 (B3), U2.Q7 (A22)
/S_A23: TR14.17 (B2), U2.S3 (A23)
/S_A24: TR14.18 (B1), U2.Q6 (A24)
/S_A25: TR05.14 (B5), U2.R2 (A25)
/S_A26: TR06.13 (B6), U2.S2 (A26)
/S_A27: TR06.11 (B8), U2.S1 (A27)
/S_A28: TR05.12 (B7), U2.R1 (A28)
/S_A29: TR15.16 (B3), U2.P2 (A29)
/S_A30: TR15.15 (B4), U2.P3 (A30)
/S_A31: TR15.14 (B5), U2.Q1 (A31)
/S_ADS#: TR13.15 (B4), U2.S17 (ADS)
/S_AHOLD: TR01.16 (B3), U2.A17 (AHOLD)
/S_BE0#: TR07.14 (B5), U2.K15 (BE0)
/S_BE1#: TR07.12 (B7), U2.J16 (BE1)
/S_BE2#: TR07.11 (B8), U2.J15 (BE2)
/S_BE3#: TR11.14 (B5), U2.F17 (BE3)
/S_BLAST#: TR13.12 (B7), U2.R16 (BLAST)
/S_BOFF#: TR03.11 (B8), U2.D17 (BOFF)
/S_BRDY#: TR04.12 (B7), U2.H15 (BRDY)
/S_BREQ: R2.1, TR05.11 (B8), U2.Q15 (BREQ)
/S_BS8#: TR03.13 (B6), U2.D16 (BS8)
/S_BS16#: TR02.11 (B8), U2.C17 (BS16)
/S_CACHE#: TR01.14 (B5), U2.B12 (CACHE)
/S_CLK: TR11.16 (B3), U2.C3 (CLK)
/S_CLKMUL: TR13.11 (B8), U2.R17 (CLKMUL)
/S_D0: TR15.17 (B2), U2.P1 (D0)
/S_D1: TR16.11 (B8), U2.N2 (D1)
/S_D2: TR16.12 (B7), U2.N1 (D2)
/S_D3: TR12.15 (B4), U2.H2 (D3)
/S_D4: TR08.18 (B1), U2.M3 (D4)
/S_D5: TR08.16 (B3), U2.J2 (D5)
/S_D6: TR16.14 (B5), U2.L2 (D6)
/S_D7: TR16.13 (B6), U2.L3 (D7)
/S_D8: TR12.17 (B2), U2.F2 (D8)
/S_D9: TR04.11 (B8), U2.D1 (D9)
/S_D10: TR12.18 (B1), U2.E3 (D10)
/S_D11: TR11.15 (B4), U2.C1 (D11)
/S_D12: TR04.15 (B4), U2.G3 (D12)
/S_D13: TR11.12 (B7), U2.D2 (D13)
/S_D14: TR08.17 (B2), U2.K3 (D14)
/S_D15: TR04.13 (B6), U2.F3 (D15)
/S_D16: TR16.15 (B4), U2.J3 (D16)
/S_D17: TR03.18 (B1), U2.D3 (D17)
/S_D18: TR03.15 (B4), U2.C2 (D18)
/S_D19: TR09.11 (B8), U2.B1 (D19)
/S_D20: TR03.14 (B5), U2.A1 (D20)
/S_D21: TR09.13 (B6), U2.B2 (D21)
/S_D22: TR03.12 (B7), U2.A2 (D22)
/S_D23: TR02.18 (B1), U2.A4 (D23)
/S_D24: TR02.15 (B4), U2.A6 (D24)
/S_D25: TR09.15 (B4), U2.B6 (D25)
/S_D26: TR10.11 (B8), U2.C7 (D26)
/S_D27: TR11.18 (B1), U2.C6 (D27)
/S_D28: TR10.13 (B6), U2.C8 (D28)
/S_D29: TR10.17 (B2), U2.A8 (D29)
/S_D30: TR10.14 (B5), U2.C9 (D30)
/S_D31: TR01.15 (B4), U2.B8 (D31)
/S_DP0: TR15.18 (B1), U2.N3 (DP0)
/S_DP1: TR04.14 (B5), U2.F1 (DP1)
/S_DP2: TR12.16 (B3), U2.H3 (DP2)
/S_DP3: TR02.17 (B2), U2.A5 (DP3)
/S_D/C#: TR07.16 (B3), U2.M15 (D_C)
/S_EADS#: TR01.11 (B8), U2.B17 (EADS)
/S_FERR#: TR02.14 (B5), U2.C14 (FERR)
/S_FLUSH#: TR02.13 (B6), U2.C15 (FLUSH)
/S_HITM#: TR09.12 (B7), U2.A12 (HITM)
/S_HLDA: R1.1, TR06.14 (B5), U2.P15 (HLDA)
/S_HOLD: TR03.16 (B3), U2.E15 (HOLD)
/S_IGNNE#: TR01.17 (B2), U2.A15 (IGNNE)
/S_INTR: TR09.14 (B5), U2.A16 (INTR)
/S_INV: TR02.12 (B7), U2.A10 (INV)
/S_KEN#: TR11.13 (B6), U2.F15 (KEN)
/S_LOCK#: TR07.17 (B2), U2.N15 (LOCK)
/S_M/IO#: TR15.13 (B6), U2.N16 (M_IO)
/S_NMI: TR01.13 (B6), U2.B15 (NMI)
/S_PCD: TR07.13 (B6), U2.J17 (PCD)
/S_PCHK#: TR13.18 (B1), U2.Q17 (PCHK)
/S_PLOCK#: TR05.13 (B6), U2.Q16 (PLOCK)
/S_PWT: TR07.15 (B4), U2.L15 (PWT)
/S_RDY#: TR03.17 (B2), U2.F16 (RDY)
/S_RESET: R3.1, TR10.18 (B1), U2.C16 (RESET)
/S_SMI#: TR09.16 (B3), U2.B10 (SMI)
/S_SMIACT#: TR10.16 (B3), U2.C12 (SMIACT)
/S_SRESET: TR02.16 (B3), U2.C10 (SRESET)
/S_STPCLK#: TR11.11 (B8), U2.G15 (STPCLK)
/S_TCK: TR10.12 (B7), U2.A3 (TCK)
/S_TDI: TR01.18 (B1), U2.A14 (TDI)
/S_TDO: TR01.12 (B7), U2.B16 (TDO)
/S_TMS: TR09.18 (B1), U2.B14 (TMS)
/S_UP#: TR10.15 (B4), U2.C11 (UP)
/S_VCC: R34.1, U2.B7 (VCC), U2.B9 (VCC), U2.B11 (VCC), U2.C4 (VCC), U2.C5 (VCC), U2.E2 (VCC), U2.E16 (VCC), U2.G2 (VCC), U2.G16 (VCC), U2.H16 (VCC), U2.K2 (VCC), U2.K16 (VCC), U2.L16 (VCC), U2.M2 (VCC), U2.M16 (VCC), U2.P16 (VCC), U2.R3 (VCC), U2.R6 (VCC), U2.R8 (VCC), U2.R9 (VCC), U2.R10 (VCC), U2.R11 (VCC), U2.R14 (VCC)
/S_WB/WT#: TR09.17 (B2), U2.B13 (WB_WT)
/S_W/R#: TR07.18 (B1), U2.N17 (W_R)
/TCK: TR10.8 (A7), U1.C13
/TDI: TR01.2 (A1), U1.B18
/TDO: TR01.8 (A7), U1.J22
/TMS: TR09.2 (A1), U1.G22
/UP#: R8.1, TR10.5 (A4), U1.K21
/V3V3: C17.1, C75.1, C76.1, C77.1, C78.1, C79.1, C80.1, C81.1, C82.1, C83.1, C84.1, C85.1, C86.1, C87.1, C88.1, C89.1, C90.1, C91.1, C92.1, C93.1, C94.1, C103.1, C104.1, C105.1, C106.1, C107.1, C108.1, C109.1, C110.1, C111.1, C112.1, C113.1, C114.1, C115.1, C116.1, C117.1, C118.1, C119.1, C120.1, C121.1, L4.2, PS4.14 (VOS), R8.2, R9.2, R10.2, R11.2, R12.2, R13.2, R14.2, R15.2, R17.2, R19.2, R20.2, R32.1, R36.2, R37.2, TR01.20 (VCC), TR02.20 (VCC), TR03.20 (VCC), TR04.20 (VCC), TR05.20 (VCC), TR06.20 (VCC), TR07.20 (VCC), TR08.20 (VCC), TR09.20 (VCC), TR10.20 (VCC), TR11.20 (VCC), TR12.20 (VCC), TR13.20 (VCC), TR14.20 (VCC), TR15.20 (VCC), TR16.20 (VCC), U1.A6, U1.A16, U1.AA16, U1.AA21, U1.B19, U1.C7, U1.C10, U1.C12, U1.C22, U1.D8, U1.D14, U1.D15, U1.D16, U1.E8, U1.E11, U1.E18, U1.F3, U1.F8, U1.F11, U1.F21, U1.G7, U1.G14, U1.H17, U1.J6, U1.K18, U1.L6, U1.M17, U1.M19, U1.N18, U1.P20, U1.P21, U1.R8, U1.R18, U1.R19, U1.T6, U1.T11, U1.U14, U1.U19, U1.V8, U1.W6, U1.W10, U1.W11, U1.W12, U1.W14, U1.W15, U1.W17, U1.W20, U1.Y8, U1.Y13, U4.2 (VCC), U4.3 (RESET#)
/V5: C3.1, C4.1, C8.1, C10.1, C12.1, C14.1, C16.1, C18.1, C21.1, L1.2, PS2.10 (AVIN), PS2.11 (PVIN), PS2.12 (PVIN), PS3.10 (AVIN), PS3.11 (PVIN), PS3.12 (PVIN), PS4.10 (AVIN), PS4.11 (PVIN), PS4.12 (PVIN), R24.1, R26.2, R29.2, U3.5 (VDD)
/V12: C1.1, C2.1, F1.2, PS1.4 (PVIN), PS1.5 (PVIN), PS1.6 (VIN)
/V12_IN: F1.1, J3.1
/VCCA_FPLL25: C98.1, FB1.2, U1.F4, U1.H19, U1.M3, U1.T3, U1.T5, U1.U18
/VCC_1V1: C9.1, C22.1, C23.1, C24.1, C25.1, C26.1, C27.1, C28.1, C29.1, C30.1, C31.1, C32.1, C33.1, C34.1, C35.1, C36.1, C37.1, C38.1, C39.1, C40.1, C41.1, C42.1, C43.1, C44.1, C45.1, C46.1, C47.1, C48.1, C49.1, C50.1, C51.1, C52.1, C53.1, C54.1, C55.1, C56.1, C57.1, C58.1, C59.1, C60.1, C61.1, C62.1, C63.1, C64.1, C65.1, C66.1, C67.1, C68.1, C69.1, C70.1, C71.1, C72.1, C73.1, C74.1, C99.1, C100.1, C101.1, C102.1, L2.2, PS2.14 (VOS), R27.1, U1.J4, U1.J10, U1.J12, U1.J14, U1.J16, U1.K3, U1.K5, U1.K11, U1.K13, U1.K15, U1.L4, U1.L10, U1.L12, U1.L14, U1.L16, U1.M11, U1.M13, U1.M15, U1.N4, U1.N10, U1.N12, U1.N14, U1.P3, U1.P11, U1.P13, U1.P15
/VCC_AUX25: C13.1, C95.1, C96.1, C97.1, FB1.1, L3.2, PS3.14 (VOS), R30.1, U1.A3, U1.D11, U1.D18, U1.E6, U1.W7, U1.W13, U1.W18
/VCORE_OK: R37.1, U1.L19, U3.1 (OUTA)
/VCORE_SENSE: C20.1, R34.2, R35.1, U3.3 (INA+), U3.4 (INB-)
/WB/WT#: R7.1, TR09.3 (A2), U1.B21
/W/R#: TR07.2 (A1), U1.AA13

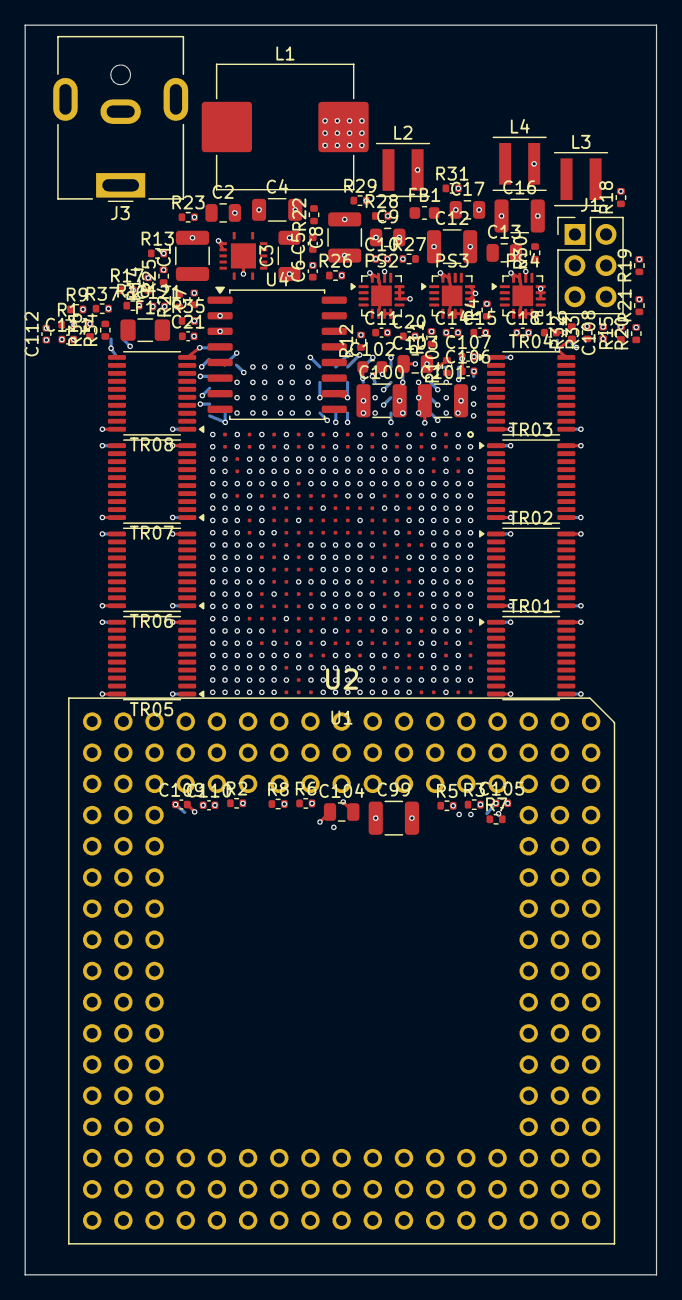
[picture p10: board socket3-cyclonev.kicad_pcb from above]

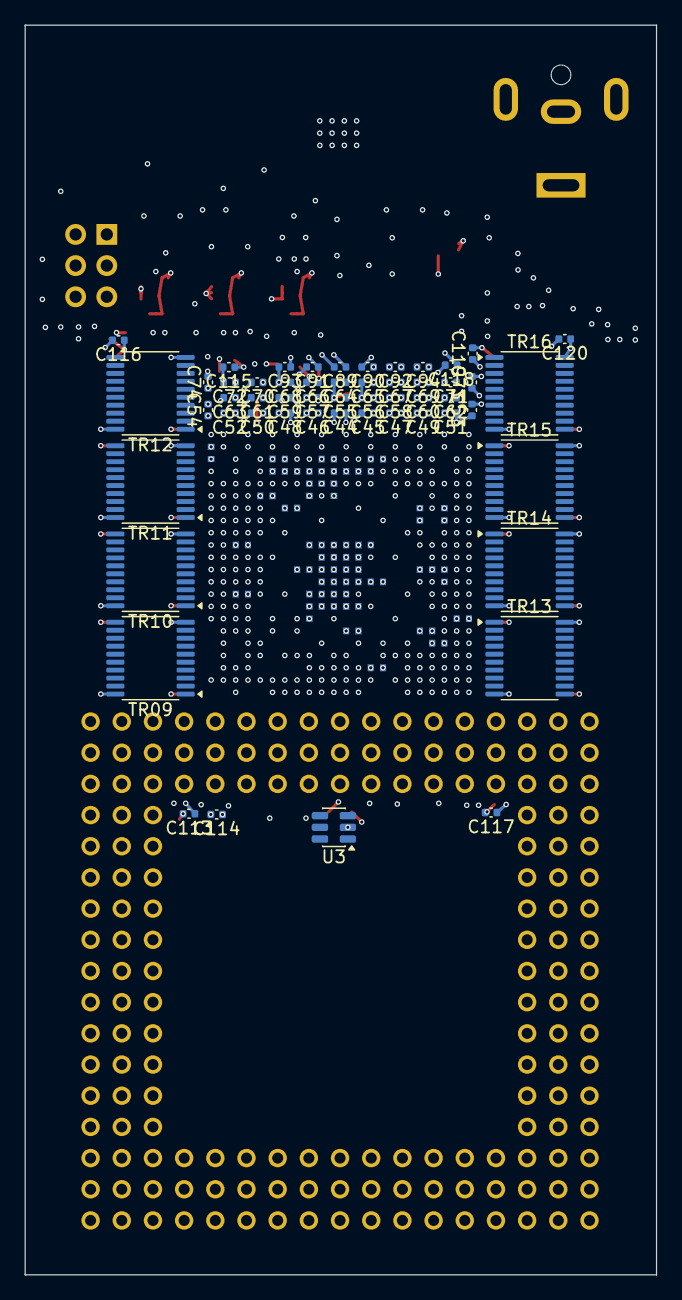
[picture p11: board socket3-cyclonev.kicad_pcb from below]

Board: 8 copper layers, 51.4 x 101.8 mm, 190 parts (94 on the bottom side), 270 nets.
