alphaonex86/FPGA-CPU/hw/socket7-cyclonev/socket7-cyclonev.kicad_pcb

## KiCad design hw/socket7-cyclonev/socket7-cyclonev.kicad_pcb (2026-11-11)

Schematic: socket7-cyclonev.kicad_sch, Socket 7 interposer: 5CEBA9, direct 3.3 V bus

Parts:
C1: 22uF/10V; C_0805_2012Metric
C2, C53, C54, C55, C75, C76, C77, C88: 100nF; C_0402_1005Metric
C3, C84: 22uF/6.3V; C_0805_2012Metric
C4: 1nF; C_0402_1005Metric
C5: 10uF/10V; C_0805_2012Metric
C6, C59, C78, C79: 1uF; C_0402_1005Metric
C7, C8, C9, C10, C11, C12, C13, C14, C15, C16, C17, C18, C19, C63, C64, C65, C66: 4.7nF; C_0402_P1.00
C20, C21, C22, C23, C24, C25, C26, C27, C28, C67, C68, C69, C70, C80: 10nF; C_0402_P1.00
C29, C30, C31, C32, C33, C34, C35, C36: 10nF; C_0402_1005Metric
C37, C38, C39, C40, C41, C42, C43, C44, C45, C46, C47, C48: 22nF; C_0402_1005Metric
C49, C50, C51, C52, C74: 47nF; C_0402_1005Metric
C56, C57: 220nF; C_0402_1005Metric
C58: 470nF; C_0402_1005Metric
C60, C61, C62: 2.2nF; C_0402_P1.00
C71, C72: 22nF; C_0402_P1.00
C73: 47nF; C_0402_P1.00
C81, C83: 100nF; C_0402_P1.00
C82: 1uF; C_0402_P1.00
C85: 10uF; C_0805_2012Metric
C86: 22uF; C_0805_2012Metric
C87: 4.7uF; C_0603_1608Metric
FB1: BLM18AG601SN1D; L_0603_1608Metric
J1: Conn_02x03_Odd_Even; PinHeader_2x03_P2.54mm_Vertical
L1: 1uH XFL4020-102; L_Coilcraft_XxL4020
PS1: TLV62585PDRL; SOT-563
PS2: TLV75725PDBVR; SOT-23-5
R1, R2, R3, R4, R5, R6, R7: 4k7; R_0402_1005Metric
R8, R9, R10, R11, R12, R14, R15: 10k; R_0402_1005Metric
R13: 1k; R_0402_1005Metric
R16: 2k0 1%; R_0402_1005Metric
R17: 82.5k; R_0402_1005Metric
R18, R19: 100k; R_0402_1005Metric
U1: FPGA_CycloneV_5CEFA9_F484; FPGA_CycloneV_5CEFA9_F484_BGA
U2: Intel_Pentium_MMX_P55C_Socket7; Socket7_Base_PGA296
U3: TPS22918DBVR; SOT-23-6
U4: MT25QL01GBBB8ESF-0SIT; SOIC-16W_7.5x10.3mm_P1.27mm

Connections:
/A3: U1.B7, U2.AL35 (A3)
/A4: U1.A7, U2.AM34 (A4)
/A5: U1.C9, U2.AK32 (A5)
/A6: U1.C11, U2.AN33 (A6)
/A7: U1.E12, U2.AL33 (A7)
/A8: U1.D12, U2.AM32 (A8)
/A9: U1.F14, U2.AK30 (A9)
/A10: U1.A10, U2.AN31 (A10)
/A11: U1.A8, U2.AL31 (A11)
/A12: U1.A9, U2.AL29 (A12)
/A13: U1.B10, U2.AK28 (A13)
/A14: U1.B11, U2.AL27 (A14)
/A15: U1.D13, U2.AK26 (A15)
/A16: U1.E14, U2.AL25 (A16)
/A17: U1.B12, U2.AK24 (A17)
/A18: U1.C13, U2.AL23 (A18)
/A19: U1.A12, U2.AK22 (A19)
/A20: U1.B13, U2.AL21 (A20)
/A20M#: U1.E16, U2.AK08 (A20M#)
/A21: U1.E9, U2.AF34 (A21)
/A22: U1.C6, U2.AH36 (A22)
/A23: U1.D6, U2.AE33 (A23)
/A24: U1.D7, U2.AG35 (A24)
/A25: U1.D9, U2.AJ35 (A25)
/A26: U1.B5, U2.AH34 (A26)
/A27: R7.1, U1.F12, U2.AG33 (A27)
/A28: U1.B6, U2.AK36 (A28)
/A29: U1.A5, U2.AK34 (A29)
/A30: U1.F13, U2.AM36 (A30)
/A31: U1.C8, U2.AJ33 (A31)
/ADS#: U1.C20, U2.AJ05 (ADS#)
/ADSC#: U1.C21, U2.AM02 (ADSC#)
/AHOLD: U1.K22, U2.V04 (AHOLD)
/AP: U1.D21, U2.AK02 (AP)
/APCHK#: U1.F22, U2.AE05 (APCHK#)
/AS_DATA0: U1.AB4, U4.15 (DQ0)
/AS_DATA1: U1.AB3, U4.8 (DQ1)
/AS_DATA2: U1.AA5, U4.9 (DQ2)
/AS_DATA3: R12.1, U1.T4, U4.1 (DQ3)
/AS_DCLK: R11.1, U1.V3, U4.16 (C)
/AS_nCS: U1.R4, U4.7 (S#)
/BE0#: U1.F15, U2.AL09 (BE0#)
/BE1#: U1.B17, U2.AK10 (BE1#)
/BE2#: U1.C16, U2.AL11 (BE2#)
/BE3#: U1.E15, U2.AK12 (BE3#)
/BE4#: U1.B16, U2.AL13 (BE4#)
/BE5#: U1.C15, U2.AK14 (BE5#)
/BE6#: U1.B15, U2.AL15 (BE6#)
/BE7#: U1.A15, U2.AK16 (BE7#)
/BOFF#: U1.J19, U2.Z04 (BOFF#)
/BP2: R5.1, U1.M22, U2.S03 (BP2)
/BP3: R6.1, U1.M21, U2.S05 (BP3)
/BRDY#: U1.K19, U2.X04 (BRDY#)
/BRDYC#: U1.J22, U2.Y03 (BRDYC#)
/BREQ: R1.1, U1.J17, U2.AJ01 (BREQ)
/BUSCHK#: U1.D17, U2.AL07 (BUSCHK#)
/CACHE#: U1.L22, U2.U03 (CACHE#)
/CFG_CLKUSR: U1.T8
/CFG_CONF_DONE: R9.1, U1.K6
/CFG_CRC_ERROR: U1.T17
/CFG_CvP_CONFDONE: U1.R22
/CFG_DATA5: U1.U7
/CFG_DATA6: U1.R6
/CFG_DATA7: U1.U8
/CFG_DATA8: U1.R5
/CFG_DATA9: U1.W8
/CFG_DATA10: U1.P6
/CFG_DATA11: U1.W9
/CFG_DATA12: U1.N6
/CFG_DATA13: U1.U6
/CFG_DATA14: U1.T7
/CFG_DATA15: U1.V6
/CFG_DEV_CLRn: U1.P22
/CFG_DEV_OE: U1.R21
/CFG_INIT_DONE: U1.T18
/CFG_PR_DONE: U1.M6
/CFG_PR_ERROR: U1.M7
/CFG_PR_READY: U1.R7
/CFG_PR_REQUEST: U1.T20
/CFG_nCEO: U1.T22
/CFG_nCONFIG: R10.1, U1.A4
/CFG_nSTATUS: R8.1, U1.H5
/CLK: U1.W16, U2.AK18 (CLK)
/CPUTYP: U1.L7, U2.Q35 (CPUTYP)
/D0: U1.T9, U2.K34 (D0)
/D1: U1.U10, U2.G35 (D1)
/D2: U1.T10, U2.J35 (D2)
/D3: U1.V9, U2.G33 (D3)
/D4: U1.T12, U2.F36 (D4)
/D5: U1.U11, U2.F34 (D5)
/D6: U1.T13, U2.E35 (D6)
/D7: U1.T14, U2.E33 (D7)
/D8: U1.AB5, U2.D34 (D8)
/D9: U1.U12, U2.C37 (D9)
/D10: U1.AA7, U2.C35 (D10)
/D11: U1.AB6, U2.B36 (D11)
/D12: U1.Y9, U2.D32 (D12)
/D13: U1.AA8, U2.B34 (D13)
/D14: U1.U13, U2.C33 (D14)
/D15: U1.AB7, U2.A35 (D15)
/D16: U1.AB8, U2.B32 (D16)
/D17: U1.AA9, U2.C31 (D17)
/D18: U1.T15, U2.A33 (D18)
/D19: U1.V13, U2.D28 (D19)
/D20: U1.AA10, U2.B30 (D20)
/D21: U1.Y11, U2.C29 (D21)
/D22: U1.AB10, U2.A31 (D22)
/D23: U1.AB11, U2.D26 (D23)
/D24: U1.U15, U2.C27 (D24)
/D25: U1.AA13, U2.C23 (D25)
/D26: U1.AB12, U2.D24 (D26)
/D27: U1.AB13, U2.C21 (D27)
/D28: U1.Y14, U2.D22 (D28)
/D29: U1.Y15, U2.C19 (D29)
/D30: U1.AA14, U2.D20 (D30)
/D31: U1.AB15, U2.C17 (D31)
/D32: U1.Y16, U2.C15 (D32)
/D33: U1.U16, U2.D16 (D33)
/D34: U1.AA17, U2.C13 (D34)
/D35: U1.AB17, U2.D14 (D35)
/D36: U1.AB18, U2.C11 (D36)
/D37: U1.Y17, U2.D12 (D37)
/D38: U1.AA19, U2.C09 (D38)
/D39: U1.AA18, U2.D10 (D39)
/D40: U1.U17, U2.D08 (D40)
/D41: U1.AA20, U2.A05 (D41)
/D42: U1.AB20, U2.E09 (D42)
/D43: U1.Y20, U2.B04 (D43)
/D44: U1.V18, U2.D06 (D44)
/D45: U1.W19, U2.C05 (D45)
/D46: U1.AB21, U2.E07 (D46)
/D47: U1.AA22, U2.C03 (D47)
/D48: U1.Y21, U2.D04 (D48)
/D49: U1.V19, U2.E05 (D49)
/D50: U1.R16, U2.D02 (D50)
/D51: U1.W21, U2.F04 (D51)
/D52: U1.Y22, U2.E03 (D52)
/D53: U1.V20, U2.G05 (D53)
/D54: U1.R17, U2.E01 (D54)
/D55: U1.V21, U2.G03 (D55)
/D56: U1.U20, U2.H04 (D56)
/D57: U1.U21, U2.J03 (D57)
/D58: U1.T19, U2.J05 (D58)
/D59: U1.P17, U2.K04 (D59)
/D60: U1.U22, U2.L05 (D60)
/D61: U1.P18, U2.L03 (D61)
/D62: U1.P19, U2.M04 (D62)
/D63: U1.N20, U2.N03 (D63)
/DP0: U1.V10, U2.D36 (DP0)
/DP1: U1.Y10, U2.D30 (DP1)
/DP2: U1.AA12, U2.C25 (DP2)
/DP3: U1.AA15, U2.D18 (DP3)
/DP4: U1.Y19, U2.C07 (DP4)
/DP5: U1.AB22, U2.F06 (DP5)
/DP6: U1.W22, U2.F02 (DP6)
/DP7: U1.N19, U2.N05 (DP7)
/D/C#: U1.B21, U2.AK04 (D/C#)
/EADS#: U1.D19, U2.AM04 (EADS#)
/EWBE#: U1.K21, U2.W03 (EWBE#)
/FERR#: U1.N21, U2.Q05 (FERR#)
/FLUSH#: U1.B18, U2.AN07 (FLUSH#)
/F_TCK: J1.1, R13.1, U1.V5
/F_TDI: J1.5, R15.1, U1.W5
/F_TDO: J1.6, U1.M5
/F_TMS: J1.3, R14.1, U1.P5
/GND: C1.2, C2.2, C3.2, C4.2, C5.2, C6.2, C7.2, C8.2, C9.2, C10.2, C11.2, C12.2, C13.2, C14.2, C15.2, C16.2, C17.2, C18.2, C19.2, C20.2, C21.2, C22.2, C23.2, C24.2, C25.2, C26.2, C27.2, C28.2, C29.2, C30.2, C31.2, C32.2, C33.2, C34.2, C35.2, C36.2, C37.2, C38.2, C39.2, C40.2, C41.2, C42.2, C43.2, C44.2, C45.2, C46.2, C47.2, C48.2, C49.2, C50.2, C51.2, C52.2, C53.2, C54.2, C55.2, C56.2, C57.2, C58.2, C59.2, C60.2, C61.2, C62.2, C63.2, C64.2, C65.2, C66.2, C67.2, C68.2, C69.2, C70.2, C71.2, C72.2, C73.2, C74.2, C75.2, C76.2, C77.2, C78.2, C79.2, C80.2, C81.2, C82.2, C83.2, C84.2, C85.2, C86.2, C87.2, C88.2, J1.2, J1.4, PS1.1 (GND), PS2.2 (GND), R1.2, R2.2, R3.2, R4.2, R5.2, R6.2, R7.2, R11.2, R13.2, R16.2, R18.2, U1.A2, U1.A11, U1.A21, U1.AA3, U1.AA4, U1.AA6, U1.AA11, U1.AB1, U1.AB2, U1.AB9, U1.AB14, U1.AB16, U1.AB19, U1.B1, U1.B2, U1.B8, U1.B9, U1.B14, U1.C3, U1.C4, U1.C5, U1.C14, U1.C17, U1.D1, U1.D2, U1.D5, U1.D10, U1.D20, U1.E3, U1.E4, U1.E5, U1.E13, U1.F1, U1.F2, U1.F5, U1.F6, U1.F16, U1.F17, U1.G3, U1.G4, U1.G5, U1.G9, U1.G19, U1.H1, U1.H2, U1.H3, U1.H4, U1.H7, U1.H12, U1.H22, U1.J3, U1.J5, U1.J15, U1.J20, U1.K1, U1.K2, U1.K4, U1.K8, U1.K10, U1.K12, U1.K14, U1.L3, U1.L5, U1.L11, U1.L13, U1.L15, U1.L20, U1.L21, U1.M1, U1.M2, U1.M4, U1.M10, U1.M12, U1.M14, U1.N3, U1.N5, U1.N7, U1.N11, U1.N13, U1.N15, U1.N17, U1.N22, U1.P1, U1.P2, U1.P4, U1.P10, U1.R3, U1.R13, U1.R20, U1.T1, U1.T2, U1.T16, U1.T21, U1.U3, U1.U4, U1.U5, U1.U9, U1.V1, U1.V2, U1.V4, U1.V7, U1.V12, U1.V17, U1.V22, U1.W3, U1.W4, U1.Y1, U1.Y2, U1.Y5, U1.Y7, U1.Y12, U1.Y18, U2.AB02 (VSS), U2.AB36 (VSS), U2.AD02 (VSS), U2.AD36 (VSS), U2.AF02 (VSS), U2.AF36 (VSS), U2.AH02 (VSS), U2.AJ37 (VSS), U2.AL37 (VSS), U2.AM08 (VSS), U2.AM10 (VSS), U2.AM12 (VSS), U2.AM14 (VSS), U2.AM16 (VSS), U2.AM18 (VSS), U2.AM20 (VSS), U2.AM22 (VSS), U2.AM24 (VSS), U2.AM26 (VSS), U2.AM28 (VSS), U2.AM30 (VSS), U2.AN37 (VSS), U2.B06 (VSS), U2.B08 (VSS), U2.B10 (VSS), U2.B12 (VSS), U2.B14 (VSS), U2.B16 (VSS), U2.B18 (VSS), U2.B20 (VSS), U2.B22 (VSS), U2.B24 (VSS), U2.B26 (VSS), U2.B28 (VSS), U2.H02 (VSS), U2.H36 (VSS), U2.K02 (VSS), U2.K36 (VSS), U2.M02 (VSS), U2.M36 (VSS), U2.P02 (VSS), U2.P36 (VSS), U2.R02 (VSS), U2.R36 (VSS), U2.T02 (VSS), U2.T36 (VSS), U2.U35 (VSS), U2.V02 (VSS), U2.V36 (VSS), U2.X02 (VSS), U2.X36 (VSS), U2.Z02 (VSS), U2.Z36 (VSS), U3.2 (GND), U4.10 (GND)
/HIT#: U1.B20, U2.AK06 (HIT#)
/HITM#: U1.G16, U2.AL05 (HITM#)
/HLDA: U1.E21, U2.AJ03 (HLDA)
/HOLD: U1.G22, U2.AB04 (HOLD)
/IERR#: U1.M18, U2.P04 (IERR#)
/IGNNE#: U1.G8, U2.AA35 (IGNNE#)
/INIT: U1.G11, U2.AA33 (INIT)
/INTR/LINT0: U1.E7, U2.AD34 (INTR/LINT0)
/INV: U1.L19, U2.U05 (INV)
/KEN#: U1.K20, U2.W05 (KEN#)
/LOCK#: U1.G18, U2.AH04 (LOCK#)
/M/IO#: U1.L18, U2.T04 (M/IO#)
/NA#: U1.J21, U2.Y05 (NA#)
/NC_A17: U1.A17
/NC_A18: U1.A18
/NC_A19: U1.A19
/NC_A20: U1.A20
/NC_A22: U1.A22
/NC_AA1: U1.AA1
/NC_AA2: U1.AA2
/NC_B3: U1.B3
/NC_B4: U1.B4
/NC_B22: U1.B22
/NC_C1: U1.C1
/NC_C2: U1.C2
/NC_C18: U1.C18
/NC_C19: U1.C19
/NC_D3: U1.D3
/NC_D4: U1.D4
/NC_D22: U1.D22
/NC_E1: U1.E1
/NC_E2: U1.E2
/NC_E10: U1.E10
/NC_E17: U1.E17
/NC_E20: U1.E20
/NC_E22: U1.E22
/NC_F9: U1.F9
/NC_F10: U1.F10
/NC_F18: U1.F18
/NC_F19: U1.F19
/NC_F20: U1.F20
/NC_G1: U1.G1
/NC_G2: U1.G2
/NC_G10: U1.G10
/NC_G13: U1.G13
/NC_G20: U1.G20
/NC_H8: U1.H8
/NC_H9: U1.H9
/NC_H10: U1.H10
/NC_H11: U1.H11
/NC_H13: U1.H13
/NC_H14: U1.H14
/NC_H15: U1.H15
/NC_H16: U1.H16
/NC_H20: U1.H20
/NC_J1: U1.J1
/NC_J2: U1.J2
/NC_J8: U1.J8
/NC_J9: U1.J9
/NC_J11: U1.J11
/NC_J13: U1.J13
/NC_K9: U1.K9
/NC_K16: U1.K16
/NC_L1: U1.L1
/NC_L2: U1.L2
/NC_L9: U1.L9
/NC_M8: U1.M8
/NC_M9: U1.M9
/NC_M16: U1.M16
/NC_N1: U1.N1
/NC_N2: U1.N2
/NC_N9: U1.N9
/NC_N16: U1.N16
/NC_P9: U1.P9
/NC_P12: U1.P12
/NC_P14: U1.P14
/NC_P16: U1.P16
/NC_PS2_4: PS2.4 (NC)
/NC_R1: U1.R1
/NC_R2: U1.R2
/NC_R10: U1.R10
/NC_R11: U1.R11
/NC_R12: U1.R12
/NC_R14: U1.R14
/NC_R15: U1.R15
/NC_U1: U1.U1
/NC_U2: U1.U2
/NC_U4_4: U4.4 (DNU)
/NC_U4_5: U4.5 (DNU)
/NC_U4_6: U4.6 (DNU)
/NC_U4_11: U4.11 (DNU)
/NC_U4_12: U4.12 (DNU)
/NC_U4_13: U4.13 (DNU)
/NC_U4_14: U4.14 (DNU)
/NC_V11: U1.V11
/NC_V14: U1.V14
/NC_V15: U1.V15
/NC_V16: U1.V16
/NC_W1: U1.W1
/NC_W2: U1.W2
/NC_Y3: U1.Y3
/NC_Y4: U1.Y4
/NC_Y6: U1.Y6
/NMI/LINT1: U1.G12, U2.AC33 (NMI/LINT1)
/PCD: U1.H18, U2.AG05 (PCD)
/PCHK#: U1.K17, U2.AF04 (PCHK#)
/PEN#: U1.G6, U2.Z34 (PEN#)
/PG_1V1: PS1.6 (PG), PS2.3 (EN), R19.1, U3.3 (ON)
/PM0/BP0: R3.1, U1.L17, U2.Q03 (PM0/BP0)
/PM1/BP1: R4.1, U1.M20, U2.R04 (PM1/BP1)
/PRDY: U1.G21, U2.AC05 (PRDY)
/PS1_FB: PS1.5 (FB), R17.2, R18.1
/PS1_SW: L1.1, PS1.2 (SW)
/PWT: U1.E19, U2.AL03 (PWT)
/RESET: U1.A13, U2.AK20 (RESET)
/RREF_TL: R16.1, U1.A1
/SCYC: R2.1, U1.A14, U2.AL17 (SCYC)
/SMI#: U1.F7, U2.AB34 (SMI#)
/SMIACT#: U1.J18, U2.AG03 (SMIACT#)
/STPCLK#: U1.K7, U2.V34 (STPCLK#)
/S_VCC2: C1.1, C2.1, PS1.3 (VIN), PS1.4 (EN), U2.A07 (VCC2), U2.A09 (VCC2), U2.A11 (VCC2), U2.A13 (VCC2), U2.A15 (VCC2), U2.A17 (VCC2), U2.AA01 (VCC2), U2.AC01 (VCC2), U2.AE01 (VCC2), U2.AG01 (VCC2), U2.AN09 (VCC2), U2.AN11 (VCC2), U2.AN13 (VCC2), U2.AN15 (VCC2), U2.AN17 (VCC2), U2.AN19 (VCC2), U2.G01 (VCC2), U2.J01 (VCC2), U2.L01 (VCC2), U2.N01 (VCC2), U2.Q01 (VCC2), U2.S01 (VCC2), U2.U01 (VCC2), U2.W01 (VCC2), U2.Y01 (VCC2)
/S_VCC3: C5.1, C6.1, PS2.1 (IN), U2.A19 (VCC3), U2.A21 (VCC3), U2.A23 (VCC3), U2.A25 (VCC3), U2.A27 (VCC3), U2.A29 (VCC3), U2.AA37 (VCC3), U2.AC37 (VCC3), U2.AE37 (VCC3), U2.AG37 (VCC3), U2.AN21 (VCC3), U2.AN23 (VCC3), U2.AN25 (VCC3), U2.AN27 (VCC3), U2.AN29 (VCC3), U2.E37 (VCC3), U2.G37 (VCC3), U2.J37 (VCC3), U2.L33 (VCC3), U2.L37 (VCC3), U2.N37 (VCC3), U2.Q37 (VCC3), U2.S37 (VCC3), U2.T34 (VCC3), U2.U33 (VCC3), U2.U37 (VCC3), U2.W37 (VCC3), U2.Y37 (VCC3), U3.1 (VIN)
/TCK: U1.R9, U2.M34 (TCK)
/TDI: U1.P7, U2.N35 (TDI)
/TDO: U1.P8, U2.N33 (TDO)
/TMS: U1.N8, U2.P34 (TMS)
/TRST#: U1.L8, U2.Q33 (TRST#)
/U3_CT: C4.1, U3.4 (CT)
/VCC2DET#: U1.G17, U2.AL01 (VCC2DET#)
/VCCA_FPLL25: C83.1, FB1.2, U1.F4, U1.H19, U1.M3, U1.T3, U1.T5, U1.U18
/VCCIO33: C60.1, C61.1, C62.1, C63.1, C64.1, C65.1, C66.1, C67.1, C68.1, C69.1, C70.1, C71.1, C72.1, C73.1, C74.1, C75.1, C76.1, C77.1, C78.1, C79.1, C85.1, C86.1, C88.1, R8.2, R9.2, R10.2, R12.2, R14.2, R15.2, U1.A6, U1.A16, U1.AA16, U1.AA21, U1.B19, U1.C7, U1.C10, U1.C12, U1.C22, U1.D8, U1.D14, U1.D15, U1.D16, U1.E8, U1.E11, U1.E18, U1.F3, U1.F8, U1.F11, U1.F21, U1.G7, U1.G14, U1.H17, U1.J6, U1.K18, U1.L6, U1.M17, U1.M19, U1.N18, U1.P20, U1.P21, U1.R8, U1.R18, U1.R19, U1.T6, U1.T11, U1.U14, U1.U19, U1.V8, U1.W6, U1.W10, U1.W11, U1.W12, U1.W14, U1.W15, U1.W17, U1.W20, U1.Y8, U1.Y13, U3.5 (QOD), U3.6 (VOUT), U4.2 (VCC), U4.3 (RESET#)
/VCC_1V1: C3.1, C7.1, C8.1, C9.1, C10.1, C11.1, C12.1, C13.1, C14.1, C15.1, C16.1, C17.1, C18.1, C19.1, C20.1, C21.1, C22.1, C23.1, C24.1, C25.1, C26.1, C27.1, C28.1, C29.1, C30.1, C31.1, C32.1, C33.1, C34.1, C35.1, C36.1, C37.1, C38.1, C39.1, C40.1, C41.1, C42.1, C43.1, C44.1, C45.1, C46.1, C47.1, C48.1, C49.1, C50.1, C51.1, C52.1, C53.1, C54.1, C55.1, C56.1, C57.1, C58.1, C59.1, C84.1, L1.2, R17.1, R19.2, U1.J4, U1.J10, U1.J12, U1.J14, U1.J16, U1.K3, U1.K5, U1.K11, U1.K13, U1.K15, U1.L4, U1.L10, U1.L12, U1.L14, U1.L16, U1.M11, U1.M13, U1.M15, U1.N4, U1.N10, U1.N12, U1.N14, U1.P3, U1.P11, U1.P13, U1.P15
/VCC_AUX25: C80.1, C81.1, C82.1, C87.1, FB1.1, PS2.5 (OUT), U1.A3, U1.D11, U1.D18, U1.E6, U1.W7, U1.W13, U1.W18
/WB/WT#: U1.H21, U2.AA05 (WB/WT#)
/W/R#: U1.G15, U2.AM06 (W/R#)
/[BF0]: U1.H6, U2.Y33 ([BF0])
/[BF1]: U1.J7, U2.X34 ([BF1])

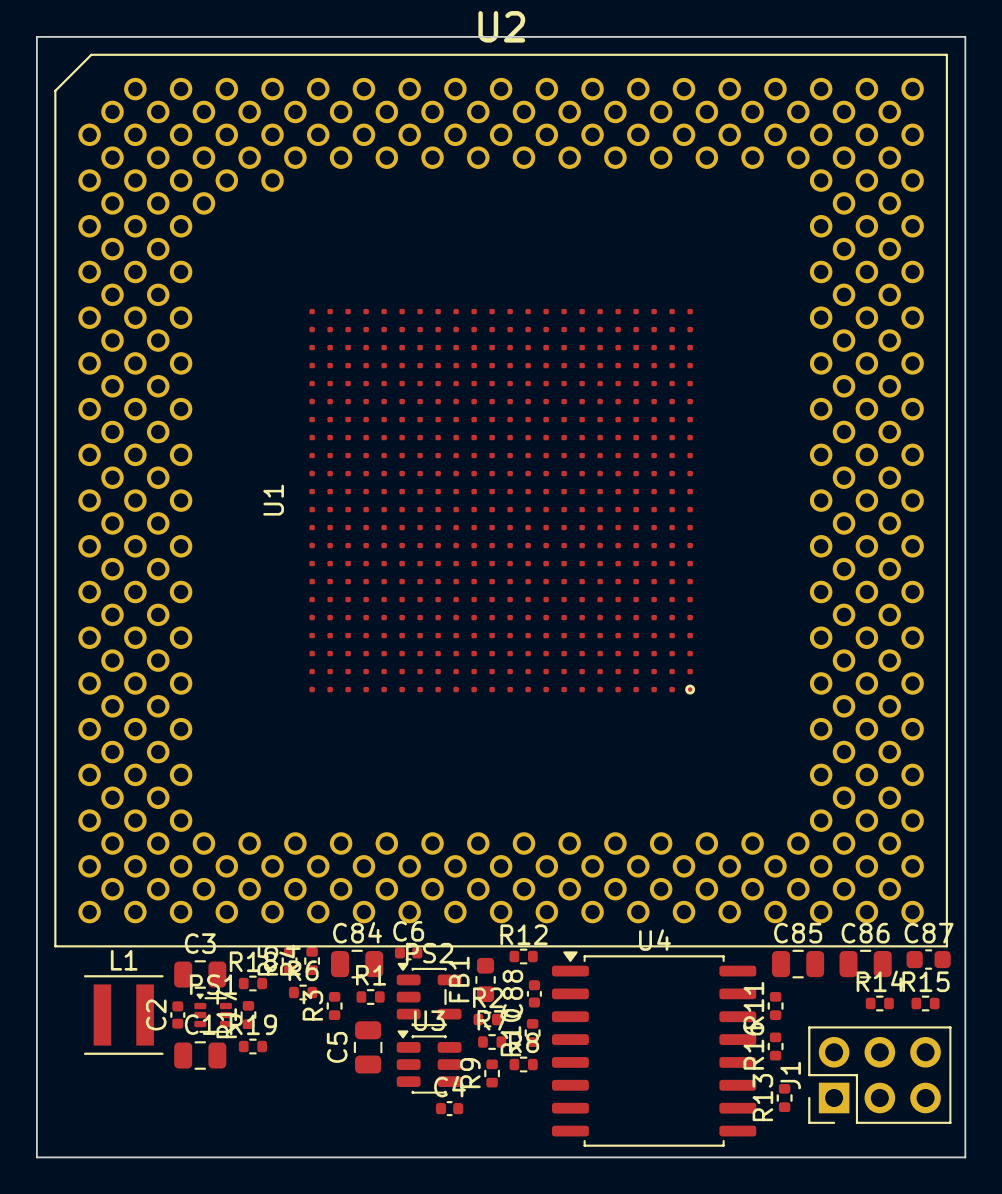
[picture p12: board socket7-cyclonev.kicad_pcb from above]

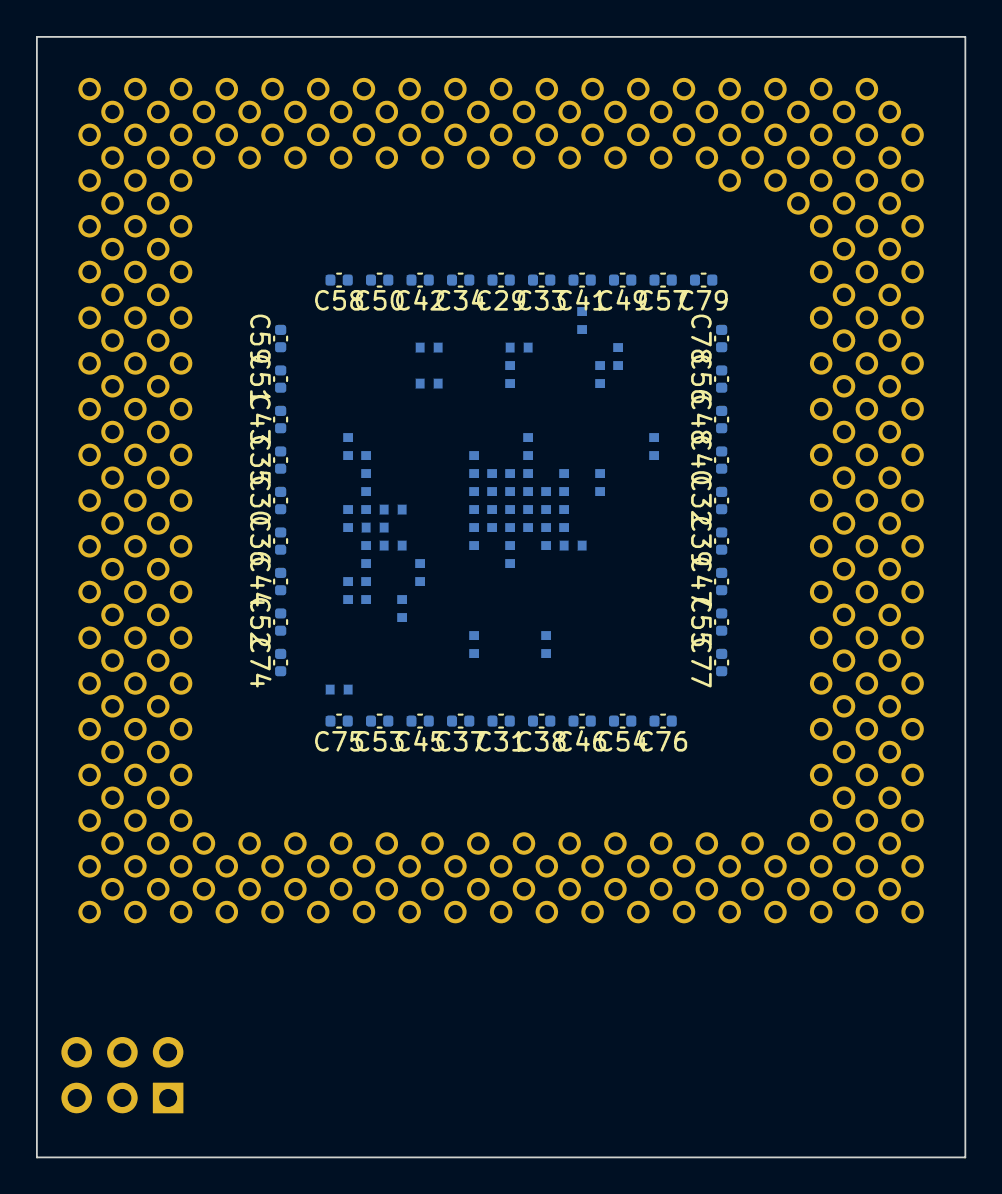
[picture p13: board socket7-cyclonev.kicad_pcb from below]

Board: 8 copper layers, 51.6 x 62.3 mm, 116 parts (77 on the bottom side), 191 nets, no tracks yet.
