alphaonex86/FPGA-CPU/hw/slot1-c2mu/slot1-c2mu.kicad_pcb

## KiCad design hw/slot1-c2mu/slot1-c2mu.kicad_pcb (2026-11-11)

Schematic: slot1-c2mu.kicad_sch, Slot 1 C2 Mu cartridge: XC7A100T + LattePanda Mu + GTL+ tra…

Parts:
C1: 100uF/25V; CP_Elec_6.3x5.4
C2, C3, C10, C14, C18: 10uF/25V; C_1210_3225Metric
C4: 4.7uF/25V; C_0805_2012Metric
C5, C6: 22uF/10V; C_1206_3216Metric
C7, C12, C16, C20, C93, C94, C95, C96, C97, C98, C99, C100, C101, C102, C103, C104, C105, C106, C107, C108, C109, C110, C111, C112, C113, C114, C115, C116, C117, C118, C119, C120, C121, C122, C123, C124, C133, C134, C135, C136, C137, C138, C139, C141, C142, C146, C147, C148, C149, C150, C151, C169, C170, C171: 100nF; C_0402_1005Metric
C8: 10nF; C_0402_1005Metric
C9: 27nF; C_0402_1005Metric
C11, C15, C19: 22uF/6.3V; C_0805_2012Metric
C13, C17, C21: 3.3nF; C_0402_1005Metric
C22, C23, C24, C25, C26, C27, C28, C29, C30, C31, C32, C33, C34, C35, C36, C37, C38, C41, C42, C43, C44, C45: 470nF; C_0402_P1.00
C39, C40, C46, C47, C48, C49, C50, C51, C52: 470nF; C_0402_1005Metric
C53, C54, C55, C56, C57, C58, C59, C60, C61, C62, C63: 100nF; C_0402_P1.00
C64, C65: 100uF/6.3V; C_1210_3225Metric
C66, C67, C68, C69, C70, C71, C74, C75, C76, C77, C78, C83, C84, C85, C86, C87, C88, C89, C90, C91, C92, C140, C143: 4.7uF; C_0603_1608Metric
C72, C73, C79, C80, C81, C82: 47uF/6.3V; C_1210_3225Metric
C125, C126, C129, C130: 1uF; C_0402_1005Metric
C127, C131: 2.2uF; C_0402_1005Metric
C128, C132: 1nF; C_0402_1005Metric
C144, C145: 22uF; C_0805_2012Metric
C152: 10pF; C_0402_1005Metric
C153, C154, C155, C156, C157, C158, C159, C160, C161, C162, C163, C164, C165, C166, C167, C168: 220nF; C_0402_1005Metric
C172: 10uF; C_0805_2012Metric
C173, C174: 27pF; C_0402_1005Metric
D1: green; LED_0603_1608Metric
D2: B5819WS; D_SOD-323
F1: 5A; Fuse_1812_4532Metric
F2: 1.1A; Fuse_1206_3216Metric
FB1: 600R@100MHz; L_0603_1608Metric
H1, H2: MountingHole_Pad; Standoff_SMT_M2_D5.56_H6.6
J1: Conn_02x07_Odd_Even; PinHeader_2x07_P2.00mm_Vertical
J3: Barrel_Jack; BarrelJack_CUI_PJ-063AH_Horizontal
J4: LattePanda_Mu_SODIMM260; LattePanda_Mu_LOTES_ADDR0110_9.2H
J5: Conn_01x04; JST_PH_B4B-PH-K_1x04_P2.00mm_Vertical
J6: USB 2.0 x2 header; PinHeader_2x05_P2.54mm_Vertical
J7: Conn_01x03; PinHeader_1x03_P2.54mm_Vertical
J8: CMOS cell; Molex_PicoBlade_53261-0271_1x02-1MP_P1.25mm_Horizontal
L1: 6.8uH FXL1040-6R8; L_Changjiang_FXL1040
L2, L3, L4: 2.2uH XFL4020-222; L_Coilcraft_XxL4020
PS1: TPS54620RHL; TI_RHL0014A
PS2, PS3, PS4: TPS62130RGT; VQFN-16-1EP_3x3mm_P0.5mm_EP1.68x1.68mm
Q1, Q2: 2N7002; SOT-23
R1: 1.33k; R_0402_1005Metric
R2, R5, R7, R8, R10, R11, R13, R48, R49: 100k; R_0402_1005Metric
R3: 52.3k; R_0402_1005Metric
R4, R25, R26, R27, R28, R29, R44, R45, R47, R56, R57: 10k; R_0402_1005Metric
R6: 24.9k; R_0402_1005Metric
R9: 124k; R_0402_1005Metric
R12: 316k; R_0402_1005Metric
R14: 1.13k 1%; R_0402_1005Metric
R15: 4.53k 1%; R_0402_1005Metric
R16: 2.49k 1%; R_0402_1005Metric
R17: 4.99k 1%; R_0402_1005Metric
R18: 1.00k; R_0402_1005Metric
R19: 2.00k; R_0402_1005Metric
R20, R41, R53: 1k; R_0402_1005Metric
R21, R22, R23, R24: 0R; R_0402_1005Metric
R30, R31, R32, R33, R34, R35, R36, R37: 22R; R_0402_1005Metric
R38, R39, R42, R46, R52: 4.7k; R_0402_1005Metric
R40, R54: 330R; R_0402_1005Metric
R43: 100R 1%; R_0402_1005Metric
R50: 100R; R_0402_1005Metric
R51: 21.5k; R_0402_1005Metric
R55: 12k 1%; R_0402_1005Metric
R58, R59, R60, R61: 33R; R_0402_1005Metric
RN1, RN2, RN3, RN4, RN5, RN6, RN7, RN8, RN9, RN10, RN11, RN12, RN13, RN14, RN15, RN16, RN17, RN18, RN19, RN20, RN21, RN22, RN23, RN24, RN25, RN26, RN27, RN28, RN29, RN30, RN31, RN32, RN33, RN34, RN35: 56R; R_Array_Convex_4x0402
SW1: PWR; SW_Push_1P1T_XKB_TS-1187A
U1: FPGA_Artix7_XC7A100T_FGG484
U2: Intel_SC242_CardEdge
U3, U4, U5, U6, U7, U8, U9: SN74GTL16612; TSSOP-56_6.1x14mm_P0.5mm
U10: CY2309; SOIC-16_3.9x9.9mm_P1.27mm
U11: W25Q128JVSIQ; SOIC-8_5.3x5.3mm_P1.27mm
U12: 50MHz; Oscillator_SMD_SeikoEpson_SG210-4Pin_2.5x2.0mm
U13, U14: TPS74801; VSON-10-1EP_3x3mm_P0.5mm_EP1.65x2.4mm
U15, U17: USBLC6-2SC6; SOT-23-6
U16: FT232HL-REEL; LQFP-48_7x7mm_P0.5mm
Y1: 12MHz; Crystal_SMD_3225-4Pin_3.2x2.5mm

Connections:
/AB_LE: U1.AA21, U3.2 (LEAB), U4.2 (LEAB), U5.2 (LEAB), U6.2 (LEAB), U7.2 (LEAB), U8.2 (LEAB), U9.2 (LEAB)
/ADDR_OEAB#: R25.1, U1.V2, U3.1 (OEAB#), U4.1 (OEAB#)
/ADDR_OEBA#: R26.1, U1.AB7, U3.27 (OEBA#), U4.27 (OEBA#)
/A[3]#: U1.AA6, U4.10 (A6)
/A[4]#: U1.Y2, U4.16 (A11)
/A[5]#: U1.AB10, U4.6 (A3)
/A[6]#: U1.W2, U4.14 (A9)
/A[7]#: U1.AB11, U4.3 (A1)
/A[8]#: U1.AA8, U4.8 (A4)
/A[9]#: U1.AB6, U4.13 (A8)
/A[10]#: U1.AA9, U4.5 (A2)
/A[11]#: U1.AB13, U3.23 (A16)
/A[12]#: U1.AA5, U4.12 (A7)
/A[13]#: U1.AA4, U4.15 (A10)
/A[14]#: U1.AB8, U4.9 (A5)
/A[15]#: U1.AA15, U3.16 (A11)
/A[16]#: U1.AA3, U4.17 (A12)
/A[17]#: U1.AB15, U3.20 (A14)
/A[18]#: U1.Y13, U3.19 (A13)
/A[19]#: U1.AA16, U3.13 (A8)
/A[20]#: U1.AB22, U3.3 (A1)
/A[21]#: U1.AB21, U3.5 (A2)
/A[22]#: U1.AB20, U3.8 (A4)
/A[23]#: U1.AA19, U3.6 (A3)
/A[24]#: U1.Y14, U3.15 (A10)
/A[25]#: U1.AA18, U3.9 (A5)
/A[26]#: U1.AB16, U3.17 (A12)
/A[27]#: U1.AB18, U3.12 (A7)
/A[28]#: U1.Y16, U3.10 (A6)
/A[29]#: U1.Y9, U3.24 (A17)
/A[30]#: U1.Y12, U3.21 (A15)
/A[31]#: U1.AB17, U3.14 (A9)
/BCLK: U1.W19, U2.A75 (BCLK), U10.1 (REF)
/CFG_DONE: R40.1, U1.G11
/CFG_INIT_B: R39.1, U1.U12
/CFG_PROGRAM_B: R38.1, U1.N12
/CLK_ADDR0: R30.2, U3.30 (CLKBA), U3.55 (CLKAB)
/CLK_ADDR1: R31.2, U4.30 (CLKBA), U4.55 (CLKAB)
/CLK_DATA0: R32.2, U5.30 (CLKBA), U5.55 (CLKAB)
/CLK_DATA1: R33.2, U6.30 (CLKBA), U6.55 (CLKAB)
/CLK_DATA2: R34.2, U7.30 (CLKBA), U7.55 (CLKAB)
/CLK_DATA3: R35.2, U8.30 (CLKBA), U8.55 (CLKAB)
/CLK_FB: C152.1, R37.2
/CLK_TX: R36.2, U9.30 (CLKBA), U9.55 (CLKAB)
/DATA_OEAB#: R27.1, U1.D22, U5.1 (OEAB#), U6.1 (OEAB#), U7.1 (OEAB#), U8.1 (OEAB#)
/DATA_OEBA#: R28.1, U1.D21, U5.27 (OEBA#), U6.27 (OEBA#), U7.27 (OEBA#), U8.27 (OEBA#)
/D[0]#: U1.U21, U8.15 (A10)
/D[1]#: U1.W16, U8.19 (A13)
/D[2]#: U1.W22, U8.12 (A7)
/D[3]#: U1.U20, U8.16 (A11)
/D[4]#: U1.Y19, U8.8 (A4)
/D[5]#: U1.W21, U8.13 (A8)
/D[6]#: U1.Y21, U8.6 (A3)
/D[7]#: U1.Y17, U8.10 (A6)
/D[8]#: U1.AA20, U8.3 (A1)
/D[9]#: U1.Y22, U8.5 (A2)
/D[10]#: U1.W17, U8.17 (A12)
/D[11]#: U1.V20, U8.21 (A15)
/D[12]#: U1.W20, U8.14 (A9)
/D[13]#: U1.F19, U7.16 (A11)
/D[14]#: U1.Y18, U8.9 (A5)
/D[15]#: U1.V22, U8.20 (A14)
/D[16]#: U1.E22, U7.10 (A6)
/D[17]#: U1.V19, U8.23 (A16)
/D[18]#: U1.R19, U7.6 (A3)
/D[19]#: U1.T21, U7.3 (A1)
/D[20]#: U1.E19, U7.13 (A8)
/D[21]#: U1.P20, U7.8 (A4)
/D[22]#: U1.P19, U7.9 (A5)
/D[23]#: U1.T20, U7.5 (A2)
/D[24]#: U1.E21, U7.12 (A7)
/D[25]#: U1.F21, U7.14 (A9)
/D[26]#: U1.G21, U7.19 (A13)
/D[27]#: U1.F20, U7.15 (A10)
/D[28]#: U1.D16, U6.13 (A8)
/D[29]#: U1.M1, U7.20 (A14)
/D[30]#: U1.G22, U7.17 (A12)
/D[31]#: U1.L1, U7.21 (A15)
/D[32]#: U1.C19, U6.10 (A6)
/D[33]#: U1.C20, U6.9 (A5)
/D[34]#: U1.D17, U6.8 (A4)
/D[35]#: U1.K1, U7.23 (A16)
/D[36]#: U1.B21, U6.14 (A9)
/D[37]#: U1.D20, U6.3 (A1)
/D[38]#: U1.C22, U6.5 (A2)
/D[39]#: U1.C18, U6.15 (A10)
/D[40]#: U1.B22, U6.12 (A7)
/D[41]#: U1.B18, U6.21 (A15)
/D[42]#: U1.A21, U6.20 (A14)
/D[43]#: U1.D19, U6.6 (A3)
/D[44]#: U1.B20, U6.17 (A12)
/D[45]#: U1.D15, U6.16 (A11)
/D[46]#: U1.G2, U5.19 (A13)
/D[47]#: U1.C17, U6.19 (A13)
/D[48]#: U1.G1, U5.20 (A14)
/D[49]#: U1.F1, U5.21 (A15)
/D[50]#: U1.A15, U5.10 (A6)
/D[51]#: U1.A20, U6.23 (A16)
/D[52]#: U1.E2, U5.23 (A16)
/D[53]#: U1.A13, U5.14 (A9)
/D[54]#: U1.J2, U5.15 (A10)
/D[55]#: U1.A18, U5.3 (A1)
/D[56]#: U1.B15, U5.8 (A4)
/D[57]#: U1.J1, U5.16 (A11)
/D[58]#: U1.C14, U5.9 (A5)
/D[59]#: U1.H2, U5.17 (A12)
/D[60]#: U1.A14, U5.12 (A7)
/D[61]#: U1.C15, U5.6 (A3)
/D[62]#: U1.B13, U5.13 (A8)
/D[63]#: U1.B16, U5.5 (A2)
/FAN_PWM: J5.4, R50.2
/FAN_TAC: D2.2 (A), J5.3, R51.1, R52.1
/FT_EEDATA: R57.1, U16.43 (EEDATA)
/FT_REF: R55.1, U16.5 (REF)
/FT_RESET#: R56.1, U16.34 (~RESET)
/FT_TCK: R58.1, U16.13 (ADBUS0)
/FT_TDI: R59.1, U16.14 (ADBUS1)
/FT_TDO: R61.2, U16.15 (ADBUS2)
/FT_TMS: R60.1, U16.16 (ADBUS3)
/FT_VCCA: C142.1, U16.37 (VCCA)
/FT_VCORE: C141.1, U16.38 (VCCCORE)
/FT_VPHY: C138.1, C139.1, C140.1, FB1.2, U16.3 (VPHY), U16.8 (VPLL)
/FT_XI: C173.1, U16.1 (XCSI), Y1.1
/FT_XO: C174.1, U16.2 (XCSO), Y1.3
/F_TCK: J1.6, R46.1, R58.2, U1.V12
/F_TDI: J1.10, R45.1, R59.2, U1.R13
/F_TDO: J1.8, R61.1, U1.U13
/F_TMS: J1.4, R44.1, R60.2, U1.T13
/GND: C1.2, C2.2, C3.2, C4.2, C5.2, C6.2, C8.2, C9.2, C10.2, C11.2, C12.2, C13.2, C14.2, C15.2, C16.2, C17.2, C18.2, C19.2, C20.2, C21.2, C22.2, C23.2, C24.2, C25.2, C26.2, C27.2, C28.2, C29.2, C30.2, C31.2, C32.2, C33.2, C34.2, C35.2, C36.2, C37.2, C38.2, C39.2, C40.2, C41.2, C42.2, C43.2, C44.2, C45.2, C46.2, C47.2, C48.2, C49.2, C50.2, C51.2, C52.2, C53.2, C54.2, C55.2, C56.2, C57.2, C58.2, C59.2, C60.2, C61.2, C62.2, C63.2, C64.2, C65.2, C66.2, C67.2, C68.2, C69.2, C70.2, C71.2, C72.2, C73.2, C74.2, C75.2, C76.2, C77.2, C78.2, C79.2, C80.2, C81.2, C82.2, C83.2, C84.2, C85.2, C86.2, C87.2, C88.2, C89.2, C90.2, C91.2, C92.2, C93.2, C94.2, C95.2, C96.2, C97.2, C98.2, C99.2, C100.2, C101.2, C102.2, C103.2, C104.2, C105.2, C106.2, C107.2, C108.2, C109.2, C110.2, C111.2, C112.2, C113.2, C114.2, C115.2, C116.2, C117.2, C118.2, C119.2, C120.2, C121.2, C122.2, C123.2, C124.2, C125.2, C126.2, C127.2, C128.2, C129.2, C130.2, C131.2, C132.2, C133.2, C134.2, C135.2, C136.2, C137.2, C138.2, C139.2, C140.2, C141.2, C142.2, C143.2, C144.2, C145.2, C146.2, C147.2, C148.2, C149.2, C150.2, C151.2, C152.2, C171.2, C172.2, C173.2, C174.2, D1.1 (K), H1.1, H2.1, J1.1, J1.3, J1.5, J1.7, J1.9, J1.11, J1.13, J3.2, J4.11 (GND), J4.14 (GND), J4.17 (GND), J4.20 (GND), J4.23 (GND), J4.26 (GND), J4.29 (GND), J4.32 (GND), J4.35 (GND), J4.38 (GND), J4.41 (GND), J4.44 (GND), J4.47 (GND), J4.50 (GND), J4.53 (GND), J4.56 (GND), J4.59 (GND), J4.62 (GND), J4.65 (GND), J4.68 (GND), J4.71 (GND), J4.74 (GND), J4.77 (GND), J4.80 (GND), J4.83 (GND), J4.86 (GND), J4.89 (GND), J4.92 (GND), J4.95 (GND), J4.98 (GND), J4.101 (GND), J4.107 (GND), J4.110 (GND), J4.113 (GND), J4.116 (GND), J4.135 (GND), J4.136 (GND), J4.151 (GND), J4.158 (GND), J4.167 (GND), J4.170 (GND), J4.181 (GND), J4.182 (GND), J4.188 (GND), J4.189 (GND), J4.194 (GND), J4.195 (GND), J4.200 (GND), J4.201 (GND), J4.206 (GND), J4.207 (GND), J4.212 (GND), J4.213 (GND), J4.218 (GND), J4.219 (GND), J4.224 (GND), J4.225 (GND), J4.230 (GND), J4.231 (GND), J4.236 (GND), J4.237 (GND), J4.242 (GND), J4.243 (GND), J4.248 (GND), J4.249 (GND), J5.1, J6.7, J6.8, J7.1, J8.2, PS1.2 (GND), PS1.3 (GND), PS1.15 (PAD), PS2.6 (AGND), PS2.7 (FSW), PS2.8 (DEF), PS2.15 (PGND), PS2.16 (PGND), PS2.17 (PAD), PS3.6 (AGND), PS3.7 (FSW), PS3.8 (DEF), PS3.15 (PGND), PS3.16 (PGND), PS3.17 (PAD), PS4.6 (AGND), PS4.7 (FSW), PS4.8 (DEF), PS4.15 (PGND), PS4.16 (PGND), PS4.17 (PAD), Q1.2 (S), Q2.2 (S), R2.2, R4.2, R7.2, R10.2, R13.2, R15.2, R17.2, R19.2, R21.2, R22.2, R23.2, R24.2, R46.2, R48.2, R49.2, R55.2, SW1.2, U1.A2, U1.A3, U1.A5, U1.A7, U1.A9, U1.A11, U1.A12, U1.A22, U1.AA2, U1.AA12, U1.AA22, U1.AB9, U1.AB19, U1.B3, U1.B12, U1.B19, U1.C3, U1.C6, U1.C10, U1.C12, U1.C16, U1.D3, U1.D4, U1.D8, U1.D12, U1.D13, U1.E4, U1.E5, U1.E7, U1.E9, U1.E11, U1.E12, U1.E20, U1.F5, U1.F11, U1.F17, U1.G5, U1.G6, U1.G7, U1.G8, U1.G9, U1.G10, U1.G12, U1.G14, U1.H1, U1.H7, U1.H9, U1.H11, U1.H21, U1.J8, U1.J10, U1.J12, U1.J18, U1.K5, U1.K7, U1.K9, U1.K11, U1.K15, U1.L2, U1.L8, U1.L9, U1.L10, U1.L22, U1.M7, U1.M9, U1.M10, U1.M11, U1.M19, U1.N6, U1.N8, U1.N9, U1.N10, U1.N16, U1.P3, U1.P7, U1.P9, U1.P11, U1.P13, U1.R8, U1.R10, U1.R12, U1.R20, U1.T7, U1.T9, U1.T11, U1.T17, U1.U4, U1.U9, U1.U10, U1.U14, U1.V1, U1.V11, U1.V21, U1.W8, U1.W18, U1.Y5, U1.Y15, U2.A2 (GND), U2.A6 (GND), U2.A10 (GND), U2.A14 (GND), U2.A18 (GND), U2.A22 (GND), U2.A26 (GND), U2.A30 (GND), U2.A34 (GND), U2.A38 (GND), U2.A42 (GND), U2.A46 (GND), U2.A50 (GND), U2.A54 (GND), U2.A58 (GND), U2.A62 (GND), U2.A66 (GND), U2.A70 (GND), U2.A74 (GND), U2.A78 (GND), U2.A82 (GND), U2.A86 (GND), U2.A90 (GND), U2.A94 (GND), U2.A98 (GND), U2.A102 (GND), U2.A106 (GND), U2.A110 (GND), U2.A114 (GND), U2.A118 (GND), U2.B21 (100/66#), U2.B101 (SLOTOCC#), U3.4 (GND), U3.11 (GND), U3.18 (GND), U3.25 (GND), U3.29 (CEBA#), U3.32 (GND), U3.39 (GND), U3.46 (GND), U3.53 (GND), U3.56 (CEAB#), U4.4 (GND), U4.11 (GND), U4.18 (GND), U4.25 (GND), U4.29 (CEBA#), U4.32 (GND), U4.39 (GND), U4.46 (GND), U4.53 (GND), U4.56 (CEAB#), U5.4 (GND), U5.11 (GND), U5.18 (GND), U5.25 (GND), U5.28 (LEBA), U5.29 (CEBA#), U5.32 (GND), U5.39 (GND), U5.46 (GND), U5.53 (GND), U5.56 (CEAB#), U6.4 (GND), U6.11 (GND), U6.18 (GND), U6.25 (GND), U6.28 (LEBA), U6.29 (CEBA#), U6.32 (GND), U6.39 (GND), U6.46 (GND), U6.53 (GND), U6.56 (CEAB#), U7.4 (GND), U7.11 (GND), U7.18 (GND), U7.25 (GND), U7.28 (LEBA), U7.29 (CEBA#), U7.32 (GND), U7.39 (GND), U7.46 (GND), U7.53 (GND), U7.56 (CEAB#), U8.4 (GND), U8.11 (GND), U8.18 (GND), U8.25 (GND), U8.28 (LEBA), U8.29 (CEBA#), U8.32 (GND), U8.39 (GND), U8.46 (GND), U8.53 (GND), U8.56 (CEAB#), U9.4 (GND), U9.11 (GND), U9.18 (GND), U9.25 (GND), U9.28 (LEBA), U9.29 (CEBA#), U9.32 (GND), U9.39 (GND), U9.46 (GND), U9.53 (GND), U9.56 (CEAB#), U10.5 (GND), U10.12 (GND), U11.4 (GND), U12.2 (GND), U13.6 (GND), U13.11 (PAD), U14.6 (GND), U14.11 (PAD), U15.2 (GND), U16.4 (AGND), U16.9 (AGND), U16.10 (GND), U16.11 (GND), U16.22 (GND), U16.23 (GND), U16.35 (GND), U16.36 (GND), U16.41 (AGND), U16.42 (TEST), U16.47 (GND), U16.48 (GND), U17.2 (GND), Y1.2 (G), Y1.4 (G)
/LED: R54.2, U1.W1
/LED_A: D1.2 (A), R54.1
/MGT_RREF: R43.1, U1.F8
/MU_FAN_PWM: J4.2 (FAN2_CTL), R50.1
/MU_FAN_TAC: J4.4 (FAN2_TAC), R51.2
/MU_PSON: J4.5 (PSON), U1.R1
/MU_PWRBTN#: J4.1 (PWR_SW#), Q1.3 (D), SW1.1
/MU_PWR_ON: Q1.1 (G), R48.1, U1.P1
/MU_REFCLK_N: C170.2, J4.99 (REFCLK2_N)
/MU_REFCLK_P: C169.2, J4.97 (REFCLK2_P)
/MU_RST: Q2.1 (G), R49.1, U1.U1
/MU_RSTBTN#: J4.3 (RST_SW#), Q2.3 (D)
/MU_RX0_N: C154.2, J4.42 (HSIO8_RX_N)
/MU_RX0_P: C153.2, J4.40 (HSIO8_RX_P)
/MU_RX1_N: C156.2, J4.48 (HSIO9_RX_N)
/MU_RX1_P: C155.2, J4.46 (HSIO9_RX_P)
/MU_RX2_N: C158.2, J4.54 (HSIO10_RX_N)
/MU_RX2_P: C157.2, J4.52 (HSIO10_RX_P)
/MU_RX3_N: C160.2, J4.60 (HSIO11_RX_N)
/MU_RX3_P: C159.2, J4.58 (HSIO11_RX_P)
/MU_TX0_N: C162.2, J4.39 (HSIO8_TX_N)
/MU_TX0_P: C161.2, J4.37 (HSIO8_TX_P)
/MU_TX1_N: C164.2, J4.45 (HSIO9_TX_N)
/MU_TX1_P: C163.2, J4.43 (HSIO9_TX_P)
/MU_TX2_N: C166.2, J4.51 (HSIO10_TX_N)
/MU_TX2_P: C165.2, J4.49 (HSIO10_TX_P)
/MU_TX3_N: C168.2, J4.57 (HSIO11_TX_N)
/MU_TX3_P: C167.2, J4.55 (HSIO11_TX_P)
/MU_UART_RX: J4.137 (UART0_RXD), J7.3
/MU_UART_TX: J4.139 (UART0_TXD), J7.2
/MU_VBAT: J4.115 (VBAT), R53.2
/NC_D14: U1.D14
/NC_E3: U1.E3
/NC_E6: U1.E6
/NC_E13: U1.E13
/NC_E14: U1.E14
/NC_E16: U1.E16
/NC_E17: U1.E17
/NC_E18: U1.E18
/NC_F3: U1.F3
/NC_F4: U1.F4
/NC_F6: U1.F6
/NC_F13: U1.F13
/NC_F14: U1.F14
/NC_F15: U1.F15
/NC_F16: U1.F16
/NC_F18: U1.F18
/NC_G3: U1.G3
/NC_G4: U1.G4
/NC_G13: U1.G13
/NC_G15: U1.G15
/NC_G16: U1.G16
/NC_G17: U1.G17
/NC_G18: U1.G18
/NC_H3: U1.H3
/NC_H4: U1.H4
/NC_H5: U1.H5
/NC_H13: U1.H13
/NC_H14: U1.H14
/NC_H15: U1.H15
/NC_H17: U1.H17
/NC_H18: U1.H18
/NC_H19: U1.H19
/NC_J4: U1.J4
/NC_J5: U1.J5
/NC_J6: U1.J6
/NC_J14: U1.J14
/NC_J15: U1.J15
/NC_J16: U1.J16
/NC_J17: U1.J17
/NC_J19: U1.J19
/NC_K2: U1.K2
/NC_K3: U1.K3
/NC_K4: U1.K4
/NC_K6: U1.K6
/NC_K13: U1.K13
/NC_K14: U1.K14
/NC_K16: U1.K16
/NC_K17: U1.K17
/NC_K18: U1.K18
/NC_K19: U1.K19
/NC_L3: U1.L3
/NC_L4: U1.L4
/NC_L5: U1.L5
/NC_L6: U1.L6
/NC_L13: U1.L13
/NC_L14: U1.L14
/NC_L15: U1.L15
/NC_L16: U1.L16
/NC_L18: U1.L18
/NC_L19: U1.L19
/NC_M2: U1.M2
/NC_M3: U1.M3
/NC_M5: U1.M5
/NC_M6: U1.M6
/NC_M13: U1.M13
/NC_M15: U1.M15
/NC_M16: U1.M16
/NC_M17: U1.M17
/NC_M18: U1.M18
/NC_N2: U1.N2
/NC_N3: U1.N3
/NC_N4: U1.N4
/NC_N5: U1.N5
/NC_N13: U1.N13
/NC_N14: U1.N14
/NC_N15: U1.N15
/NC_N17: U1.N17
/NC_N18: U1.N18
/NC_P2: U1.P2
/NC_P4: U1.P4
/NC_P5: U1.P5
/NC_P6: U1.P6
/NC_P14: U1.P14
/NC_P15: U1.P15
/NC_P16: U1.P16
/NC_P17: U1.P17
/NC_PS1_10: PS1.10 (EN)
/NC_PS4_4: PS4.4 (PG)
/NC_R2: U1.R2
/NC_R3: U1.R3
/NC_R4: U1.R4
/NC_R6: U1.R6
/NC_R14: U1.R14
/NC_R16: U1.R16
/NC_R17: U1.R17
/NC_R18: U1.R18
/NC_RN35_2: RN35.2 (R2.1)
/NC_RN35_3: RN35.3 (R3.1)
/NC_RN35_4: RN35.4 (R4.1)
/NC_T3: U1.T3
/NC_T4: U1.T4
/NC_T5: U1.T5
/NC_T6: U1.T6
/NC_T14: U1.T14
/NC_T15: U1.T15
/NC_T16: U1.T16
/NC_T18: U1.T18
/NC_U2: U1.U2
/NC_U2_A4: U2.A4 (IERR#)
/NC_U2_A7: U2.A7 (FERR#)
/NC_U2_A9: U2.A9 (TDI)
/NC_U2_A11: U2.A11 (TDO)
/NC_U2_A13: U2.A13 (TESTHI)
/NC_U2_A16: U2.A16 (Reserved)
/NC_U2_A19: U2.A19 (PICD0)
/NC_U2_A20: U2.A20 (PREQ#)
/NC_U2_A47: U2.A47 (Reserved)
/NC_U2_A88: U2.A88 (Reserved)
/NC_U2_A113: U2.A113 (Reserved)
/NC_U2_A116: U2.A116 (Reserved)
/NC_U2_B1: U2.B1 (EMI)
/NC_U2_B7: U2.B7 (TCK)
/NC_U2_B10: U2.B10 (TMS)
/NC_U2_B11: U2.B11 (TRST#)
/NC_U2_B12: U2.B12 (Reserved)
/NC_U2_B13: U2.B13 (VCC_CORE)
/NC_U2_B14: U2.B14 (THERMDP)
/NC_U2_B15: U2.B15 (THERMDN)
/NC_U2_B17: U2.B17 (VCC_CORE)
/NC_U2_B18: U2.B18 (PICCLK)
/NC_U2_B20: U2.B20 (Reserved)
/NC_U2_B22: U2.B22 (PICD1)
/NC_U2_B25: U2.B25 (VCC_CORE)
/NC_U2_B29: U2.B29 (VCC_CORE)
/NC_U2_B33: U2.B33 (VCC_CORE)
/NC_U2_B37: U2.B37 (VCC_CORE)
/NC_U2_B41: U2.B41 (EMI)
/NC_U2_B45: U2.B45 (VCC_CORE)
/NC_U2_B49: U2.B49 (VCC_CORE)
/NC_U2_B53: U2.B53 (VCC_CORE)
/NC_U2_B57: U2.B57 (VCC_CORE)
/NC_U2_B61: U2.B61 (EMI)
/NC_U2_B65: U2.B65 (VCC_CORE)
/NC_U2_B69: U2.B69 (VCC_CORE)
/NC_U2_B73: U2.B73 (VCC_CORE)
/NC_U2_B76: U2.B76 (Reserved)
/NC_U2_B77: U2.B77 (VCC_CORE)
/NC_U2_B81: U2.B81 (EMI)
/NC_U2_B85: U2.B85 (VCC_CORE)
/NC_U2_B89: U2.B89 (VCC_CORE)
/NC_U2_B93: U2.B93 (VCC_CORE)
/NC_U2_B97: U2.B97 (VCC_CORE)
/NC_U2_B100: U2.B100 (EMI)
/NC_U2_B105: U2.B105 (VCC_CORE)
/NC_U2_B109: U2.B109 (VCC5)
/NC_U2_B112: U2.B112 (Reserved)
/NC_U2_B113: U2.B113 (VCC_L2)
/NC_U2_B117: U2.B117 (VCC_L2)
/NC_U2_B120: U2.B120 (VID0)
/NC_U2_B121: U2.B121 (VCC_L2)
/NC_U3: U1.U3
/NC_U5: U1.U5
/NC_U6: U1.U6
/NC_U7: U1.U7
/NC_U15: U1.U15
/NC_U16: U1.U16
/NC_U17: U1.U17
/NC_U18: U1.U18
/NC_V3: U1.V3
/NC_V4: U1.V4
/NC_V5: U1.V5
/NC_V7: U1.V7
/NC_V8: U1.V8
/NC_V9: U1.V9
/NC_V10: U1.V10
/NC_V13: U1.V13
/NC_V14: U1.V14
/NC_V15: U1.V15
/NC_V17: U1.V17
/NC_V18: U1.V18
/NC_W4: U1.W4
/NC_W5: U1.W5
/NC_W6: U1.W6
/NC_W7: U1.W7
/NC_W9: U1.W9
/NC_W10: U1.W10
/NC_W12: U1.W12
/NC_W14: U1.W14
/NC_W15: U1.W15
/NC_Y3: U1.Y3
/NC_Y4: U1.Y4
/NC_Y6: U1.Y6
/NC_Y7: U1.Y7
/OSC50: U1.W11, U12.3 (OUT)
/PCIE_PERST#: J4.105 (PLT_RST#), R47.1, U1.T1
/PCIE_REFCLK_N: C169.1, U1.E10
/PCIE_REFCLK_P: C170.1, U1.F10
/PCIE_RX0_N: C161.1, U1.C9
/PCIE_RX0_P: C162.1, U1.D9
/PCIE_RX1_N: C163.1, U1.A10
/PCIE_RX1_P: C164.1, U1.B10
/PCIE_RX2_N: C165.1, U1.C11
/PCIE_RX2_P: C166.1, U1.D11
/PCIE_RX3_N: C167.1, U1.A8
/PCIE_RX3_P: C168.1, U1.B8
/PCIE_TX0_N: C154.1, U1.C7
/PCIE_TX0_P: C153.1, U1.D7
/PCIE_TX1_N: C156.1, U1.A6
/PCIE_TX1_P: C155.1, U1.B6
/PCIE_TX2_N: C158.1, U1.C5
/PCIE_TX2_P: C157.1, U1.D5
/PCIE_TX3_N: C159.1, U1.A4
/PCIE_TX3_P: C160.1, U1.B4
/PG_1V0: PS2.4 (PG), PS3.13 (EN), R8.1
/PG_1V8: PS3.4 (PG), PS4.13 (EN), R11.1
/PG_5V: PS1.14 (PWRGD), PS2.13 (EN), R5.1
/PS1_BOOT: C7.1, PS1.13 (BOOT)
/PS1_COMP: PS1.8 (COMP), R1.1
/PS1_CZ: C9.1, R1.2
/PS1_FB: PS1.7 (VSENSE), R3.2, R4.1
/PS1_RT: PS1.1 (RT/CLK), R2.1
/PS1_SS: C8.1, PS1.9 (SS/TR)
/PS1_SW: C7.2, L1.1, PS1.11 (PH), PS1.12 (PH)
/PS2_FB: PS2.5 (FB), R6.2, R7.1
/PS2_SS: C13.1, PS2.9 (SS/TR)
/PS2_SW: L2.1, PS2.1 (SW), PS2.2 (SW), PS2.3 (SW)
/PS3_FB: PS3.5 (FB), R9.2, R10.1
/PS3_SS: C17.1, PS3.9 (SS/TR)
/PS3_SW: L3.1, PS3.1 (SW), PS3.2 (SW), PS3.3 (SW)
/PS4_FB: PS4.5 (FB), R12.2, R13.1
/PS4_SS: C21.1, PS4.9 (SS/TR)
/PS4_SW: L4.1, PS4.1 (SW), PS4.2 (SW), PS4.3 (SW)
/PUDC_B: R41.1, U1.U22
/REQ[0]#: U1.Y1, U4.19 (A13)
/REQ[1]#: U1.AB3, U4.20 (A14)
/REQ[2]#: U1.AB2, U4.23 (A16)
/REQ[3]#: U1.AB1, U4.24 (A17)
/REQ[4]#: U1.AA1, U4.21 (A15)
/RTC_CELL: J8.1, R53.1
/SPI_CLK: U1.L12, U11.6 (CLK)
/SPI_CS#: R42.1, U1.T19, U11.1 (~CS)
/SPI_D0: U1.P22, U11.5 (DI/IO_{0})
/SPI_D1: U1.R22, U11.2 (DO/IO_{1})
/SPI_D2: U1.P21, U11.3 (~WP/IO_{2})
/SPI_D3: U1.R21, U11.7 (~HOLD/~RESET/IO_{3})
/S_A20M#: U1.C2, U2.A5 (A20M#)
/S_ADS#: RN34.1 (R1.1), U1.N19, U2.A115 (ADS#), U9.45 (B7)
/S_AERR#: RN35.1 (R1.1), U2.B118 (AERR#)
/S_AP[0]#: RN34.4 (R4.1), U2.A117 (AP[0]#)
/S_AP[1]#: RN34.3 (R3.1), U2.B116 (AP[1]#)
/S_A[3]#: RN28.3 (R3.1), U2.B98 (A[3]#), U4.47 (B6)
/S_A[4]#: RN29.2 (R2.1), U2.A100 (A[4]#), U4.41 (B11)
/S_A[5]#: RN28.2 (R2.1), U2.A97 (A[5]#), U4.51 (B3)
/S_A[6]#: RN29.1 (R1.1), U2.B99 (A[6]#), U4.43 (B9)
/S_A[7]#: RN28.1 (R1.1), U2.B96 (A[7]#), U4.54 (B1)
/S_A[8]#: RN27.3 (R3.1), U2.B95 (A[8]#), U4.49 (B4)
/S_A[9]#: RN28.4 (R4.1), U2.A99 (A[9]#), U4.44 (B8)
/S_A[10]#: RN27.4 (R4.1), U2.A96 (A[10]#), U4.52 (B2)
/S_A[11]#: RN26.3 (R3.1), U2.B92 (A[11]#), U3.34 (B16)
/S_A[12]#: RN27.1 (R1.1), U2.B94 (A[12]#), U4.45 (B7)
/S_A[13]#: RN26.4 (R4.1), U2.A93 (A[13]#), U4.42 (B10)
/S_A[14]#: RN27.2 (R2.1), U2.A95 (A[14]#), U4.48 (B5)
/S_A[15]#: RN25.3 (R3.1), U2.B90 (A[15]#), U3.41 (B11)
/S_A[16]#: RN26.2 (R2.1), U2.A92 (A[16]#), U4.40 (B12)
/S_A[17]#: RN26.1 (R1.1), U2.B91 (A[17]#), U3.37 (B14)
/S_A[18]#: RN25.4 (R4.1), U2.A91 (A[18]#), U3.38 (B13)
/S_A[19]#: RN25.2 (R2.1), U2.A89 (A[19]#), U3.44 (B8)
/S_A[20]#: RN24.2 (R2.1), U2.B86 (A[20]#), U3.54 (B1)
/S_A[21]#: RN24.4 (R4.1), U2.B87 (A[21]#), U3.52 (B2)
/S_A[22]#: RN24.1 (R1.1), U2.A85 (A[22]#), U3.49 (B4)
/S_A[23]#: RN24.3 (R3.1), U2.A87 (A[23]#), U3.51 (B3)
/S_A[24]#: RN23.2 (R2.1), U2.B83 (A[24]#), U3.42 (B10)
/S_A[25]#: RN25.1 (R1.1), U2.B88 (A[25]#), U3.48 (B5)
/S_A[26]#: RN22.4 (R4.1), U2.B82 (A[26]#), U3.40 (B12)
/S_A[27]#: RN23.3 (R3.1), U2.A84 (A[27]#), U3.45 (B7)
/S_A[28]#: RN23.4 (R4.1), U2.B84 (A[28]#), U3.47 (B6)
/S_A[29]#: RN22.2 (R2.1), U2.B80 (A[29]#), U3.33 (B17)
/S_A[30]#: RN22.3 (R3.1), U2.A81 (A[30]#), U3.36 (B15)
/S_A[31]#: RN23.1 (R1.1), U2.A83 (A[31]#), U3.43 (B9)
/S_A[32]#: RN21.4 (R4.1), U2.B79 (A[32]#)
/S_A[33]#: RN21.3 (R3.1), U2.A79 (A[33]#)
/S_A[34]#: RN22.1 (R1.1), U2.A80 (A[34]#)
/S_A[35]#: RN21.2 (R2.1), U2.B78 (A[35]#)
/S_BERR#: RN21.1 (R1.1), U2.A77 (BERR#)
/S_BINIT#: RN2.1 (R1.1), U2.A24 (BINIT#)
/S_BNR#: RN29.3 (R3.1), U1.K22, U2.A101 (BNR#), U9.52 (B2)
/S_BPM[0]#: RN1.3 (R3.1), U2.A23 (BPM[0]#)
/S_BPM[1]#: RN2.2 (R2.1), U2.B24 (BPM[1]#)
/S_BPRI#: RN30.1 (R1.1), U1.J21, U2.A103 (BPRI#)
/S_BP[2]#: RN1.1 (R1.1), U2.B19 (BP[2]#)
/S_BP[3]#: RN1.2 (R2.1), U2.A21 (BP[3]#)
/S_BR0#: RN20.4 (R4.1), U1.J22, U2.A76 (BR0#), U9.54 (B1)
/S_BR1#: RN20.3 (R3.1), U2.B75 (BR1#)
/S_DBSY#: RN33.1 (R1.1), U1.L20, U2.A111 (DBSY#), U9.47 (B6)
/S_DEFER#: RN31.1 (R1.1), U1.K21, U2.A105 (DEFER#)
/S_DEP[0]#: RN2.3 (R3.1), U2.A25 (DEP[0]#)
/S_DEP[1]#: RN3.1 (R1.1), U2.A27 (DEP[1]#)
/S_DEP[2]#: RN2.4 (R4.1), U2.B26 (DEP[2]#)
/S_DEP[3]#: RN3.3 (R3.1), U2.A28 (DEP[3]#)
/S_DEP[4]#: RN3.2 (R2.1), U2.B27 (DEP[4]#)
/S_DEP[5]#: RN4.1 (R1.1), U2.A29 (DEP[5]#)
/S_DEP[6]#: RN4.3 (R3.1), U2.A31 (DEP[6]#)
/S_DEP[7]#: RN3.4 (R4.1), U2.B28 (DEP[7]#)
/S_DRDY#: RN31.4 (R4.1), U1.N22, U2.B107 (DRDY#), U9.51 (B3)
/S_D[0]#: RN20.1 (R1.1), U2.B72 (D[0]#), U8.42 (B10)
/S_D[1]#: RN20.2 (R2.1), U2.A73 (D[1]#), U8.38 (B13)
/S_D[2]#: RN19.3 (R3.1), U2.B71 (D[2]#), U8.45 (B7)
/S_D[3]#: RN19.4 (R4.1), U2.A72 (D[3]#), U8.41 (B11)
/S_D[4]#: RN19.1 (R1.1), U2.B70 (D[4]#), U8.49 (B4)
/S_D[5]#: RN19.2 (R2.1), U2.A71 (D[5]#), U8.44 (B8)
/S_D[6]#: RN18.3 (R3.1), U2.B68 (D[6]#), U8.51 (B3)
/S_D[7]#: RN18.1 (R1.1), U2.B67 (D[7]#), U8.47 (B6)
/S_D[8]#: RN18.4 (R4.1), U2.A69 (D[8]#), U8.54 (B1)
/S_D[9]#: RN18.2 (R2.1), U2.A68 (D[9]#), U8.52 (B2)
/S_D[10]#: RN17.2 (R2.1), U2.A65 (D[10]#), U8.40 (B12)
/S_D[11]#: RN16.4 (R4.1), U2.A64 (D[11]#), U8.36 (B15)
/S_D[12]#: RN17.3 (R3.1), U2.B66 (D[12]#), U8.43 (B9)
/S_D[13]#: RN16.2 (R2.1), U2.A63 (D[13]#), U7.41 (B11)
/S_D[14]#: RN17.4 (R4.1), U2.A67 (D[14]#), U8.48 (B5)
/S_D[15]#: RN17.1 (R1.1), U2.B64 (D[15]#), U8.37 (B14)
/S_D[16]#: RN15.4 (R4.1), U2.A61 (D[16]#), U7.47 (B6)
/S_D[17]#: RN16.3 (R3.1), U2.B63 (D[17]#), U8.34 (B16)
/S_D[18]#: RN15.3 (R3.1), U2.B60 (D[18]#), U7.51 (B3)
/S_D[19]#: RN15.1 (R1.1), U2.B59 (D[19]#), U7.54 (B1)
/S_D[20]#: RN16.1 (R1.1), U2.B62 (D[20]#), U7.44 (B8)
/S_D[21]#: RN15.2 (R2.1), U2.A60 (D[21]#), U7.49 (B4)
/S_D[22]#: RN14.3 (R3.1), U2.B58 (D[22]#), U7.48 (B5)
/S_D[23]#: RN14.4 (R4.1), U2.A59 (D[23]#), U7.52 (B2)
/S_D[24]#: RN14.2 (R2.1), U2.A57 (D[24]#), U7.45 (B7)
/S_D[25]#: RN14.1 (R1.1), U2.B56 (D[25]#), U7.43 (B9)
/S_D[26]#: RN13.3 (R3.1), U2.B55 (D[26]#), U7.38 (B13)
/S_D[27]#: RN13.4 (R4.1), U2.A56 (D[27]#), U7.42 (B10)
/S_D[28]#: RN12.3 (R3.1), U2.B52 (D[28]#), U6.44 (B8)
/S_D[29]#: RN13.1 (R1.1), U2.B54 (D[29]#), U7.37 (B14)
/S_D[30]#: RN13.2 (R2.1), U2.A55 (D[30]#), U7.40 (B12)
/S_D[31]#: RN12.4 (R4.1), U2.A53 (D[31]#), U7.36 (B15)
/S_D[32]#: RN12.1 (R1.1), U2.B51 (D[32]#), U6.47 (B6)
/S_D[33]#: RN11.4 (R4.1), U2.A51 (D[33]#), U6.48 (B5)
/S_D[34]#: RN11.1 (R1.1), U2.B48 (D[34]#), U6.49 (B4)
/S_D[35]#: RN12.2 (R2.1), U2.A52 (D[35]#), U7.34 (B16)
/S_D[36]#: RN10.2 (R2.1), U2.B46 (D[36]#), U6.43 (B9)
/S_D[37]#: RN11.2 (R2.1), U2.A49 (D[37]#), U6.54 (B1)
/S_D[38]#: RN11.3 (R3.1), U2.B50 (D[38]#), U6.52 (B2)
/S_D[39]#: RN10.1 (R1.1), U2.A45 (D[39]#), U6.42 (B10)
/S_D[40]#: RN10.3 (R3.1), U2.B47 (D[40]#), U6.45 (B7)
/S_D[41]#: RN8.4 (R4.1), U2.B42 (D[41]#), U6.36 (B15)
/S_D[42]#: RN9.1 (R1.1), U2.A43 (D[42]#), U6.37 (B14)
/S_D[43]#: RN10.4 (R4.1), U2.A48 (D[43]#), U6.51 (B3)
/S_D[44]#: RN9.4 (R4.1), U2.B44 (D[44]#), U6.40 (B12)
/S_D[45]#: RN9.3 (R3.1), U2.A44 (D[45]#), U6.41 (B11)
/S_D[46]#: RN7.3 (R3.1), U2.A39 (D[46]#), U5.38 (B13)
/S_D[47]#: RN9.2 (R2.1), U2.B43 (D[47]#), U6.38 (B13)
/S_D[48]#: RN7.4 (R4.1), U2.B39 (D[48]#), U5.37 (B14)
/S_D[49]#: RN8.1 (R1.1), U2.A40 (D[49]#), U5.36 (B15)
/S_D[50]#: RN6.2 (R2.1), U2.B35 (D[50]#), U5.47 (B6)
/S_D[51]#: RN8.3 (R3.1), U2.A41 (D[51]#), U6.34 (B16)
/S_D[52]#: RN8.2 (R2.1), U2.B40 (D[52]#), U5.34 (B16)
/S_D[53]#: RN6.3 (R3.1), U2.A36 (D[53]#), U5.43 (B9)
/S_D[54]#: RN6.4 (R4.1), U2.B36 (D[54]#), U5.42 (B10)
/S_D[55]#: RN5.3 (R3.1), U2.A33 (D[55]#), U5.54 (B1)
/S_D[56]#: RN5.4 (R4.1), U2.B34 (D[56]#), U5.49 (B4)
/S_D[57]#: RN7.1 (R1.1), U2.A37 (D[57]#), U5.41 (B11)
/S_D[58]#: RN4.4 (R4.1), U2.B31 (D[58]#), U5.48 (B5)
/S_D[59]#: RN7.2 (R2.1), U2.B38 (D[59]#), U5.40 (B12)
/S_D[60]#: RN6.1 (R1.1), U2.A35 (D[60]#), U5.45 (B7)
/S_D[61]#: RN5.1 (R1.1), U2.A32 (D[61]#), U5.51 (B3)
/S_D[62]#: RN4.2 (R2.1), U2.B30 (D[62]#), U5.44 (B8)
/S_D[63]#: RN5.2 (R2.1), U2.B32 (D[63]#), U5.52 (B2)
/S_FLUSH#: U1.A1, U2.B2 (FLUSH#)
/S_HIT#: RN32.4 (R4.1), U1.M21, U2.B110 (HIT#), U9.48 (B5)
/S_HITM#: RN32.3 (R3.1), U1.J20, U2.A109 (HITM#), U9.49 (B4)
/S_IGNNE#: U1.E1, U2.A8 (IGNNE#)
/S_INIT#: U1.B2, U2.B4 (INIT#)
/S_LINT[0]/INTR: U1.A19, U2.A17 (LINT[0]/INTR)
/S_LINT[1]/NMI: U1.B17, U2.B16 (LINT[1]/NMI)
/S_LOCK#: RN31.2 (R2.1), U1.H20, U2.B106 (LOCK#)
/S_PRDY#: RN1.4 (R4.1), U2.B23 (PRDY#)
/S_PWRGOOD: U1.C13, U2.A12 (PWRGOOD)
/S_REQ[0]#: RN29.4 (R4.1), U2.B102 (REQ[0]#), U4.38 (B13)
/S_REQ[1]#: RN30.2 (R2.1), U2.B103 (REQ[1]#), U4.37 (B14)
/S_REQ[2]#: RN31.3 (R3.1), U2.A107 (REQ[2]#), U4.34 (B16)
/S_REQ[3]#: RN32.1 (R1.1), U2.A108 (REQ[3]#), U4.33 (B17)
/S_REQ[4]#: RN30.4 (R4.1), U2.B104 (REQ[4]#), U4.36 (B15)
/S_RESET#: U1.H22, U2.B74 (RESET#)
/S_RP#: RN33.4 (R4.1), U2.B114 (RP#)
/S_RSP#: RN34.2 (R2.1), U2.B115 (RSP#)
/S_RS[0]#: RN32.2 (R2.1), U1.L21, U2.B108 (RS[0]#)
/S_RS[1]#: RN33.3 (R3.1), U1.N20, U2.A112 (RS[1]#)
/S_RS[2]#: RN33.2 (R2.1), U1.M20, U2.B111 (RS[2]#)
/S_SLP#: U1.D2, U2.B8 (SLP#)
/S_SMI#: U1.B1, U2.B3 (SMI#)
/S_STPCLK#: U1.D1, U2.B6 (STPCLK#)
/S_THERMTRIP#: U1.A16, U2.A15 (THERMTRIP#)
/S_TRDY#: RN30.3 (R3.1), U1.M22, U2.A104 (TRDY#)
/S_VID1: R21.1, U2.A120 (VID1)
/S_VID2: R22.1, U2.A119 (VID2)
/S_VID3: R23.1, U2.B119 (VID3)
/S_VID4: R24.1, U2.A121 (VID4)
/TX_ADS#: U1.Y8, U9.12 (A7)
/TX_BNR#: U1.AA13, U9.5 (A2)
/TX_BR0#: U1.AA14, U9.3 (A1)
/TX_DBSY#: U1.AA10, U9.10 (A6)
/TX_DRDY#: U1.Y11, U9.6 (A3)
/TX_HIT#: U1.AB12, U9.9 (A5)
/TX_HITM#: U1.AA11, U9.8 (A4)
/TX_OEAB#: R29.1, U1.AB5, U9.1 (OEAB#)
/U13_FB: R14.2, R15.1, U13.8 (FB)
/U13_SS: C128.1, U13.7 (SS)
/U14_FB: R16.2, R17.1, U14.8 (FB)
/U14_SS: C132.1, U14.7 (SS)
/USB1_N: J4.67 (USB2_P1_N), J6.3, U15.3 (I/O2), U15.4 (I/O2)
/USB1_P: J4.69 (USB2_P1_P), J6.5, U15.1 (I/O1), U15.6 (I/O1)
/USB2_N: J4.73 (USB2_P2_N), U16.6 (DM)
/USB2_P: J4.75 (USB2_P2_P), U16.7 (DP)
/USB3_N: J4.79 (USB2_P3_N), J6.4, U17.3 (I/O2), U17.4 (I/O2)
/USB3_P: J4.81 (USB2_P3_P), J6.6, U17.1 (I/O1), U17.6 (I/O1)
/USB_VBUS: C172.1, F2.2, J6.1, J6.2, U15.5 (VBUS), U17.5 (VBUS)
/V5: C5.1, C6.1, C10.1, C12.1, C14.1, C16.1, C18.1, C20.1, C95.1, C99.1, C103.1, C107.1, C111.1, C115.1, C119.1, C126.1, C130.1, C171.1, D2.1 (K), F2.1, J5.2, L1.2, PS2.10 (AVIN), PS2.11 (PVIN), PS2.12 (PVIN), PS3.10 (AVIN), PS3.11 (PVIN), PS3.12 (PVIN), PS4.10 (AVIN), PS4.11 (PVIN), PS4.12 (PVIN), R3.1, R5.2, R8.2, R11.2, R52.2, U3.50 (VCC5), U4.50 (VCC5), U5.50 (VCC5), U6.50 (VCC5), U7.50 (VCC5), U8.50 (VCC5), U9.50 (VCC5), U13.4 (BIAS), U14.4 (BIAS)
/V12: C1.1, C2.1, C3.1, C4.1, F1.2, J4.250 (VIN), J4.251 (VIN), J4.252 (VIN), J4.253 (VIN), J4.254 (VIN), J4.255 (VIN), J4.256 (VIN), J4.257 (VIN), J4.258 (VIN), J4.259 (VIN), J4.260 (VIN), PS1.4 (PVIN), PS1.5 (PVIN), PS1.6 (VIN)
/V12_IN: F1.1, J3.1
/VCC_1V0: C11.1, C22.1, C23.1, C24.1, C25.1, C26.1, C27.1, C28.1, C29.1, C30.1, C31.1, C64.1, C65.1, C66.1, C67.1, C68.1, C69.1, C70.1, C71.1, L2.2, PS2.14 (VOS), R6.1, U1.H8, U1.H10, U1.J7, U1.J9, U1.J11, U1.K8, U1.L7, U1.L11, U1.M8, U1.N7, U1.N11, U1.P8, U1.P10, U1.R7, U1.R9, U1.T8, U1.T10
/VCC_1V8: C15.1, C32.1, C33.1, C34.1, C35.1, C36.1, C37.1, C38.1, C39.1, C40.1, C72.1, C73.1, C74.1, C75.1, C76.1, C77.1, C78.1, C125.1, C129.1, L3.2, PS3.14 (VOS), R9.1, U1.G19, U1.H12, U1.H16, U1.J13, U1.K10, U1.K12, U1.K20, U1.L17, U1.M12, U1.N21, U1.P12, U1.R11, U13.1 (IN), U13.2 (IN), U13.5 (EN), U14.1 (IN), U14.2 (IN), U14.5 (EN)
/VCC_3V3: C19.1, C41.1, C42.1, C43.1, C44.1, C45.1, C46.1, C47.1, C48.1, C49.1, C50.1, C51.1, C52.1, C79.1, C80.1, C81.1, C82.1, C83.1, C84.1, C85.1, C86.1, C87.1, C88.1, C89.1, C90.1, C93.1, C94.1, C97.1, C98.1, C101.1, C102.1, C105.1, C106.1, C109.1, C110.1, C113.1, C114.1, C117.1, C118.1, C121.1, C122.1, C123.1, C124.1, C133.1, C134.1, C135.1, C136.1, C137.1, C143.1, FB1.1, J1.2, L4.2, PS4.14 (VOS), R12.1, R25.2, R26.2, R27.2, R28.2, R29.2, R38.2, R39.2, R40.2, R41.2, R42.2, R44.2, R45.2, R47.2, R56.2, R57.2, U1.A17, U1.AA7, U1.AA17, U1.AB4, U1.AB14, U1.B14, U1.C1, U1.C21, U1.D18, U1.E15, U1.F2, U1.F12, U1.F22, U1.H6, U1.J3, U1.M4, U1.M14, U1.N1, U1.P18, U1.R5, U1.R15, U1.T2, U1.T12, U1.T22, U1.U8, U1.U11, U1.U19, U1.V6, U1.V16, U1.W3, U1.W13, U1.Y10, U1.Y20, U3.7 (VCC33), U3.22 (VCC33), U3.28 (LEBA), U4.7 (VCC33), U4.22 (VCC33), U4.28 (LEBA), U5.7 (VCC33), U5.22 (VCC33), U6.7 (VCC33), U6.22 (VCC33), U7.7 (VCC33), U7.22 (VCC33), U8.7 (VCC33), U8.22 (VCC33), U9.7 (VCC33), U9.22 (VCC33), U9.27 (OEBA#), U10.4 (VDD), U10.8 (S2), U10.9 (S1), U10.13 (VDD), U11.8 (VCC), U12.1 (EN), U12.4 (Vdd), U16.12 (VCCIO), U16.24 (VCCIO), U16.39 (VCCD), U16.40 (VREGIN), U16.46 (VCCIO)
/VCC_MGT10: C53.1, C54.1, C55.1, C56.1, C57.1, C91.1, C127.1, R14.1, U1.D6, U1.D10, U1.E8, U1.F7, U1.F9, U13.9 (OUT), U13.10 (OUT)
/VCC_MGT12: C58.1, C59.1, C60.1, C61.1, C62.1, C63.1, C92.1, C131.1, R16.1, R43.2, U1.B5, U1.B7, U1.B9, U1.B11, U1.C4, U1.C8, U14.9 (OUT), U14.10 (OUT)
/VREF_GTL: C96.1, C100.1, C104.1, C108.1, C112.1, C116.1, C120.1, R18.2, R19.1, U3.35 (VREF), U4.35 (VREF), U5.35 (VREF), U6.35 (VREF), U7.35 (VREF), U8.35 (VREF), U9.35 (VREF)
/VTT15: C144.1, C145.1, C146.1, C147.1, C148.1, C149.1, C150.1, C151.1, R18.1, R20.1, RN1.5 (R4.2), RN1.6 (R3.2), RN1.7 (R2.2), RN1.8 (R1.2), RN2.5 (R4.2), RN2.6 (R3.2), RN2.7 (R2.2), RN2.8 (R1.2), RN3.5 (R4.2), RN3.6 (R3.2), RN3.7 (R2.2), RN3.8 (R1.2), RN4.5 (R4.2), RN4.6 (R3.2), RN4.7 (R2.2), RN4.8 (R1.2), RN5.5 (R4.2), RN5.6 (R3.2), RN5.7 (R2.2), RN5.8 (R1.2), RN6.5 (R4.2), RN6.6 (R3.2), RN6.7 (R2.2), RN6.8 (R1.2), RN7.5 (R4.2), RN7.6 (R3.2), RN7.7 (R2.2), RN7.8 (R1.2), RN8.5 (R4.2), RN8.6 (R3.2), RN8.7 (R2.2), RN8.8 (R1.2), RN9.5 (R4.2), RN9.6 (R3.2), RN9.7 (R2.2), RN9.8 (R1.2), RN10.5 (R4.2), RN10.6 (R3.2), RN10.7 (R2.2), RN10.8 (R1.2), RN11.5 (R4.2), RN11.6 (R3.2), RN11.7 (R2.2), RN11.8 (R1.2), RN12.5 (R4.2), RN12.6 (R3.2), RN12.7 (R2.2), RN12.8 (R1.2), RN13.5 (R4.2), RN13.6 (R3.2), RN13.7 (R2.2), RN13.8 (R1.2), RN14.5 (R4.2), RN14.6 (R3.2), RN14.7 (R2.2), RN14.8 (R1.2), RN15.5 (R4.2), RN15.6 (R3.2), RN15.7 (R2.2), RN15.8 (R1.2), RN16.5 (R4.2), RN16.6 (R3.2), RN16.7 (R2.2), RN16.8 (R1.2), RN17.5 (R4.2), RN17.6 (R3.2), RN17.7 (R2.2), RN17.8 (R1.2), RN18.5 (R4.2), RN18.6 (R3.2), RN18.7 (R2.2), RN18.8 (R1.2), RN19.5 (R4.2), RN19.6 (R3.2), RN19.7 (R2.2), RN19.8 (R1.2), RN20.5 (R4.2), RN20.6 (R3.2), RN20.7 (R2.2), RN20.8 (R1.2), RN21.5 (R4.2), RN21.6 (R3.2), RN21.7 (R2.2), RN21.8 (R1.2), RN22.5 (R4.2), RN22.6 (R3.2), RN22.7 (R2.2), RN22.8 (R1.2), RN23.5 (R4.2), RN23.6 (R3.2), RN23.7 (R2.2), RN23.8 (R1.2), RN24.5 (R4.2), RN24.6 (R3.2), RN24.7 (R2.2), RN24.8 (R1.2), RN25.5 (R4.2), RN25.6 (R3.2), RN25.7 (R2.2), RN25.8 (R1.2), RN26.5 (R4.2), RN26.6 (R3.2), RN26.7 (R2.2), RN26.8 (R1.2), RN27.5 (R4.2), RN27.6 (R3.2), RN27.7 (R2.2), RN27.8 (R1.2), RN28.5 (R4.2), RN28.6 (R3.2), RN28.7 (R2.2), RN28.8 (R1.2), RN29.5 (R4.2), RN29.6 (R3.2), RN29.7 (R2.2), RN29.8 (R1.2), RN30.5 (R4.2), RN30.6 (R3.2), RN30.7 (R2.2), RN30.8 (R1.2), RN31.5 (R4.2), RN31.6 (R3.2), RN31.7 (R2.2), RN31.8 (R1.2), RN32.5 (R4.2), RN32.6 (R3.2), RN32.7 (R2.2), RN32.8 (R1.2), RN33.5 (R4.2), RN33.6 (R3.2), RN33.7 (R2.2), RN33.8 (R1.2), RN34.5 (R4.2), RN34.6 (R3.2), RN34.7 (R2.2), RN34.8 (R1.2), RN35.5 (R4.2), RN35.6 (R3.2), RN35.7 (R2.2), RN35.8 (R1.2), U2.A1 (VCC_VTT), U2.A3 (VCC_VTT), U2.B5 (VCC_VTT), U2.B9 (VCC_VTT)
/VTT_SENSE: R20.2, U1.G20
/ZCLK_ADDR0: R30.1, U10.2 (CLKA1)
/ZCLK_ADDR1: R31.1, U10.3 (CLKA2)
/ZCLK_DATA0: R32.1, U10.14 (CLKA3)
/ZCLK_DATA1: R33.1, U10.15 (CLKA4)
/ZCLK_DATA2: R34.1, U10.6 (CLKB1)
/ZCLK_DATA3: R35.1, U10.7 (CLKB2)
/ZCLK_FB: R37.1, U10.16 (CLKOUT)
/ZCLK_TX: R36.1, U10.10 (CLKB3)

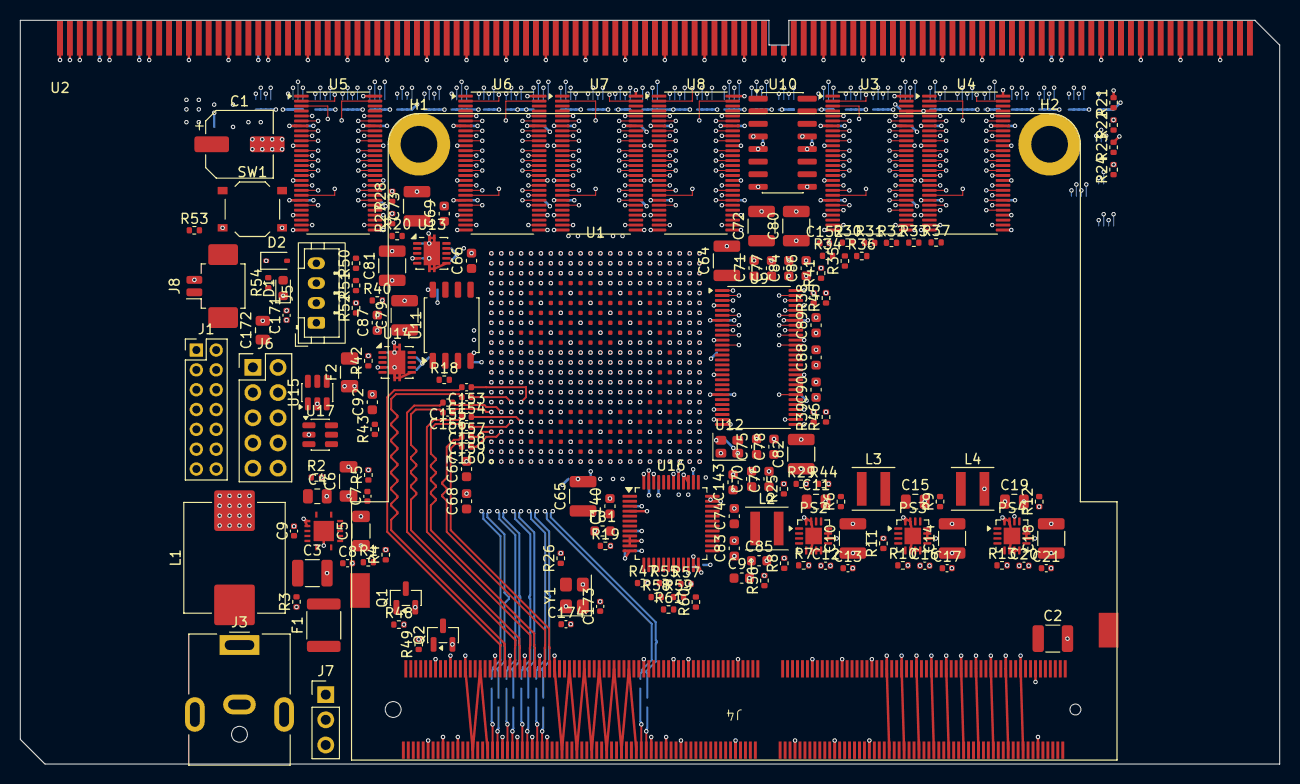
[picture p14: board slot1-c2mu.kicad_pcb from above]

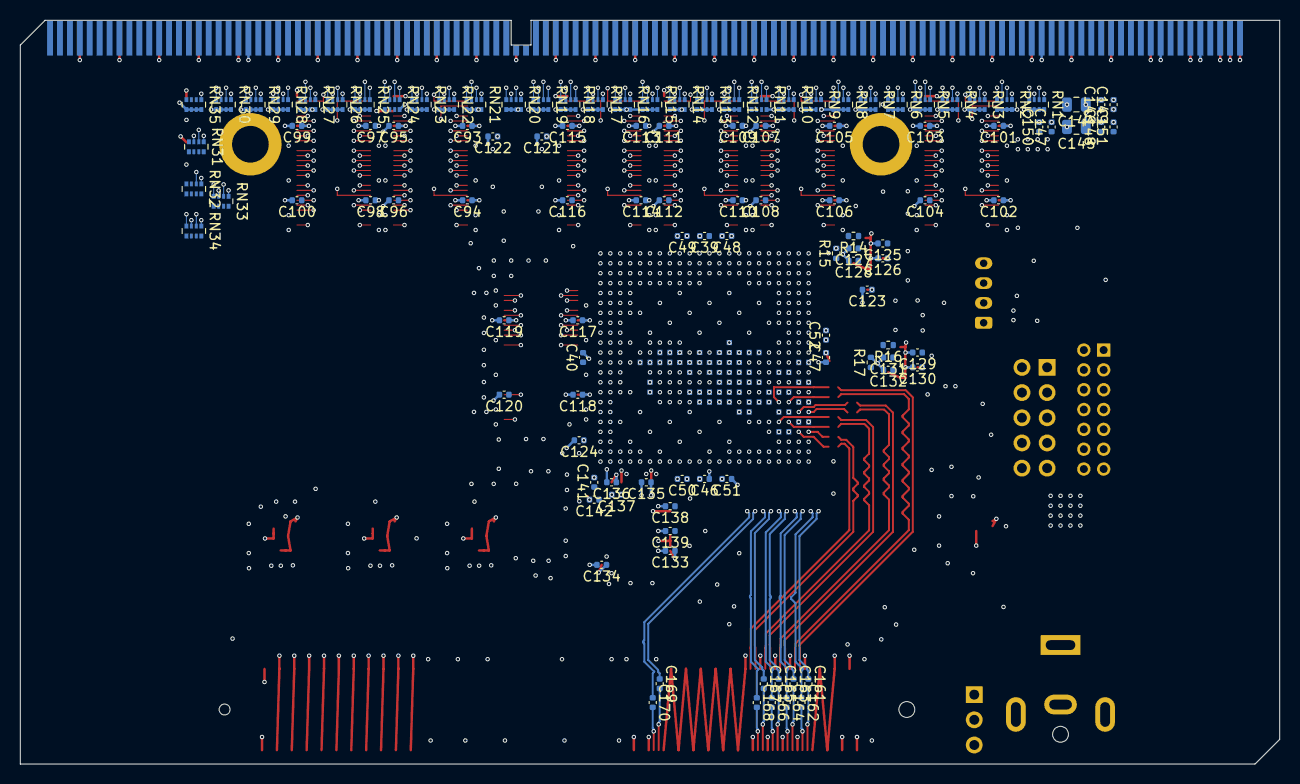
[picture p15: board slot1-c2mu.kicad_pcb from below]

Board: 8 copper layers, 127.0 x 75.0 mm, 313 parts (148 on the bottom side), 403 nets.
