alphaonex86/FPGA-CPU/hw/slot1-cyclonev/slot1-cyclonev.kicad_pcb

## KiCad design hw/slot1-cyclonev/slot1-cyclonev.kicad_pcb (2026-11-02)

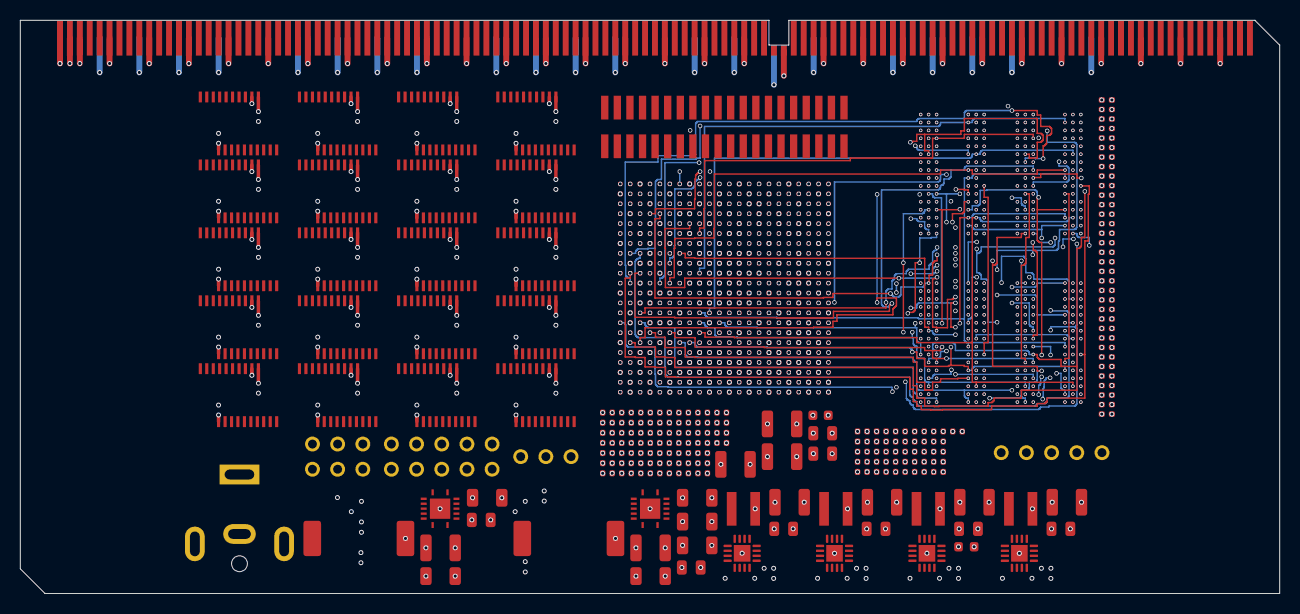
[picture p16: board slot1-cyclonev.kicad_pcb from above]

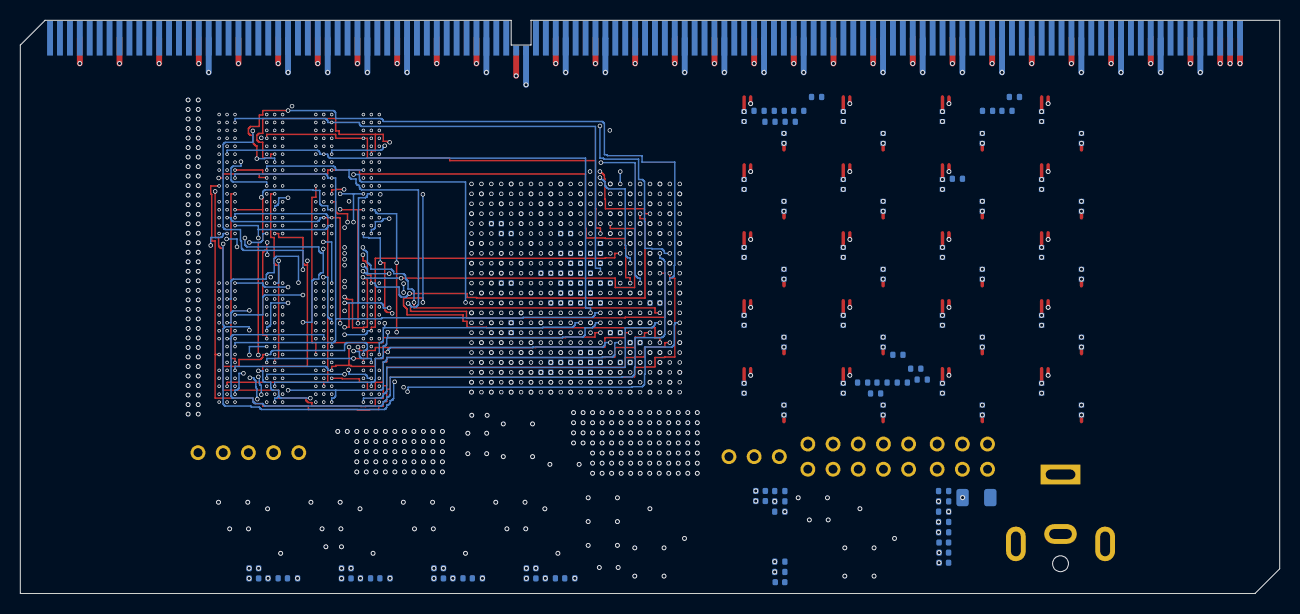
[picture p17: board slot1-cyclonev.kicad_pcb from below]

Board: 8 copper layers, 127.0 x 57.8 mm, 296 parts (121 on the bottom side), 432 nets.

Parts:
C1: C1; C_1210_3225Metric
C2: C2; C_0805_2012Metric
C3: C3; C_1206_3216Metric
C4: C4; C_1206_3216Metric
C5: C5; C_0402_1005Metric
C6: C6; C_0402_1005Metric
C7: C7; C_0402_1005Metric
C8: C8; C_1210_3225Metric
C9: C9; C_0805_2012Metric
C10: C10; C_1206_3216Metric
C11: C11; C_1206_3216Metric
C12: C12; C_1206_3216Metric
C13: C13; C_1206_3216Metric
C14: C14; C_0402_1005Metric
C15: C15; C_0402_1005Metric
C16: C16; C_0402_1005Metric
C17: C17; C_1210_3225Metric
C18: C18; C_0805_2012Metric
C19: C19; C_0402_1005Metric
C20: C20; C_0402_1005Metric
C21: C21; C_1210_3225Metric
C22: C22; C_0805_2012Metric
C23: C23; C_0402_1005Metric
C24: C24; C_0402_1005Metric
C25: C25; C_1210_3225Metric
C26: C26; C_0805_2012Metric
C27: C27; C_0402_1005Metric
C28: C28; C_0402_1005Metric
C29: C29; C_1210_3225Metric
C30: C30; C_0805_2012Metric
C31: C31; C_0402_1005Metric
C32: C32; C_0402_1005Metric
C33: C33; C_0402_P1.00
C34: C34; C_0402_P1.00
C35: C35; C_0402_P1.00
C36: C36; C_0402_P1.00
C37: C37; C_0402_P1.00
C38: C38; C_0402_P1.00
C39: C39; C_0402_P1.00
C40: C40; C_0402_P1.00
C41: C41; C_0402_P1.00
C42: C42; C_0402_P1.00
C43: C43; C_0402_P1.00
C44: C44; C_0402_P1.00
C45: C45; C_0402_P1.00
C46: C46; C_0402_P1.00
C47: C47; C_0402_P1.00
C48: C48; C_0402_P1.00
C49: C49; C_0402_P1.00
C50: C50; C_0402_P1.00
C51: C51; C_0402_P1.00
C52: C52; C_0402_P1.00
C53: C53; C_0402_P1.00
C54: C54; C_0402_P1.00
C55: C55; C_0402_1005Metric
C56: C56; C_0402_1005Metric
C57: C57; C_0402_1005Metric
C58: C58; C_0402_1005Metric
C59: C59; C_0402_1005Metric
C60: C60; C_0402_1005Metric
C61: C61; C_0402_1005Metric
C62: C62; C_0402_1005Metric
C63: C63; C_0402_1005Metric
C64: C64; C_0402_1005Metric
C65: C65; C_0402_1005Metric
C66: C66; C_0402_1005Metric
C67: C67; C_0402_1005Metric
C68: C68; C_0402_1005Metric
C69: C69; C_0402_1005Metric
C70: C70; C_0402_1005Metric
C71: C71; C_0402_1005Metric
C72: C72; C_0402_1005Metric
C73: C73; C_0402_1005Metric
C74: C74; C_0402_1005Metric
C75: C75; C_0402_1005Metric
C76: C76; C_0402_1005Metric
C77: C77; C_0402_1005Metric
C78: C78; C_0402_1005Metric
C79: C79; C_0402_1005Metric
C80: C80; C_0402_1005Metric
C81: C81; C_0402_1005Metric
C82: C82; C_0402_1005Metric
C83: C83; C_0402_1005Metric
C84: C84; C_0402_1005Metric
C85: C85; C_0402_1005Metric
C86: C86; C_0402_P1.00
C87: C87; C_0402_P1.00
C88: C88; C_0402_P1.00
C89: C89; C_0402_1005Metric
C90: C90; C_0402_1005Metric
C91: C91; C_0402_1005Metric
C92: C92; C_0402_1005Metric
C93: C93; C_0402_1005Metric
C94: C94; C_0402_1005Metric
C95: C95; C_0402_1005Metric
C96: C96; C_0402_P1.00
C97: C97; C_0402_1005Metric
C98: C98; C_0402_1005Metric
C99: C99; C_0402_1005Metric
C100: C100; C_0402_1005Metric
C101: C101; C_0402_1005Metric
C102: C102; C_0402_1005Metric
C103: C103; C_0402_1005Metric
C104: C104; C_0402_1005Metric
C105: C105; C_0402_P1.00
C106: C106; C_0402_P1.00
C107: C107; C_0402_P1.00
C108: C108; C_0402_P1.00
C109: C109; C_0402_P1.00
C110: C110; C_1210_3225Metric
C111: C111; C_1210_3225Metric
C112: C112; C_1210_3225Metric
C113: C113; C_0603_1608Metric
C114: C114; C_0805_2012Metric
C115: C115; C_0805_2012Metric
C116: C116; C_0402_P1.00
C117: C117; C_0402_P1.00
C118: C118; C_0402_P1.00
C119: C119; C_0402_P1.00
C120: C120; C_0402_P1.00
C121: C121; C_0402_P1.00
C122: C122; C_0402_P1.00
C123: C123; C_0402_P1.00
C124: C124; C_0402_P1.00
C125: C125; C_0402_P1.00
C126: C126; C_0402_P1.00
C127: C127; C_0402_P1.00
C128: C128; C_0402_P1.00
C129: C129; C_0402_P1.00
C130: C130; C_0402_P1.00
C131: C131; C_0402_P1.00
C132: C132; C_0402_P1.00
C133: C133; C_0402_P1.00
C134: C134; C_0402_P1.00
C135: C135; C_0402_P1.00
C136: C136; C_0402_P1.00
C137: C137; C_0402_P1.00
C138: C138; C_0402_P1.00
C139: C139; C_0402_P1.00
C140: C140; C_0402_P1.00
C141: C141; C_0402_P1.00
C142: C142; C_0402_P1.00
C143: C143; C_0402_P1.00
C144: C144; C_0402_P1.00
C145: C145; C_0402_P1.00
C146: C146; C_0402_P1.00
C147: C147; C_0402_P1.00
C148: C148; C_0402_P1.00
C149: C149; C_0402_P1.00
C150: C150; C_0402_P1.00
C151: C151; C_0402_P1.00
C152: C152; C_0402_P1.00
C153: C153; C_0402_P1.00
C154: C154; C_0402_P1.00
C155: C155; C_0402_P1.00
C156: C156; C_0402_1005Metric
C157: C157; C_0402_1005Metric
C158: C158; C_0402_1005Metric
C159: C159; C_0402_1005Metric
C160: C160; C_0402_1005Metric
C161: C161; C_0402_1005Metric
C162: C162; C_0402_1005Metric
C163: C163; C_0402_1005Metric
C164: C164; C_0402_1005Metric
C165: C165; C_0402_1005Metric
C166: C166; C_0402_1005Metric
C167: C167; C_0402_1005Metric
C168: C168; C_0402_1005Metric
C169: C169; C_0402_1005Metric
C170: C170; C_0402_1005Metric
C171: C171; C_0402_1005Metric
C172: C172; C_0402_1005Metric
C173: C173; C_0402_1005Metric
C174: C174; C_0402_1005Metric
C175: C175; C_0402_1005Metric
C176: C176; C_0402_1005Metric
C177: C177; C_0402_1005Metric
C178: C178; C_0402_1005Metric
C179: C179; C_0402_1005Metric
C180: C180; C_0402_1005Metric
C181: C181; C_0402_1005Metric
C182: C182; C_0402_1005Metric
C183: C183; C_0402_1005Metric
C184: C184; C_0402_1005Metric
C185: C185; C_0402_1005Metric
C186: C186; C_0402_1005Metric
C187: C187; C_0402_1005Metric
C188: C188; C_0402_1005Metric
C189: C189; C_0402_1005Metric
C190: C190; C_0402_1005Metric
C191: C191; C_0402_1005Metric
C192: C192; C_0402_1005Metric
C193: C193; C_0402_1005Metric
C194: C194; C_0402_1005Metric
C195: C195; C_0402_1005Metric
C196: C196; C_0402_1005Metric
C197: C197; C_0402_1005Metric
C198: C198; C_0402_1005Metric
C199: C199; C_0402_1005Metric
C200: C200; C_0402_1005Metric
C201: C201; C_0402_1005Metric
C202: C202; C_0402_1005Metric
C203: C203; C_0402_1005Metric
C204: C204; C_0402_1005Metric
C205: C205; C_0402_1005Metric
C206: C206; C_0402_1005Metric
C207: C207; C_0402_1005Metric
C208: C208; C_0402_1005Metric
C209: C209; C_0402_1005Metric
C210: C210; C_0402_1005Metric
C211: C211; C_0402_1005Metric
C212: C212; C_0402_1005Metric
C213: C213; C_0402_1005Metric
C214: C214; C_0402_1005Metric
C215: C215; C_0402_1005Metric
F1: F1; Fuse_1206_3216Metric
FB1: FB1; L_0603_1608Metric
J1: J1; Header_2x03
J2: J2; Header_2x05
J3: J3; BarrelJack_CUI_PJ-063AH_Horizontal
J4: J4; Header_1x03
J5: J5; PinHeader_2x20_P1.27mm_Vertical_SMD
L1: L1; L_Coilcraft_MSS1048-XXX
L2: L2; L_Coilcraft_MSS1048-XXX
L3: L3; L_Coilcraft_XxL4020
L4: L4; L_Coilcraft_XxL4020
L5: L5; L_Coilcraft_XxL4020
L6: L6; L_Coilcraft_XxL4020
PS1: PS1; TI_RHL0014A
PS2: PS2; TI_RHL0014A
PS3: PS3; VQFN-16-1EP_3x3mm_P0.5mm_EP1.68x1.68mm
PS4: PS4; VQFN-16-1EP_3x3mm_P0.5mm_EP1.68x1.68mm
PS5: PS5; VQFN-16-1EP_3x3mm_P0.5mm_EP1.68x1.68mm
PS6: PS6; VQFN-16-1EP_3x3mm_P0.5mm_EP1.68x1.68mm
R1: R1; R_0402_1005Metric
R2: R2; R_0402_1005Metric
R3: R3; R_0402_1005Metric
R4: R4; R_0402_1005Metric
R5: R5; R_0402_1005Metric
R6: R6; R_0402_1005Metric
R7: R7; R_0402_1005Metric
R8: R8; R_0402_1005Metric
R9: R9; R_0402_1005Metric
R10: R10; R_0402_1005Metric
R11: R11; R_0402_1005Metric
R12: R12; R_0402_1005Metric
R13: R13; R_0402_1005Metric
R14: R14; R_0402_1005Metric
R15: R15; R_0402_1005Metric
R16: R16; R_0402_1005Metric
R17: R17; R_0402_1005Metric
R18: R18; R_0402_1005Metric
RL01: RL01; R_0402_1005Metric
RL02: RL02; R_0402_1005Metric
RL03: RL03; R_0402_1005Metric
RL04: RL04; R_0402_1005Metric
RL05: RL05; R_0402_1005Metric
RL06: RL06; R_0402_1005Metric
RL07: RL07; R_0402_1005Metric
RL08: RL08; R_0402_1005Metric
RL09: RL09; R_0402_1005Metric
RL10: RL10; R_0402_1005Metric
RL11: RL11; R_0402_1005Metric
RL12: RL12; R_0402_1005Metric
RL13: RL13; R_0402_1005Metric
RL14: RL14; R_0402_1005Metric
RL15: RL15; R_0402_1005Metric
RL16: RL16; R_0402_1005Metric
RL17: RL17; R_0402_1005Metric
TR01: TR01; Translator_TSSOP20
TR02: TR02; Translator_TSSOP20
TR03: TR03; Translator_TSSOP20
TR04: TR04; Translator_TSSOP20
TR05: TR05; Translator_TSSOP20
TR06: TR06; Translator_TSSOP20
TR07: TR07; Translator_TSSOP20
TR08: TR08; Translator_TSSOP20
TR09: TR09; Translator_TSSOP20
TR10: TR10; Translator_TSSOP20
TR11: TR11; Translator_TSSOP20
TR12: TR12; Translator_TSSOP20
TR13: TR13; Translator_TSSOP20
TR14: TR14; Translator_TSSOP20
TR15: TR15; Translator_TSSOP20
TR16: TR16; Translator_TSSOP20
TR17: TR17; Translator_TSSOP20
TR18: TR18; Translator_TSSOP20
TR19: TR19; Translator_TSSOP20
TR20: TR20; Translator_TSSOP20
U1: U1; FPGA_CycloneV_5CEFA9_F484_BGA
U2: U2; SC242_CardEdge_242
U3: U3; FBGA96_x16
U4: U4; FBGA96_x16
U5: U5; FBGA96_x16
U6: U6; FBGA96_x16
U7: U7; VTT_tracker

Connections:
/A20M#: TR01.A1, U1.AA10
/ADS#: TR16.A4, U1.Y15
/AERR#: J5.33, RL15.1, U1.Y16
/AP[0]#: J5.19, RL13.1, U1.Y11
/AP[1]#: J5.31, RL14.1, U1.Y14
/A[3]#: TR03.A1, U1.AA8
/A[4]#: TR03.A2, U1.AA9
/A[5]#: TR03.A3, U1.AB10
/A[6]#: TR03.A4, U1.AB11
/A[7]#: TR03.A5, U1.AB12
/A[8]#: TR03.A6, U1.AB13
/A[9]#: TR03.A7, U1.AB15
/A[10]#: TR03.A8, U1.AB17
/A[11]#: TR04.A1, U1.AB18
/A[12]#: TR04.A2, U1.AB20
/A[13]#: TR04.A3, U1.AB21
/A[14]#: TR04.A4, U1.AB22
/A[15]#: TR04.A5, U1.AB5
/A[16]#: TR04.A6, U1.AB6
/A[17]#: TR04.A7, U1.AB7
/A[18]#: TR04.A8, U1.AB8
/A[19]#: TR05.A1, U1.K17
/A[20]#: TR05.A2, U1.K21
/A[21]#: TR05.A3, U1.K22
/A[22]#: TR05.A4, U1.L17
/A[23]#: TR05.A5, U1.L18
/A[24]#: TR05.A6, U1.L19
/A[25]#: TR05.A7, U1.L22
/A[26]#: TR05.A8, U1.M16
/A[27]#: TR06.A1, U1.M18
/A[28]#: TR06.A2, U1.M20
/A[29]#: TR06.A3, U1.M21
/A[30]#: TR06.A4, U1.M22
/A[31]#: TR06.A5, U1.M6
/A[32]#: J5.23, RL01.1, U1.M7
/A[33]#: J5.25, RL02.1, U1.N16
/A[34]#: J5.27, RL03.1, U1.N19
/A[35]#: J5.29, RL04.1, U1.N20
/BCLK: U1.M9, U2.A75
/BERR#: J5.35, RL16.1, U1.Y17
/BINIT#: J5.36, RL17.1, U1.Y19
/BNR#: TR16.A8, U1.Y20
/BPRI#: TR17.A1, U1.Y21
/BR0#: TR17.A2, U1.Y22
/BR1#: TR17.A3, U1.Y9
/CFG_CONF_DONE: J2.5, U1.K6
/CFG_DATA0: J2.9, U1.AB4
/CFG_DCLK: J2.7, U1.V3
/CFG_nCONFIG: J2.1, U1.A4
/CFG_nSTATUS: J2.3, U1.H5
/DBSY#: TR18.A1, U1.A14
/DDR3_A0: U1.L7, U3.N3, U4.N3, U5.N3, U6.N3
/DDR3_A1: U1.K7, U3.P7, U4.P7, U5.P7, U6.P7
/DDR3_A2: U1.H8, U3.P3, U4.P3, U5.P3, U6.P3
/DDR3_A3: U1.G8, U3.N2, U4.N2, U5.N2, U6.N2
/DDR3_A4: U1.J7, U3.P8, U4.P8, U5.P8, U6.P8
/DDR3_A5: U1.J8, U3.P2, U4.P2, U5.P2, U6.P2
/DDR3_A6: U1.A10, U3.R8, U4.R8, U5.R8, U6.R8
/DDR3_A7: U1.A9, U3.R2, U4.R2, U5.R2, U6.R2
/DDR3_A8: U1.A8, U3.T8, U4.T8, U5.T8, U6.T8
/DDR3_A9: U1.A7, U3.R3, U4.R3, U5.R3, U6.R3
/DDR3_A10: U1.C6, U3.L7, U4.L7, U5.L7, U6.L7
/DDR3_A11: U1.D6, U3.R7, U4.R7, U5.R7, U6.R7
/DDR3_A12: U1.D7, U3.N7, U4.N7, U5.N7, U6.N7
/DDR3_A13: U1.C8, U3.T3, U4.T3, U5.T3, U6.T3
/DDR3_A14: U1.G6, U3.T7, U4.T7, U5.T7, U6.T7
/DDR3_A15: U1.H6, U3.M7, U4.M7, U5.M7, U6.M7
/DDR3_BA0: U1.A5, U3.M2, U4.M2, U5.M2, U6.M2
/DDR3_BA1: U1.B10, U3.N8, U4.N8, U5.N8, U6.N8
/DDR3_BA2: U1.C9, U3.M3, U4.M3, U5.M3, U6.M3
/DDR3_CAS#: U1.B6, U3.K3, U4.K3, U5.K3, U6.K3
/DDR3_CK: U1.J9, U3.J7, U4.J7, U5.J7, U6.J7
/DDR3_CK#: U1.H9, U3.K7, U4.K7, U5.K7, U6.K7
/DDR3_CKE0: U1.F14, U3.K9, U4.K9
/DDR3_CKE1: U1.B13, U5.K9, U6.K9
/DDR3_CS#0: U1.E9, U3.L2, U4.L2
/DDR3_CS#1: U1.D9, U5.L2, U6.L2
/DDR3_DM0: U1.G11, U3.E7, U5.E7
/DDR3_DM1: U1.J17, U3.D3, U5.D3
/DDR3_DM2: U1.B16, U4.E7, U6.E7
/DDR3_DM3: U1.E21, U4.D3, U6.D3
/DDR3_DQ00: U1.E12, U3.E3, U5.E3
/DDR3_DQ01: U1.D12, U3.F7, U5.F7
/DDR3_DQ02: U1.C11, U3.F2, U5.F2
/DDR3_DQ03: U1.K9, U3.F8, U5.F8
/DDR3_DQ04: U1.C13, U3.H3, U5.H3
/DDR3_DQ05: U1.D13, U3.H8, U5.H8
/DDR3_DQ06: U1.B12, U3.G2, U5.G2
/DDR3_DQ07: U1.F12, U3.H7, U5.H7
/DDR3_DQ08: U3.D7, U5.D7
/DDR3_DQ09: U3.C3, U5.C3
/DDR3_DQ10: U3.C8, U5.C8
/DDR3_DQ11: U3.C2, U5.C2
/DDR3_DQ12: U3.A7, U5.A7
/DDR3_DQ13: U3.A2, U5.A2
/DDR3_DQ14: U3.B8, U5.B8
/DDR3_DQ15: U3.A3, U5.A3
/DDR3_DQ16: U1.F13, U1.F15, U4.E3, U6.E3
/DDR3_DQ17: U1.E14, U1.E15, U4.F7, U6.F7
/DDR3_DQ18: U1.A15, U1.J11, U4.F2, U6.F2
/DDR3_DQ19: U1.A13, U1.J18, U4.F8, U6.F8
/DDR3_DQ20: U1.B15, U1.E16, U4.H3, U6.H3
/DDR3_DQ21: U1.C15, U1.D17, U4.H8, U6.H8
/DDR3_DQ22: U1.G15, U1.G17, U4.G2, U6.G2
/DDR3_DQ23: U1.C16, U1.K16, U4.H7, U6.H7
/DDR3_DQ24: U1.B21, U4.D7, U6.D7
/DDR3_DQ25: U1.C21, U4.C3, U6.C3
/DDR3_DQ26: U1.G22, U4.C8, U6.C8
/DDR3_DQ27: U1.B17, U4.C2, U6.C2
/DDR3_DQ28: U1.D19, U4.A7, U6.A7
/DDR3_DQ29: U1.E19, U4.A2, U6.A2
/DDR3_DQ30: U1.C20, U4.B8, U6.B8
/DDR3_DQ31: U1.D21, U4.A3, U6.A3
/DDR3_DQS0N: U1.G12, U3.G3, U5.G3
/DDR3_DQS0P: U1.H11, U3.F3, U5.F3
/DDR3_DQS1N: U1.J13, U3.B7, U5.B7
/DDR3_DQS1P: U1.H14, U3.C7, U5.C7
/DDR3_DQS2N: U1.H18, U4.G3, U6.G3
/DDR3_DQS2P: U1.G18, U4.F3, U6.F3
/DDR3_DQS3N: U1.J22, U4.B7, U6.B7
/DDR3_DQS3P: U1.J21, U4.C7, U6.C7
/DDR3_ODT0: U1.L8, U3.K1, U4.K1
/DDR3_ODT1: U1.A12, U5.K1, U6.K1
/DDR3_RAS#: U1.B7, U3.J3, U4.J3, U5.J3, U6.J3
/DDR3_RESET#: U1.J19, U3.T2, U4.T2, U5.T2, U6.T2
/DDR3_WE#: U1.F7, U3.L3, U4.L3, U5.L3, U6.L3
/DEFER#: TR18.A2, U1.B18
/DEP[0]#: J5.3, RL05.1, U1.V9
/DEP[1]#: J5.5, RL06.1, U1.W16
/DEP[2]#: J5.7, RL07.1, U1.W19
/DEP[3]#: J5.9, RL08.1, U1.W21
/DEP[4]#: J5.11, RL09.1, U1.W22
/DEP[5]#: J5.13, RL10.1, U1.W8
/DEP[6]#: J5.15, RL11.1, U1.W9
/DEP[7]#: J5.17, RL12.1, U1.Y10
/DRDY#: TR18.A3, U1.B20
/D[0]#: TR07.A2, U1.N21
/D[1]#: TR07.A3, U1.N6
/D[2]#: TR07.A4, U1.N8
/D[3]#: TR07.A5, U1.N9
/D[4]#: TR07.A6, U1.P12
/D[5]#: TR07.A7, U1.P14
/D[6]#: TR07.A8, U1.P16
/D[7]#: TR08.A1, U1.P17
/D[8]#: TR08.A2, U1.P18
/D[9]#: TR08.A3, U1.P19
/D[10]#: TR08.A4, U1.P22
/D[11]#: TR08.A5, U1.P6
/D[12]#: TR08.A6, U1.P7
/D[13]#: TR08.A7, U1.P8
/D[14]#: TR08.A8, U1.P9
/D[15]#: TR09.A1, U1.R10
/D[16]#: TR09.A2, U1.R11
/D[17]#: TR09.A3, U1.R12
/D[18]#: TR09.A4, U1.R14
/D[19]#: TR09.A5, U1.R15
/D[20]#: TR09.A6, U1.R16
/D[21]#: TR09.A7, U1.R17
/D[22]#: TR09.A8, U1.R21
/D[23]#: TR10.A1, U1.R22
/D[24]#: TR10.A2, U1.R5
/D[25]#: TR10.A3, U1.R6
/D[26]#: TR10.A4, U1.R7
/D[27]#: TR10.A5, U1.R9
/D[28]#: TR10.A6, U1.T10
/D[29]#: TR10.A7, U1.T12
/D[30]#: TR10.A8, U1.T13
/D[31]#: TR11.A1, U1.T14
/D[32]#: TR11.A2, U1.T15
/D[33]#: TR11.A3, U1.T17
/D[34]#: TR11.A4, U1.T18
/D[35]#: TR11.A5, U1.T19
/D[36]#: TR11.A6, U1.T20
/D[37]#: TR11.A7, U1.T22
/D[38]#: TR11.A8, U1.T7
/D[39]#: TR12.A1, U1.T8
/D[40]#: TR12.A2, U1.T9
/D[41]#: TR12.A3, U1.U10
/D[42]#: TR12.A4, U1.U11
/D[43]#: TR12.A5, U1.U12
/D[44]#: TR12.A6, U1.U13
/D[45]#: TR12.A7, U1.U15
/D[46]#: TR12.A8, U1.U16
/D[47]#: TR13.A1, U1.U17
/D[48]#: TR13.A2, U1.U20
/D[49]#: TR13.A3, U1.U21
/D[50]#: TR13.A4, U1.U22
/D[51]#: TR13.A5, U1.U6
/D[52]#: TR13.A6, U1.U7
/D[53]#: TR13.A7, U1.U8
/D[54]#: TR13.A8, U1.V10
/D[55]#: TR14.A1, U1.V13
/D[56]#: TR14.A2, U1.V14
/D[57]#: TR14.A3, U1.V15
/D[58]#: TR14.A4, U1.V16
/D[59]#: TR14.A5, U1.V18
/D[60]#: TR14.A6, U1.V19
/D[61]#: TR14.A7, U1.V20
/D[62]#: TR14.A8, U1.V21
/D[63]#: TR15.A1, U1.V6
/FLUSH#: TR01.A2, U1.AA12
/F_TCK: J1.1, U1.V5
/F_TDI: J1.5, U1.W5
/F_TDO: J1.6, U1.M5
/F_TMS: J1.3, U1.P5
/GND: C1.2, C2.2, C3.2, C4.2, C6.2, C7.2, C8.2, C9.2, C10.2, C11.2, C12.2, C13.2, C15.2, C16.2, C17.2, C18.2, C19.2, C20.2, C21.2, C22.2, C23.2, C24.2, C25.2, C26.2, C27.2, C28.2, C29.2, C30.2, C31.2, C32.2, C33.2, C34.2, C35.2, C36.2, C37.2, C38.2, C39.2, C40.2, C41.2, C42.2, C43.2, C44.2, C45.2, C46.2, C47.2, C48.2, C49.2, C50.2, C51.2, C52.2, C53.2, C54.2, C55.2, C56.2, C57.2, C58.2, C59.2, C60.2, C61.2, C62.2, C63.2, C64.2, C65.2, C66.2, C67.2, C68.2, C69.2, C70.2, C71.2, C72.2, C73.2, C74.2, C75.2, C76.2, C77.2, C78.2, C79.2, C80.2, C81.2, C82.2, C83.2, C84.2, C85.2, C86.2, C87.2, C88.2, C89.2, C90.2, C91.2, C92.2, C93.2, C94.2, C95.2, C96.2, C97.2, C98.2, C99.2, C100.2, C101.2, C102.2, C103.2, C104.2, C105.2, C106.2, C107.2, C108.2, C109.2, C110.2, C111.2, C112.2, C113.2, C114.2, C115.2, C116.2, C117.2, C118.2, C119.2, C120.2, C121.2, C122.2, C123.2, C124.2, C125.2, C126.2, C127.2, C128.2, C129.2, C130.2, C131.2, C132.2, C133.2, C134.2, C135.2, C136.2, C137.2, C138.2, C139.2, C140.2, C141.2, C142.2, C143.2, C144.2, C145.2, C146.2, C147.2, C148.2, C149.2, C150.2, C151.2, C152.2, C153.2, C154.2, C155.2, C156.2, C157.2, C158.2, C159.2, C160.2, C161.2, C162.2, C163.2, C164.2, C165.2, C166.2, C167.2, C168.2, C169.2, C170.2, C171.2, C172.2, C173.2, C174.2, C175.2, C176.2, C177.2, C178.2, C179.2, C180.2, C181.2, C182.2, C183.2, C184.2, C185.2, C186.2, C187.2, C188.2, C189.2, C190.2, C191.2, C192.2, C193.2, C194.2, C195.2, C196.2, C197.2, C198.2, C199.2, C200.2, C201.2, C202.2, C203.2, C204.2, C205.2, C206.2, C207.2, C208.2, C209.2, C210.2, C211.2, C212.2, C213.2, C214.2, C215.2, J1.2, J1.4, J2.2, J2.4, J2.6, J2.8, J2.10, J3.2, J4.3, J5.1, J5.4, J5.6, J5.8, J5.10, J5.12, J5.14, J5.16, J5.18, J5.20, J5.22, J5.24, J5.26, J5.28, J5.30, J5.32, J5.34, J5.37, J5.38, PS1.2, PS1.3, PS1.15, PS2.2, PS2.3, PS2.15, PS3.6, PS3.7, PS3.8, PS3.15, PS3.16, PS3.17, PS4.6, PS4.7, PS4.8, PS4.15, PS4.16, PS4.17, PS5.6, PS5.7, PS5.8, PS5.15, PS5.16, PS5.17, PS6.6, PS6.7, PS6.8, PS6.15, PS6.16, PS6.17, R2.2, R4.2, R7.2, R9.2, R12.2, R14.2, R16.2, R18.2, TR01.GND, TR02.GND, TR03.GND, TR04.GND, TR05.GND, TR06.GND, TR07.GND, TR08.GND, TR09.GND, TR10.GND, TR11.GND, TR12.GND, TR13.GND, TR14.GND, TR15.GND, TR16.GND, TR17.GND, TR18.GND, TR19.GND, TR20.GND, U1.A11, U1.A21, U1.AA3, U1.AA4, U1.AA6, U1.AA11, U1.AB1, U1.AB2, U1.AB9, U1.AB14, U1.AB19, U1.B1, U1.B2, U1.B9, U1.B14, U1.C3, U1.C4, U1.C5, U1.C17, U1.D1, U1.D2, U1.D5, U1.D10, U1.D20, U1.E3, U1.E4, U1.E13, U1.F1, U1.F2, U1.F5, U1.F6, U1.F16, U1.F17, U1.G3, U1.G4, U1.G9, U1.G19, U1.H1, U1.H2, U1.H3, U1.H4, U1.H7, U1.H12, U1.H22, U1.J3, U1.J5, U1.J15, U1.J20, U1.K1, U1.K2, U1.K4, U1.K8, U1.K10, U1.K12, U1.K14, U1.L3, U1.L5, U1.L11, U1.L13, U1.L15, U1.L21, U1.M1, U1.M2, U1.M4, U1.M10, U1.M12, U1.M14, U1.N3, U1.N5, U1.N7, U1.N11, U1.N13, U1.N15, U1.N17, U1.N22, U1.P1, U1.P2, U1.P4, U1.P10, U1.R3, U1.R13, U1.T1, U1.T2, U1.T16, U1.T21, U1.U3, U1.U4, U1.U5, U1.U9, U1.V1, U1.V2, U1.V4, U1.V7, U1.V12, U1.V17, U1.V22, U1.W3, U1.W4, U1.Y1, U1.Y2, U1.Y5, U1.Y18, U2.A2, U2.A6, U2.A10, U2.A14, U2.A18, U2.A22, U2.A26, U2.A30, U2.A34, U2.A38, U2.A42, U2.A46, U2.A50, U2.A54, U2.A58, U2.A62, U2.A66, U2.A70, U2.A74, U2.A78, U2.A82, U2.A86, U2.A90, U2.A94, U2.A98, U2.A102, U2.A106, U2.A110, U2.A114, U2.A118, U3.A9, U3.B1, U3.B3, U3.B9, U3.D1, U3.D8, U3.E1, U3.E2, U3.E8, U3.F9, U3.G1, U3.G8, U3.G9, U3.J2, U3.J8, U3.M1, U3.M9, U3.P1, U3.P9, U3.T1, U3.T9, U4.A9, U4.B1, U4.B3, U4.B9, U4.D1, U4.D8, U4.E1, U4.E2, U4.E8, U4.F9, U4.G1, U4.G8, U4.G9, U4.J2, U4.J8, U4.M1, U4.M9, U4.P1, U4.P9, U4.T1, U4.T9, U5.A9, U5.B1, U5.B3, U5.B9, U5.D1, U5.D8, U5.E1, U5.E2, U5.E8, U5.F9, U5.G1, U5.G8, U5.G9, U5.J2, U5.J8, U5.M1, U5.M9, U5.P1, U5.P9, U5.T1, U5.T9, U6.A9, U6.B1, U6.B3, U6.B9, U6.D1, U6.D8, U6.E1, U6.E2, U6.E8, U6.F9, U6.G1, U6.G8, U6.G9, U6.J2, U6.J8, U6.M1, U6.M9, U6.P1, U6.P9, U6.T1, U6.T9, U7.GND
/HIT#: TR18.A4, U1.B5
/HITM#: TR18.A5, U1.E10
/IGNNE#: TR01.A3, U1.AA13
/INIT#: TR01.A4, U1.AA14
/LINK_DCLK: J5.21, U1.M8
/LINT[0]/INTR: TR01.A5, U1.AA15
/LINT[1]/NMI: TR01.A6, U1.AA17
/LOCK#: TR18.A6, U1.E7
/PG_1V1: PS2.14, PS3.13, PS4.13, PS5.13, PS6.13, R10.1
/PG_5V: PS1.14, PS2.10, R5.1
/PS1_BOOT: C5.1, PS1.13
/PS1_COMP: PS1.8, R1.1
/PS1_CZ: C7.1, R1.2
/PS1_FB: PS1.7, R3.2, R4.1
/PS1_RT: PS1.1, R2.1
/PS1_SS: C6.1, PS1.9
/PS1_SW: C5.2, L1.1, PS1.11, PS1.12
/PS2_BOOT: C14.1, PS2.13
/PS2_COMP: PS2.8, R6.1
/PS2_CZ: C16.1, R6.2
/PS2_FB: PS2.7, R8.2, R9.1
/PS2_RT: PS2.1, R7.1
/PS2_SS: C15.1, PS2.9
/PS2_SW: C14.2, L2.1, PS2.11, PS2.12
/PS3_FB: PS3.5, R11.2, R12.1
/PS3_SS: C20.1, PS3.9
/PS3_SW: L3.1, PS3.1, PS3.2, PS3.3
/PS4_FB: PS4.5, R13.2, R14.1
/PS4_SS: C24.1, PS4.9
/PS4_SW: L4.1, PS4.1, PS4.2, PS4.3
/PS5_FB: PS5.5, R15.2, R16.1
/PS5_SS: C28.1, PS5.9
/PS5_SW: L5.1, PS5.1, PS5.2, PS5.3
/PS6_FB: PS6.5, R17.2, R18.1
/PS6_SS: C32.1, PS6.9
/PS6_SW: L6.1, PS6.1, PS6.2, PS6.3
/PWRGOOD: TR01.A7, U1.AA18
/REQ[0]#: TR18.A7, U1.F10
/REQ[1]#: TR18.A8, U1.F22
/REQ[2]#: TR19.A1, U1.F9
/REQ[3]#: TR19.A2, U1.G10
/REQ[4]#: TR19.A3, U1.G13
/RESET#: TR20.A2, U1.H21
/RP#: TR19.A4, U1.G16
/RSP#: TR19.A5, U1.G21
/RS[0]#: TR19.A6, U1.H10
/RS[1]#: TR19.A7, U1.H13
/RS[2]#: TR19.A8, U1.H15
/SLP#: TR01.A8, U1.AA19
/SMI#: TR02.A1, U1.AA20
/STPCLK#: TR02.A2, U1.AA22
/S_A20M#: TR01.B1, U2.A5
/S_ADS#: TR16.B4, U2.A115
/S_AERR#: TR16.B5, U2.B118
/S_AP[0]#: TR16.B2, U2.A117
/S_AP[1]#: TR16.B3, U2.B116
/S_A[3]#: TR03.B1, U2.B98
/S_A[4]#: TR03.B2, U2.A100
/S_A[5]#: TR03.B3, U2.A97
/S_A[6]#: TR03.B4, U2.B99
/S_A[7]#: TR03.B5, U2.B96
/S_A[8]#: TR03.B6, U2.B95
/S_A[9]#: TR03.B7, U2.A99
/S_A[10]#: TR03.B8, U2.A96
/S_A[11]#: TR04.B1, U2.B92
/S_A[12]#: TR04.B2, U2.B94
/S_A[13]#: TR04.B3, U2.A93
/S_A[14]#: TR04.B4, U2.A95
/S_A[15]#: TR04.B5, U2.B90
/S_A[16]#: TR04.B6, U2.A92
/S_A[17]#: TR04.B7, U2.B91
/S_A[18]#: TR04.B8, U2.A91
/S_A[19]#: TR05.B1, U2.A89
/S_A[20]#: TR05.B2, U2.B86
/S_A[21]#: TR05.B3, U2.B87
/S_A[22]#: TR05.B4, U2.A85
/S_A[23]#: TR05.B5, U2.A87
/S_A[24]#: TR05.B6, U2.B83
/S_A[25]#: TR05.B7, U2.B88
/S_A[26]#: TR05.B8, U2.B82
/S_A[27]#: TR06.B1, U2.A84
/S_A[28]#: TR06.B2, U2.B84
/S_A[29]#: TR06.B3, U2.B80
/S_A[30]#: TR06.B4, U2.A81
/S_A[31]#: TR06.B5, U2.A83
/S_A[32]#: TR06.B6, U2.B79
/S_A[33]#: TR06.B7, U2.A79
/S_A[34]#: TR06.B8, U2.A80
/S_A[35]#: TR07.B1, U2.B78
/S_BERR#: TR16.B6, U2.A77
/S_BINIT#: TR16.B7, U2.A24
/S_BNR#: TR16.B8, U2.A101
/S_BPRI#: TR17.B1, U2.A103
/S_BR0#: TR17.B2, U2.A76
/S_BR1#: TR17.B3, U2.B75
/S_DBSY#: TR18.B1, U2.A111
/S_DEFER#: TR18.B2, U2.A105
/S_DEP[0]#: TR15.B2, U2.A25
/S_DEP[1]#: TR15.B3, U2.A27
/S_DEP[2]#: TR15.B4, U2.B26
/S_DEP[3]#: TR15.B5, U2.A28
/S_DEP[4]#: TR15.B6, U2.B27
/S_DEP[5]#: TR15.B7, U2.A29
/S_DEP[6]#: TR15.B8, U2.A31
/S_DEP[7]#: TR16.B1, U2.B28
/S_DRDY#: TR18.B3, U2.B107
/S_D[0]#: TR07.B2, U2.B72
/S_D[1]#: TR07.B3, U2.A73
/S_D[2]#: TR07.B4, U2.B71
/S_D[3]#: TR07.B5, U2.A72
/S_D[4]#: TR07.B6, U2.B70
/S_D[5]#: TR07.B7, U2.A71
/S_D[6]#: TR07.B8, U2.B68
/S_D[7]#: TR08.B1, U2.B67
/S_D[8]#: TR08.B2, U2.A69
/S_D[9]#: TR08.B3, U2.A68
/S_D[10]#: TR08.B4, U2.A65
/S_D[11]#: TR08.B5, U2.A64
/S_D[12]#: TR08.B6, U2.B66
/S_D[13]#: TR08.B7, U2.A63
/S_D[14]#: TR08.B8, U2.A67
/S_D[15]#: TR09.B1, U2.B64
/S_D[16]#: TR09.B2, U2.A61
/S_D[17]#: TR09.B3, U2.B63
/S_D[18]#: TR09.B4, U2.B60
/S_D[19]#: TR09.B5, U2.B59
/S_D[20]#: TR09.B6, U2.B62
/S_D[21]#: TR09.B7, U2.A60
/S_D[22]#: TR09.B8, U2.B58
/S_D[23]#: TR10.B1, U2.A59
/S_D[24]#: TR10.B2, U2.A57
/S_D[25]#: TR10.B3, U2.B56
/S_D[26]#: TR10.B4, U2.B55
/S_D[27]#: TR10.B5, U2.A56
/S_D[28]#: TR10.B6, U2.B52
/S_D[29]#: TR10.B7, U2.B54
/S_D[30]#: TR10.B8, U2.A55
/S_D[31]#: TR11.B1, U2.A53
/S_D[32]#: TR11.B2, U2.B51
/S_D[33]#: TR11.B3, U2.A51
/S_D[34]#: TR11.B4, U2.B48
/S_D[35]#: TR11.B5, U2.A52
/S_D[36]#: TR11.B6, U2.B46
/S_D[37]#: TR11.B7, U2.A49
/S_D[38]#: TR11.B8, U2.B50
/S_D[39]#: TR12.B1, U2.A45
/S_D[40]#: TR12.B2, U2.B47
/S_D[41]#: TR12.B3, U2.B42
/S_D[42]#: TR12.B4, U2.A43
/S_D[43]#: TR12.B5, U2.A48
/S_D[44]#: TR12.B6, U2.B44
/S_D[45]#: TR12.B7, U2.A44
/S_D[46]#: TR12.B8, U2.A39
/S_D[47]#: TR13.B1, U2.B43
/S_D[48]#: TR13.B2, U2.B39
/S_D[49]#: TR13.B3, U2.A40
/S_D[50]#: TR13.B4, U2.B35
/S_D[51]#: TR13.B5, U2.A41
/S_D[52]#: TR13.B6, U2.B40
/S_D[53]#: TR13.B7, U2.A36
/S_D[54]#: TR13.B8, U2.B36
/S_D[55]#: TR14.B1, U2.A33
/S_D[56]#: TR14.B2, U2.B34
/S_D[57]#: TR14.B3, U2.A37
/S_D[58]#: TR14.B4, U2.B31
/S_D[59]#: TR14.B5, U2.B38
/S_D[60]#: TR14.B6, U2.A35
/S_D[61]#: TR14.B7, U2.A32
/S_D[62]#: TR14.B8, U2.B30
/S_D[63]#: TR15.B1, U2.B32
/S_FLUSH#: TR01.B2, U2.B2
/S_HIT#: TR18.B4, U2.B110
/S_HITM#: TR18.B5, U2.A109
/S_IGNNE#: TR01.B3, U2.A8
/S_INIT#: TR01.B4, U2.B4
/S_LINT[0]/INTR: TR01.B5, U2.A17
/S_LINT[1]/NMI: TR01.B6, U2.B16
/S_LOCK#: TR18.B6, U2.B106
/S_PWRGOOD: TR01.B7, U2.A12
/S_REQ[0]#: TR18.B7, U2.B102
/S_REQ[1]#: TR18.B8, U2.B103
/S_REQ[2]#: TR19.B1, U2.A107
/S_REQ[3]#: TR19.B2, U2.A108
/S_REQ[4]#: TR19.B3, U2.B104
/S_RESET#: TR20.B2, U2.B74
/S_RP#: TR19.B4, U2.B114
/S_RSP#: TR19.B5, U2.B115
/S_RS[0]#: TR19.B6, U2.B108
/S_RS[1]#: TR19.B7, U2.A112
/S_RS[2]#: TR19.B8, U2.B111
/S_SLP#: TR01.B8, U2.B8
/S_SMI#: TR02.B1, U2.B3
/S_STPCLK#: TR02.B2, U2.B6
/S_THERMTRIP#: TR02.B3, U2.A15
/S_TRDY#: TR20.B1, U2.A104
/TA_AERR#: RL15.2, TR16.A5
/TA_AP[0]#: RL13.2, TR16.A2
/TA_AP[1]#: RL14.2, TR16.A3
/TA_A[32]#: RL01.2, TR06.A6
/TA_A[33]#: RL02.2, TR06.A7
/TA_A[34]#: RL03.2, TR06.A8
/TA_A[35]#: RL04.2, TR07.A1
/TA_BERR#: RL16.2, TR16.A6
/TA_BINIT#: RL17.2, TR16.A7
/TA_DEP[0]#: RL05.2, TR15.A2
/TA_DEP[1]#: RL06.2, TR15.A3
/TA_DEP[2]#: RL07.2, TR15.A4
/TA_DEP[3]#: RL08.2, TR15.A5
/TA_DEP[4]#: RL09.2, TR15.A6
/TA_DEP[5]#: RL10.2, TR15.A7
/TA_DEP[6]#: RL11.2, TR15.A8
/TA_DEP[7]#: RL12.2, TR16.A1
/THERMTRIP#: TR02.A3, U1.AA7
/TRDY#: TR20.A1, U1.H16
/V5: C3.1, C4.1, C8.1, C9.1, C17.1, C19.1, C21.1, C23.1, C25.1, C27.1, C29.1, C31.1, L1.2, PS2.4, PS2.5, PS2.6, PS3.10, PS3.11, PS3.12, PS4.10, PS4.11, PS4.12, PS5.10, PS5.11, PS5.12, PS6.10, PS6.11, PS6.12, R3.1, R5.2, R10.2
/V12: C1.1, C2.1, F1.2, PS1.4, PS1.5, PS1.6
/V12_IN: F1.1, J3.1
/VCCA_FPLL25: C108.1, FB1.2, U1.F4, U1.H19, U1.M3, U1.T3, U1.T5, U1.U18
/VCCCORE: J4.1, U2.B13, U2.B17, U2.B25, U2.B29, U2.B33, U2.B37, U2.B45, U2.B49, U2.B53, U2.B57, U2.B65, U2.B69, U2.B73, U2.B77, U2.B85, U2.B89, U2.B93, U2.B97, U2.B105
/VCCIO33: C22.1, C86.1, C87.1, C88.1, C89.1, C90.1, C91.1, C92.1, C93.1, C94.1, C95.1, C114.1, C116.1, C118.1, C120.1, C122.1, C124.1, C126.1, C128.1, C130.1, C132.1, C134.1, C136.1, C138.1, C140.1, C142.1, C144.1, C146.1, C148.1, L4.2, PS4.14, R13.1, TR01.VCCA, TR02.VCCA, TR03.VCCA, TR04.VCCA, TR05.VCCA, TR06.VCCA, TR07.VCCA, TR08.VCCA, TR09.VCCA, TR10.VCCA, TR11.VCCA, TR12.VCCA, TR13.VCCA, TR14.VCCA, TR15.VCCA, TR16.VCCA, TR17.VCCA, U1.AA16, U1.AA21, U1.K18, U1.M17, U1.M19, U1.N18, U1.P20, U1.P21, U1.R8, U1.R18, U1.T6, U1.T11, U1.U14, U1.U19, U1.W6, U1.W10, U1.W11, U1.W12, U1.W14, U1.W15, U1.W17, U1.W20, U1.Y8, U1.Y13
/VCCPGM18: C26.1, C109.1, L5.2, PS5.14, R15.1, U1.F8, U1.R19, U1.V8
/VCC_1V1: C10.1, C11.1, C12.1, C13.1, C33.1, C34.1, C35.1, C36.1, C37.1, C38.1, C39.1, C40.1, C41.1, C42.1, C43.1, C44.1, C45.1, C46.1, C47.1, C48.1, C49.1, C50.1, C51.1, C52.1, C53.1, C54.1, C55.1, C56.1, C57.1, C58.1, C59.1, C60.1, C61.1, C62.1, C63.1, C64.1, C65.1, C66.1, C67.1, C68.1, C69.1, C70.1, C71.1, C72.1, C73.1, C74.1, C75.1, C76.1, C77.1, C78.1, C79.1, C80.1, C81.1, C82.1, C83.1, C84.1, C85.1, C110.1, C111.1, C112.1, C113.1, L2.2, R8.1, U1.J4, U1.J10, U1.J12, U1.J14, U1.J16, U1.K3, U1.K5, U1.K11, U1.K13, U1.K15, U1.L4, U1.L10, U1.L12, U1.L14, U1.L16, U1.M11, U1.M13, U1.M15, U1.N4, U1.N10, U1.N12, U1.N14, U1.P3, U1.P11, U1.P13, U1.P15
/VCC_AUX25: C18.1, C105.1, C106.1, C107.1, C117.1, C119.1, FB1.1, L3.2, PS3.14, R11.1, TR01.VCCB, TR02.VCCB, U1.A3, U1.C10, U1.D8, U1.D11, U1.D14, U1.D16, U1.D18, U1.E6, U1.E11, U1.W7, U1.W13, U1.W18
/VDDR3: C30.1, C96.1, C97.1, C98.1, C99.1, C100.1, C101.1, C102.1, C103.1, C104.1, C115.1, C150.1, C152.1, C154.1, C156.1, C157.1, C158.1, C159.1, C160.1, C161.1, C162.1, C163.1, C164.1, C165.1, C166.1, C167.1, C168.1, C169.1, C171.1, C172.1, C173.1, C174.1, C175.1, C176.1, C177.1, C178.1, C179.1, C180.1, C181.1, C182.1, C183.1, C184.1, C186.1, C187.1, C188.1, C189.1, C190.1, C191.1, C192.1, C193.1, C194.1, C195.1, C196.1, C197.1, C198.1, C199.1, C201.1, C202.1, C203.1, C204.1, C205.1, C206.1, C207.1, C208.1, C209.1, C210.1, C211.1, C212.1, C213.1, C214.1, L6.2, PS6.14, R17.1, TR18.VCCA, TR19.VCCA, TR20.VCCA, U1.A6, U1.A16, U1.B19, U1.C7, U1.C12, U1.C22, U1.D15, U1.E8, U1.E18, U1.F11, U1.F21, U1.G7, U1.G14, U1.H17, U3.A1, U3.A8, U3.B2, U3.C1, U3.C9, U3.D2, U3.D9, U3.E9, U3.F1, U3.G7, U3.H2, U3.H9, U3.K2, U3.K8, U3.N1, U3.N9, U3.R1, U3.R9, U4.A1, U4.A8, U4.B2, U4.C1, U4.C9, U4.D2, U4.D9, U4.E9, U4.F1, U4.G7, U4.H2, U4.H9, U4.K2, U4.K8, U4.N1, U4.N9, U4.R1, U4.R9, U5.A1, U5.A8, U5.B2, U5.C1, U5.C9, U5.D2, U5.D9, U5.E9, U5.F1, U5.G7, U5.H2, U5.H9, U5.K2, U5.K8, U5.N1, U5.N9, U5.R1, U5.R9, U6.A1, U6.A8, U6.B2, U6.C1, U6.C9, U6.D2, U6.D9, U6.E9, U6.F1, U6.G7, U6.H2, U6.H9, U6.K2, U6.K8, U6.N1, U6.N9, U6.R1, U6.R9, U7.VDDQ_REF, U7.VIN
/VTT15: C121.1, C123.1, C125.1, C127.1, C129.1, C131.1, C133.1, C135.1, C137.1, C139.1, C141.1, C143.1, C145.1, C147.1, C149.1, C151.1, C153.1, C155.1, J4.2, TR03.VCCB, TR04.VCCB, TR05.VCCB, TR06.VCCB, TR07.VCCB, TR08.VCCB, TR09.VCCB, TR10.VCCB, TR11.VCCB, TR12.VCCB, TR13.VCCB, TR14.VCCB, TR15.VCCB, TR16.VCCB, TR17.VCCB, TR18.VCCB, TR19.VCCB, TR20.VCCB, U2.A1, U2.A3, U2.B5, U2.B9
/VTTREF0675: C170.1, C185.1, C200.1, C215.1, U1.AB16, U1.B8, U1.C14, U1.L20, U1.R20, U1.Y7, U1.Y12, U3.H1, U3.M8, U4.H1, U4.M8, U5.H1, U5.M8, U6.H1, U6.M8, U7.VTT, U7.VTTSNS
