alphaonex86/FPGA-CPU/rtl/x86/x86_core.sv

// Out-of-order x86 integer core, M2 (plan/x86_core.md): flat 32-bit code,
// L1I / L1D (x86_l1i, x86_l1d) and L2 (x86_l2) on a 32-byte line memory
// port, 3 x86 instructions decoded and 3 uops renamed, issued and retired
// per cycle.
// - Rename P6-style: results live in the ROB until retire, then in the
//   architectural registers (arch); RAT entries point to a ROB tag or arch.
//   The 6 arithmetic flags rename like a register (C2).
// - One unified reservation station capturing operands. Pipeline S (select,
//   age matrix, oldest ready first per port) -> X (execute) -> wb1 (result
//   register: ROB, capture) -> wb2 (bypass only). Ports: 3 ALU/branch, each
//   ALU uop bound to one at dispatch; 1 load port S -> A (AGU) -> M; 1
//   store port, S -> X (AGU: store queue entry, done; no result bus).
// - An ALU grant wakes its dependents at once (back to back issue); their
//   value then comes from the wb1/wb2 bypass until captured. Loads wake
//   their dependents from wb1.
// - Loads wait for every older store address, forward from an equal-address
//   older store, replay on a partially overlapping one.
// - Retired stores drain into the L1D in order; a load that misses replays.
// - Stores to code (x86_l1i snoop at the store address): the instruction
//   retires, the pipeline flushes, fetch waits for the store's drain (which
//   invalidates the L1I set) and restarts after it. A store whose line an
//   external snoop invalidated in the L1I after its bytes were fetched is not
//   flagged: an L1I snoop hit flushes at the next instruction boundary.
//   A mispredicted branch retires, the pipeline flushes the next cycle.
// - Uncached loads / stores (x86_uc: the VGA window) go through the
//   single-cycle port, exact size, in order; a UC load replays until it is
//   the ROB head with every older store drained.
// - A20M# masks address bit 20 of fetches, loads and stores before the
//   caches (the 486 rule); a change takes effect at a flush: the next
//   non-branch instruction boundary flushes for it (a20_q follows a20m).
// - cache_flush (FLUSH#): the L1D and L1I first (the L1D writes its dirty lines
//   back into the L2), then the L2 (into memory), then the learned UC
//   regions; each cache stays blocked until the last is done (flush_done). Held, or
//   asserted anew during a flush: again. WBINVD / INVD (INVD writes back too, as AMD's
//   HWCR.INVDWBINVD): the same flush once it is the ROB head with every older store
//   drained, then it retires and the pipeline flushes (flush_sw, flush_wb: their special cycles).
// - snoop (EADS#: a bus master wrote snoop_line; enhanced mode: only with
//   INV): queued (SN_N), each line invalidated in the L2 first, then in the
//   L1D / L1I (a line those fill from the L2 meanwhile is caught there). A
//   dirty line is kept (standard mode cannot write it back), snoop_err
//   (sticky), as for a full queue. The store drain waits from hm_look on and
//   while lines are queued (a store into a line the master wrote would dirty
//   its stale copy).
// - HITM# (enhanced mode): hm_dirty tells within the clock of hm_look whether
//   hm_line is dirty in the L1D or the L2; such a line is read (the L1D's copy,
//   else the L2's) and handed to the bus (hw_valid until hw_take; hw_none: the
//   bus writes it already). With INV both caches then drop it at once (tags and
//   write-backs in flight) and the queue invalidates the rest (L1I, clean copies).
module x86_core
    import x86_pkg::*;
#(
    parameter int L1I_KB = 16,
    parameter int L1D_KB = 16,
    parameter int L2_KB = 256
) (
    input  logic                  clk,
    input  logic                  rst,
    input  logic [31:0]           reset_eip,
    input  logic                  a20m,         // A20M# asserted, synchronous
    input  logic                  cache_flush,  // FLUSH# asserted, synchronous
    input  logic                  snoop,        // EADS# on a floated address
    input  logic [31:4]           snoop_line,
    input  logic                  snoop_inv,    // INV (enhanced mode)
    input  logic                  enhanced,     // WB/WT# high at RESET
    output logic                  snoop_err,
    output logic                  flush_done,   // a FLUSH# write-back + invalidation ended (pulse)
    output logic                  flush_sw,     // ... it was WBINVD / INVD, not FLUSH#
    output logic                  flush_wb,     // ... it was WBINVD (Write-Back special cycle, then Flush)
    input  logic                  hm_look,      // EADS# sampled this clock (address floated), a clock before snoop
    input  logic [31:5]           hm_line,
    input  logic                  hm_inv,
    output logic                  hm_dirty,     // enhanced mode, with hm_look: HITM#
    output logic                  hw_valid,     // the snoop write-back: held until hw_take
    output logic                  hw_none,      // ... no data here: the bus writes the line already
    output logic [255:0]          hw_data,
    input  logic                  hw_take,
    // memory (L2 lines): a read answered later, writes posted
    output logic                  mem_req,
    output logic                  mem_we,
    output logic [31:5]           mem_addr,
    output logic [255:0]          mem_wdata,
    input  logic                  mem_ready,
    input  logic                  mem_rvalid,
    input  logic [255:0]          mem_rdata,
    input  logic                  mem_cacheable,  // with mem_rvalid: KEN# made it a line fill
    // single cycles (uncached memory; I/O later): one at a time
    output logic                  sc_req,
    output logic [2:0]            sc_status,    // {M/IO#, D/C#, W/R#}
    output logic [31:2]           sc_addr,
    output logic [3:0]            sc_be,        // active high
    output logic [31:0]           sc_wdata,
    input  logic                  sc_ready,     // takes the request this cycle
    input  logic                  sc_done,      // the cycle ended (read: sc_rdata)
    input  logic [31:0]           sc_rdata,
    // retire trace: up to 3 uops per cycle, in order
    output logic [2:0]            ret_valid,
    output logic [2:0]            ret_eop,
    output logic [2:0][31:0]      ret_next_eip,
    output logic [2:0]            ret_wdst,
    output logic [2:0][3:0]       ret_dst,
    output logic [2:0][31:0]      ret_value,
    output logic [2:0]            ret_wflags,
    output flags_t [2:0]          ret_flags,
    output logic                  halted,
    output logic                  illegal       // halted on an unsupported instruction
);
    localparam int UQ_N = 16;
    localparam int NP = 6;   // issue ports: 0, 1 ALU; 2 load; 3 mul/div; 4 store; 5 ALU
    localparam int NW = 4;   // result buses: 0, 1 ALU; 2 memory or mul/div (mul/div first); 3 ALU
    localparam int NA = 3;   // ALUs: a on port aport(a), bus abus(a)
    function automatic int aport(input int a);
        return a == 2 ? 5 : a;
    endfunction
    function automatic int abus(input int a);
        return a == 2 ? 3 : a;
    endfunction

    // ---------------- frontend + decode ----------------
    logic                 fe_redirect;
    logic [31:0]          fe_redirect_pc;
    logic [2:0]           x_valid, x_fault;
    logic [2:0][8*15-1:0] x_bytes;
    logic [2:0][31:0]     x_eip;
    logic [2:0][3:0]      x_len, x_npfx;
    logic                 dec_take;
    uop_t [2:0][2:0]      d_uop;
    logic [2:0][1:0]      d_n, d_n_b;
    uop_t [2:0][2:0]      d_uop_b;
    logic [2:0]           d_redirect;
    logic [2:0][31:0]     d_target;
    logic [2:0][31:0]     x_next;           // frontend next EIP
    logic                 btb_we, fe_btb_set;
    logic [1:0]           btb_k;
    logic [31:0]          fe_btb_pc, fe_btb_target;
    localparam int RAS_N = 8;
    logic [31:0]          ras [RAS_N];      // return stack, decode-time, may be wrong
    logic [$clog2(RAS_N)-1:0] ras_sp;       // top = ras[ras_sp - 1]
    logic [31:0]          rras [RAS_N], rras_n [RAS_N];   // as of retire
    logic [$clog2(RAS_N)-1:0] rras_sp, rras_sp_n;
    logic [2:0]           d_call, d_ret, d_ind;
    logic [2:0]           p_mis_t, p_mis_nt;   // frontend next != taken target / fall-through
    logic [2:0]           p_valid, p_redirect, p_call, p_ret, p_ind, p_mis;
    uop_t [2:0][2:0]      p_uop, p_uop_ret;
    logic [2:0][1:0]      p_n;
    logic [2:0][31:0]     p_eip, p_seq, p_target, p_next, p_want;
    logic [2:0]           p_take;           // pushed: valid, up to the first p_mis
    logic [3:0]           p_all;            // uops of all valid slots: queue space check
    logic                 p_push, p_load;
    logic                 p_long;           // slot 0 is long: p_uop_b follows its p_uop
    uop_t [2:0]           p_uop_b;
    logic [1:0]           p_n_b;
    logic [2:0]           p_lk;             // slot k is long: from slot 0 only (refetch)
    logic                 p_redir, p_btb;   // the push redirects the frontend; the BTB
    logic [31:0]          p_redir_pc;       // learns slot p_btb_k
    logic [1:0]           p_btb_k;
    // conditional branch direction: x86_tage, read as the group enters P,
    // trained at retire (Jcc uops marked by imm2 bit 14)
    logic [2:0]           p_jcc, p_dir, tg_dir, tg_ret, tg_taken;
    logic                 tg_room;
    logic [31:0]          p_ras [RAS_N];    // return stack after the pushed group
    logic [$clog2(RAS_N)-1:0] p_sp;

    // L2 port: L1I first; one read in flight, its data to its requester
    logic         im_req, im_ready, im_rvalid, dm_req, dm_we, dm_ready, dm_rvalid;
    logic [31:5]  im_addr, dm_addr;
    logic         rd_busy, rd_i;
    logic         l2_req, l2_we, l2_ready, l2_rvalid;
    logic [31:5]  l2_addr;
    logic [255:0] l2_wdata, l2_rdata;
    logic         l2_rcache;
    logic [31:16] mem_rd_region;     // of the memory read in flight (x86_uc learns it)
    logic         fl_l1, fl_l2, fl_pend, fl_q, l1i_fl_done, l1d_fl_done, l2_fl_done;
    logic         cf_start, cf_wb;   // the WBINVD (cf_wb) / INVD at the ROB head starts its flush
    typedef enum logic [1:0] {CF_IDLE, CF_RUN, CF_DONE} cf_t;
    cf_t          cf_st;
    assign flush_done = fl_l2 && l2_fl_done;
    always_ff @(posedge clk)
        if (rst) {fl_l1, fl_l2, fl_pend, fl_q, flush_sw, flush_wb} <= '0;
        else begin
            fl_q <= cache_flush;
            // FLUSH# asserted anew during a flush: one more (held through its end: again, below)
            fl_pend <= (fl_pend || cache_flush && !fl_q) && (fl_l1 || fl_l2);
            if (fl_l2) begin
                if (l2_fl_done) {fl_l1, fl_l2} <= '0;
            end else if (fl_l1) fl_l2 <= l1i_fl_done && l1d_fl_done;
            else begin
                fl_l1 <= cache_flush || fl_pend || cf_start;
                flush_sw <= cf_start;
                flush_wb <= cf_start && cf_wb;
            end
        end

    // external snoops: a queue of lines, L2 then L1D + L1I per line
    localparam int SN_N = 8;
    logic [SN_N-1:0][31:5]   sn_q;
    logic [$clog2(SN_N):0]   sn_head, sn_tail;
    logic                    sn_l1, l1d_x_done, l1i_x_done, l2_x_done, l1d_x_dirty, l2_x_dirty;
    logic [1:0]              sn_l1_done;     // L1D, L1I finished this line
    logic                    sn_any, sn_push, sn_err_now;
    assign sn_any = sn_head != sn_tail;

    // HITM#: the snooped dirty line, read from the L1D, else the L2
    typedef enum logic [1:0] {H_IDLE, H_L1D, H_L2, H_OUT} hs_t;
    hs_t          hs;
    logic [31:5]  hw_line, c_hm_line, sq_line;
    logic         hw_inv, hw_kill, l1d_hm, l2_hm, l1d_sr_done, l1d_sr_hit, l2_sr_done, l2_sr_hit;
    logic [255:0] l1d_sr_data, l2_sr_data;
    assign c_hm_line = hs == H_IDLE ? hm_line : hw_line;
    assign hm_dirty = enhanced && (l1d_hm || l2_hm);
    assign hw_valid = hs == H_OUT;
    assign hw_kill = hs == H_OUT && hw_take && hw_inv;
    always_ff @(posedge clk)
        if (rst) hs <= H_IDLE;
        else unique case (hs)
            H_IDLE: if (hm_look && hm_dirty) begin
                hw_line <= hm_line;
                hw_inv <= hm_inv;
                hs <= H_L1D;
            end
            H_L1D: if (l1d_sr_done) begin
                hw_data <= l1d_sr_data;
                hw_none <= 1'b0;
                hs <= l1d_sr_hit ? H_OUT : H_L2;
            end
            H_L2: if (l2_sr_done) begin
                hw_data <= l2_sr_data;
                hw_none <= !l2_sr_hit;
                hs <= H_OUT;
            end
            default: if (hw_take) hs <= H_IDLE;
        endcase

    // a repeat of the last line queued (its other 16 bytes) while that one waits is the same line;
    // once its L2 step started, a fill of it may follow: queued again. A line HITM# answered is queued
    // once written back (its snoop pulse is not)
    assign sq_line = hw_kill ? hw_line : snoop_line[31:5];
    assign sn_push = (hw_kill || snoop && (snoop_inv || !enhanced) && hs == H_IDLE)
                     && !(sn_tail - sn_head >= 2 && sn_q[sn_tail[$clog2(SN_N)-1:0] - 1'd1] == sq_line);
    assign sn_err_now = sn_push && sn_tail - sn_head == ($clog2(SN_N)+1)'(SN_N)
                        || l2_x_done && l2_x_dirty || l1d_x_done && l1d_x_dirty;
    always_ff @(posedge clk)
        if (rst) begin
            {sn_head, sn_tail} <= '0;
            sn_l1 <= 1'b0;
            sn_l1_done <= '0;
            snoop_err <= 1'b0;
        end else begin
            if (sn_push && sn_tail - sn_head != ($clog2(SN_N)+1)'(SN_N)) begin
                sn_q[sn_tail[$clog2(SN_N)-1:0]] <= sq_line;
                sn_tail <= sn_tail + 1'd1;
            end
            if (sn_err_now) snoop_err <= 1'b1;
            if (!sn_l1) sn_l1 <= l2_x_done;
            else if ((sn_l1_done | {l1i_x_done, l1d_x_done}) == 2'b11) begin
                sn_l1 <= 1'b0;
                sn_l1_done <= '0;
                sn_head <= sn_head + 1'd1;
            end else sn_l1_done <= sn_l1_done | {l1i_x_done, l1d_x_done};
`ifndef SYNTHESIS
            if (sn_err_now && !snoop_err) $display("snoop_err: a snoop hit a dirty line or the queue was full");
`endif
        end
    always_ff @(posedge clk) if (mem_req && mem_ready && !mem_we) mem_rd_region <= mem_addr[31:16];
    assign l2_req = (im_req || dm_req) && !rd_busy;
    assign l2_we = !im_req && dm_we;
    assign l2_addr = im_req ? im_addr : dm_addr;
    assign im_ready = im_req && !rd_busy && l2_ready;
    assign dm_ready = !im_req && !rd_busy && l2_ready;
    assign im_rvalid = l2_rvalid && rd_i;
    assign dm_rvalid = l2_rvalid && !rd_i;
    always_ff @(posedge clk) begin
        if (rst) rd_busy <= 1'b0;
        else if (l2_rvalid) rd_busy <= 1'b0;
        else if (l2_req && l2_ready && !l2_we) begin
            rd_busy <= 1'b1;
            rd_i <= im_req;
        end
`ifndef SYNTHESIS
        if (!rst && l2_rvalid && !rd_busy) $error("L2 read data with no read in flight");
`endif
    end
    x86_l2 #(.KB(L2_KB)) u_l2 (.clk(clk), .rst(rst), .req(l2_req), .we(l2_we), .addr(l2_addr), .wdata(l2_wdata),
                 .ready(l2_ready), .rvalid(l2_rvalid), .rdata(l2_rdata), .rcacheable(l2_rcache),
                 .mem_req(mem_req), .mem_we(mem_we), .mem_addr(mem_addr), .mem_wdata(mem_wdata),
                 .mem_ready(mem_ready), .mem_rvalid(mem_rvalid), .mem_rdata(mem_rdata), .mem_cacheable(mem_cacheable),
                 .fl_req(fl_l2), .fl_done(l2_fl_done),
                 .ext_req(sn_any && !sn_l1), .ext_line(sn_q[sn_head[$clog2(SN_N)-1:0]]), .ext_done(l2_x_done),
                 .ext_dirty(l2_x_dirty),
                 .hm_line(c_hm_line), .hm_dirty(l2_hm), .sr_req(hs == H_L2), .sr_done(l2_sr_done), .sr_hit(l2_sr_hit),
                 .sr_data(l2_sr_data), .sr_kill(hw_kill));

    // L1I; stores to code (snoop, invalidation, fetch hold), its misses
    // after the older stores to the line (sq_busy) and the L1D probe
    logic [31:4]       fetch_next, fetch_pc;
    logic              ic_hit, ic_sn_hit, ic_sq_busy, pr_req, pr_done, d_step;
    logic              code_pend, code_pend_q;   // a store to code waits for its drain
    logic              ic_inv;                   // the drained store targets code
    logic [8*30-1:0]   ic_bytes;
    logic [1:0][31:5]  sn_line;
    logic [31:5]       ic_miss_line, d_line;
    logic a20_q;                     // the A20 mask in effect
    logic code_snooped;              // an external snoop hit the L1I since the last flush
    logic l1i_x_hit;
    x86_l1i #(.KB(L1I_KB)) u_l1i (.clk(clk), .rst(rst), .pc_n({fetch_next[31:21], fetch_next[20] & !a20_q, fetch_next[19:4]}),
                   .pc_f({fetch_pc[31:21], fetch_pc[20] & !a20_q, fetch_pc[19:4]}),
                   .hold(code_pend || code_pend_q), .hit(ic_hit), .bytes(ic_bytes),
                   .sn_line(sn_line), .sn_hit(ic_sn_hit),
                   .inv(ic_inv), .inv_line(d_line),
                   .miss_line(ic_miss_line), .sq_busy(ic_sq_busy), .pr_req(pr_req), .pr_done(pr_done),
                   .mem_req(im_req), .mem_addr(im_addr), .mem_ready(im_ready),
                   .mem_rvalid(im_rvalid), .mem_rdata(l2_rdata), .mem_rcacheable(l2_rcache),
                   .fl_req(fl_l1), .fl_done(l1i_fl_done),
                   .ext_req(sn_l1 && !sn_l1_done[1]), .ext_line(sn_q[sn_head[$clog2(SN_N)-1:0]]), .ext_done(l1i_x_done), .ext_hit(l1i_x_hit));

    x86_frontend fe (.clk(clk), .rst(rst), .redirect(fe_redirect), .redirect_pc(fe_redirect_pc),
                     .take(dec_take), .fetch_next(fetch_next), .fetch_pc(fetch_pc),
                     .ic_hit(ic_hit), .ic_bytes(ic_bytes),
                     .valid(x_valid), .bytes(x_bytes), .eip(x_eip), .len(x_len), .npfx(x_npfx), .fault(x_fault),
                     .next(x_next), .btb_we(btb_we), .btb_set(fe_btb_set),
                     .btb_pc(fe_btb_pc), .btb_target(fe_btb_target));

    genvar gi;
    generate for (gi = 0; gi < 3; gi = gi + 1) begin : dec
        x86_decode d (.bytes(x_bytes[gi]), .eip(x_eip[gi]), .len(x_len[gi]), .npfx(x_npfx[gi]), .df(df),
                      .fault(x_fault[gi]),
                      .call(d_call[gi]), .ret(d_ret[gi]), .ind(d_ind[gi]),
                      .uop(d_uop[gi]), .n(d_n[gi]), .uop_b(d_uop_b[gi]), .n_b(d_n_b[gi]),
                      .redirect(d_redirect[gi]), .target(d_target[gi]));
    end endgenerate

    // P: the decoded group, registered. P fills in RET targets from the return
    // stack, finds the first instruction the frontend did not follow as decode
    // predicts (redirect after it, the BTB learns it) and pushes the group up
    // to there into the uop queue. A long slot 0 pushes p_uop first, alone,
    // then p_uop_b with the rest of the group; a long slot 1 / 2 ends the group
    // and is fetched again as slot 0.
    always_comb begin
        logic stop;
        p_ras = ras;
        p_sp = ras_sp;
        p_uop_ret = p_uop;
        p_all = 4'd0;
        p_redir = 1'b0;
        p_redir_pc = 32'd0;
        p_btb = 1'b0;
        p_btb_k = 2'd0;
        stop = 1'b0;
        for (int k = 0; k < 3; k++) begin
            // RET: the top before the group (a call / ret ends the group unless
            // mispredicted; later slots are then wrong path): parallel compares
            // CALL/JMP r/m: whatever the frontend's BTB said (retire teaches it)
            p_dir[k] = p_jcc[k] ? tg_dir[k] : p_ind[k] ? p_next[k] != p_seq[k] : p_redirect[k];
            p_want[k] = p_ret[k] ? ras[ras_sp - 1'b1] : p_ind[k] ? p_next[k]
                      : !p_dir[k] ? p_seq[k] : p_jcc[k] ? p_uop[k][0].imm : p_target[k];
            p_uop_ret[k][2].imm = p_ret[k] ? p_want[k] : p_uop[k][2].imm;
            for (int j = 0; j < 3; j++)
                if (p_uop[k][j].btbi) begin
                    p_uop_ret[k][j].imm = p_next[k];
                    p_uop_ret[k][j].pred_taken = p_dir[k];
                end
            if (p_jcc[k]) begin
                p_uop_ret[k][0].pred_taken = p_dir[k];
                p_uop_ret[k][0].imm2 = 32'h4000;   // bit 14: P-predicted
            end
            // mismatches precomputed at the load: dir only selects (timing)
            p_mis[k] = p_ret[k] ? ras[ras_sp - 1'b1] != p_next[k] : !p_ind[k] && (p_dir[k] ? p_mis_t[k] : p_mis_nt[k]);
            p_take[k] = p_valid[k] && !stop && !(k != 0 && p_lk[k]);
            if (p_valid[k] && !stop && k != 0 && p_lk[k]) begin
                p_redir = 1'b1;
                p_redir_pc = p_eip[k];
                stop = 1'b1;
            end
            if (p_valid[k]) p_all = p_all + 4'(p_n[k]);   // not up to p_mis: off its path
            if (p_take[k]) begin
                if (p_mis[k] && !p_long) begin
                    p_redir = 1'b1;
                    p_redir_pc = p_want[k];
                    p_btb = 1'b1;
                    p_btb_k = 2'(k);
                end
                stop = p_mis[k] || p_long;
                if (p_call[k]) begin
                    p_ras[p_sp] = p_seq[k];
                    p_sp = p_sp + 1'b1;
                end
                if (p_ret[k]) p_sp = p_sp - 1'b1;
            end
        end
    end

    // uop queue between decode and rename
    uop_t       uq [UQ_N];
    logic [3:0] uq_head, uq_tail;
    logic [4:0] uq_count;

    // ---------------- backend state ----------------
    typedef struct packed {
        logic        done;
        kind_t       kind;
        logic [3:0]  dst;
        logic        wdst, wflags, eop;
        logic [31:0] value;
        flags_t      flags;
        logic [31:0] next_eip;
        logic        mispred;
        logic        smc;            // a store to code: the pipeline flushes after its instruction
        logic        fault;          // divide error: halts at retire (no exceptions yet)
        logic [31:0] redirect_pc;
        logic        btbi;               // CALL/JMP r/m: value = its EIP
        logic        rcall, rret;
        logic        bp_jcc, bp_taken;   // branch predicted by P (x86_tage), predicted taken
    } rob_t;

    // ready: may issue; captured: value holds it (else it is on wb1/wb2)
    typedef struct packed {
        logic             ready, captured;
        logic [TAG_W-1:0] tag;
        logic [31:0]      value;
    } src_t;

    typedef struct packed {
        logic             ready, captured;
        logic [TAG_W-1:0] tag;
        flags_t           value;
    } fsrc_t;

    typedef struct packed {
        logic             valid;
        logic             issued;    // memory uops stay until M completes
        logic [1:0]       port;      // ALU uops: ALU (0 .. NA - 1)
        uop_t             u;
        logic [TAG_W-1:0] tag;
        src_t [2:0]       src;       // s1, s2, s3
        fsrc_t            fsrc;
        logic [SQ_W:0]    sq_snap;   // loads: store queue tail at dispatch
        logic [SQ_N-1:0]  sq_older;  // loads: entries of the older stores still queued
        logic [SQ_W-1:0]  sq_idx;    // stores: own store queue entry
    } rs_t;

    typedef struct packed {
        logic        addr_valid, data_valid;
        logic        code;           // to a line in the L1I or being filled
        logic        two_lines;      // its last byte is in the next line
        logic [1:0]  size;
        logic [31:0] addr, data;
    } sq_t;

    rob_t             rob [ROB_N];
    logic [TAG_W-1:0] rob_head, rob_tail;
    logic [TAG_W:0]   rob_count;
    rs_t              rs [RS_N];
    logic [RS_N-1:0]  older [RS_N];   // older[e][f]: entry f is older than e
    logic [1:0]       alu_port;       // ALU of the next dispatched ALU uop
    sq_t              sq [SQ_N];
    logic [SQ_W:0]    sq_head, sq_cmt, sq_tail;   // with wrap bit; [head, cmt) retired
    logic             drain;                      // the head entry (retired) is in the L1D: leaves
    assign ic_inv = d_step && sq[sq_head[SQ_W-1:0]].code;
    logic [31:0]      arch [NREG];
    flags_t           arch_flags;
    logic             rat_rob [NREG];
    logic [TAG_W-1:0] rat_tag [NREG];
    logic             frat_rob;
    logic [TAG_W-1:0] frat_tag;

    // ---------------- result registers ----------------
    // one per port. wb1 writes the ROB and the RS (capture); wb2 is wb1 one
    // cycle later, for the X/A bypass only.
    logic [NW-1:0]             wb_valid;
    logic [NW-1:0][TAG_W-1:0]  wb_tag;
    logic [NW-1:0][31:0]       wb_value;
    flags_t [NW-1:0]           wb_flags;
    logic [NW-1:0]             wb_mispred, wb_fault;
    logic [NW-1:0][31:0]       wb_redirect_pc;   // branches: the actual next EIP
    logic [NW-1:0]             wb_br;
    logic [NW-1:0]             ew_valid;   // early wakeup (ready, value on a bypass later):
    logic [NW-1:0][TAG_W-1:0]  ew_tag;     // ALU grants, result bus 2 in its X / M cycle
    logic [NW-1:0]             wb2_valid;
    logic [NW-1:0][TAG_W-1:0]  wb2_tag;
    logic [NW-1:0][31:0]       wb2_value;
    flags_t [NW-1:0]           wb2_flags;

    // ---------------- decode -> P -> uop queue ----------------
    assign p_push = p_valid != 3'd0 && !flush && 5'(UQ_N) - uq_count >= 5'(p_all) && tg_room;
    assign dec_take = x_valid != 3'd0 && (p_valid == 3'd0 || p_push && !p_long);
    assign p_load = dec_take && !fe_redirect;   // a redirect drops the decoded group
    // the data registers load on dec_take: only p_valid waits for the redirect
    always_ff @(posedge clk) begin
        if (rst || flush) p_valid <= '0;
        else if (dec_take) p_valid <= fe_redirect ? 3'd0 : x_valid;
        else if (p_push && !p_long) p_valid <= '0;
        if (dec_take) begin
            p_uop <= d_uop;
            p_n <= d_n;
            p_redirect <= d_redirect;
            p_call <= d_call;
            p_ret <= d_ret;
            p_ind <= d_ind;
            p_eip <= x_eip;
            p_target <= d_target;
            p_next <= x_next;
            for (int k = 0; k < 3; k++) begin
                p_seq[k] <= x_eip[k] + 32'(x_len[k]);
                p_mis_nt[k] <= x_eip[k] + 32'(x_len[k]) != x_next[k];
                p_mis_t[k] <= (d_uop[k][0].kind == K_BR && !d_uop[k][0].uncond && !d_uop[k][0].ecxz
                               ? d_uop[k][0].imm : d_target[k]) != x_next[k];
                p_lk[k] <= d_n_b[k] != 2'd0;
                p_jcc[k] <= d_uop[k][0].kind == K_BR && !d_uop[k][0].uncond && !d_uop[k][0].ecxz;
            end
            p_long <= d_n_b[0] != 2'd0;
            p_uop_b <= d_uop_b[0];
            p_n_b <= d_n_b[0];
        end else if (p_push && p_long) begin
            p_uop[0] <= p_uop_b;
            p_n[0] <= p_n_b;
            p_long <= 1'b0;
        end
        if (rst) ras_sp <= '0;
        else if (flush) begin
            ras <= rras;
            ras_sp <= rras_sp;
        end
        else if (p_push) begin
            ras <= p_ras;
            ras_sp <= p_sp;
        end
    end

    x86_tage tage (.clk(clk), .rst(rst), .look(dec_take), .look_pc(x_eip), .p_busy(p_valid != 3'd0),
                   .btfn(p_redirect), .dir(tg_dir), .p_push(p_push), .jcc(p_jcc), .push(p_take & p_jcc),
                   .room(tg_room), .flush(flush), .ret(tg_ret), .ret_taken(tg_taken));


    // ---------------- retire ----------------
    logic [1:0]  r_n;            // uops retired this cycle
    logic        r_flush, r_halt, r_ill, r_store;
    logic        df, r_dfw;      // direction flag (decode reads it), set by a retiring K_DF
    logic [31:0] r_flush_pc;
    logic        flush;           // r_flush one cycle later: clears the pipeline
    logic [31:0] flush_pc;
    logic        r_btb, flush_btb;   // the flushing CALL/JMP r/m teaches the BTB its target
    logic [31:0] flush_bpc;
    logic        smc_q, r_smc;    // a store to code retired, its instruction not yet
    always_comb begin
        logic stop, smc;
        smc = smc_q;
        r_n = 2'd0;
        r_flush = 1'b0;
        r_halt = 1'b0;
        r_ill = 1'b0;
        r_dfw = 1'b0;
        r_btb = 1'b0;
        r_store = 1'b0;
        r_flush_pc = 32'd0;
        stop = halted || flush;
        for (int k = 0; k < 3; k++) begin
            rob_t e;
            e = rob[TAG_W'(rob_head + TAG_W'(k))];
            ret_valid[k] = 1'b0;
            if (!stop && (TAG_W + 1)'(k) < rob_count && e.done && !(e.kind == K_ST && r_store)
                && !(e.kind == K_WBINVD && cf_st != CF_DONE)) begin
                ret_valid[k] = 1'b1;
                r_n = 2'(k + 1);
                if (e.kind == K_ST) r_store = 1'b1;
                if (e.kind == K_HLT) begin r_halt = 1'b1; stop = 1'b1; end
                if (e.kind == K_ILL || e.fault) begin r_halt = 1'b1; r_ill = 1'b1; stop = 1'b1; end
                if (e.kind == K_ST && e.smc) smc = 1'b1;
                if (e.kind == K_BR && e.mispred || e.kind == K_DF || e.kind == K_WBINVD || smc && e.eop
                    || (a20m != a20_q || code_snooped) && e.eop && e.kind != K_BR) begin
                    r_flush = 1'b1;
                    r_flush_pc = e.kind == K_BR && e.mispred ? e.redirect_pc : e.next_eip;
                    r_btb = e.btbi;
                    r_dfw = e.kind == K_DF;
                    stop = 1'b1;
                end
            end else stop = 1'b1;
            ret_eop[k] = e.eop || e.kind == K_BR && e.mispred;   // REP exit: ends at uop 0
            ret_next_eip[k] = e.next_eip;
            ret_wdst[k] = e.wdst;
            ret_dst[k] = e.dst;
            ret_value[k] = e.value;
            ret_wflags[k] = e.wflags;
            ret_flags[k] = e.flags;
        end
        r_smc = smc && !r_flush;
    end
    assign cf_start = rob_count != '0 && rob[rob_head].kind == K_WBINVD && rob[rob_head].done && cf_st == CF_IDLE
                      && sq_head == sq_cmt && !halted && !flush && !cache_flush && !fl_pend && !fl_l1 && !fl_l2;
    assign cf_wb = !rob[rob_head].dst[0];
    always_ff @(posedge clk)
        if (rst || flush) cf_st <= CF_IDLE;
        else if (cf_start) cf_st <= CF_RUN;
        else if (flush_done && flush_sw) cf_st <= CF_DONE;
    // retired stores drain into the L1D one per cycle at most, in order;
    // until then loads still see them in the queue (forwarding / overlap replay)

    // return stack as of retire: a flush restores it
    always_comb begin
        rras_n = rras;
        rras_sp_n = rras_sp;
        for (int k = 0; k < 3; k++) begin
            rob_t e;
            e = rob[TAG_W'(rob_head + TAG_W'(k))];
            if (ret_valid[k] && e.rcall) begin
                rras_n[rras_sp_n] = e.next_eip;
                rras_sp_n = rras_sp_n + 1'b1;
            end
            if (ret_valid[k] && e.rret) rras_sp_n = rras_sp_n - 1'b1;
        end
    end
    always_ff @(posedge clk) begin
        rras <= rras_n;
        rras_sp <= rst ? '0 : rras_sp_n;
    end

    // branch training: retired P-predicted Jcc, in order
    always_comb
        for (int k = 0; k < 3; k++) begin
            rob_t e;
            e = rob[TAG_W'(rob_head + TAG_W'(k))];
            tg_ret[k] = ret_valid[k] && e.bp_jcc;
            tg_taken[k] = e.bp_taken ^ e.mispred;
        end

    // frontend redirect: retire flush first, else the first instruction of
    // the decoded group the frontend did not follow as decode predicts (the
    // BTB learns it)
    always_comb begin
        fe_redirect = flush;
        fe_redirect_pc = flush_pc;
        btb_we = flush && flush_btb;
        btb_k = 2'd0;
        fe_btb_set = 1'b1;
        fe_btb_pc = flush_bpc;
        fe_btb_target = flush_pc;
        if (rst) fe_redirect_pc = reset_eip;
        else if (p_push && p_redir) begin
            fe_redirect = 1'b1;
            fe_redirect_pc = p_redir_pc;
            btb_we = p_btb;
            btb_k = p_btb_k;
            fe_btb_set = p_dir[p_btb_k];
            fe_btb_pc = p_eip[p_btb_k];
            fe_btb_target = p_want[p_btb_k];
        end
    end

    // ---------------- R: rename ----------------
    // R reads the uop queue and the RAT and allocates the ROB entry, the
    // store queue entry and the RS budget; D (next cycle) reads the operand
    // values and writes the RS. A producer renamed in the same group needs
    // no special case in D: its ROB entry is allocated, not done.
    typedef struct packed {
        uop_t                  u;
        logic [TAG_W-1:0]      tag;
        logic [1:0]            port;
        logic [SQ_W:0]         sq_snap;
        logic [3:0]            in_rob;   // s1, s2, s3, flags
        logic [3:0][TAG_W-1:0] stag;
    } rn_t;

    logic [1:0] rn_n;     // uops renamed this cycle
    rn_t [2:0]  rn;
    logic       d_ok;     // D writes its group: enough free RS entries, else D and R stall

    function automatic logic is_alu(input kind_t k);
        return k == K_ALU || k == K_BR;
    endfunction

    function automatic logic needs_rs(input kind_t k);
        return !(k == K_HLT || k == K_ILL || k == K_DF || k == K_WBINVD);
    endfunction

    always_comb begin
        logic [TAG_W:0] rob_free;
        logic [SQ_W:0]  sqt;
        logic           stop;
        logic [1:0]     nxt;
        logic [3:0]     sr;
        uop_t           u;
        rob_free = (TAG_W + 1)'(ROB_N) - rob_count;
        sqt = sq_tail;
        rn_n = 2'd0;
        nxt = alu_port;
        stop = halted || !d_ok;
        for (int k = 0; k < 3; k++) begin
            u = uq[4'(uq_head + 4'(k))];
            rn[k] = '0;
            rn[k].u = u;
            rn[k].tag = TAG_W'(rob_tail + TAG_W'(k));
            rn[k].port = nxt;
            if (is_alu(u.kind)) nxt = nxt == 2'd2 ? 2'd0 : nxt + 2'd1;
            rn[k].sq_snap = sqt;
            for (int i = 0; i < 3; i++) begin
                sr = i == 0 ? u.s1 : i == 1 ? u.s2 : u.s3;
                rn[k].in_rob[i] = rat_rob[sr];
                rn[k].stag[i] = rat_tag[sr];
                for (int j = 0; j < k; j++)
                    if (rn[j].u.wdst && rn[j].u.dst == sr) begin
                        rn[k].in_rob[i] = 1'b1;
                        rn[k].stag[i] = rn[j].tag;
                    end
            end
            rn[k].in_rob[3] = frat_rob;
            rn[k].stag[3] = frat_tag;
            for (int j = 0; j < k; j++)
                if (rn[j].u.wflags) begin
                    rn[k].in_rob[3] = 1'b1;
                    rn[k].stag[3] = rn[j].tag;
                end
            if (!stop && 5'(k) < uq_count && (TAG_W + 1)'(k) < rob_free
                && !(u.kind == K_ST && sqt - sq_head >= (SQ_W + 1)'(SQ_N)))
                rn_n = 2'(k + 1);
            else stop = 1'b1;
            if (u.kind == K_ST) sqt = sqt + 1'b1;
        end
    end

    // ---------------- D: operand read, RS write ----------------
    logic [2:0]           dq_valid;
    rn_t [2:0]            dq;
    rs_t  [2:0]           ds_rs;
    logic [2:0][RS_N-1:0] ds_slot;   // one-hot RS entry per uop
    logic [2:0]           ds_to_rs;

    function automatic src_t read_src(input logic [3:0] r, input logic in_rob,
                                      input logic [TAG_W-1:0] t);
        src_t x;
        x.tag = t;
        x.ready = !in_rob || rob[t].done;
        x.captured = 1'b0;
        x.value = !in_rob ? arch[r] : rob[t].value;
        for (int p = 0; p < NW; p++)
            if (in_rob && wb_valid[p] && wb_tag[p] == t) begin
                x.ready = 1'b1;
                x.value = wb_value[p];
            end
        return x;
    endfunction

    always_comb begin
        logic [RS_N-1:0]      free;
        logic [2:0][RS_N-1:0] fs;   // the first 3 free RS entries, one-hot
        logic [1:0]           nrs, need;
        logic [4:0]           nfree;
        logic [3:0]           sr [3];
        logic                 su [3];
        uop_t                 u;
        logic [TAG_W-1:0]     t;
        nfree = '0;
        for (int e = 0; e < RS_N; e++) begin
            free[e] = !rs[e].valid;
            nfree = nfree + 5'(free[e]);
        end
        need = 2'd0;
        for (int k = 0; k < 3; k++) need = need + 2'(dq_valid[k] && needs_rs(dq[k].u.kind));
        d_ok = nfree >= 5'(need);
        for (int i = 0; i < 3; i++) begin
            fs[i] = free & -free;   // lowest set bit
            free = free & ~fs[i];
        end
        nrs = 2'd0;
        for (int k = 0; k < 3; k++) begin
            u = dq[k].u;
            ds_rs[k] = '0;
            ds_rs[k].valid = 1'b1;
            ds_rs[k].port = dq[k].port;
            ds_rs[k].u = u;
            ds_rs[k].tag = dq[k].tag;
            ds_rs[k].sq_snap = dq[k].sq_snap;
            for (int q = 0; q < SQ_N; q++)
                ds_rs[k].sq_older[q] = (SQ_W + 1)'(SQ_W'(SQ_W'(q) - sq_head[SQ_W-1:0])) < dq[k].sq_snap - sq_head
                                       && !(drain && SQ_W'(q) == sq_head[SQ_W-1:0]);
            ds_rs[k].sq_idx = dq[k].sq_snap[SQ_W-1:0];
            sr[0] = u.s1; su[0] = u.us1;
            sr[1] = u.s2; su[1] = u.us2;
            sr[2] = u.s3; su[2] = u.us3;
            for (int i = 0; i < 3; i++) begin
                ds_rs[k].src[i] = read_src(sr[i], dq[k].in_rob[i], dq[k].stag[i]);
                if (!su[i]) ds_rs[k].src[i].ready = 1'b1;
                ds_rs[k].src[i].captured = ds_rs[k].src[i].ready;
                for (int p = 0; p < NW; p++)
                    if (dq[k].in_rob[i] && ew_valid[p] && ew_tag[p] == dq[k].stag[i])
                        ds_rs[k].src[i].ready = 1'b1;
            end
            t = dq[k].stag[3];
            ds_rs[k].fsrc.tag = t;
            ds_rs[k].fsrc.ready = !dq[k].in_rob[3] || rob[t].done || !u.rflags;
            ds_rs[k].fsrc.value = !dq[k].in_rob[3] ? arch_flags : rob[t].flags;
            for (int p = 0; p < NW; p++)
                if (dq[k].in_rob[3] && wb_valid[p] && wb_tag[p] == t) begin
                    ds_rs[k].fsrc.ready = 1'b1;
                    ds_rs[k].fsrc.value = wb_flags[p];
                end
            ds_rs[k].fsrc.captured = ds_rs[k].fsrc.ready;
            for (int p = 0; p < NW; p++)
                if (dq[k].in_rob[3] && ew_valid[p] && ew_tag[p] == t) ds_rs[k].fsrc.ready = 1'b1;
            ds_to_rs[k] = d_ok && dq_valid[k] && needs_rs(u.kind);
            ds_slot[k] = fs[nrs];
            nrs = nrs + 2'(ds_to_rs[k]);
        end
    end

    // ---------------- S: select ----------------
    localparam int RS_W = $clog2(RS_N);
    logic [NP-1:0][RS_N-1:0] req, grant;
    logic                    md_busy;
    logic [NP-1:0] ix_valid;   // issue registers
    rs_t [NP-1:0]  ix, ixn;
    // X: uncaptured source i (3 = flags) of port p is on wb1 / wb2 bus q
    // (the tags compared in S, off the X operand path)
    logic [NP-1:0][3:0][NW-1:0] ix_on1, ix_on2, on1_n, on2_n;
    logic [RS_N-1:0]         md_wait;   // K_MD uops not issued yet
    logic [NA-1:0][TAG_W-1:0] gtag;        // ALU grants: wake dependents now

    function automatic rs_t pick(input logic [RS_N-1:0] g);
        logic [$bits(rs_t)-1:0] v = '0;
        for (int e = 0; e < RS_N; e++) v = v | ({$bits(rs_t){g[e]}} & rs[e]);
        return rs_t'(v);
    endfunction

    function automatic logic [RS_W-1:0] slot_of(input logic [RS_N-1:0] g);
        logic [RS_W-1:0] v = '0;
        for (int e = 0; e < RS_N; e++) v = v | ({RS_W{g[e]}} & RS_W'(e));
        return v;
    endfunction

    always_comb begin
        logic [SQ_N-1:0] sq_unknown;
        for (int q = 0; q < SQ_N; q++) sq_unknown[q] = !sq[q].addr_valid;
        for (int e = 0; e < RS_N; e++)
            md_wait[e] = rs[e].valid && !rs[e].issued && rs[e].u.kind == K_MD;
        for (int e = 0; e < RS_N; e++) begin
            logic srcs;
            srcs = rs[e].valid && !rs[e].issued && rs[e].src[0].ready && rs[e].src[1].ready
                   && rs[e].src[2].ready && rs[e].fsrc.ready;
            for (int a = 0; a < NA; a++) req[aport(a)][e] = srcs && is_alu(rs[e].u.kind) && rs[e].port == 2'(a);
            req[2][e] = srcs && rs[e].u.kind == K_LD && (rs[e].sq_older & sq_unknown) == '0;
            // stores: the address as soon as it is ready (younger loads
            // wait for it), the data then or later (issued: address done)
            req[4][e] = rs[e].valid && rs[e].u.kind == K_ST && rs[e].src[0].ready && rs[e].src[1].ready
                        && (!rs[e].issued || rs[e].src[2].ready);
            // in order (MULH/DIVR read the unit's last result); nothing while
            // a division runs or is in X (it starts there)
            req[3][e] = srcs && md_wait[e] && (md_wait & older[e]) == '0 && !md_busy
                        && !(ix_valid[3] && (ix[3].u.aop == A_DIV || ix[3].u.aop == A_IDIV));
        end
        for (int p = 0; p < NP; p++)
            for (int e = 0; e < RS_N; e++)
                grant[p][e] = req[p][e] && (req[p] & older[e]) == '0 && !halted;
        for (int p = 0; p < NP; p++) ixn[p] = pick(grant[p]);
        for (int a = 0; a < NA; a++) gtag[a] = ixn[aport(a)].tag;
    end

    // ---------------- X / A: execute, address ----------------
    logic [RS_W-1:0] ix_slot;   // load port: RS entry

    // operand: captured, else the producer result on wb1 / wb2
    function automatic logic [31:0] opnd(input logic [31:0] v, input logic [NW-1:0] on1, on2);
        for (int q = 0; q < NW; q++) begin
            if (on2[q]) v = wb2_value[q];
            if (on1[q]) v = wb_value[q];
        end
        return v;
    endfunction

    function automatic flags_t fopnd(input flags_t v, input logic [NW-1:0] on1, on2);
        for (int q = 0; q < NW; q++) begin
            if (on2[q]) v = wb2_flags[q];
            if (on1[q]) v = wb_flags[q];
        end
        return v;
    endfunction

    function automatic rs_t resolve(input rs_t r, input logic [3:0][NW-1:0] on1, on2);
        rs_t x = r;
        for (int i = 0; i < 3; i++) x.src[i].value = opnd(r.src[i].value, on1[i], on2[i]);
        x.fsrc.value = fopnd(r.fsrc.value, on1[3], on2[3]);
        return x;
    endfunction

    function automatic logic [31:0] agu(input rs_t r);
        return (r.u.us1 ? r.src[0].value : 32'd0)
             + (r.u.us2 ? r.src[1].value << r.u.scale : 32'd0) + r.u.imm;
    endfunction
    // the memory address of a load / store: A20 masked
    function automatic logic [31:0] maddr(input rs_t r);
        logic [31:0] a;
        a = agu(r);
        return {a[31:21], a[20] & !a20_q, a[19:0]};
    endfunction

    rs_t [NP-1:0]     xr;    // issue registers with resolved operands
    logic [NA-1:0][31:0] alu_y;
    flags_t [NA-1:0]     alu_f;
    always_comb for (int p = 0; p < NP; p++) xr[p] = resolve(ix[p], ix_on1[p], ix_on2[p]);

    // a source value, AH..BH moved down
    function automatic logic [31:0] byte_hi(input logic [31:0] v, input logic hi);
        return hi ? v >> 8 : v;
    endfunction

    generate for (gi = 0; gi < NA; gi = gi + 1) begin : alu
        localparam int P = aport(gi);
        x86_alu u_alu (.op(xr[P].u.aop), .sz(xr[P].u.osz), .cond(xr[P].u.cond),
                       .a(byte_hi(xr[P].src[0].value, xr[P].u.hi1)),
                       .b(xr[P].u.us2 ? byte_hi(xr[P].src[1].value, xr[P].u.hi2) : xr[P].u.imm),
                       .c(xr[P].src[2].value),
                       .fin(xr[P].fsrc.value), .y(alu_y[gi]), .f(alu_f[gi]));
    end endgenerate

`ifndef SYNTHESIS
    // invariant: an uncaptured source of an issued uop is on wb1 or wb2
    always_ff @(posedge clk)
        if (!rst)
            for (int p = 0; p < NP; p++)
                if (ix_valid[p])
                    for (int i = 0; i < 4; i++) begin
                        logic cap, hit;
                        logic [TAG_W-1:0] t;
                        cap = i < 3 ? ix[p].src[i].captured : ix[p].fsrc.captured;
                        t = i < 3 ? ix[p].src[i].tag : ix[p].fsrc.tag;
                        hit = 1'b0;
                        for (int q = 0; q < NW; q++) begin
                            hit = hit || wb_valid[q] && wb_tag[q] == t || wb2_valid[q] && wb2_tag[q] == t;
                            if (ix_on1[p][i][q] != (!cap && wb_valid[q] && wb_tag[q] == t)
                                || ix_on2[p][i][q] != (!cap && wb2_valid[q] && wb2_tag[q] == t))
                                $error("port %0d source %0d bus %0d: bypass select from S is wrong", p, i, q);
                        end
                        // a store issuing its address without its data
                        if (!cap && !hit && !(p == 4 && i == 2 && !ix[p].src[2].ready)) $error("port %0d source %0d: tag %0d on no bypass", p, i, t);
                    end
`endif

    // load port A -> M register
    logic             am_valid, am_dhi;
    logic [TAG_W-1:0] am_tag;
    logic [31:0]      am_addr, am_data;   // am_data: a load's merge source
    logic [1:0]       am_osz, am_lext;
    logic [RS_W-1:0]  am_slot;
    logic             am_ok, am_fwd;      // store queue check (A)
    logic [31:0]      am_fdata;

    // ---------------- A: store queue check ----------------
    // loads: forward from the one older store at the same address at least
    // as wide, replay on any other overlap (or a second such store). Checked
    // in A, registered for M: the older store addresses were all known at
    // issue, and a store leaving the queue meanwhile has written memory.
    // Overlap by dword (equal or adjacent) and byte masks: no subtraction.
    function automatic logic [7:0] bmask(input logic [1:0] a, input logic [1:0] sz);
        return (sz == SZ8 ? 8'h1 : sz == SZ16 ? 8'h3 : 8'hF) << a;
    endfunction

    function automatic logic load_ok(input logic [SQ_W:0] snap, input logic [31:0] a,
                                     input logic [1:0] lsz,
                                     output logic fwd, output logic [31:0] fdata);
        logic       ok, two;
        logic [7:0] lm;
        logic [29:0] lo_p1, lo_m1;
        ok = 1'b1;
        two = 1'b0;
        fwd = 1'b0;
        fdata = 32'd0;
        lm = bmask(a[1:0], lsz);
        lo_p1 = a[31:2] + 30'd1;
        lo_m1 = a[31:2] - 30'd1;
        for (int k = 0; k < SQ_N; k++)
            if ((SQ_W + 1)'(SQ_W'(SQ_W'(k) - sq_head[SQ_W-1:0])) < snap - sq_head) begin
                sq_t s;
                logic [7:0] sm;
                s = sq[k];
                sm = bmask(s.addr[1:0], s.size);
                if (!s.addr_valid) ok = 1'b0;
                else if (s.addr == a && s.size >= lsz) begin
                    if (!s.data_valid) ok = 1'b0;
                    two = fwd;
                    fwd = 1'b1;
                    fdata = fdata | s.data;
                end else if (s.addr[31:2] == a[31:2] && (sm & lm) != 8'd0
                             || s.addr[31:2] == lo_p1 && (sm[3:0] & lm[7:4]) != 4'd0
                             || s.addr[31:2] == lo_m1 && (sm[7:4] & lm[3:0]) != 4'd0) ok = 1'b0;
            end
        return ok && !two;
    endfunction

    logic        a_ok, a_fwd, a_hit;
    logic [31:0] a_fdata, load_data;
    logic        uc_l, uc_hit, uc_s, uc_sdone, l1_drain;
    logic [31:0] uc_data;
    always_comb a_ok = load_ok(ix[2].sq_snap, maddr(xr[2]), ix[2].u.osz, a_fwd, a_fdata)
                       && (uc_l ? uc_hit : a_fwd || a_hit);
    assign drain = l1_drain || uc_sdone;
    x86_uc u_uc (.clk(clk), .rst(rst), .forget(fl_l2 && l2_fl_done), .learn(mem_rvalid && !mem_cacheable), .learn_region(mem_rd_region),
                 .l_addr(maddr(xr[2])), .l_size(ix[2].u.osz),
                 .l_go(ix_valid[2] && uc_l && ix[2].tag == rob_head && sq_head == sq_cmt),
                 .l_uc(uc_l), .l_hit(uc_hit), .l_data(uc_data), .retire(ret_valid[0]),
                 .s_valid(sq_head != sq_cmt), .s_addr(sq[sq_head[SQ_W-1:0]].addr),
                 .s_size(sq[sq_head[SQ_W-1:0]].size), .s_data(sq[sq_head[SQ_W-1:0]].data),
                 .s_uc(uc_s), .s_done(uc_sdone),
                 .sc_req(sc_req), .sc_status(sc_status), .sc_addr(sc_addr), .sc_be(sc_be), .sc_wdata(sc_wdata),
                 .sc_ready(sc_ready), .sc_done(sc_done), .sc_rdata(sc_rdata));

    // ---------------- M: L1D data ----------------
    logic        m_ok;
    x86_l1d #(.KB(L1D_KB)) u_l1d (.clk(clk), .rst(rst),
                   .a_valid(ix_valid[2] && !uc_l), .a_addr(maddr(xr[2])), .a_size(ix[2].u.osz), .a_hit(a_hit),
                   .m_addr(am_addr), .m_data(load_data),
                   .d_valid(sq_head != sq_cmt && !uc_s && !sn_any && !hm_look && !snoop && hs == H_IDLE), .d_addr(sq[sq_head[SQ_W-1:0]].addr),
                   .d_size(sq[sq_head[SQ_W-1:0]].size), .d_data(sq[sq_head[SQ_W-1:0]].data),
                   .d_done(l1_drain), .d_step(d_step), .d_line(d_line),
                   .pr_req(pr_req), .pr_line(ic_miss_line), .pr_done(pr_done),
                   .mem_req(dm_req), .mem_we(dm_we), .mem_addr(dm_addr), .mem_wdata(l2_wdata),
                   .mem_ready(dm_ready), .mem_rvalid(dm_rvalid), .mem_rdata(l2_rdata), .mem_rcacheable(l2_rcache),
                   .fl_req(fl_l1), .fl_done(l1d_fl_done),
                   .ext_req(sn_l1 && !sn_l1_done[0]), .ext_line(sn_q[sn_head[$clog2(SN_N)-1:0]]), .ext_done(l1d_x_done),
                   .ext_dirty(l1d_x_dirty),
                   .hm_line(c_hm_line), .hm_dirty(l1d_hm), .sr_req(hs == H_L1D), .sr_done(l1d_sr_done), .sr_hit(l1d_sr_hit),
                   .sr_data(l1d_sr_data), .sr_kill(hw_kill));
    assign m_ok = am_ok && !md_done;   // bus 2 taken by mul/div: replay

    // ---------------- stores to code ----------------
    // the store at X: its first and last byte lines, snooped in the L1I
    logic st_cross;
    always_comb begin
        logic [31:0] a;
        a = maddr(xr[4]);
        st_cross = 6'(a[4:0]) + 6'((1 << ix[4].u.osz) - 1) > 6'd31;
        sn_line[0] = a[31:5];
        sn_line[1] = a[31:5] + 27'(st_cross);
    end
    // fetch waits while a retired store to code is queued (and a cycle
    // after its drain: the L1I RAMs read during the invalidation); an L1I
    // miss waits while an older store to its line is queued
    always_comb begin
        logic [31:5] prev;
        prev = ic_miss_line - 27'd1;
        code_pend = 1'b0;
        ic_sq_busy = 1'b0;
        for (int q = 0; q < SQ_N; q++) begin
            logic [SQ_W:0] age;
            age = (SQ_W + 1)'(SQ_W'(SQ_W'(q) - sq_head[SQ_W-1:0]));
            if (age < sq_cmt - sq_head && sq[q].code) code_pend = 1'b1;
            if (age < sq_tail - sq_head && sq[q].addr_valid
                && (sq[q].addr[31:5] == ic_miss_line || sq[q].two_lines && sq[q].addr[31:5] == prev))
                ic_sq_busy = 1'b1;
        end
    end

    // ---------------- port 3: multiply / divide ----------------
    logic             md_done, md_fault, md_next;
    logic [TAG_W-1:0] md_next_tag;
    logic [TAG_W-1:0] md_tag;
    logic [31:0]      md_value;
    flags_t           md_flags;
    x86_muldiv u_md (.clk(clk), .kill(rst || flush), .start(ix_valid[3]), .op(xr[3].u.aop),
                     .sz(xr[3].u.osz), .a(xr[3].src[0].value),
                     .b(xr[3].u.us2 ? byte_hi(xr[3].src[1].value, xr[3].u.hi2) : xr[3].u.imm),
                     .c(xr[3].u.us3 ? xr[3].src[2].value : 32'd0), .tag(xr[3].tag),
                     .busy(md_busy), .done(md_done), .done_tag(md_tag), .done_value(md_value),
                     .done_flags(md_flags), .done_fault(md_fault),
                     .next(md_next), .next_tag(md_next_tag));

    // ---------------- results of X, M and port 3 ----------------
    logic [NW-1:0]          ex_valid;
    logic [NW-1:0][31:0]    ex_value, ex_redirect_pc;
    flags_t [NW-1:0]        ex_flags;
    logic [NW-1:0]          ex_mispred, ex_br, ex_fault;
    always_comb begin
        for (int a = 0; a < NA; a++) begin
            rs_t r;
            logic taken;
            logic [31:0] pc, pred;
            int p;
            p = abus(a);
            r = xr[aport(a)];
            ex_valid[p] = ix_valid[aport(a)];
            ex_value[p] = r.u.btbi ? r.u.imm2   // the BTB update's PC
                        : r.u.aop == A_LEA ? agu(r)
                        : r.u.ecxz && r.src[0].value == 32'd0 ? 32'd0   // REP exit: ECX stays 0
                        : merge(r.src[0].value, alu_y[a], r.u.osz, r.u.dhi);
            ex_flags[p] = r.u.wflags ? alu_f[a] : r.fsrc.value;
            taken = r.u.ecxz ? r.src[0].value == 32'd0
                  : r.u.loopc ? r.src[0].value != 32'd1 && (!r.u.rflags || cond_taken(r.u.cond, r.fsrc.value))
                  : r.u.uncond || cond_taken(r.u.cond, r.fsrc.value);
            pc = !taken ? r.u.next_eip : r.u.indirect ? r.src[0].value : r.u.imm;
            pred = r.u.pred_taken ? r.u.imm : r.u.next_eip;
            ex_mispred[p] = r.u.kind == K_BR && pc != pred;
            ex_redirect_pc[p] = pc;
            ex_br[p] = r.u.kind == K_BR;
        end
        ex_valid[2] = md_done || am_valid && m_ok;
        begin
            logic [31:0] raw;
            raw = am_fwd ? am_fdata : load_data;
            ex_value[2] = md_done ? md_value
                        : am_lext == LX_MERGE ? merge(am_data, raw, am_osz, am_dhi)
                                              : extend(raw, am_osz, am_lext == LX_SIGN);
        end
        ex_flags[2] = md_done ? md_flags : '0;
        ex_mispred[2] = 1'b0;
        ex_redirect_pc[2] = 32'd0;
        ex_br[2] = 1'b0;
        ex_fault = '0;
        ex_fault[2] = md_done && md_fault;
    end

    // bypass selects of the uops issuing now: X / M results are on wb1 in
    // their X cycle, wb1 on wb2
    always_comb begin
        logic [NW-1:0][TAG_W-1:0] ex_tag;
        for (int a = 0; a < NA; a++) ex_tag[abus(a)] = ix[aport(a)].tag;
        ex_tag[2] = md_done ? md_tag : am_tag;
        for (int p = 0; p < NP; p++)
            for (int i = 0; i < 4; i++) begin
                logic cap;
                logic [TAG_W-1:0] t;
                cap = i < 3 ? ixn[p].src[i].captured : ixn[p].fsrc.captured;
                t = i < 3 ? ixn[p].src[i].tag : ixn[p].fsrc.tag;
                for (int q = 0; q < NW; q++) begin
                    on1_n[p][i][q] = !cap && ex_valid[q] && ex_tag[q] == t;
                    on2_n[p][i][q] = !cap && wb_valid[q] && wb_tag[q] == t;
                end
            end
    end
    always_comb begin
        for (int a = 0; a < NA; a++) begin
            ew_valid[abus(a)] = grant[aport(a)] != '0;
            ew_tag[abus(a)] = gtag[a];
        end
        // bus 2 a cycle ahead: mul/div done next cycle, else a load in A
        // that M will complete (its check is done, the bus free)
        ew_valid[2] = md_next || ix_valid[2] && a_ok;
        ew_tag[2] = md_next ? md_next_tag : ix[2].tag;
    end

    // pipeline data: written whatever the flush (the valid bits drop it), so
    // the flush only drives control registers
    always_ff @(posedge clk) begin
        wb_value <= ex_value;
        wb_flags <= ex_flags;
        wb_mispred <= ex_mispred;
        wb_redirect_pc <= ex_redirect_pc;
        wb_br <= ex_br;
        wb_fault <= ex_fault;
        for (int a = 0; a < NA; a++) wb_tag[abus(a)] <= ix[aport(a)].tag;
        wb_tag[2] <= md_done ? md_tag : am_tag;
        wb2_tag <= wb_tag;
        wb2_value <= wb_value;
        wb2_flags <= wb_flags;
        ix <= ixn;
        ix_on1 <= on1_n;
        ix_on2 <= on2_n;
        ix_slot <= slot_of(grant[2]);
        am_tag <= ix[2].tag;
        am_addr <= maddr(xr[2]);
        am_data <= ix[2].u.us3 ? byte_hi(xr[2].src[2].value, ix[2].u.hi3) : ix[2].u.imm2;
        am_osz <= ix[2].u.osz;
        am_lext <= ix[2].u.lext;
        am_dhi <= ix[2].u.dhi;
        am_ok <= a_ok;
        am_fwd <= a_fwd || uc_l;
        am_fdata <= uc_l ? uc_data : a_fdata;
        am_slot <= ix_slot;
    end

    // ---------------- state update ----------------
    always_ff @(posedge clk) begin
        flush <= r_flush && !rst;
        if (rst) a20_q <= 1'b0;
        else if (r_flush) a20_q <= a20m;
        if (rst) code_snooped <= 1'b0;
        else if (l1i_x_hit) code_snooped <= 1'b1;
        else if (r_flush) code_snooped <= 1'b0;
        smc_q <= r_smc && !rst;
        code_pend_q <= code_pend;
        flush_pc <= r_flush_pc;
        flush_btb <= r_btb;
        flush_bpc <= rob[TAG_W'(rob_head + TAG_W'(r_n - 2'd1))].value;
        if (rst || flush) begin
            uq_head <= '0;
            uq_tail <= '0;
            uq_count <= '0;
            rob_head <= '0;
            rob_tail <= '0;
            rob_count <= '0;
            for (int e = 0; e < RS_N; e++) rs[e].valid <= 1'b0;
            sq_tail <= sq_cmt;   // retired stores stay until drained
            for (int r = 0; r < NREG; r++) rat_rob[r] <= 1'b0;
            frat_rob <= 1'b0;
            ix_valid <= '0;
            dq_valid <= '0;
            am_valid <= 1'b0;
            wb_valid <= '0;
            wb2_valid <= '0;
        end
        if (rst) begin
            sq_head <= '0;
            sq_cmt <= '0;
            sq_tail <= '0;
            halted <= 1'b0;
            illegal <= 1'b0;
            df <= 1'b0;
            alu_port <= 2'd0;
            for (int r = 0; r < NREG; r++) arch[r] <= 32'd0;
            arch[R_ESP] <= 32'h0010_0000;
            arch_flags <= '0;
        end else begin
            // retire: architectural state, RAT entries that still point here
            for (int k = 0; k < 3; k++)
                if (ret_valid[k]) begin
                    rob_t e;
                    logic [TAG_W-1:0] t;
                    t = TAG_W'(rob_head + TAG_W'(k));
                    e = rob[t];
                    if (e.wdst) begin
                        arch[e.dst] <= e.value;
                        if (rat_rob[e.dst] && rat_tag[e.dst] == t) rat_rob[e.dst] <= 1'b0;
                    end
                    if (e.wflags) begin
                        arch_flags <= e.flags;
                        if (frat_rob && frat_tag == t) frat_rob <= 1'b0;
                    end
                end
            if (r_halt) halted <= 1'b1;
            if (r_dfw) df <= rob[TAG_W'(rob_head + TAG_W'(r_n - 2'd1))].dst[0];
            if (r_ill) illegal <= 1'b1;
            sq_head <= sq_head + (SQ_W + 1)'(drain);
            if (!flush) begin
                rob_head <= rob_head + TAG_W'(r_n);
                if (r_store) sq_cmt <= sq_cmt + 1'b1;
                // wb1 -> ROB
                for (int p = 0; p < NW; p++)
                    if (wb_valid[p]) begin
                        rob[wb_tag[p]].done <= 1'b1;
                        rob[wb_tag[p]].value <= wb_value[p];
                        rob[wb_tag[p]].flags <= wb_flags[p];
                        rob[wb_tag[p]].mispred <= wb_mispred[p];
                        rob[wb_tag[p]].fault <= wb_fault[p];
                        rob[wb_tag[p]].redirect_pc <= wb_redirect_pc[p];
                        if (wb_br[p]) rob[wb_tag[p]].next_eip <= wb_redirect_pc[p];
                    end
                // X / M -> wb1 -> wb2
                wb_valid <= ex_valid;
                wb2_valid <= wb_valid;
                // S -> X / A
                for (int p = 0; p < NP; p++) ix_valid[p] <= grant[p] != '0;
                for (int p = 0; p < NP; p++)
                    for (int e = 0; e < RS_N; e++)
                        if (p != 2 && p != 4 && grant[p][e]) rs[e].valid <= 1'b0;
                for (int e = 0; e < RS_N; e++) begin
                    if (grant[2][e]) rs[e].issued <= 1'b1;
                    if (grant[4][e]) begin
                        if (rs[e].src[2].ready) rs[e].valid <= 1'b0;
                        else rs[e].issued <= 1'b1;
                    end
                end
                // A -> M
                am_valid <= ix_valid[2];
                // X store: its queue entry, done (no result)
                if (ix_valid[4] && !ix[4].issued) begin
                    sq[ix[4].sq_idx].addr_valid <= 1'b1;
                    sq[ix[4].sq_idx].size <= ix[4].u.osz;
                    sq[ix[4].sq_idx].addr <= maddr(xr[4]);
                    sq[ix[4].sq_idx].code <= ic_sn_hit;
                    sq[ix[4].sq_idx].two_lines <= st_cross;
                    rob[ix[4].tag].smc <= ic_sn_hit;
                end
                if (ix_valid[4] && ix[4].src[2].ready) begin
                    sq[ix[4].sq_idx].data_valid <= 1'b1;
                    sq[ix[4].sq_idx].data <= ix[4].u.us3 ? byte_hi(xr[4].src[2].value, ix[4].u.hi3) : ix[4].u.imm2;
                    rob[ix[4].tag].done <= 1'b1;
                end
                // M: done or replay
                if (am_valid) begin
                    if (m_ok) rs[am_slot].valid <= 1'b0;
                    else rs[am_slot].issued <= 1'b0;
                end
                // wakeup: early (ready), wb1 (ready + capture)
                for (int e = 0; e < RS_N; e++) begin
                    for (int i = 0; i < 3; i++) begin
                        for (int p = 0; p < NW; p++)
                            if (ew_valid[p] && rs[e].src[i].tag == ew_tag[p]) rs[e].src[i].ready <= 1'b1;
                        for (int p = 0; p < NW; p++)
                            if (wb_valid[p] && !rs[e].src[i].captured && rs[e].src[i].tag == wb_tag[p]) begin
                                rs[e].src[i].ready <= 1'b1;
                                rs[e].src[i].captured <= 1'b1;
                                rs[e].src[i].value <= wb_value[p];
                            end
                    end
                    for (int p = 0; p < NW; p++)
                        if (ew_valid[p] && rs[e].fsrc.tag == ew_tag[p]) rs[e].fsrc.ready <= 1'b1;
                    for (int p = 0; p < NW; p++)
                        if (wb_valid[p] && !rs[e].fsrc.captured && rs[e].fsrc.tag == wb_tag[p]) begin
                            rs[e].fsrc.ready <= 1'b1;
                            rs[e].fsrc.captured <= 1'b1;
                            rs[e].fsrc.value <= wb_flags[p];
                        end
                end
                // D: RS (+ age matrix row)
                begin
                    logic [RS_N-1:0] valid_now, new_slots, row;
                    for (int e = 0; e < RS_N; e++) valid_now[e] = rs[e].valid;
                    new_slots = '0;
                    for (int k = 0; k < 3; k++)
                        if (ds_to_rs[k]) new_slots = new_slots | ds_slot[k];
                    for (int e = 0; e < RS_N; e++) older[e] <= older[e] & ~new_slots;
                    row = valid_now;
                    for (int k = 0; k < 3; k++)
                        if (ds_to_rs[k]) begin
                            for (int e = 0; e < RS_N; e++)
                                if (ds_slot[k][e]) begin
                                    rs[e] <= ds_rs[k];
                                    older[e] <= row;
                                end
                            row = row | ds_slot[k];
                        end
                end
                // a drained store leaves the loads' older sets (its entry
                // is reused by a younger store)
                if (drain)
                    for (int e = 0; e < RS_N; e++) rs[e].sq_older[sq_head[SQ_W-1:0]] <= 1'b0;
                // R: ROB, RAT, store queue entry -> D
                for (int k = 0; k < 3; k++) begin
                    if (d_ok) begin
                        dq_valid[k] <= 2'(k) < rn_n;
                        dq[k] <= rn[k];
                    end
                    if (2'(k) < rn_n) begin
                        uop_t u;
                        u = rn[k].u;
                        // value, flags, redirect_pc: written by wb before use
                        // (off the rename -> ROB enable path)
                        rob[rn[k].tag].done <= !needs_rs(u.kind);
                        rob[rn[k].tag].kind <= u.kind;
                        rob[rn[k].tag].dst <= u.dst;
                        rob[rn[k].tag].wdst <= u.wdst;
                        rob[rn[k].tag].wflags <= u.wflags;
                        rob[rn[k].tag].eop <= u.eop;
                        rob[rn[k].tag].next_eip <= u.next_eip;
                        rob[rn[k].tag].mispred <= 1'b0;
                        rob[rn[k].tag].smc <= 1'b0;
                        rob[rn[k].tag].fault <= 1'b0;
                        rob[rn[k].tag].bp_jcc <= u.kind == K_BR && !u.btbi && u.imm2[14];
                        rob[rn[k].tag].bp_taken <= u.pred_taken;
                        rob[rn[k].tag].btbi <= u.btbi;
                        rob[rn[k].tag].rcall <= u.rcall;
                        rob[rn[k].tag].rret <= u.rret;
                        if (u.kind == K_ST) begin
                            sq[rn[k].sq_snap[SQ_W-1:0]].addr_valid <= 1'b0;
                            sq[rn[k].sq_snap[SQ_W-1:0]].data_valid <= 1'b0;
                        end
                        if (u.wdst) begin
                            rat_rob[u.dst] <= 1'b1;
                            rat_tag[u.dst] <= rn[k].tag;
                        end
                        if (u.wflags) begin
                            frat_rob <= 1'b1;
                            frat_tag <= rn[k].tag;
                        end
                        if (is_alu(u.kind)) alu_port <= rn[k].port == 2'd2 ? 2'd0 : rn[k].port + 2'd1;
                    end
                end
                rob_tail <= rob_tail + TAG_W'(rn_n);
                rob_count <= rob_count + (TAG_W + 1)'(rn_n) - (TAG_W + 1)'(r_n);
                if (rn_n != 2'd0) sq_tail <= rn[rn_n - 2'd1].sq_snap
                                             + (SQ_W + 1)'(rn[rn_n - 2'd1].u.kind == K_ST);
                // uop queue: every valid slot written (room for p_all), the
                // tail moved past the taken ones only (timing: p_take is late)
                begin
                    logic [3:0] t, pushed;
                    t = uq_tail;
                    pushed = 4'd0;
                    if (p_push)
                        for (int k = 0; k < 3; k++)
                            if (p_valid[k])
                                for (int i = 0; i < 3; i++)
                                    if (i < int'(p_n[k])) begin
                                        uq[t] <= p_uop_ret[k][i];
                                        t = t + 4'd1;
                                        if (p_take[k]) pushed = pushed + 4'd1;
                                    end
                    uq_tail <= uq_tail + pushed;
                    uq_head <= uq_head + 4'(rn_n);
                    uq_count <= uq_count + 5'(pushed) - 5'(rn_n);
                end
            end
        end
    end
endmodule
