alphaonex86/FPGA-CPU/rtl/tests/x86/tb/core_top.sv

// M2 testbench top: x86_core (cache sizes: the parameters, x86_bench.sh) with a 4 MB memory loaded from +image=<hex> at
// 0x1000 behind a line port of +mem_lat=<cycles> read latency (default
// 10; writes posted, one read in flight), writing the retire trace (one line per x86
// instruction, x86_trace_check format) to +trace=<file>; +debug prints the
// frontend redirects, the extracted instructions, mul/div starts and results
// and the retired uops; +stats a cycle breakdown at the end.
// With S3_BUS defined (rtl/tools/s3_test.sh) the memory sits behind the Socket 3 bus instead: s3_bus,
// the pins, FPGAcommon's chipset front end cpu486_bif (its protocol rules) and a 16-bit host port
// slave answering +host_lat=<cycles> after the request (default 0); bus contention stops the run.
// Single cycles (uncached: the VGA window) take one clock without S3_BUS; a line access to that
// window stops the run. Without S3_BUS the 64 KB at 0x80000 come without KEN#: an L1D or L2 line
// installed from there stops the run (the core must learn the region and go uncached).
module core_top #(
    parameter int L1I_KB = 16,
    parameter int L1D_KB = 16,
    parameter int L2_KB = 256
) (
    input  logic clk,
    input  logic rst,
    output logic halted,
    output logic illegal,
    output logic [31:0] cycles,
    output logic [31:0] insns,
    output logic marked          // +mark=<hex>: a second instruction retired into that EIP (x86_bench.sh)
);
    import x86_pkg::*;
    localparam int MEM = 1 << 22;

    logic [7:0]  mem [MEM];
    logic        mem_req, mem_we, mem_ready, mem_rvalid, rd_pend;
    logic [31:5] mem_addr, rd_line;
    logic [255:0] mem_wdata, mem_rdata;
    int          mem_lat, rd_cnt;
    logic        sc_req, sc_ready, sc_done, mem_cacheable;
    logic [2:0]  sc_status;
    logic [31:2] sc_addr;
    logic [3:0]  sc_be;
    logic [31:0] sc_wdata, sc_rdata;
    logic [2:0]  ret_valid, ret_eop, ret_wdst, ret_wflags;
    logic [2:0][31:0] ret_next_eip, ret_value;
    logic [2:0][3:0]  ret_dst;
    flags_t [2:0]     ret_flags;
    logic [31:0] regs [8];
    flags_t      flags;
    int          trace;
    logic        debug, stats;
    // +stats: cycles that retire nothing (ROB empty / head not done), uop
    // queue empty, decode redirects, retire flushes
    logic [31:0] st_empty, st_wait, st_uq_empty, st_dec_redir, st_flush;
    logic [31:0] st_wait_kind [16];   // head waits by the head uop kind (kind_t)
    logic [31:0] st_dr [4];          // decode redirects: not followed, falsely taken, target, cut
    logic [31:0] st_mp_wait, st_refill;   // flushing branch: result -> retire; flush -> next retire
    logic [31:0] st_fl [6];               // flushes: P-predicted Jcc, indirect, RET, other branch, K_DF, store to code
    logic [31:0] st_skew, st_alu3, st_mem2, st_replay, st_replay_md;   // issue contention
    logic [31:0] st_miss, st_wb;              // L2 misses, writebacks
    logic [31:0] st_imiss, st_dmiss, st_dwb;  // L1I, L1D misses, L1D writebacks
    logic [31:0] st_sn [7];                   // snoops queued; lines invalidated in L2 / L1D / L1I; dirty kept; HITM#, with INV
    logic [31:0] mp_cycle [ROB_N];
    logic        ind [ROB_N];       // the ROB entry is an indirect branch (RET: predicted taken)
    logic        refill;
    logic [31:0] st_x [4], st_rn [4];   // instructions extracted, uops renamed per cycle

    // +flush=<n>: FLUSH# for two clocks every n clocks (the trace must not change)
    int   flush_n;
    logic flush_tb;
    initial if (!$value$plusargs("flush=%d", flush_n)) flush_n = 0;
    assign flush_tb = flush_n > 0 && cycles % flush_n < 2;
    // snoops: from the bus unit with S3_BUS, else +snoop=<n>: an invalidation every n clocks of the
    // L1s' last L2 request, the drain's line, the fetch line or a line anywhere in the 1 MB (dirty ones are kept:
    // the trace must not change)
    logic         bus_snoop, bus_snoop_inv, bus_enhanced, snoop_err, flush_done, flush_sw, flush_wb;
    logic [31:4]  bus_snoop_line;
    logic         hm_look, hm_inv, hw_take, hm_dirty, hw_valid, hw_none;
    logic [31:4]  hm_line;
    logic [255:0] hw_data;
`ifndef S3_BUS
    // +hitm=1: enhanced mode, INV at random; a dirty line's write-back (HITM#) is written into the
    // memory, no line is read meanwhile (the bus waits for it); with INV the line must come back
    // from there: the trace checks the written-back data
    int           snoop_n, hitm_mode;
    logic [31:0]  sn_rand;
    logic         hitm_wait;
    initial begin
        if (!$value$plusargs("snoop=%d", snoop_n)) snoop_n = 0;
        if (!$value$plusargs("hitm=%d", hitm_mode)) hitm_mode = 0;
    end
    assign bus_enhanced = hitm_mode != 0;
    assign hw_take = hw_valid;
    always_ff @(posedge clk) begin
        sn_rand <= $urandom;
        hm_look <= !rst && snoop_n > 0 && cycles % snoop_n == 0 && !hitm_wait;
        unique case (sn_rand[1:0])
            2'd0: hm_line <= {core.l2_addr, sn_rand[2]};
            2'd1: hm_line <= {core.d_line, sn_rand[2]};
            2'd2: hm_line <= {core.fetch_pc[31:5], sn_rand[2]};
            default: hm_line <= {12'd0, sn_rand[31:16]};
        endcase
        hm_inv <= hitm_mode == 0 || sn_rand[3];
        bus_snoop <= hm_look;                    // the snoop pulse comes a clock after the lookup
        bus_snoop_line <= hm_line;
        bus_snoop_inv <= hm_inv;
        if (rst) hitm_wait <= 1'b0;
        else if (hm_look && hm_dirty) hitm_wait <= 1'b1;
        else if (hw_valid) hitm_wait <= 1'b0;
        if (!rst && hw_valid && hw_none) begin
            $display("FAIL: HITM# without data (cycle %0d)", cycles);
            $finish;
        end
    end
`else
    assign hm_line[4] = 1'b0;
`endif

`ifdef S3_BUS
    x86_core #(.L1I_KB(L1I_KB), .L1D_KB(L1D_KB), .L2_KB(L2_KB)) core (.clk(clk), .rst(s3_rst), .reset_eip(32'h1000), .a20m(1'b0), .cache_flush(flush_tb),
                   .snoop(bus_snoop), .snoop_line(bus_snoop_line), .snoop_inv(bus_snoop_inv), .enhanced(bus_enhanced),
                   .snoop_err(snoop_err), .flush_done(flush_done), .flush_sw(flush_sw), .flush_wb(flush_wb),
                   .hm_look(hm_look), .hm_line(hm_line[31:5]), .hm_inv(hm_inv), .hm_dirty(hm_dirty), .hw_valid(hw_valid), .hw_none(hw_none), .hw_data(hw_data),
                   .hw_take(hw_take),
`else
    x86_core #(.L1I_KB(L1I_KB), .L1D_KB(L1D_KB), .L2_KB(L2_KB)) core (.clk(clk), .rst(rst), .reset_eip(32'h1000), .a20m(1'b0), .cache_flush(flush_tb),
                   .snoop(bus_snoop), .snoop_line(bus_snoop_line), .snoop_inv(bus_snoop_inv), .enhanced(bus_enhanced),
                   .snoop_err(snoop_err), .flush_done(flush_done), .flush_sw(flush_sw), .flush_wb(flush_wb),
                   .hm_look(hm_look), .hm_line(hm_line[31:5]), .hm_inv(hm_inv), .hm_dirty(hm_dirty), .hw_valid(hw_valid), .hw_none(hw_none), .hw_data(hw_data),
                   .hw_take(hw_take),
`endif
                   .mem_req(mem_req), .mem_we(mem_we), .mem_addr(mem_addr), .mem_wdata(mem_wdata),
                   .mem_ready(mem_ready), .mem_rvalid(mem_rvalid), .mem_rdata(mem_rdata),
                   .mem_cacheable(mem_cacheable), .sc_req(sc_req), .sc_status(sc_status), .sc_addr(sc_addr), .sc_be(sc_be), .sc_wdata(sc_wdata),
                   .sc_ready(sc_ready), .sc_done(sc_done), .sc_rdata(sc_rdata),
                   .ret_valid(ret_valid), .ret_eop(ret_eop), .ret_next_eip(ret_next_eip),
                   .ret_wdst(ret_wdst), .ret_dst(ret_dst), .ret_value(ret_value),
                   .ret_wflags(ret_wflags), .ret_flags(ret_flags),
                   .halted(halted), .illegal(illegal));

`ifdef S3_BUS
    logic [31:2]  a_o;
    logic [31:0]  d_o, d_pin, chip_d;
    logic [3:0]   be_n, dp_o;
    logic         a_oe, ads_n, ads_r, mio, dc, wr, blast_n, d_oe, chip_d_oe, brdy_n, ken_n, cpu_reset, rdy_n;
    logic         wbwt_n, ahold, hold, eads_n, inv, boff_n;
    logic         host_req, host_we, host_ready, host_ack;
    logic [31:1]  host_addr;
    logic [15:0]  host_wdata, host_rdata;
    logic [1:0]   host_be;
    int           host_lat, host_cnt;
    logic         s3_rst;

    assign s3_rst = rst || cpu_reset;
    // +snoop=<n>: every n clocks a snoop under AHOLD (cpu486_bif never snoops) of the L1s' last L2
    // request, the drain's line, the fetch line or a line in the 1 MB, INV at random; +hitm=1: WB/WT#
    // high at RESET (enhanced mode: HITM# write-backs reach the memory through the chipset)
    // (a fill through the chipset takes ~40 clocks: snooping its line faster starves it, as a bus master
    // writing that line without pause would; s3_test.sh uses 37)
    int           sn_n, sn_hitm, sn_t;
    logic [31:4]  sn_a;
    logic [31:0]  sn_rand;
    logic         sn_ah, sn_eads, sn_inv, chip_wbwt_n, chip_ahold, chip_eads_n, chip_inv;
    initial begin
        if (!$value$plusargs("snoop=%d", sn_n)) sn_n = 0;
        if (!$value$plusargs("hitm=%d", sn_hitm)) sn_hitm = 0;
    end
    assign wbwt_n = sn_hitm != 0 || chip_wbwt_n;
    assign ahold  = chip_ahold || sn_ah;
    assign eads_n = chip_eads_n && !sn_eads;
    assign inv    = sn_eads ? sn_inv : chip_inv;
    // AHOLD for 5 clocks, EADS# in the third (the address floated); released in time for a write-back
    always_ff @(posedge clk) begin
        sn_rand <= $urandom;
        sn_t    <= rst || sn_n == 0 || sn_t == sn_n - 1 ? 0 : sn_t + 1;
        sn_ah   <= !rst && sn_n > 4 && sn_t < 5;
        sn_eads <= !rst && sn_n > 4 && sn_t == 2;
        if (sn_t == 2) begin
            unique case (sn_rand[1:0])
                2'd0: sn_a <= {core.l2_addr, sn_rand[2]};
                2'd1: sn_a <= {core.d_line, sn_rand[2]};
                2'd2: sn_a <= {core.fetch_pc[31:5], sn_rand[2]};
                default: sn_a <= {12'd0, sn_rand[31:16]};
            endcase
            sn_inv <= sn_rand[3];
        end
    end
    assign ads_n  = a_oe ? ads_r : 1'b1;            // the pad: floated with the address, pulled up
    assign d_pin  = d_oe ? d_o : chip_d_oe ? chip_d : 32'hffff_ffff;
    s3_bus bus (.clk(clk), .rst(s3_rst),
                .mem_req(mem_req), .mem_we(mem_we), .mem_addr(mem_addr), .mem_wdata(mem_wdata),
                .mem_ready(mem_ready), .mem_rvalid(mem_rvalid), .mem_rdata(mem_rdata), .mem_cacheable(mem_cacheable),
                .sc_req(sc_req), .sc_status(sc_status), .sc_lock(1'b0), .sc_addr(sc_addr), .sc_be(sc_be),
                .sc_wdata(sc_wdata), .sc_ready(sc_ready), .sc_done(sc_done), .sc_rdata(sc_rdata),
                .quiet(1'b1), .flush_done(flush_done), .flush_sw(flush_sw), .flush_wb(flush_wb), .stopped(), .snoop(bus_snoop), .snoop_addr(bus_snoop_line), .snoop_inv(bus_snoop_inv),
                .enhanced(bus_enhanced),
                .hm_look(hm_look), .hm_line(hm_line[31:5]), .hm_inv(hm_inv), .hm_dirty(hm_dirty), .hw_valid(hw_valid),
                .hw_none(hw_none), .hw_data(hw_data), .hw_take(hw_take), .a_o(a_o), .a_oe(a_oe), .a_i(a_oe ? a_o[31:4] : sn_a), .be_n(be_n), .ads_n(ads_r), .mio(mio), .dc(dc), .wr(wr),
                .blast_n(blast_n), .lock_n(), .cache_n(), .hitm_n(), .ctl_oe(), .d_o(d_o), .dp_o(dp_o), .d_oe(d_oe),
                .d_i(d_pin), .dp_i({^d_pin[31:24], ^d_pin[23:16], ^d_pin[15:8], ^d_pin[7:0]}), .pchk_n(),
                .hlda(), .breq(), .rdy_n(rdy_n), .brdy_n(brdy_n), .ken_n(ken_n), .hold(hold), .ahold(ahold),
                .boff_n(boff_n), .eads_n(eads_n), .inv(inv), .wb_wt_n(wbwt_n), .stpclk_n(1'b1), .bs8_n(1'b1),
                .bs16_n(1'b1));
    cpu486_bif #(.MEM_TOP(32'h0010_0000)) chipset (
                .clk(clk), .rst_n(!rst), .cpu_a(a_o), .cpu_be_n(be_n), .cpu_ads_n(ads_n), .cpu_mio_n(mio),
                .cpu_dc_n(dc), .cpu_wr_n(wr), .cpu_blast_n(blast_n), .cpu_d_i(d_pin), .cpu_d_o(chip_d),
                .cpu_d_oe(chip_d_oe), .cpu_brdy_n(brdy_n), .cpu_ken_n(ken_n), .cpu_reset(cpu_reset),
                .cpu_rdy_n(rdy_n), .cpu_wbwt_n(chip_wbwt_n), .cpu_ahold(chip_ahold), .cpu_hold(hold), .cpu_eads_n(chip_eads_n),
                .cpu_inv(chip_inv), .cpu_boff_n(boff_n),
                .host_req(host_req), .host_we(host_we), .host_mio(), .host_dc(), .host_addr(host_addr),
                .host_wdata(host_wdata), .host_be(host_be), .host_ready(host_ready), .host_rdata(host_rdata),
                .host_rvalid(host_ready && !host_we),
                .spc_stb(), .spc_a(), .spc_be(), .err_burst_write());
    assign host_ready = host_req && !host_ack && host_cnt >= host_lat;      // HOSTPORT.md C4
    assign host_rdata = {mem[22'({host_addr, 1'b1})], mem[22'({host_addr, 1'b0})]};
    always_ff @(posedge clk) begin
        host_ack <= host_ready;
        host_cnt <= host_req && !host_ready && !host_ack ? host_cnt + 1 : 0;
        if (host_ready && host_we) begin
            if (host_be[0]) mem[22'({host_addr, 1'b0})] <= host_wdata[7:0];
            if (host_be[1]) mem[22'({host_addr, 1'b1})] <= host_wdata[15:8];
        end
        if (!rst && d_oe && chip_d_oe) begin
            $display("FAIL: both ends drive the data bus (cycle %0d)", cycles);
            $finish;
        end
        if (!rst && chipset.err_burst_write) begin
            $display("FAIL: the chipset saw a burst write (cycle %0d)", cycles);
            $finish;
        end
    end
    initial if (!$value$plusargs("host_lat=%d", host_lat)) host_lat = 0;
`else
    always_comb begin
        for (int i = 0; i < 32; i++) mem_rdata[8*i +: 8] = mem[22'({rd_line, 5'd0} + 32'(i))];
    end
    assign mem_ready = !rd_pend && !hitm_wait;
    assign mem_rvalid = rd_pend && rd_cnt == 0;
    assign sc_ready = !sc_done;
    assign mem_cacheable = rd_line[31:16] != 16'h0008;
    always_ff @(posedge clk)
        if (!rst && (core.u_l1d.st == core.u_l1d.S_FILL && core.u_l1d.f_line[31:16] == 16'h0008
                     || core.u_l2.fill && core.u_l2.t_wd.v && core.u_l2.e_addr[31:16] == 16'h0008)) begin
            $display("FAIL: a line without KEN# installed (cycle %0d)", cycles);
            $finish;
        end
`endif
    always_ff @(posedge clk)
        if (!rst && mem_req && mem_ready && mem_addr[31:17] == 15'h0005) begin
            $display("FAIL: a line access to the uncached window, %08x (cycle %0d)", {mem_addr, 5'd0}, cycles);
            $finish;
        end

    initial begin
        string image, tname;
        for (int i = 0; i < MEM; i++) mem[i] = 8'h00;
        if (!$value$plusargs("image=%s", image) || !$value$plusargs("trace=%s", tname)) begin
            $display("usage: +image=<hex> +trace=<file>");
            $finish;
        end
        $readmemh(image, mem, 32'h1000);
        debug = $test$plusargs("debug");
        stats = $test$plusargs("stats");
        if (!$value$plusargs("mem_lat=%d", mem_lat)) mem_lat = 10;
        if (mem_lat < 1) begin
            $display("+mem_lat must be >= 1");
            $finish;
        end
        trace = $fopen(tname, "w");
        if (trace == 0) begin
            $display("cannot write %s", tname);
            $finish;
        end
    end

    logic [31:0] mark_eip;
    logic [1:0]  mark_n;
    initial if (!$value$plusargs("mark=%h", mark_eip)) mark_eip = 32'd0;
    assign marked = mark_eip == 32'd0 || mark_n == 2'd2;
    always_ff @(posedge clk)
        if (rst) mark_n <= 2'd0;
        else if (mark_n != 2'd2 && (ret_valid[0] && ret_next_eip[0] == mark_eip || ret_valid[1] && ret_next_eip[1] == mark_eip
                                    || ret_valid[2] && ret_next_eip[2] == mark_eip)) mark_n <= mark_n + 2'd1;

    always_ff @(posedge clk) begin
        if (rst) begin
            for (int r = 0; r < 8; r++) regs[r] <= 32'd0;
            regs[4] <= 32'h0010_0000;
            flags <= '0;
            cycles <= 32'd0;
            insns <= 32'd0;
            {st_empty, st_wait, st_uq_empty, st_dec_redir, st_flush, st_mp_wait, st_refill} <= '0;
            {st_skew, st_alu3, st_mem2, st_replay, st_replay_md, st_miss, st_wb} <= '0;
            {st_imiss, st_dmiss, st_dwb} <= '0;
            for (int i = 0; i < 7; i++) st_sn[i] <= '0;
            rd_pend <= 1'b0;
`ifndef S3_BUS
            sc_done <= 1'b0;
`endif
            refill <= 1'b0;
            for (int i = 0; i < 6; i++) st_fl[i] <= 32'd0;
            for (int i = 0; i < 16; i++) st_wait_kind[i] <= 32'd0;
            for (int i = 0; i < 4; i++) st_dr[i] <= 32'd0;
            for (int i = 0; i < 4; i++) {st_x[i], st_rn[i]} <= '0;
        end else begin
            logic [31:0] r [8];
            flags_t      f;
            logic [31:0] done;
            r = regs;
            done = insns;
            f = flags;
            cycles <= cycles + 32'd1;
            if (ret_valid == 3'd0 && !halted) begin
                if (core.rob_count == '0) st_empty <= st_empty + 32'd1;
                else begin
                    st_wait <= st_wait + 32'd1;
                    st_wait_kind[core.rob[core.rob_head].kind] <= st_wait_kind[core.rob[core.rob_head].kind] + 32'd1;
                end
            end
            if (core.uq_count == '0) st_uq_empty <= st_uq_empty + 32'd1;
            if (core.fe_redirect && !core.flush) begin
                int c;
                logic ft;
                ft = core.p_next[core.p_btb_k] != core.p_seq[core.p_btb_k];
                c = !core.p_btb ? 3 : !ft ? 0 : !core.p_dir[core.p_btb_k] ? 1 : 2;
                st_dec_redir <= st_dec_redir + 32'd1;
                st_dr[c] <= st_dr[c] + 32'd1;
            end
            if (core.flush) st_flush <= st_flush + 32'd1;
            if (core.fe.out_free && !core.fe_redirect && !core.flush)
                st_x[$countones(core.fe.x_valid)] <= st_x[$countones(core.fe.x_valid)] + 32'd1;
            st_rn[core.rn_n] <= st_rn[core.rn_n] + 32'd1;
            begin
                int n0, n1, n2;
                n0 = $countones(core.req[0]);
                n1 = $countones(core.req[1]);
                n2 = $countones(core.req[2]);
                if (n0 >= 2 && n1 == 0 || n1 >= 2 && n0 == 0) st_skew <= st_skew + 32'd1;
                if (n0 + n1 >= 3 && n0 > 0 && n1 > 0) st_alu3 <= st_alu3 + 32'd1;
                if (n2 >= 2) st_mem2 <= st_mem2 + 32'd1;
            end
            if (core.am_valid && !core.m_ok) begin
                st_replay <= st_replay + 32'd1;
                if (core.md_done) st_replay_md <= st_replay_md + 32'd1;
            end
            if (!core.flush)
                for (int k = 0; k < 3; k++)
                    if (2'(k) < core.rn_n) ind[core.rn[k].tag] <= core.rn[k].u.kind == K_BR && core.rn[k].u.indirect;
            for (int p = 0; p < core.NW; p++)
                if (core.wb_valid[p] && core.wb_mispred[p]) mp_cycle[core.wb_tag[p]] <= cycles;
            if (core.r_flush) begin
                int c;
                logic [TAG_W-1:0] t;
                t = core.rob_head + TAG_W'(core.r_n - 2'd1);
                st_mp_wait <= st_mp_wait + cycles - mp_cycle[t];
                c = core.rob[t].kind == K_DF ? 4 : !(core.rob[t].kind == K_BR && core.rob[t].mispred) ? 5
                  : core.rob[t].bp_jcc ? 0 : ind[t] ? (core.rob[t].bp_taken ? 2 : 1) : 3;
                st_fl[c] <= st_fl[c] + 32'd1;
            end
            if (core.flush) refill <= 1'b1;
            else if (ret_valid != 3'd0) refill <= 1'b0;
            if (refill && ret_valid == 3'd0) st_refill <= st_refill + 32'd1;
            if (debug) begin
                if (core.fe_redirect) $display("%0d redirect %08x", cycles, core.fe_redirect_pc);
                for (int k = 0; k < 3; k++)
                    if (core.x_valid[k] && core.p_load)
                        $display("%0d decode %08x len %0d", cycles, core.x_eip[k], core.x_len[k]);
                if (core.ix_valid[3])
                    $display("%0d md start op %0d tag %0d a %08x b %08x c %08x", cycles, core.xr[3].u.aop,
                             core.xr[3].tag, core.xr[3].src[0].value, core.u_md.b, core.u_md.c);
                if (core.md_done)
                    $display("%0d md done tag %0d value %08x", cycles, core.md_tag, core.md_value);
                for (int k = 0; k < 3; k++)
                    if (ret_valid[k])
                        $display("%0d retire eop %0d next %08x dst %0d=%08x", cycles, ret_eop[k],
                                 ret_next_eip[k], ret_wdst[k] ? 32'(ret_dst[k]) : -1, ret_value[k]);
            end
            if (core.im_ready) st_imiss <= st_imiss + 32'd1;
            if (core.dm_req && core.dm_ready && !core.dm_we) st_dmiss <= st_dmiss + 32'd1;
            if (core.dm_req && core.dm_ready && core.dm_we) st_dwb <= st_dwb + 32'd1;
            if (core.sn_push) st_sn[0] <= st_sn[0] + 32'd1;
            if (core.u_l2.x_wr) st_sn[1] <= st_sn[1] + 32'd1;
            if (core.u_l1d.x_wr) st_sn[2] <= st_sn[2] + 32'd1;
            if (core.u_l1i.x_wr) st_sn[3] <= st_sn[3] + 32'd1;
            if (core.l2_x_done && core.l2_x_dirty || core.l1d_x_done && core.l1d_x_dirty) st_sn[4] <= st_sn[4] + 32'd1;
            if (hw_valid && hw_take) st_sn[5] <= st_sn[5] + 32'd1;
            if (core.hw_kill) st_sn[6] <= st_sn[6] + 32'd1;
            if (mem_req && mem_ready) begin
                if (mem_we) st_wb <= st_wb + 32'd1;
                else st_miss <= st_miss + 32'd1;
            end
`ifndef S3_BUS
            sc_done <= sc_req && sc_ready;
            if (sc_req && sc_ready)
                for (int b = 0; b < 4; b++) begin
                    if (!sc_status[0]) sc_rdata[8*b +: 8] <= mem[22'({sc_addr, 2'(b)})];
                    else if (sc_be[b]) mem[22'({sc_addr, 2'(b)})] <= sc_wdata[8*b +: 8];
                end
            if (mem_rvalid) rd_pend <= 1'b0;
            else if (rd_pend) rd_cnt <= rd_cnt - 1;
            if (hw_valid)
                for (int i = 0; i < 32; i++) mem[22'({core.hw_line, 5'd0} + 32'(i))] <= hw_data[8*i +: 8];
            if (mem_req && mem_ready) begin
                if (mem_we) begin
                    for (int i = 0; i < 32; i++) mem[22'({mem_addr, 5'd0} + 32'(i))] <= mem_wdata[8*i +: 8];
                end else begin
                    rd_pend <= 1'b1;
                    rd_cnt <= mem_lat - 1;
                    rd_line <= mem_addr;
                end
            end
`endif
            for (int k = 0; k < 3; k++)
                if (ret_valid[k]) begin
                    if (ret_wdst[k] && ret_dst[k] < 4'd8) r[ret_dst[k][2:0]] = ret_value[k];
                    if (ret_wflags[k]) f = ret_flags[k];
                    if (ret_eop[k] && core.rob[core.rob_head + 5'(k)].kind != K_HLT
                        && core.rob[core.rob_head + 5'(k)].kind != K_ILL) begin
                        $fdisplay(trace, "%08x %08x %08x %08x %08x %08x %08x %08x %08x %08x",
                                  ret_next_eip[k], r[0], r[1], r[2], r[3], r[4], r[5], r[6], r[7],
                                  eflags(f));
                        done = done + 32'd1;
                    end
                end
            regs <= r;
            flags <= f;
            insns <= done;
        end
    end

    final begin
        $fclose(trace);
        if (stats)
            $display("stats: per cycle: extracted 0/1/2/3 %0d %0d %0d %0d (output free), renamed 0/1/2/3 %0d %0d %0d %0d",
                     st_x[0], st_x[1], st_x[2], st_x[3], st_rn[0], st_rn[1], st_rn[2], st_rn[3]);
        if (stats)
            $display("stats: retire 0: ROB empty %0d, head waits %0d; uop queue empty %0d; decode redirects %0d; flushes %0d",
                     st_empty, st_wait, st_uq_empty, st_dec_redir, st_flush);
        if (stats)
            $display("stats: head waits by kind: ALU %0d LD %0d ST %0d BR %0d MD %0d",
                     st_wait_kind[K_ALU], st_wait_kind[K_LD], st_wait_kind[K_ST], st_wait_kind[K_BR], st_wait_kind[K_MD]);
        if (stats)
            $display("stats: decode redirects: taken not followed %0d, falsely taken %0d, target %0d, cut %0d",
                     st_dr[0], st_dr[1], st_dr[2], st_dr[3]);
        if (stats)
            $display("stats: flushing branch result -> retire %0d cycles, flush -> next retire %0d cycles",
                     st_mp_wait, st_refill);
        if (stats)
            $display("stats: issue: ALU ready on one port only (>= 2) %0d, >= 3 ALU ready on both %0d, >= 2 memory ready %0d; memory replays %0d (mul/div bus %0d)",
                     st_skew, st_alu3, st_mem2, st_replay, st_replay_md);
        if (stats)
            $display("stats: misses: L1I %0d, L1D %0d (writebacks %0d), L2 %0d (writebacks %0d; memory read latency %0d)",
                     st_imiss, st_dmiss, st_dwb, st_miss, st_wb, mem_lat);
        if (stats)
            $display("stats: snoops %0d: invalidated L2 %0d, L1D %0d, L1I %0d; dirty kept %0d; HITM# %0d (INV %0d)",
                     st_sn[0], st_sn[1], st_sn[2], st_sn[3], st_sn[4], st_sn[5], st_sn[6]);
        if (stats)
            $display("stats: flushes: Jcc %0d, indirect %0d, RET %0d, other branch %0d, DF %0d, store to code %0d",
                     st_fl[0], st_fl[1], st_fl[2], st_fl[3], st_fl[4], st_fl[5]);
    end
endmodule
