alphaonex86/FPGA-CPU/hw/tools/gen_c2cart_s6.py

#!/usr/bin/env python3
"""Dedicated C2 cartridges (plan/slot1_c2.md D33/D35/D37, D34): label-wired
schematic + netlist, the S6 step of hw/slot1-cyclonev for these boards.

Usage: python3 hw/tools/gen_c2cart_s6.py [c2cart|c2pcie]   (default: both)
Input: hw/slot1-<board>/pins.csv (gen_c2cart_assign.py).
Output in hw/slot1-<board>/: slot1-<board>.kicad_sch, .net, .erc.json,
pdn.csv (every passive + regulator, for the placement step), project.

c2cart: U1 5CEBA4/A9 F484 (A9 symbol; the A4's VCCIO2A/VCCPD1A2A balls,
NC on the A9, on VCCIO33), J5 the D32 link. c2pcie: U1 Cyclone V GX F484
(C5 symbol), J6 OCuLink 4i endpoint (TX through 0.1 uF, REFCLK DC as HCSL
allows, PERST# 10k to GND, CPRSNT# grounded), VCCE/VCCL_GXBL and
VCCH_GXBL from VCC and VCC_AUX through beads [pcg-01014 GX Example 1].
Both: U2 the SC242 contacts, U3-U9 SN74GTL16612 (pins.csv
chip order), U10-U11 SN74CB3T3245, U12 CY2309 (BCLK -> each 16612's
CLKAB = CLKBA through 22 R; CLKOUT loaded like one chip), U13 EPCQ128A
(AS x1). Nets: bus A side = signal, B side = S_<signal> = contact; TX A
side = TX_<signal>; RX balls straight on S_<signal>; every AGTL+ contact
but RESET# 56 R to VTT15 (4-resistor packs).
Audit (exit 1): every pins.csv net reaches its ball, chip pins and
contact; chip clocks, AS flash, VREFs; Cyclone V supply bands; ERC 0.
"""
import csv
import pathlib
import re
import sys

sys.path.insert(0, str(pathlib.Path(__file__).resolve().parent))
import gen_t6_schematic as t6
import pdn
from pdn import C0402, C0603, C0805, C1210, CPAIR, R0402, Parts, buck54620, buck62130, farads, u1_pairs

ROOT = t6.ROOT
CPUSYM = ROOT / "sockets/kicad/CPU_SC242.kicad_sym"
PARTS = ROOT / "hw/lib/Slot1_Parts.kicad_sym"
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
