alphaonex86/FPGA-CPU/(commit log)

2026-10-18 Add project README, rules, FPGA survey and doc fetcher
    - README.md and AGENTS.md: goals, target boards, requirements.
    - FPGAlist/: FPGA survey (top 5, toolchain limits, I/O and power
    budgets); selected Cyclone V E A9 and Efinix Ti180 G400.
    - fetch.sh + sources.txt: re-download vendor docs and CPU datasheets
    (not versioned: copyright and size).
2026-10-31 Add interposer plans, KiCad generators and Slot 1 board with power tree
    - plan/: interposer boards, Slot 1 plan (S0-S10), base core evaluation
    - hw/tools: generated Slot 1 chain S6 schematic -> S7 placement -> S8a nets
    -> S8b 8-layer planes/stitching -> S8c DDR3 router -> S9 gates; Socket 3 /
    370 / 7 schematic generators; shared libs in hw/lib, pin maps in hw/common
    - Slot 1 D23: TPS54620/TPS62130 power tree and all decoupling placed,
    Cyclone V power-up order per cvhb Fig 10-3, inductor ratings checked in
    code, real MT41K512M16HA 0.8 mm ball map, parts on both sides (D16/D25)
    - sockets/kicad: socket footprints, symbols, 3D models
    - .gitignore: vendor docs fetched by fetch.sh, KiCad .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
2026-10-31 gitignore: exclude only the vendor docs under sockets/slot1
2026-10-31 Track the operator's board photos, BIOS dumps and cpuinfo
    gitignore excludes only the vendor PDFs under sockets/socket*/.
2026-11-01 Slot 1: S8c rerun on the real 0.8 mm die land, mirrored B-side texts
    - S7: B.Fab texts mirrored on B-side parts (199 DRC warnings gone)
    - board: S7 -> S9 chain rerun twice, identical: 133/184 DDR3 die jobs,
    ERC 0, DRC 0, BOM 278 == PCB 278, 499 unconnected
    - plan/slot1.md: second D23 pass results and the cause of the drop from
    160 (that count was routed on the wrong 1.0 mm mirrored ball map)
2026-11-01 All interposers at T6, Slot 1 keep-best router, Socket 3 FPGAmotherboard compat
    - Slot 1: S8c keeps the best rip-up pass (141/184 DDR3 jobs, DRC 0);
    S9 reads the real unconnected count (kicad-cli caps it at 499);
    S8a/S8b guards against stale inputs; B-side via clearance and mirrored
    texts in S7.
    - D9: Ti180 dropped on Socket 3 / Socket 7 (I/O voltage, translator delay).
    - Shared power tree builder hw/tools/pdn.py; socket3-cyclonev power tree +
    decoupling drawn at T6; socket7-cyclonev T6 schematic; Cyclone V
    power-up order per cvhb Fig 10-3 on every Cyclone V variant.
    - Socket 3 on the FPGAmotherboard board: S4 tied to VSS, CB3T OE# from a
    TLV6700 VCORE-present detector (VCORE_OK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
2026-11-01 RTL back-end evaluation on 5CEFA9; Socket 3 RESET pull-down 100k
    - rtl/tools/gen_vexii.sh builds the VexiiRiscv configurations,
    synth_cv.sh compiles one core alone in Quartus (every port but clk
    virtual) and prints ALMs / RAM / DSP / fmax; setup.sh also fetches rvls.
    - plan/cpu_core.md step 1 done: dual-issue RV64IMAC 12,932 ALMs 60.7 MHz,
    with F/D 16,879 ALMs 52.0 MHz (slow 85 C model).
    - socket3-cyclonev: C16 RESET pull-down 4k7 -> 100k, the FPGAmotherboard
    holds RESET asserted with only 8.2k to VCORE during the ramp.
2026-11-01 D10: Efinix prohibited (efinixinc.com blocked from Bolivia, no free flow)
    The Ti180 and socket370-ti180 are dropped; Cyclone V is the only FPGA.
2026-11-01 Requirement: on-board flash for bitstream plus BIOS/UEFI/option ROMs
2026-11-01 Flash: MT25QL01G fitted, MT25QL256 fallback on one SOIC-16 footprint
2026-11-01 socket7: VCCIO/VCCPD/VCCPGM on VCCIO33 behind a load switch enabled by the core PGOOD
    Keeps the Cyclone V group 1 -> group 2 order on the board's VCC3; T6 ERC 0,
    audit 166/166; power.md records the switch class and hot-socket limits.
2026-11-01 Drop socket370-ti180 files and generator branches (D10); base decision C0; no load switch on S370
    C0: VexiiRiscv back end + own x86 front end, z486 only as reference/tests.
    socket370-cyclonev regenerated: netlist identical (543 nets), ERC 0.
2026-11-01 cpu_core E1: DE25-Nano + multiplexer adapter analysis per socket
2026-11-01 Decisions C5 (develop on the DE25-Nano first) and D11 (socket3-de25mux adapter)
2026-11-01 cpu_core E1: DE25-Standard I/O vs each socket (S7 plausible on HSMC, S370 no)
2026-11-01 Decision D12: socket7-de25std adapter for a DE25-Standard
2026-11-01 rtl/tools: DEVICE selects Cyclone V (Lite) or Agilex 5 (Pro, DE25-Nano); clk-only-pin check
2026-11-01 X1: Unicorn trace checker, x86_test.sh and the first subset test
    x86_trace_check replays the image one instruction at a time and stops at
    the first GPR/EIP/EFLAGS mismatch; verified on its own trace, a corrupted
    line and a short trace.
2026-11-01 Slot 1: D26 study variants A/B/C1/C2, D27 66 MHz FSB allowed on Slot 1 / Socket 370
2026-11-01 Slot 1 variants study: A kept, B research (translation time only), C1 discarded, C2 best; D28 slower devices accepted
    DMA mirror via P6 snoop stall + implicit writeback, verified in the
    440BX / VT82C694T / Pentium Pro manuals; 66 MHz DE25-Standard pin budget.
2026-11-01 Slot 1: D29 C2 bench hardware, D30 DE25-Nano for the B measurement; C2 FPGA board options, E->GX migration illegal
2026-11-01 Slot 1 C2 bench board filter (Puzhi / ALINX XC7A200T, Vivado download works); x86 M8: Socket 3 STPCLK# Stop Grant contract
2026-11-01 M1 done: x86_predecode 16 starts/cycle at 101 MHz on 5CEFA9 (3,793 ALMs)
    x86_opdecode (length from the opcode, per address/operand size) shared by
    the objdump-checked x86_len_decode reference and the 2-stage predecode;
    predecode_check.sv proves equal on biased random blocks. synth_cv.sh takes
    SystemVerilog and extra source files. S370 FPGAmotherboard DMA snoop gap
    noted for the DMA mirror.
2026-11-01 slot1_variants: S370 FPGAmotherboard DMA snoop generator scheduled
2026-11-01 x86 M2: Quartus-parsable (no inside, positional block push), synth harness, plan notes; S370 DMA snoop generator landed (FPGAcommon cdd16c2)
2026-11-01 slot1_variants: FPGAmotherboard snoop stall unbounded, tested (FPGAcommon a0e2176)
2026-11-01 x86 M2: rename (R) and dispatch (D) stages, RS budget flag; 300/300 random match
2026-11-01 x86 M2: M-stage load check no longer short-circuited (m_fwd/m_fdata latches found by Quartus Pro)
2026-11-01 x86 M2: D stalls on a full RS instead of R's budget flag (removes the uq -> rs_free3 path, 56.5 MHz before)
2026-11-01 x86 M2: MUL/IMUL/DIV/IDIV on port 3 (x86_muldiv, in-order issue), P stage after decode (redirect off the decode path), CS/DS/ES/SS prefixes, C tests (gcc -O2 c1_mix: 23,879 instructions match); 2000/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
2026-11-01 x86 M2: SHLD/SHRD (ALU third operand), mul/div results share the memory result bus (3 capture buses), C test c2_core (switch table, 64-bit); 2000/2000 random match
2026-11-01 x86 M2: early wakeup on result bus 2 and at dispatch (IPC c1 0.86, c2 0.96), RET target from the pre-group stack top (parallel P compares), core_tb +stats; Vivado 2025.2 verified for XC7A200T + PCIe 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
2026-11-01 x86 M2: core_tb +stats classifies decode redirects (c1: 542 not followed, 345 falsely taken: BTB / gshare direction thrash, not capacity)
2026-11-02 x86 M2: P mismatches precomputed at the load (direction only selects), TAGE queue writes at positions fixed by the Jcc slots (timing; same cycles)
2026-11-02 x86 M3: stores to code: a store snoops the L1I at its address and is flagged; its instruction retires, the pipeline flushes and fetch waits for the drain (which invalidates the L1I set); an L1I miss 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
2026-11-02 Slot 1 C2: VMM v0 on KVM (sw/c2-vmm: one vCPU, guest RAM, BIOS ROM read over the bus into read-only memslots, I/O and MMIO exits as bus cycles, INTR/INTA injection, P-III CPUID), BAR0 bridge protocol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
2026-11-02 Slot 1 C2: VMM 440BX shadow RAM (PAM tracked from config writes, memslots per segment), test ROM covers BIOS self-shadowing; viability: KVM exit 4.7 us I/O / 5.8 us MMIO measured, rep insw batched, p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
2026-11-02 Slot 1 D31: C2 without single-source parts (any VT-x/AMD-V PC, generic FPGA PCIe card, cable link to the variant A cartridge)
2026-11-02 Slot 1 D32: C2 link header on the 19 balls of host signals no D8 chipset uses (+3 free), 0-ohm selection keeps the translators; C2 bench board purchase from Alibaba
2026-11-02 Slot 1 C2: cable link v0 spec (18 x 3.3 V lines, 2x20 header with ground interleave, 50 MB/s each way, access / framebuffer / DMA-mirror budgets); PCB task for D32
2026-11-02 plan: C2 bench board purchase from AliExpress (preferred) or Alibaba
2026-11-02 Slot 1 C2: string I/O as one bridge REP command (4 KB BAR window), sim + fpga backends, PAM tracking also on string writes; test ROM checks rep outsb / rep insw
2026-11-02 Slot 1 C2: J5 follows the ALINX 40-pin header order (signals on odd pins, grounds between, no supply across); card candidates AX7A035B / PZ-A735T-KFB (XC7A35T is enough)
2026-11-02 C2 card: ALINX AX7A035B J11 pinout from its manual (bank 16, 33 ohm, MRCC for the up clock), J5 fixed to 18 signals (odd 3-35 + 36), purchase notes in FPGAlist/c2_cards
2026-11-02 C2 cards: drop the AX7035B manual (other board, no PCIe) from sources
2026-11-02 C2 card documents versioned offline (AX7A035B manual, XC7A35T pin file, Puzhi guides); rule: every document kept offline, links only as provenance
2026-11-02 C2 card bitstream for the AX7A035B: top (PCIe IP, MMCM link clock, J11 link I/O, LEDs), XDC, build.tcl (trim and timing checks; with a ROM the LOOPBACK variant: cartridge + c2_loop_target + UART insi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
2026-11-02 C2 cartridge P6 bus agent v0 (c2_p6_agent: uncached memory / I/O / INTA transactions as agent 0, BREQ0# parking, BPRI#, BNR# stall protocol, in-order queue tracking, Retry); test_rtl.sh runs the test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
2026-11-02 C2: c2_bus_sync (bus port from the link clock to BCLK, toggle handshake each way); P6 sim runs the agent and p6_bif on a separate 14 ns BCLK; plan: J5 1.27 mm SMD header and its cable, P6 crossing do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
2026-11-02 C2: board reset to the VMM: RESET# and the A6# strap cross to the link clock (c2_bus_sync), cartridge status message carries them (resent every 2^16 clocks), STATUS bits 3/4; the agent fails requests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
2026-11-02 C2: CMOS pins and Special Transactions: A20M#/STPCLK# levels and NMI/INIT#/SMI# edges cross BCLK -> link (c2_bus_sync, edges stretched 7 BCLKs), cartridge pin/event messages 0x50/0x60, STATUS bits 5-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
2026-11-02 C2 cartridge bitstream + link reset; plan: AGTL+ low level (NM45), control pin split (NM46), D33-D36
    Cartridge top for the variant A PCB (rtl/c2/cyclonev): c2_cart on the
    received link clock (M8), c2_bus_sync, c2_p6_agent on BCLK through a
    normal-mode PLL (c2_bclk_pll: the raw pin -> I/O register clock path is
    ~5 ns). gen_qsf.py builds the QSF from pins.csv and the J5 table; every
    P6 flop sits in an I/O cell (agent without synchronous controls so it
    packs); open-drain drive 16 mA LVTTL / SSTL-135 series 34 ohm, no RZQ.
    SDC constrains the P6 pins to the Pentium II edge-finger timing through
    the pass-gate and cartridge traces. BCLK 66 MHz (D27): at 100/133 MHz
    the one-clock reactions cross the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
2026-11-02 hw: 3D models for every slot1-cyclonev footprint
    models3d.py maps each footprint to a KiCad stock model copied into
    hw/lib/3dmodels (rotation/offset checked with kicad-cli pcb render: KiCad
    turns positive z clockwise; BGA A1, header and J5 grids match the pads);
    gen_lib.py and gen_slot1_s7.py emit them (regenerated libs identical),
    models3d.py <board> adds them to a routed board. gen_lib: courtyard layer
    F.CrtYd (F.Courtyard does not load in a bare board). plan NM47: the
    translator TSSOP-20 and VTT tracker land patterns are placeholders.
2026-11-02 C2: GTL+ transceiver direction control (D35) and the dedicated cartridge ball map (D33)
    c2_p6_agent: address group (A#, REQ#) and data group (D#) directions for
    SN74GTL16612 transceivers: OEAB one BCLK after the FPGA takes the LVTTL
    side and one BCLK before it lets go (no contention); ADS# waits one clock
    (PREP, BPRI#/BNR# rechecked), a write's data group turns at clock B, DRDY#
    waits for OEAB. test_rtl.sh p6gtl models the transceivers and flags a
    drive without OEAB or a bad order (p6_err[9]); 4 backends PASS, 4
    mutations fail p6gtl. Variant A bitstream: bclk slack +0.57 ns.
    plan/slot1_c2.md: D33/D35 design (8 x 16612: ADDR 2, DATA 4, RX, TX; ADS#
    DRDY# DBSY# BR0# BNR# HIT# HITM# drive via T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
2026-11-02 Slot 1 variant A: S7 -> S9 rerun with the D32 link parts and 3D models (S8c 141/184, DRC 0, ERC 0, BOM 296 == PCB 296)
2026-11-02 C2 dedicated cartridge (D33/D37): RX straight onto an SSTL-18 bank, clocked 16612 D# receive via a CY2309 zero-delay buffer, AB_LE mode pin
    - c2_cart_core.sv split out of c2_cart_top.sv; c2_cart_gtl_top.sv + .sdc for the
    dedicated PCB (build.sh <a|c2cart>); the SDC checks the transceiver clock
    against the P6 bus windows
    - c2_p6_agent: D_CLOCKED (read data one BCLK after DRDY#), clk_in for the
    input registers, OEAB/dir held one BCLK after the last drive
    - p6gtl sim: D# through the transceiver register, OEAB required in the clock
    after a drive; all four backends PASS, D_CLOCKED=0 hangs p6gtl, the old
    OEAB timing fails it (0x200)
    - gen_c2cart_assign: RX on bank 3A, AB_LE; symbols SN74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
2026-11-02 C2 cartridge (D33) schematic + netlist: gen_c2cart_s6.py (7x 16612, CB3T, CY2309, EPCQ128A, 56 R packs, power tree), audit + ERC 0; NM48 variant A RREF_TL
2026-11-02 C2 cartridge (D33) placement: gen_c2cart_s7.py (chip band in ball order, B.Cu termination row at the contacts, caps under pins), 254 footprints, DRC 0
2026-11-02 D34 groundwork: Cyclone V GX F484 pin tables + PCIe user guide, SFF-9402 OCuLink pinout, DE25-Standard manual (offline sources); plan: D34 pin and lane facts
2026-11-02 C2 cartridge with its own PCIe (D34): Cyclone V GX F484 + OCuLink 4i board from the D33 tools
    gen_c2cart_assign/s6/s7.py take the board name (c2cart | c2pcie): GX common-IO
    pin map with PCIe x4 on GXB L0-L3 + REFCLK0L + nPERSTL1, GXB supplies through
    beads, SFF-8612 J6 footprint (hole clearance relaxed for J6 only, per spec),
    Filler placement; c2pcie audit OK, ERC 0, 275 footprints, DRC 0. c2cart
    regenerated (deterministic termination order), DRC 0.
2026-11-02 C2 card: AX7A035B re-check before purchase (manual vs XDC, host slot facts)
2026-11-02 C2 SoM cartridge (D38): AC7A035 SoM on a Slot 1 carrier, PCIe x4 by OCuLink; SoM connector, IO and land-pattern facts, Panasonic P5K catalog offline
2026-11-02 C2 Artix cartridge (D39, replaces D38): XC7A100T-2FGG484I on the Slot 1 cartridge, PCIe x4 by OCuLink, one JLCPCB order; XC7A100T FGG484 package file offline
2026-11-02 D39: XC7A100T FGG484 pin CSV (Xilinx package-file parser, 285 user I/O = DS180 Table 5), KiCad symbol + BGA footprint (0.45 mm lands, UG475 Table A-1) + 3D model
2026-11-02 D39 plan: PCIe lane -> GTP pin map checked in Vivado (lane k on X0Y(7-k), refclk F10/E10), bank and power plan for the XC7A100T cartridge
2026-11-02 C2 Mu cartridge (D40): no external PC; LattePanda Mu (N305 16 GB preferred) on a SO-DIMM 260 socket, PCIe x4 (HSIO8-11, REFCLK2, PLT_RST#) on board to the XC7A100T; Mu pinout, KiCad library, mechanic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
2026-11-04 Mu cartridge viability: Mu + socket need 65.4 mm (cartridge PCB to ~75 mm), 26.8 mm thick with cooler (< 32.8 mm envelope), FPGA fits under the module; LOTES 9.2H socket at LCSC; PCIe/power-on/power 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
2026-11-04 plan: Mu cartridge power budget ~30 W (viability.md)
2026-11-04 Mu viability: operator decisions (75 mm PCB accepted, N305 16 GB + FIT0981, Lite carrier for bring-up)
2026-11-05 C2 Mu cartridge: XC7A100T bitstream meets timing, schematic + ERC 0
    - rtl: c2mu_top (Mu PCIe x4 Gen1 -> c2_pcie_bridge -> c2_card -> c2_cart_core
    -> P6 agent), MMCM phases 54/258 deg balance the P6 pin paths (WNS +0.155,
    WHS +0.052 ns, 1.0 W); c2_pcie_bridge shared with the AX7A035B build
    (rebuilt, WNS +0.52 ns); agent registers raw pin levels (IOB packing).
    - hw/slot1-c2mu: pins.csv, schematic, netlist audit, ERC 0 (gen_c2mu_s6.py).
    - Mu edge symbol from the vendor xlsx (gen_mu_sym.py): the vendor KiCad
    symbol numbering does not match the pinout table.
    - GTP rails on TPS74801 (bias LDO): TLV757P needs VIN >= 2.4 V there.
    - FT232H on Mu USB2 port 2 as on-board JTAG; SPI flash MX25L12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
2026-11-05 C2 Mu cartridge: placement (S7), DRC 0; Mu socket footprint
    - gen_c2mu_s7.py (pcbnew API): 313 footprints with nets on 127 x 75 mm, 6
    layers; Mu socket on the top edge (180 deg), tall / user parts in the free
    column, band split around the Mu standoffs, TX chip at U1's TX balls, PCIe
    AC caps 3-6.4 mm from the receivers with a free lane corridor, B.Cu
    terminations / via-pair caps; stock 3D models copied offline.
    - gen_mu_lib.py (was gen_mu_sym.py): LOTES ADDR0110 9.2H footprint (hold-down
    pads at +-37.75 per AP-ADDR0110 detail H), socket-body courtyard, vendor
    module STEP as .stpZ.
    - Schematic: PS2 TPS62130 (VCCINT 0.15 A), 9-pin USB header with Mu ports
    1 and 3, cabled CMOS cell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
2026-11-05 C2 Mu cartridge: LCSC-stocked parts, SMT M2 6.6 mm standoffs, plane fanout, JLC BOM/CPL step
    Parts swapped for JLCPCB/LCSC stock (2026-11-04): W25Q128JVSIQ flash,
    SX2M 50 MHz oscillator (same 2520 pinout), Changjiang FXL1040-6R8 for PS1
    (9.6 A sat), YC124 56R arrays, TS-1187A switch, T520D 330 uF/6.3 V; C1 is
    now a 100 uF/25 V electrolytic on V12 (hot-plug damping: ceramics alone ring
    past the TPS54620 17 V max). Mu standoffs: Sinhoo SMTSO2066CTJ (M2, 6.6 mm),
    reflowed by JLCPCB, own footprint. U1's ball field is reserved on B.Cu
    (every ball gets a via in pad). S8: plane fanout + pre-route DRC gate, the
    FPGAcommon freerouting fork (headless, no network, board hole clearance).
    S9: DRC gate, J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
2026-11-05 C2 Mu S8: no keepouts from footprint-only rule areas, no vias on unused U1 balls; S9 order options; plan D40 status
    KiCad's Specctra export turns every rule area into a copper keepout: the
    cavity and retention bands (footprints only) walled the gold fingers off the
    board, so freerouting left most of the bus unrouted. They are removed for the
    export only. Unused IO balls (single-pad nets) no longer get a via in pad:
    136 vias blocking the escape channels. Flash: W25Q128JVSIQ has QE fixed at 1.
2026-11-05 C2 Mu S8: VTT15 strip on In3, array common rows via past the row end; S7: VTT decoupling at the termination row, passives anchored on the shared-net pin; standoff ring 4.3 on inner/B
2026-11-05 C2 Mu ball map: banks 34/35 at 3.3 V join, 6 mm per ring of depth in the matching
    All 3.3 V nets sat in the top half, up to 9 rings deep: the 3 signal layers
    could not escape them (129 left open after freerouting + close_route).
    Now every net is at most 3 rings deep, entering from all four sides.
    Bitstream rebuilt: WNS +0.245 / WHS +0.052 ns. S6 ERC 0, audit OK.
2026-11-05 C2 Mu S7/S8: terminations turned to face the fingers with their own fanout vias; close_route.py
    - s7: RN arrays at 270 deg, a 1.9 mm strip above each kept free for its vias.
    - s8 chip_fanout also fans out the RN signal pads (3 staggered via rows; the
    first is often taken by the chip pins on F.Cu): 123 of 137 now have a via.
    A pad between two array pads and the VTT row has one free side, and the router
    left it boxed in by the chip vias.
    - close_route.py: a windowed A* (F / In2 / B, net-class clearances, hole rules,
    keepouts) for the connections freerouting stalls on. s8 runs it when an
    iteration does not improve, and drops router copper that is in a DRC error
    after each step.
    Unro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
2026-11-05 C2 Mu: placed board (S7, DRC 0) on the new ball map with turned terminations; S8 runs close_route after every freerouting round
    On the t1 trial, close_route closed 35 of 113 open pairs (123 -> 88 unrouted, nothing dropped).
    Routing is paused until everything else is verified.
2026-11-05 C2 Mu: transceiver channels by least finger-to-B-pin length (crossings inside a chip 206 -> 0); routing is the last step
    Channel order followed the finger x order, which crosses every line of the
    fingers left of a chip's B column. Now each chip's channels come from a least
    total length matching (the same crossing-free principle as the ball map,
    least_length() shared). Left over: 7 TX lines past ADDR1 and 11 RX lines
    between the ADDR fingers (Slot 1 pinout geometry: a layer change each).
    Bitstream: WNS +0.150 / WHS +0.052 ns. S6 ERC 0 + audit, S7 DRC 0.
    AGENTS.md: routing is the last step, pins final first (operator).
2026-11-05 C2 Mu: 8 layers, JLCPCB JLC08161H-2116 (operator)
    F sig, In1 GND, In2 sig, In3 VCC_3V3 + VTT15 strip, In4 GND + V5 strip,
    In5 sig, In6 GND, B sig: 4 signal layers, each next to a plane. The outer
    prepreg stays 2116-class (0.116 mm), so PCIe 0.2 mm is ~47 ohm. close_route
    routes on F / In2 / In5 / B; the S9 order and the Gerber list follow. Stack
    data in sockets/sources.txt (fetch.sh). Pre-route DRC 0.
2026-11-05 C2 Mu: 8-layer board, routing in progress: 51 unrouted, DRC 0 violations
    Freerouting alternating with close_route: 767 -> 172 -> 76 -> 56 -> 51.
    Still open: V5 power tracks, the N halves of 6 PCIe pairs, some JTAG / bus nets.
2026-11-05 Socket 3: MT25QL01G AS x4 flash U4 (MSEL 10011, Quartus config scheme), footprints on every instance, PS header removed
2026-11-05 Socket 3 T7: U1 north of the pin ring, translators in columns beside it (operator); T5 pin map by least total length on that layout (0 crossings); placer.py shared with C2 Mu S7
    C2 Mu: V5 areas on In4 for the loads outside the band strip, PCIe AC capacitors turned to face their anchor, s8 runs serial + parallel freerouting variants and keeps the best session.
2026-11-05 Socket 3 T7: 3D view checked (J3 opening north, lever band free)
2026-11-05 PDN: refuse a TPS62130 rail over its lab-stable 400 uF (SLVA463A); C2 Mu VCC_1V0 330 uF tantalum -> second 100 uF 1210 (485 -> 255 uF)
    TLV62585 and TPS22918 datasheets added for the Socket 7 power tree.
2026-11-05 Socket 7 T6: power tree (TLV62585 core buck on VCC2, TLV75725 aux LDO + TPS22918 VCCIO33 switch on VCC3, PG to VCC_1V1), AS x4 flash as socket 3, footprints
    Socket3_Parts -> Socket_Parts (shared with socket 7); AS x4 .qsf lines in assign_common.
    Socket 3 regenerated: placement identical.
2026-11-05 Socket 7 T5+T7: U1 in the centre of the PGA296 base, pin map by least total length on that layout (CLK 1 crossing); power, flash, JTAG in the south band; DRC 0
    placed()/pads()/ring_depth() moved to placer.py (socket 3 output unchanged).
2026-11-05 plan: C2 Mu carries the DMA mirror signals (request-phase snoop in, HIT#/HITM#/DRDY#/DBSY# out, D# both ways)
2026-11-05 C2 Mu: routing run with the router variants (best of 4 per round): 148 -> 27 unrouted in 8 rounds, DRC 0 errors; PCIe pairs not usable yet (freerouting routes P and N apart: worst mismatch 43.6 mm)
2026-11-05 C2 Mu: PCIe pairs from a code template (c2mu_pcie.py): coupled 0.2/0.2 mm F/B tracks, AC caps placed on the template (TX at U1, RX/REFCLK at J4), 45 deg length tuning, P/N skew 0.000 mm on all 9 pair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
2026-11-05 autoroute.py: the generic routing steps of gen_c2mu_s8.py (planes, via in pad, plane fanout, freerouting runs, close_route turns, DRC) as a shared module for the socket T8 boards; close_route takes t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
2026-11-05 Socket 3 / socket 7: 6 layers (operator: JLC06161H-2116, In2 VCC_1V1 whole, In3 split rails); T8 scripts on autoroute.py, pre-route DRC 0 on both
2026-11-05 jlcfab.py: the JLCPCB fab steps of gen_c2mu_s9.py (DRC gate, BOM, CPL, Gerbers from the board's copper layers, live stock) shared with the socket T9 scripts. Checked: identical BOM, CPL and Gerbers (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
2026-11-05 Socket 3 / socket 7 T9: gen_socket_t9.py (jlcfab.py), LCSC numbers for every part checked on live JLCPCB stock for 2 boards (FPGA consigned: JLCPCB stock 0); socket 3 PS1 inductor MSS1048-682 -> FXL1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
2026-11-05 Socket 7: 8 layers (operator: JLC08161H-2116, 4 signal layers for U1 rings 5-7; on 2 signal layers 61 connections stayed open), T8 planes In3 VCC_1V1 / In4 split rails; T9 order per socket
2026-11-05 Socket 3 / socket 7: VCC_AUX25 and VCCA_FPLL25 in an AUX net class (0.25 mm, 0.1 mm): 0.4 mm PWR tracks cannot pass between U1's 1.0 mm ball vias (12 connections never routed)
2026-11-05 autoroute.settle: count open connections from the DRC report (the in-memory connectivity lagged after close_route: 40 against DRC's 4 on socket 7)
2026-11-05 Socket 7 T8: the S_VCC2 / S_VCC3 split steps (x 31.25 on the south pin row, 28.73 on the north: A19 at x 30.0 is VCC3)
2026-11-05 route_search.py: long routing search (operator: several systems, 5 days max): freerouting rounds with 5-100 passes, serial + parallel fork + a layer-cost variant per signal layer, DRC clean-up and cl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
2026-11-06 Socket 3: 8 layers (operator: JLC08161H-2116; on 2 signal layers ~100 socket legs stayed open); autoroute drops dangling router copper every round and the unused ball vias once complete; plan: U1 hea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
2026-11-07 autoroute: freerouting runs gated to SLOTS per PC (RAM / (heap + 2 GB), 12 here) across every running search (a run's RSS ~7.5 GB; socket 3 + socket 7 + C2 Mu searches would start 18); route_search s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
2026-11-09 Routing (operator 2026-11-08): DSN planes as poured (KiCad exports bare zone outlines: freerouting took cut-out areas as the lower zone's copper and never routed V3V3 / VCCIO33 pads there: the stalle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
2026-11-09 Routing setup faults behind the 3 / 4 open left by all 7 routers: plane_vias placed plane vias inside higher-priority cut-outs (on_plane checked the bare rectangle); a plane net in two islands on a l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
2026-11-11 Routing chain: route_search.py by rounds (several tools, 5 days each at most, 4 CPUs for the whole claude-route.slice, boards one after the other), state saved each round and resumed after a restart,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
2026-11-11 check_board.py: the board's pad nets against the schematic netlist and against the vendor pin tables read again from the PDFs (DX4 Table 6, Pentium II Table 35, CB3T3245 / GTL16612 pin-outs, LattePan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
2026-11-11 Socket 3 bus unit (M8 v0): rtl/s3/s3_bus.sv, the 486 local bus as a master behind the core's line port (bursts from offset 0, RDY# / BRDY#, BOFF#, HOLD / HLDA, AHOLD + EADS# snoop out, Stop Grant, pa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
2026-11-11 Fab rules DRC did not hold (JLCPCB capabilities, kept offline): copper to the routed outline was 0.001 mm (the Slot 1 fingers' floor) and copper to a plated component hole 0.2 mm (JLCPCB: 0.28 mm min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
2026-11-11 plan: routing chain, fab rules, board checks and Socket 3 bus unit status; AGENTS: routing service, 4-CPU rule; s3 outputs 12 mA fast, simulation outputs in build/s3sim
2026-11-11 Generated copper: no sliver gap to copper of its own net (joined or >= 0.1 mm apart); plane continuity checked on the real fills after the vias cut them (plane_islands: a net's zones of a layer unite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
2026-11-11 check_board: every regulator's output recomputed from its feedback divider (socket 3: 4.98 / 1.099 / 2.52 / 3.33 V; C2 Mu: 4.98 / 0.999 / 1.79 / 3.33 / 1.000 / 1.199 V); KiCadRoutingTools as a routin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
2026-11-11 Socket 3: the 486 bus timing closed against the FPGA. The first Quartus build on the board's pins missed the 486's 14 ns by 3-11 ns on the pin -> logic -> pin paths (BLAST# of a burst's last transfer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
2026-11-11 plan: socket 3 pin group for the bus timing, routing tools, fab package and regulator checks; T8 --finish: bus copper within 50 mm of CLK
2026-11-11 KiCad lock file out of the tree (committed by mistake), ignored
2026-11-11 Routing: the router asked for 3 um more than each clearance (its copper landed a fraction of a micrometre short for the DRC: ~24 tracks dropped a round), the dropped copper's error types logged; a co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
2026-11-11 s3_top: the PLL resets itself after 2^16 pin clocks without lock (clock stopped or changed); its lock and reset out of the timing analysis
2026-11-11 Socket 3: the CPU's internal pulls on the interposer (DX4 Table 12): 10k pull-downs on AHOLD, SRESET, WB/WT# (a floating AHOLD floats the address for good; the UMC bridge leaves it open), FPGA weak p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
2026-11-11 plan/next.md: operator decisions (bus features before fab, core to M5, C7 after Quartus, socket 7 later)
2026-11-11 Socket 3 clock: PLL fixed at 38 x CLK (VCO 1266.67 MHz, locks 15.8-34.2 MHz: the FPGAmotherboard's 16.67 MHz Stop Grant step and the 25 MHz jumper; x32 locked only from 18.75 MHz), PHASE 691 ps (7 VC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
2026-11-12 Socket 3: BS8#/BS16# in I/O input registers, PHASE 987 -> 790 ps (full build at 987 ps: BLAST# out -0.139 ns, BS16# in +0.061, RDY# in +0.752; bus-only now +0.218 out / +0.575 in, hold +0.333)
2026-11-12 WBINVD / INVD, benchmark set 3 + power per workload, Socket 3 on C7, L2 snoop read during E_WB
    - Core: WBINVD / INVD (0F 09 / 0F 08; INVD writes back too) through the flush engine at the ROB
    head; s3_bus runs Write-Back + Flush (enhanced WBINVD) or Flush only, FLUSH# acknowledges at
    address 4. Test x7_wbinvd.S (core and s3 passes, +hitm=1 too).
    - L2: the HITM# snoop read takes the data port in E_WB and the victim is read again; the engine
    waiting for a bus that holds every job under HITM# had deadlocked the snoop write-back.
    - Benchmarks (x86_bench.sh set 3): micro groups lat / bw / code / phase / core, application
    profiles (interpreter, objects, compress, sort, hash join, SHA-256, p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
2026-11-12 Benchmark set 3 baseline (geomean IPC 1.096) and power per workload on the C7 build of 4379a20 (1.85-2.65 W)
